Sebastian-Jaimes/EMC_IoT/hardware/3d_models/4. Empaquetado/FormadorDeBolsas/FS/Bagformer.JPG

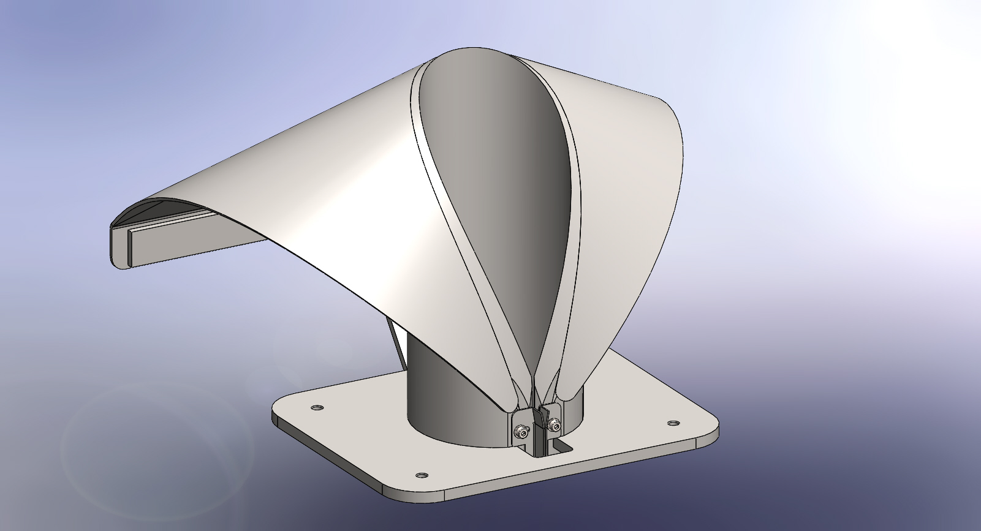
hardware/3d_models/4. Empaquetado/FormadorDeBolsas/FS/Bagformer.JPG
