Sebastian-Jaimes/EMC_IoT/docs/Imágenes/Sellado con calor y faja transportadora.PNG

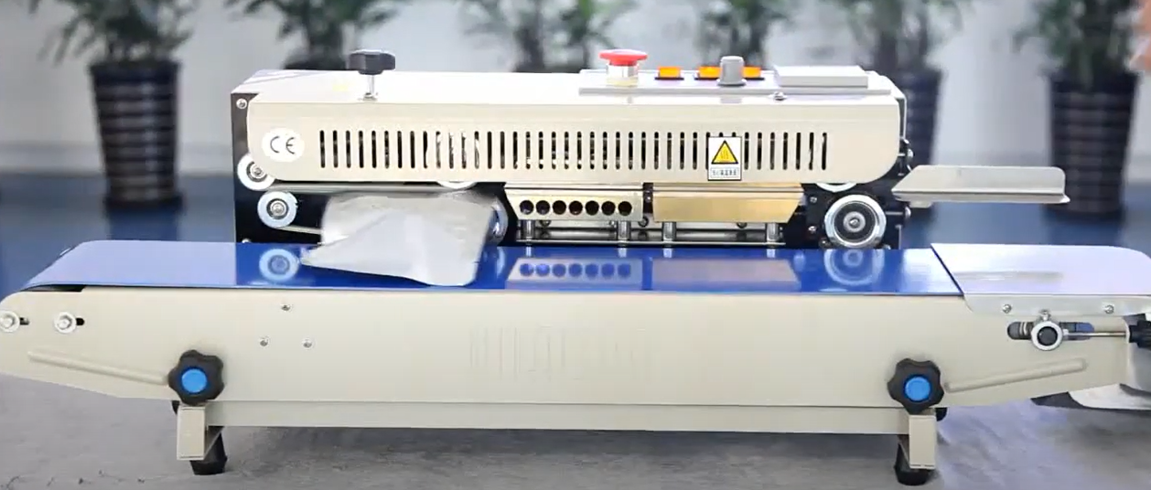
docs/Imágenes/Sellado con calor y faja transportadora.PNG
