Sebastian-Jaimes/EMC_IoT/README.md

# **_EMC_IoT (Empaquetadora de Cafe IoT)_**

## Descripción
**_EMC_IoT_** es un proyecto diseñado para **_Empaquetar granos de café_**. Este repositorio contiene los diseños mecánicos, electrónicos, y el firmware necesario para su construcción y funcionamiento.

## Características
- Caracteristica 1.

## Estructura del proyecto
- **/docs/**: Documentación técnica, manuales y guías.
- **/hardware/**: Modelos 3D y planos mecánicos.
- **/electronics/**: Diseño de PCBs y esquemáticos eléctricos.
- **/firmware/**: Código fuente para microcontroladores (Arduino, ESP32).
- **/software/**: Herramientas adicionales de software.
- **/tests/**: Scripts y archivos para pruebas específicas.

## Requisitos
- Requisito 1.

## Instalación
1. Clonar el repositorio:
    ```bash
    git clone https://github.com/Sebastian-Jaimes/EMC_IoT.git
    ```
2. Acceder a la carpeta del firmware según el componente a desarrollar.
3. Seguir las instrucciones de compilación en el archivo `README.md` de cada subcarpeta.

## Licencia
Este proyecto está licenciado bajo la MIT License - ver el archivo LICENSE para más detalles.

## Contacto
Cualquier consulta sobre el proyecto, puedes contactarme en: sebastian.jaimes.chacon@gmail.com
