Sebastian-Jaimes/EMC_IoT/electronics/README.md

# Electronics

Este directorio contiene los diseños y documentación relacionados con la electrónica para el proyecto **_EMC_IoT_**. Aquí encontrarás esquemas, diagramas de circuito y otros archivos relevantes para la construcción y diseño de la electrónica del proyecto.

## Contenido

- **schematics/**: Esquemas eléctricos del proyecto.
- **pcbs/**: Archivos de diseño de placas de circuito impreso (PCBs).
- **components/**: Lista de componentes y sus especificaciones.
- **docs/**: Documentación adicional sobre el diseño y la implementación de la electrónica.
- **scripts/**: Scripts para la generación de archivos y automatización de tareas relacionadas con la electrónica.
