Sebastian-Jaimes/EMC_IoT/hardware/README.md

# Hardware

## Descripción
En esta carpeta se encuentran los diseños mecánicos del proyecto **_EMC_IoT_**, incluyendo los planos 3D y los ensamblajes.

## Contenido
- **Diseños 3D**: Modelos en formato `.stl` para impresión 3D.
- **Planos**: Dibujos técnicos en formato `.pdf` o `.dwg`.

## Software recomendado
- Para abrir los modelos 3D, usar **Fusion 360** o **FreeCAD**.
- Los archivos STL pueden imprimirse con **Cura** o cualquier software de slicing.
