Sebastian-Jaimes/EMC_IoT/docs/MDM/5. PROYECTO/Metodología del diseño mecatrónico- Grupo/Documento sin título.docx

Eliminación de maleza

Sensor tipo boya

https://naylampmechatronics.com/sensores-liquido/120-sensor-de-nivel-de-liquido-vertical.html

https://articulo.mercadolibre.com.pe/MPE-432848463-sensor-nivel-tipo-boya-interruptor-flotador-medidor-nivel-_JM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

https://articulo.mercadolibre.com.pe/MPE-431528443-sensor-de-nivel-interruptor-flotador-inoxidable-_JM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

Arduino Mega

https://hifisac.com/shop/product/mega-2560r3-arduino-mega-2560-r3-comp-con-arduino-cable-usb-2661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

https://hifisac.com/shop/product/mega2560-pro-arduino-mega-2560-pro-usb-ttl-ch340g-mcu-atmega2560-6772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

https://saisac.pe/producto/arduino-due-con-cable-usb-comp/

Servomotores

https://saisac.pe/producto/servo-motor-s3003-4kg-cm-180-nylon/

https://saisac.pe/producto/servo-motor-mg90s-2-2kg-cm-360-metal/

https://hifisac.com/shop/product/sg-5010-servomotor-sg-5010-5kg-tower-pro-180-grados-standard-2904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

https://hifisac.com/shop/product/sg90-pt-pan-tilt-para-servo-sg90-sin-servomotor-2906?search=servo#attr=

Relé

https://saisac.pe/producto/tpa-3110-2x15w/

https://hifisac.com/shop/product/ssr-75dd-rele-de-estado-solido-75a-de-5-60vdc-4427?search=Rel%C3%A9#attr=

https://hifisac.com/shop/product/ssr-25da-h-rele-de-estado-solido-dc-a-ac-25amperios-480vac-entrada-3-32vdc-4421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

https://hifisac.com/shop/product/rt424024-rele-de-proposito-general-serie-rt2-biestable-sin-enclavamiento-dpdt-24-vdc-8-pines-4408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

https://hifisac.com/shop/product/g2r-2-24vdc-rele-de-24vdc-omron-8pines-doble-contacto-dpdt-4365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

https://hifisac.com/shop/product/g5j-1-tp-rele-de-uso-general-spst-no-normalmente-abierto-bobina-12-vcc-contacto-16a-a-250vac-4367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

https://hifisac.com/shop/product/rt314012-rele-de-12-vdc-bobina-spdt-16a-250vac-8-pines-para-pcb-4406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

https://hifisac.com/shop/product/rt314024-rele-de-24-vdc-bobina-spdt-16a-250vac-8-pines-para-pcb-4407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

https://hifisac.com/shop/product/g2r-1-24vdc-rele-con-bobina-de-24-vdc-10a-250vac-10a-30vdc-omron-5-pin-1-contacto-relay-spdt-4363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

Cámara

https://saisac.pe/producto/modulo-camara-vga-ov7670/

https://saisac.pe/producto/esp-32-camera/

https://naylampmechatronics.com/espressif-esp/700-esp32-cam-con-camara-ov2640-esp32-wifi.html

https://www.gizmojo.com.ar/products/raspberry-pi-camera-module-v1-3

https://hifisac.com/shop/product/rpc-5mp-modulo-camara-5mp-video-1080p-para-raspberry-pi-v1-3-incluye-cable-flat-14cm-2708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

Boquilla pulverizadora

https://www.amazon.com/-/es/Aimela-boquilla-pulverizadora-pulverizador-herramientas/dp/B08S33SZ96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

https://articulo.mercadolibre.com.pe/MPE-443969185-boquilla-de-pulverizacion-4-mm-_JM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

Galonera

https://spanish.alibaba.com/product-detail/40l-80l-120l-plastic-agriculture-pesticides-and-fertilizer-tanks-60451856729.html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

https://articulo.mercadolibre.com.pe/MPE-438991935-galonera-de-plastico-nueva-de-10-galones-40-litros-_JM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

Manguera

Bomba

https://naylampmechatronics.com/motores-dc/260-bomba-de-agua-sumergible-12vdc-3m-240lh.html

https://saisac.pe/producto/bomba-de-agua-12v-rs385/

BOMBA DE AGUA 12V RS385 (https://saisac.pe/producto/bomba-de-agua-12v-rs385/)

https://saisac.pe/producto/minibomba-de-agua-12v/

Bibliografía:

Mungan, C. (2012). “Rolling friction on a wheeled laboratory cart”. Physics Department, US Naval Academy, Annapolis, MD 21402-1363, USA. Recuperado de: https://www.usna.edu/Users/physics/mungan/_files/documents/Publications/PhysEd4.pdf

Partes por completar:

- Variables por controlar → Sebastián y Antony
- Estrategia de control → Sebastián y Antony
- Software Sebastian y Antony
- Selección de controlador → Sebastian y Antony
- Interfaz de usuario → Abigail
- Selección de fuente de energía → Eliane
- Diagrama de Circuitos de potencia → Malena
- Diagramas de circuitos eléctricos y electrónicos para la automatización y control. → Dyango
