Sebastian-Jaimes/EMC_IoT/docs/Tablas/Subsistema de selección - Abigail.docx

### 1.1.1. Subsistema de selección

Este es el primer subsistema que presenta tres alternativas de solución para cada función de los dominios de la estructura de funciones, se toman algunas consideraciones que faciliten el traslado para la etapa de fermentación que se puede observar en las funciones de almacenamiento, así como la relación entre las alternativas de la función de identificación de color y las alternativas de procesar información.

Tabla 10. Matriz morfológica del subsistema de selección.

Fuente: Elaboración propia

| | Función (funciones parciales) | Portadores de funciones (Alternativas de solución)
| | | Alternativa 1 | Alternativa 2 | Alternativa 3

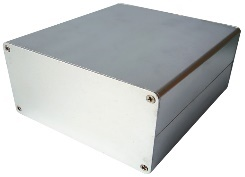
[picture p21: figure]
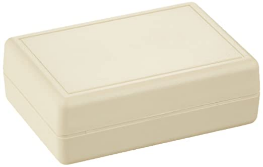
[picture p22: figure]
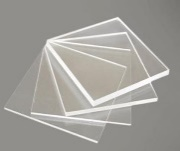
[picture p23: figure]

Dominio mecánico | | Albergar/ soportar/ proteger componentes varios (estructura) | Carcasa metálica | Carcasa de plástico | Carcasa acrílica

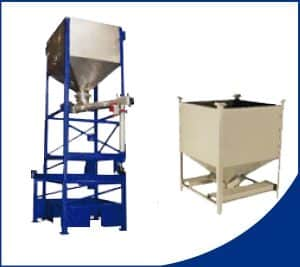
[picture p24: figure]
Tolvas Portátiles y Fijas | EPSA
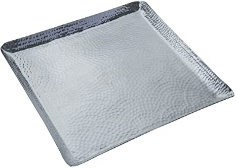
[picture p25: figure]
Amazon.com: Bandeja cuadrada de aluminio martillada de 18.0 x 18.0 x 10.1 in por KINDWER : Hogar y Cocina

| | Almacenar granos de cacao | Tolva | Plataforma transportadora | Bandejas cuadradas

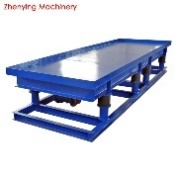
[picture p26: figure]
Mesa Vibradora De Fundición Con Molde De Hormigón De Larga Vida Útil - Buy Fundición De Vibración De Molde De Hormigón De La Mesa De Vibración De Larga Vida De Servicio De
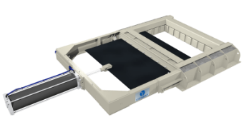
[picture p27: figure]

| | Organizar granos de cacao | Paletas | Bandeja o mesa vibratoria | Tajadera de dosificación

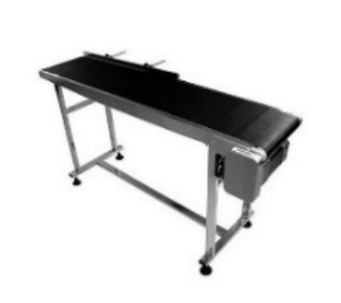
[picture p28: figure]
Fajas Transportadoras | Bandas Transportadoras Perú
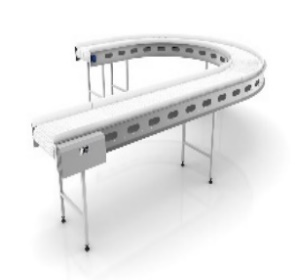
[picture p29: figure]
Abreu - Cinta transportadora - CT-0400
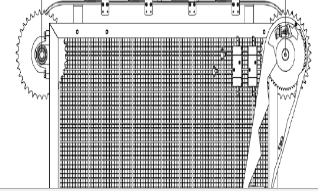
[picture p30: figure]

| | Transportar granos a zona de captura de parámetros | Faja transportadora | Cinta transportadora | Tren de engranajes
| | Transportar granos a zona de selección
| | Transportar granos de cacao a zona de almacenamiento

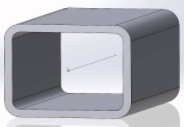
[picture p31: figure]
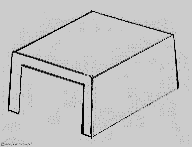
[picture p32: figure]

| | Almacenar granos para captura de parámetros | Cámara de selección | Estructura de plástico en C | Estructura metálica en C

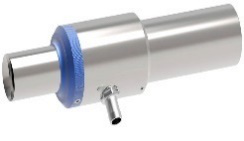
[picture p33: figure]
Eyector de aire - 300 - PIAB - multietapa / compacto / de acero inoxidable

| | Seleccionar granos de cacao | Paletas | Aire a presión (eyector)

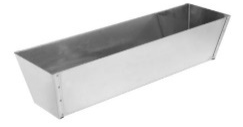
[picture p34: figure]
Recipiente de Acero Inoxidable - Goldblatt
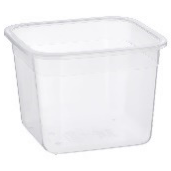
[picture p35: figure]
IKEA 365+ Recipiente, cuadrado/plástico, 1.4 l - IKEA
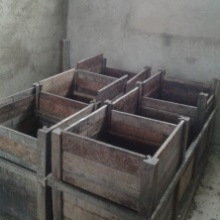
[picture p36: figure]
Cajones de Fermentación para Cacao. | Cocoa chocolate, Cacao, Cocoa

| | Almacenar granos en recipiente | Recipiente de acero | Recipiente de plástico | Cajones de madera

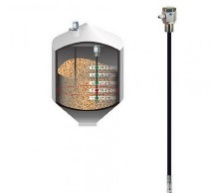
[picture p37: figure]
Sensor de Temperatura multipunto para silos de almacenamiento
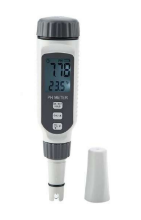
[picture p38: figure]
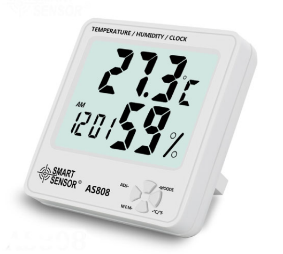
[picture p39: figure]

Dominio de sensores | | Sensar temperatura | Sensor de temperatura resistivo | Sensor inteligente de T ° y H con comunicación automática de información de datos | Sensor de temperatura y humedad digital que trabaja con batería

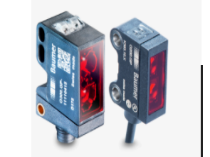
[picture p40: figure]
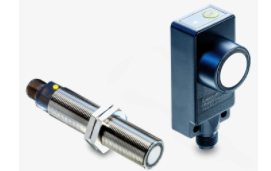
[picture p41: figure]
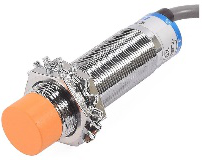
[picture p42: figure]
Sensor de proximidad capacitivo LJC18A3-H-Z/BX (NPN)

| | Detectar granos de cacao | Sensor difuso fotoeléctrico | Sensor ultrasónico | Sensor capacitivo

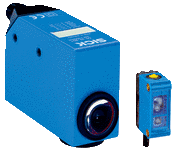
[picture p43: figure]
Sensores de color
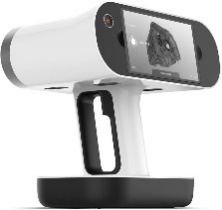
[picture p44: figure]
Escáner 3D inalámbrico | Artec Leo | Las mejores soluciones de escaneo 3D

| | Capturar imágenes de los granos de cacao | Sensor de color | Cámara digital | Escáner de objetos

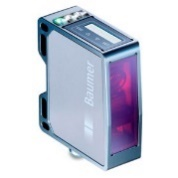
[picture p45: figure]
Sensor de distancia de precisión - Todos los fabricantes industriales - Vídeos

| | Sensar la capacidad del recipiente | Sensor capacitivo | Celda de carga | Sensor de distancia

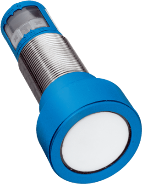
[picture p46: figure]
Sensores Industriales - Sensores de Ultrasonido | Everest Ingeniería

| | Medir flujo de cacao | Sensor infrarrojo réflex | Celda de carga | Sensor de ultrasonido

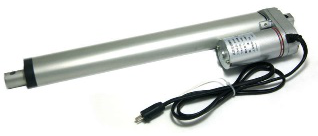
[picture p47: figure]
Actuador Lineal 24VDC 250mm 900N
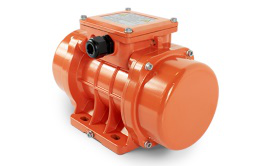
[picture p48: figure]
Gama estándar MVE | OLI Vibrators

Dominio de actuadores | | Accionar organización de granos de cacao | Servomotor | Actuador lineal | Motor vibrador

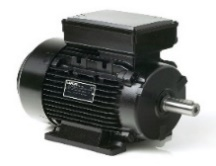
[picture p49: figure]
Motor AC - AMD / AMDE series - Lafert - monofásico / 110 V / con condensador permanente y de arranque
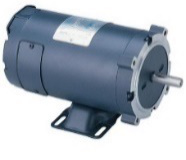
[picture p50: figure]
Motor DC de Corriente Directa, SolarMachine - Todo en Ventilación SA de CV

| | Accionar mecanismo de transporte a zona de captura | Motor AC | Motor DC | Servomotor
| | Accionar mecanismo de transporte a zona de selección | Motor AC | Motor DC | Servomotor

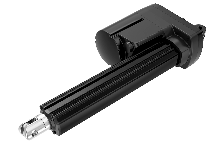
[picture p51: figure]
Qué es un actuador lineal eléctrico y cómo elegirlo? - TiMOTION
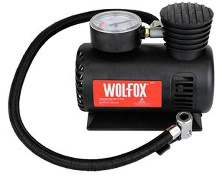
[picture p52: figure]
wolfox mini compresor aire p/autos 300psi silenciosa wf1011

| | Accionar mecanismo de clasificación | Actuador lineal eléctrico | Servomotor | Compresor de aire + electroválvula
| | Accionar mecanismo de transporte a zona de almacenamiento | Motor AC | Motor DC | Servomotor
Dominio de energía | | Acondicionar energía | Fuente lineal | Fuente conmutada

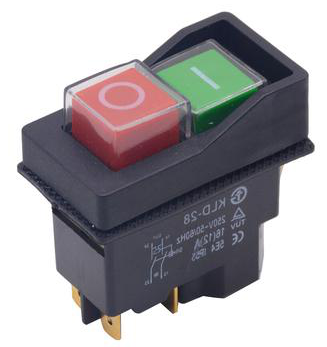
[picture p53: figure]
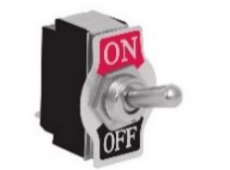
[picture p54: figure]
Interruptor de Palanca 2 Tornillos VOLTECK

| | Encendido del sistema | Botón switch | Interruptor de palanca
| | Energizar actuadores | Fuente lineal | Fuente conmutada

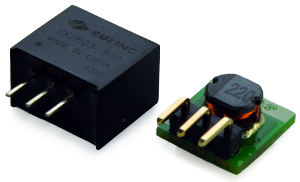
[picture p55: figure]

| | Energizar sensores | Regulador de conmutación | Regulador integrado lineal
| | Energizar controlador | Fuente lineal | Fuente conmutada
| | Energizar interfaz | Fuente lineal | Fuente conmutada

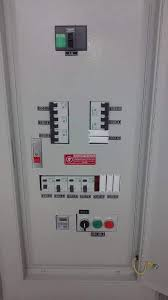
[picture p56: figure]
Tablero para tienda... - Tableros Eléctricos Padilla | Facebook
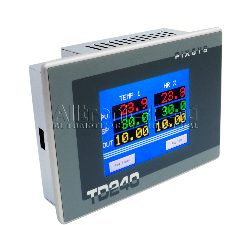
[picture p57: figure]
Panel HMI TD240 - ALLTRONICS PERU

Dominio de interfaz | | Mostrar Alerta de Fallo de Sistema | Tablero eléctrico con botones e indicadores visuales | | Panel HMI
| | Mostrar Indicador de Temperatura
| | Mostrar Indicador de recipiente lleno
| | Ingresar Parámetros

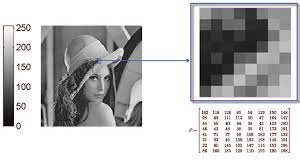
[picture p58: figure]
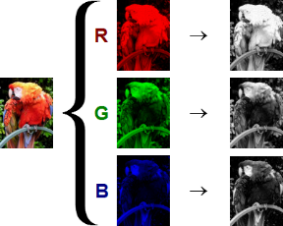
[picture p59: figure]
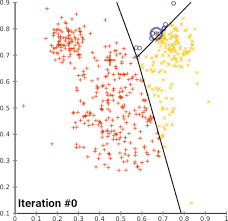
[picture p60: figure]

Dominio de control | | Identificar color | Segmentación | Regresión lineal | | K-means

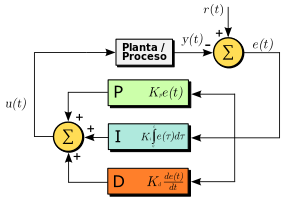
[picture p61: figure]
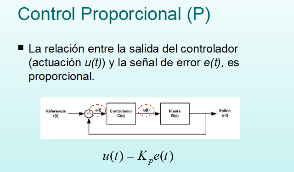
[picture p62: figure]
Control PID y su aplicación en la automatización - Monografias.com

| | Control de velocidad | Control PID | | Control proporcional

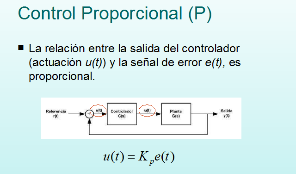
[picture p63: figure]
Control PID y su aplicación en la automatización - Monografias.com

| | Identificar si el recipiente está lleno | Control proporcional

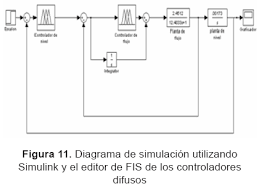
[picture p64: figure]

| | Control de actuador de clasificación | Control difuso | | Control PID

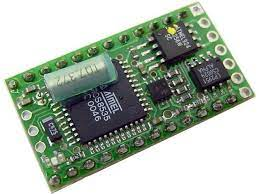
[picture p65: figure]
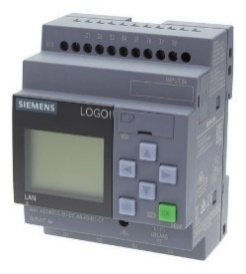
[picture p66: figure]
Plc Siemens Logo 8! Ethernet 12/24rce - Programacion De Plc | Mercado Libre

| | Procesar información | Microcontrolador | | PLC

### 1.1.2. Subsistema de secado

Este es el segundo subsistema que presenta tres alternativas de solución para cada función de los dominios de la estructura de funciones, el principal objetivo es que el secado sea uniforme y rápido por eso se presentan diversas alternativas en la función de almacenar granos en la zona de secado, así como evaluar si estas requieren accionar un movimiento giratorio.

Tabla 11. Matriz morfológica del subsistema de secado.

Fuente: Elaboración propia

| | Función (funciones parciales) | Portadores de funciones (Alternativas de solución)
| | | Alternativa 1 | Alternativa 2 | Alternativa 3
Dominio mecánico | | Albergar/ soportar/ proteger componentes varios (estructura) | Carcasa metálica | Carcasa de plástico | Carcasa acrílica

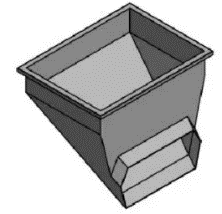
[picture p67: figure]
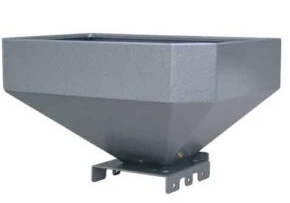
[picture p68: figure]
TOLVA PARA MOLINO DE MALTA AUTOMÁTICO "MICRO" | Cerveza Artesana
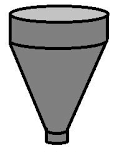
[picture p69: figure]

| | Almacenar/recibir granos de cacao | Tolvas | Contenedor horizontal | Contenedor circular

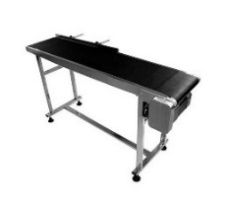
[picture p70: figure]
Fajas Transportadoras | Bandas Transportadoras Perú
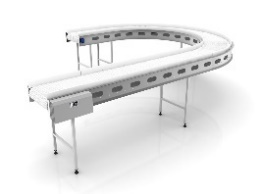
[picture p71: figure]
Abreu - Cinta transportadora - CT-0400
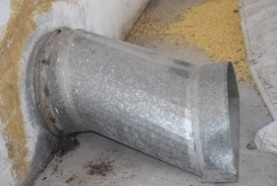
[picture p72: figure]
sistemas de aireacion, conchas de aireacion, ductos de aireacion, secado de granos

| | Transportar granos a zona de secado | Faja transportadora | Cinta transportadora | Tubería o ductos

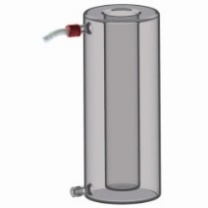
[picture p73: figure]
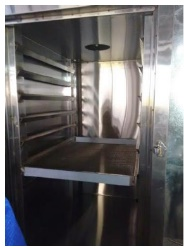
[picture p74: figure]
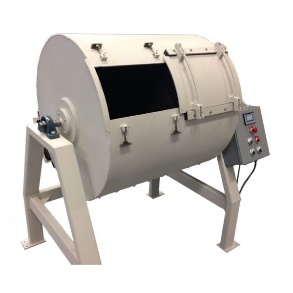
[picture p75: figure]
Tambores giratorios para coque

| | Almacenar granos en zona de secado | Cilindro termostático | Cámara de secado | Tambor rotatorio

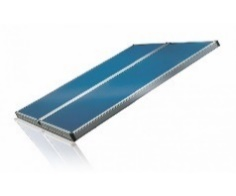
[picture p76: figure]
Captador Solar Chromagen QR-D PRO - Merkasol Energías Renovables
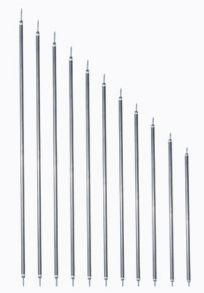
[picture p77: figure]

| | Transmitir calor | Intercambiador de calor y colector solar | Resistencias eléctricas | Quemador GLP

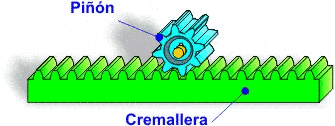
[picture p78: figure]
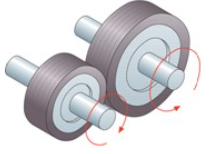
[picture p79: figure]

| | Transmitir movimiento giratorio | Piñón -cremallera | Ruedas de fricción | No trabaja con movimiento giratorio

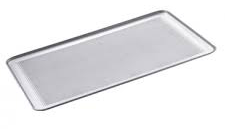
[picture p80: figure]

| | Recibir granos de cacao en la zona de secado | Bandeja plana | Plataforma

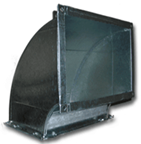
[picture p81: figure]

| | Transportar granos de cacao a zona de dispensa | Faja transportadora | Cinta transportadora | Tubería o ductos

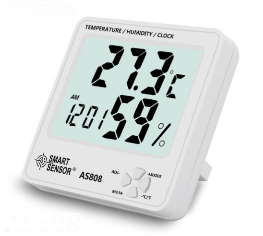
[picture p82: figure]

Dominio de sensores | | Sensar temperatura | Sensor de temperatura resistivo | Sensor inteligente de T ° y H con comunicación automática de información de datos | Sensor de temperatura y humedad digital que trabaja con batería

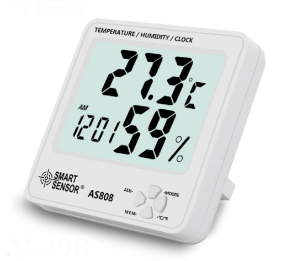
[picture p83: figure]
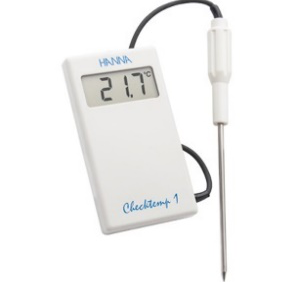
[picture p84: figure]
HANNA Instruments - HI98509 CHECKTEMP 1 Termómetro digital con sonda de acero inoxidable

| | Sensar humedad | Sensor inteligente de T ° y H con comunicación automática de información de datos | Sensor de temperatura y humedad digital que trabaja con batería | Sonda digital
| | Sensar velocidad de giro | Sensor inductivo | Tacómetro láser | | No trabaja con movimiento giratorio
| | Medir flujo de cacao | Sensor infrarrojo réflex | Celda de carga | Sensor de ultrasonido

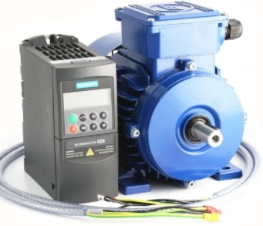
[picture p85: figure]
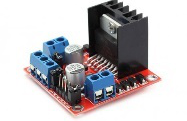
[picture p86: figure]
Driver para Motor DC de Alta Potencia [L298N]
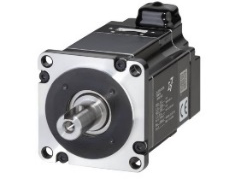
[picture p87: figure]

Dominio de actuadores | | Accionar mecanismo de transporte de cacao | Variador + motor AC | Driver + Motor DC | Servomotor

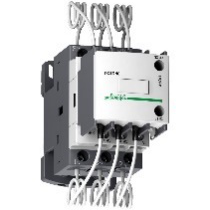
[picture p88: figure]
LC1DFKM7 - Schneider - TeSys – FCM Solutions E.I.R.L. (RUC : 20602949690)
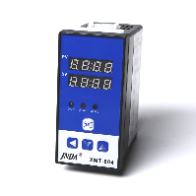
[picture p89: figure]
Xmt-604 Controlador De Temperatura Inteligente,Admite Termopar Y Resistencia Térmica - Buy Los Controladores Digitales De Temperatura,Diferencial De Temperatura Controlador,Tipo K Controlador De Temperatura Product on Alibaba.com

| | Accionar mecanismo de transmisión de calor | contactor + resistencia térmica | Controlador de resistencia térmica
| | Accionar mecanismo de rotación | Variador + motor AC | Driver + Motor DC | No trabaja con movimiento giratorio
| | Accionar mecanismo de transporte a zona de dispensa | Variador + motor AC | Driver + Motor DC | Servomotor

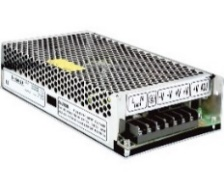
[picture p90: figure]
ELECTRÓNICA MOLGAR

Dominio de energía | | Acondicionar energía | Fuente lineal | Fuente conmutada

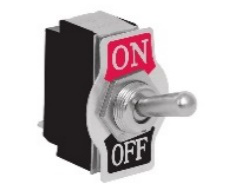
[picture p91: figure]
Interruptor de Palanca 2 Tornillos VOLTECK

| | Encendido del sistema | Botón switch | Interruptor de palanca

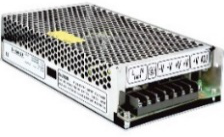
[picture p92: figure]
ELECTRÓNICA MOLGAR

| | Energizar actuadores | Fuente lineal | Fuente conmutada

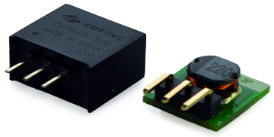
[picture p93: figure]

| | Energizar sensores | Regulador de conmutación | Regulador integrado lineal

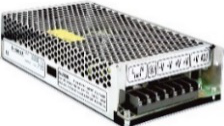
[picture p94: figure]
ELECTRÓNICA MOLGAR

| | Energizar controlador | Fuente lineal | Fuente conmutada

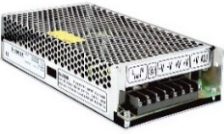
[picture p95: figure]
ELECTRÓNICA MOLGAR

| | Energizar interfaz | Fuente lineal | Fuente conmutada

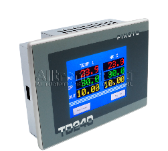
[picture p96: figure]
Panel HMI TD240 - ALLTRONICS PERU

Dominio de interfaz | | Mostrar Alerta de Fallo de Sistema | Tablero eléctrico con botones e indicadores visuales | | Panel HMI
| | Mostrar Indicador de Temperatura
| | Mostrar Indicador de Humedad
| | Ingresar Parámetros
Dominio de control | | Procesar información | Microcontrolador | | PLC
| | Control de humedad | PID | | Difuso
| | Controlar la velocidad de giro
| | Controlar el tiempo para cada variedad
| | Controlar el proceso de secado
