Sebastian-Jaimes/EMC_IoT/docs/Bibliografia/pdfcookie.com_2-calculo-del-tornillo-sin-findocx.pdf

2.- CALCULO PARA DETERMINAR LA CARACTERISTICAS DEL TORNILLO SIN FIN

Ø Paso del tornillo sin fin
El paso del tornillo es t = (0,5-1,0) D, donde D
es el diámetro del tornillo.
Cuanto más ligero sea el material a transportar, tanto mayor se toma el paso.
Consideramos 0.75 D = 0.0381 (paso del tornillo)

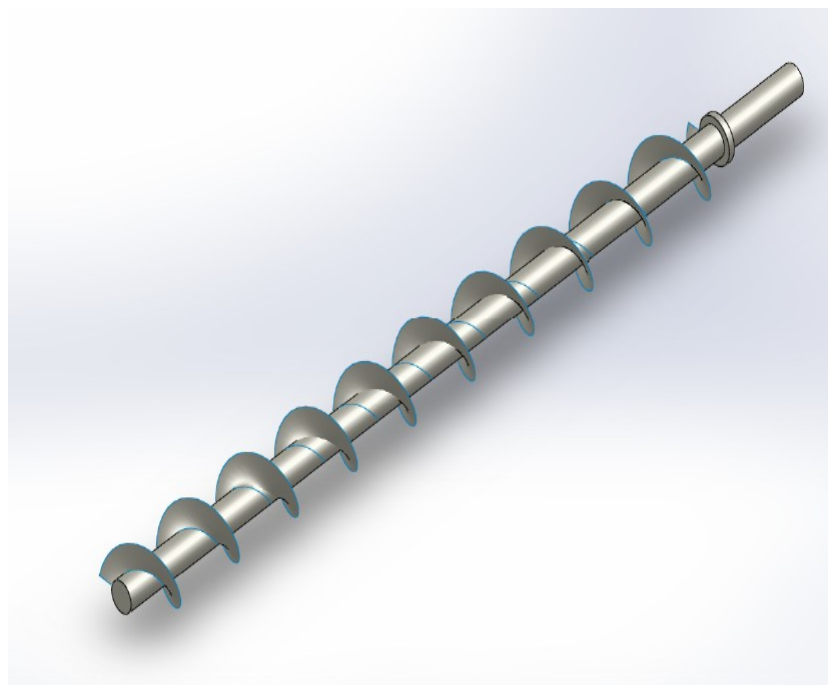
[picture p143: figure]

Ø Diámetro del tornillo sin fin
El diámetro del tornillo D depende
del tamaño de los pedazos de la carga a desplazar. Este diámetro debe ser corno mínimo 12 veces mayor que el tamaño de los pedazos a transportar
del material homogéneo por su grosor
y 4 veces mayor que el grosor máximo de los trozos, al transportar material no clasificado (ordinario).
D = 12* d mm = 72 mm
Donde:
d= es el diámetro del pellet a transportar
d = 6 mm
Ø Calculo de la velocidad del tornillo sin fin

El caudal necesario para el funcionamiento de un caldero 60.05 kg/h, lo que supone, de 0.06005 m

3
/h.
El caudal de transporte se determina mediante la siguiente expresión:

Donde:

φ = coeficiente de llenado. Se considera un valor del coeficiente de llenado de 0,45 propio de materiales que fluyen fácilmente.

Se estima para S un valor igual a 0,75D.

S= 0.75 (0.0635 m) = 0.0476 m

Diámetro del tubo de alimentación = 0.0635 m

Despejando de la ecuación calculamos la velocidad del tornillo sin fin

N = 4 Iv = 4 (0.06005 m3
/h) / 60*0.45*π*(0.0635 m)² *0.0476 m = 14.754 rpm = 15 rpm
60 φ π D² | S

Ø Calculo de la potencia necesario para transportar el pellet

Por otro lado, la potencia necesaria por el transportador el peller se calcula mediante la siguiente expresión:

Donde:

PH = potencia necesaria para el desplazamiento del material. PN = potencia para el accionamiento del tornillo en vacío.
PSt = potencia requerida por la inclinación.

La capacidad de un transportador de tornillo sin-fin está expresada por la fórmula:

IM =67200 kg/m³

* 0.06005 m3
/h = 4035.36 kg / h
Ø Calculo de la potencia necesaria para el dezplazamiento del pellet Datos:
L= 0.6 m
λ=1,9
g = 9.81 m/s

Se elige para la resistencia al desplazamiento de la aceituna un valor de λ=1,9 asimilándola en la tabla a graneles como avena, cebada, arcilla, maíz o patatas.

PH = 4035.36 kg / h * 0.6 m * 1.9 * 9.81 m/s = 0.0125 kw
3600

Ø Calculo de potencia para el accionamiento del tornillo en vacío.

PN = 0.0635 m *0.6 m / 20 = 0.0019 kw

Calculo de PSt = potencia requerida por la inclinación.

La potencia requerida por la inclinación, en kilowatios, es el producto de la capacidad por la altura a salvar y por la aceleración de la gravedad.

Donde:

H = 0.15 m

PST = 4035.36 kg / h * 0.15 * 9.81 / 3600 = 0.00165 kw

Ø La potencia total requerida por el sistema es:

Ptotal = PH + PN + PST = 0.0125 kw + 0.0019 kw + 0.00165 kw = 0.01605 kw = 16.0.5 watts

La potencia requerida para el tornillo sin fin es de 16 watts

Por lo que el motor que se utilizara debera tener una potencia de 16 watt

El Villano Ft Keke Te Pintaron Pajaritos Tema Nuevo 2013 El Villano Ft Keke Te Pintaron Pajaritos Tema Nuevo 2013 DESCARGALO en http://www.CUMBIADEHOY.com/el-villano... (http://www.youtube.com/redirect)
Facebook: https://www.facebook.com/CumbiaDeHoy
Twitter: https://twitter.com/CumbiaDeHoy
