Sebastian-Jaimes/EMC_IoT/docs/MDM/5. PROYECTO/Metodología del diseño mecatrónico- Grupo/Tablas/Dominio de comunicación.xlsx

 |  | Dominio de Control
 |  | S1 | S2 | S3 | S4 | S5 | S6
Dominio de comunicación | Enviar Información | Bluetooth | Wifi | RFID | ZigBee | WiMAX | UWB (Ultra Wide Band)
 | Recibir Información | Cable coaxial |  | Cable de pares |  | Cable de fibra óptica
