Sebastian-Jaimes/EMC_IoT/docs/MDM/5. PROYECTO/Metodología del diseño mecatrónico- Grupo/Tablas/Lista de exigencias.xlsx

Lista de Requerimientos |  |  | Versión 3
Proyecto: | Sistema Automático para el Control de Malezas en el Cultivo de Espárragos |  | Fecha: 21/04/2021
 |  |  | Revisado por:
Cliente: | Pontificia Universidad Católica del Perú |  | Elaborado por: Grupo 4
Fecha (Cambios) | Deseo o Exigencia | Descripción | Responsable
Función Principal
2021-04-21 | E | El sistema debe ser capaz de detectar malezas en cultivos de espárrago con una precisión mayor al 80%. | Sebastian
2021-04-21 | E | El sistema debe aplicar herbicida directamente a toda maleza detectada. | Sebastian
Geometría
2021-04-21 | D | Los rociadores deben ubicarse a una altura exacta por encima de las ruedas. | Sebastian
2021-04-21 | D | El sistema debe contar con ruedas con separación ajustable a la distancia entre filas del arado, las cual varía entre 1 y 1.5 metros. | Sebastian
2021-04-21 | E | El sistema debe tener unas medidas generales de máximo 1.50 m de ancho, 1.60m de altura y 1.60m de largo. (altura del cultivo :[0.4 0.6]m) | Sebastian
Cinemática y fuerzas
2021-04-21 | E | El sistema debe tener una velocidad lineal máxima de alrededor de 0.5 m/s | Sebastian
2021-04-21 | E | El sistema debe ser capaz de soportar la fuerza ejercida debido al peso de la misma, el cual debe ser como mínimo 150 kg y como máximo 300 kg. | Sebastian
Modo de operación
2021-04-21 | E | Aplicación de pesticida de forma automática cuando se detecten plantas de maleza. | Eliane
2021-04-21 | E | Monitoreo de funciones de pulverización y navegación de forma remota por un operador. | Eliane
2021-04-21 | E | Navegación autónoma a través de las hileras de cultivo. | Eliane
Condiciones de operación
2021-04-21 | E | El sistema debe ser capaz de moverse por terreno arenoso (90% arena y 10% otro) para un buen drenaje sin dificultad. | Antony
2021-04-21 | E | El sistema no debe verse afectado por trabajos a temperaturas entre 15° y 31° | Antony
2021-04-21 | E | La altura de trabajo es de 0 msnm. | Antony
Fabricación
2021-04-21 | E | Material: - Como características para la carcasa del diseño, debe tener resistencia a la corrosión y resistencia a las temperaturas extremas y una elevada maquinabilidad. - Como características para el chasis deben ser ligeros, resistentes y de fácil adaptación. - Para el eje de transmisión debe ser un material con alta resistencia para soportar altas potencias. | Abigail
2021-04-21 | D | Las piezas mecánicas necesarias para la implementación deberán ser adquiridas a través del mercado local para evitar costos de importación. | Abigail
Transporte
2021-04-21 | D | Se requerirá de un carro para su transporte antes o después de la operación. | Abigail
Mantenimiento y limpieza
2021-04-21 | D | El mantenimiento preventivo se debe realizar cada 10,000 horas de trabajo. | Antony
2021-04-21 | D | El diseño del robot debe evitar que se acumule suciedad en lugares de difícil acceso. | Antony
Costos y plazos
2021-04-21 | E | Costo de diseño: 4,000 - 6,000 nuevos soles | Antony
2021-04-21 | E | Costo de implementación: 1,000 - 2,000 nuevos soles | Antony
2021-04-21 | E | Costo del equipo: 5,000 - 8,000 nuevos soles | Antony
2021-04-21 |  | Entrega final: 7 de Julio de 2021 | Todos
Comunicaciones
2021-04-21 | D | Protocolos de comunicación entre controlador, actuadores y sensores robustos. | Malena
2021-04-21 | E | Comunicación entre el equipo y el usuario: rango de alrededor de 100 metros. Se enviarán alertas si la máquina terminó de recorrer la parcela o si el camino fue bloqueado por algún obstáculo, cuánta batería le queda y el nivel de pesticida. | Malena
Seguridad
2021-04-21 | E | La máquina estará diseñada para que el riesgo sea mínimo pues esta podrá funcionar autónomamente. | Malena
2021-04-21 | E | La máquina contará con una parada de emergencia en caso de algún riesgo y habrá un aislamiento eléctrico. | Malena
2021-04-21 | D | Se brindará un manual de usuario con el método de uso documentado y explicado de forma entendible. | Malena
Ergonomía
2021-04-21 | E | Se debe cumplir con la Norma Básica de Ergonomía y de Procedimiento de Evaluación de Riesgo Disergonómico (2008). | Malena
2021-04-21 | D | El vehículo deberá ser estético para su comercialización. | Malena
Control
2021-04-21 | E | La máquina debe ser capaz de procesar las señales de entrada de los sensores y enviar señales de salida a los actuadores de forma precisa para poder aplicar el herbicida sin dañar las hortalizas aledañas. | Dyango
2021-04-21 | D | La máquina debe poseer un sistema de control de tipo realimentado. | Dyango
2021-04-21 |  | Variables de control: - Velocidad y posición del vehículo - Flujo del pesticida | Dyango
Energía
2021-04-21 | D | Fuente de alimentación: panel solar y/o baterías de 24V recargables. | Eliane
2021-04-21 | D | Autonomía de 8 h | Eliane
Hardware
2021-04-21 | E | La máquina requiere por lo menos una cámara que registre el entorno en el que se encuentra. | Eliane
2021-04-21 | D | Motor eléctrico. | Eliane
2021-04-21 | E | La máquina requiere un controlador para el procesamiento de señales análogas y digitales. | Eliane
2021-04-21 | E | Sistema integrado de válvulas y boquillas para pulverizacion de precisión. | Eliane
2021-04-21 | E | Sensores LIDAR y ultrasonido para la identificación de entorno. | Eliane
2021-04-21 | E | Sensores de humedad y de nivel. | Eliane
Software
2021-04-21 | E | Implementación del algoritmo para procesamiento de imágenes en tiempo real que se encargue de activar el sistema de rociado únicamente cuando haya maleza, de forma que se evite dañar el cultivo de espárragos. | Dyango
2021-04-21 | E | Interfaz humano - máquina para ingreso de comandos de operación. | Dyango
