Sebastian-Jaimes/EMC_IoT/docs/MDM/5. PROYECTO/Metodología del diseño mecatrónico- Grupo/Tablas/Matriz morfológica.xlsx

Sheet: Dominio mecánico
Dominio Mecánico
Funciones | S1 | S2 | S3 | S4 | S5 | S6
Soportar componentes (chasis) | Estructura metálica (aluminio) |  | Acero |  | Fibra de vidrio
Almacenar granos de café tostado
Transportar granos de café tostado
Separar cada 250 g
Llenar recipiente de bolsas
Cortar y sellar bolsas
Colocar la válvula desgasificadora
Transmitir movimiento | Fajas | Tren de engranajes | Engranaje planetario |  | Cadenas
Desplazamiento del vehículo | Ruedas |  | Oruga |  | Extremidades zoomórficas
Disipar las vibraciones | Amortiguadores | Rocker bogie | Sistema de suspensión |  | Suspensión rígida
Almacenar pesticida | Galonera de plástico |  | Tanque de plástico |  | Tanque metálico
Transportar pesticida | Tubo de plástico |  |  | Manguera de plástico
Rociar Pesticida | Rociadores |  |  | Aspersores
Dirigir vehículo | Sistema Ackerman |  | Explicit Steering Configuration | Skid Steering Configuration | Movimiento de extremidades

Sheet: Dominio de actuadores
Dominio de actuadores
Funciones | S1 | S2 | S3
Accionar mecanismo de movimiento | Motor DC |  | Consola Android
Accionar mecanismo de llenado
Accionar mecanismo de sellado
Accionar mecanismo de colocado de válvula
Accionar indicador de fin de recorrido | Led | Tablet
Accionar mecanismo de roceado | Relay y electroválvula | Bomba

Sheet: Dominio de sensores
Dominio de sensores
Funciones | S1 | S2 | S3 | S4 | S5 | S6
Detectar la separación de 250 g
Detectar nuevo producto terminado
Detectar obstáculos | Sensores de ultrasonido | Sensores infrarrojos | Lidar 3D | Cámara de profundidad | Sensor capacitivo
Detectar maleza y cultivo | Cámara web | Cámara infrarroja | Ultrasonido | Radar
Detectar ubicación | GPS | IMU | Acelerómetro y giroscopio | Wi-Fi | Sensor de brújula
Detectar nivel del tanque de pesticida | Ultrasonido | Nivel hidrostático | Sensor capacitivo | Boya | Radar | Vibración
Detectar la velocidad del robot | Encoder | Acelerómetro | Tacómetro | Sensor de imán permanente | Sensor de guaya

Sheet: Dominio de energía
Dominio de energía
Funciones | S1 | S2 | S3 | S4 | S5 | S6
Acondicionar energía | Fuente lineal |  |  | Fuente switching
Encender el sistema | Interruptor simple |  |  | Botón de arranque
Energizar actuadores | Reguladores de conmutación
Energizar sensores | Regulador integrado lineal |  |  | Regulador de conmutación
Energizar interfaz | Regulador de conmutación |  |  | Regulador integrado lineal
Energizar controlador | Regulador de conmutación

Sheet: Dominio de control
Dominio de Control
Funciones |  | S1 | S2 | S3 | S4 | S5 | S6
 | Verificar que los pesos sean de 250 g
 | Controlar el Llenado
 | Controlar el Sellado
 | Determinar colocación de la válvula
 | Controlar el Conteo en tiempo real
Hardware | Identificación de malezas, espárrago y surcos | Raspberry Pi | Nano Pc T3 Plus | Nvidia Jetson Xavier | Asus thinker Board S | Odriod- XU4 | Banana Pi M3
 | Control de Posición | Microcontrolador |  | FPGA |  | Procesadores
 | Control de Roceado
Software | Identificación de malezas, espárrago y surcos | Procesamiento de Imágenes |  | Visión por Computadora |  | Redes Neuronales Convolucionales
 | Control de Posición | Control PID Lineal | Control PID No lineal | Algoritmo Regulador | Deep Learning | Control Vectorial | Lógica Difuso
 | Control de Roceado

Sheet: Dominio de comunicación
Dominio de comunicación
Funciones | S1 | S2 | S3 | S4 | S5 | S6
Enviar Información | Bluetooth | Wifi | RFID | ZigBee | WiMAX | UWB (Ultra Wide Band)
Recibir Información | Cable coaxial |  | Cable de pares |  | Cable de fibra óptica

Sheet: Dominio de interfaz
Dominio de interfaz
Funciones | S1 | S2 | S3 | S4 | S5 | S6
Mostrar Alerta de Fallo de Sistema | Aplicación de celular |  | Aplicación para PC |  | Aplicación en tablet
Mostrar Cantidad de Paquetes Listos por Día
Mostrar Cantidad de Paquetes Listos en el Día Actual en Tiempo Real
Mostrar Posición del Vehículo en el Plano | Aplicación de celular |  | Aplicación para PC |  | Aplicación en tablet
Mostrar Indicador de Obstáculo | Aplicación de celular |  | Aplicación para PC |  | Aplicación en tablet
Mostrar Estado de Nivel de Batería | Aplicación de celular |  | Aplicación para PC |  | Aplicación en tablet
Mostrar Nivel de Pesticida | Aplicación de celular |  | Aplicación para PC |  | Aplicación en tablet
