Sebastian-Jaimes/EMC_IoT/docs/README.md

# Docs

Este directorio contiene la documentación relacionada con el proyecto **_EMC_IoT_**. Aquí encontrarás guías, especificaciones, y otros documentos importantes que te ayudarán a entender y trabajar con el proyecto.

## Contenido

- **user_manual/**: Manuales de usuario y guías de instalación.
- **technical_docs/**: Documentación técnica sobre el diseño y funcionamiento del sistema.
- **api_docs/**: Documentación de las APIs utilizadas en el proyecto.
- **design_docs/**: Documentación sobre el diseño del sistema, incluyendo diagramas y explicaciones detalladas.
- **troubleshooting/**: Guías para resolver problemas comunes y FAQ.

## Acceso a la Documentación

1. **Manual de Usuario:**

   Encuentra guías y manuales para el uso del sistema en la carpeta `user_manual/`.

2. **Documentación Técnica:**

   Consulta los detalles técnicos y las especificaciones del sistema en la carpeta `technical_docs/`.

3. **Documentación de API:**

   Revisa la documentación de las APIs y cómo interactuar con ellas en la carpeta `api_docs/`.

4. **Documentación de Diseño:**

   Explora los documentos de diseño y diagramas en la carpeta `design_docs/`.

5. **Resolución de Problemas:**

   Encuentra soluciones a problemas comunes y respuestas a preguntas frecuentes en la carpeta `troubleshooting/`.

## Estructura de los Documentos

- **user_manual/**: Archivos con guías de usuario en formato PDF, DOCX o Markdown.
- **technical_docs/**: Documentos técnicos como especificaciones, notas de aplicación y análisis de diseño.
- **api_docs/**: Documentación de las APIs, generalmente en formato Markdown o HTML.
- **design_docs/**: Documentos de diseño, incluyendo diagramas y descripciones detalladas.
- **troubleshooting/**: Documentos con soluciones a problemas comunes y FAQ.
