Sebastian-Jaimes/EMC_IoT/firmware/README.md

# Firmware

Este directorio contiene el firmware para el proyecto **_EMC_IoT_**. El firmware se encarga de controlar y gestionar el funcionamiento del proyecto.

## Contenido

- **src/**: Código fuente del firmware.
- **include/**: Archivos de encabezado.
- **lib/**: Bibliotecas externas utilizadas en el proyecto.
- **docs/**: Documentación adicional sobre el firmware.
- **examples/**: Ejemplos de uso y configuración.
- **Makefile**: Archivo de configuración para la compilación del firmware.
