Sebastian-Jaimes/EMC_IoT/software/README.md

# Software

Este directorio contiene el software necesario para el proyecto **_EMC_IoT_**. Aquí encontrarás el código y las herramientas para interactuar y controlar el proyecto desde un entorno de software.

## Contenido

- **src/**: Código fuente del software.
- **scripts/**: Scripts y utilidades auxiliares.
- **docs/**: Documentación adicional sobre el software.
- **examples/**: Ejemplos y configuraciones de uso.
