Sebastian-Jaimes/EMC_IoT/docs/MDM/5. PROYECTO/Metodología del diseño mecatrónico- Grupo/Sistema automatizado para rehabilitación de rodilla en adultos.docx

Solución:

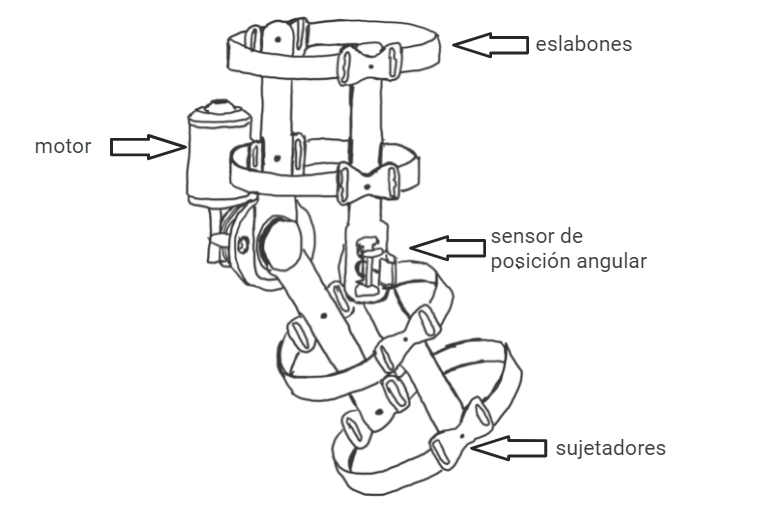
[picture p144: figure]
