Sebastian-Jaimes/EMC_IoT/docs/Bibliografia/Citado- Bibliografía . lleno.docx

Página Web:

Autor, A. (Fecha). Título. https://www.páginaweb.com/XXX

Revista:

Autor, A., Autor, B., & Autor, C. (Año). Título del artículo. Título de la Revista, volumen(número), páginas del artículo. http://www.ejemplo.abc

8(2), 34-48.

Periódico en línea:

Autor, A. (Fecha). Título del artículo. Título del periódico. http://www.ejemplo.abc

Tesis o trabajos de investigación

Autor, A. (Año). Título de la tesis [Tipo de tesis para optar un grado o título inédita]. Nombre de la institución que otorga el título.

LINK PARA CITADO: https://up-pe.libguides.com/c.php?g=1043492&p=7613287

Perfect Daily Grind (29 de julio de 2021). Caficultor: Cómo elegir el empaque para vender tu café tostado. Perfect Daily Grind. https://perfectdailygrind.com/es/2021/07/29/caficultor-como-elegir-el-empaque-para-vender-tu-cafe-tostado/

MIDAGRI. (s/f). Cafés especiales en el Perú. https://www.midagri.gob.pe/portal/24-sector-agrario/cafe/204-cafesespeciales-en-el-peru

Cámara Peruana del Café y Cacao (s/f). Café en el Perú. https://camcafeperu.com.pe/ES/cafe-peru.php

Weather Spark (2016). El clima y el tiempo promedio en todo el año en Junín. https://es.weatherspark.com/y/22304/Clima-promedio-en-Jun%C3%ADn-Per%C3%BA-durante-todo-el-a%C3%B1o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,m%C3%A1s%20de%2016%20%C2%B0C

Cámara Peruana del Café y Cacao (7 de octubre de 2021). La tecnología en el procesamiento de los cafés de especialidad. https://camcafeperu.com.pe/ES/articulo.php?id=132

Choperena, É. (23 de junio de 2020). El Empaque del Café, ¿Beneficia o Altera el Resultado de Nuestra Bebida? https://www.animalgourmet.com/2020/06/23/empaque-del-cafe-diferencias-beneficios/

QUIMINET (6 de mayo 2011). La importancia del envasado del café. https://www.quiminet.com/articulos/la-importancia-del-envasado-del-cafe-56041.htm
