Sebastian-Jaimes/EMC_IoT/docs/Elaboracion de tesis/CARÁTULA-Tesis-.docx

PONTIFICIA‌ ‌UNIVERSIDAD‌ ‌
CATÓLICA‌ ‌DEL‌ ‌PERÚ

FACULTAD DE CIENCIAS SOCIALES

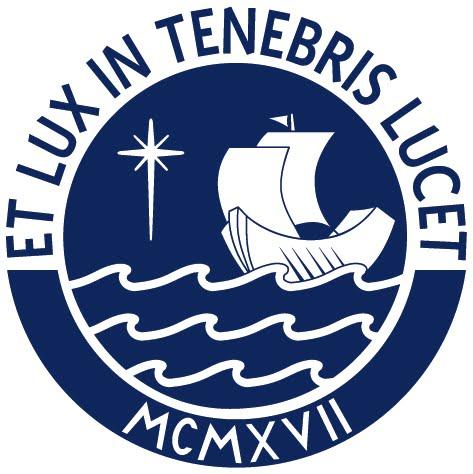
[picture p145: figure]

‌

Título completo de la tesis

Tesis para obtener el título profesional de Licenciado en xxx presentado por:

Apellidos, Nombres del autor

‌ ‌

Asesor(es):

Apellidos, Nombres del asesor 1

Apellidos, Nombres del asesor 2

Lima, Año
