Sebastian-Jaimes/EMC_IoT/electronics/Diagrama de potencia.pdf

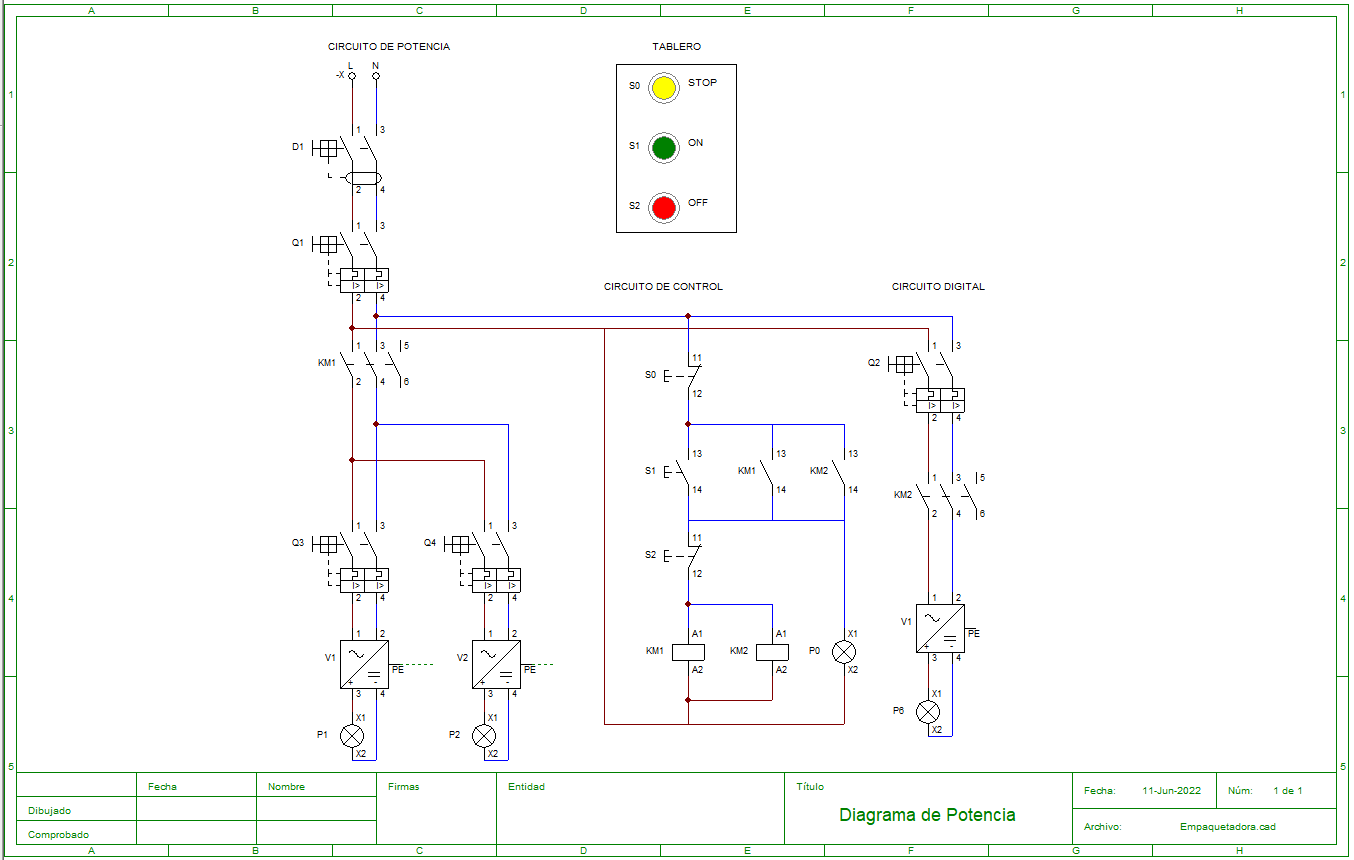
[picture p146: page 1]
