Sebastian-Jaimes/EMC_IoT/docs/MDM/5. PROYECTO/Metodología del diseño mecatrónico- Grupo/INFORME_INTEGRAL/Carcasa.pdf

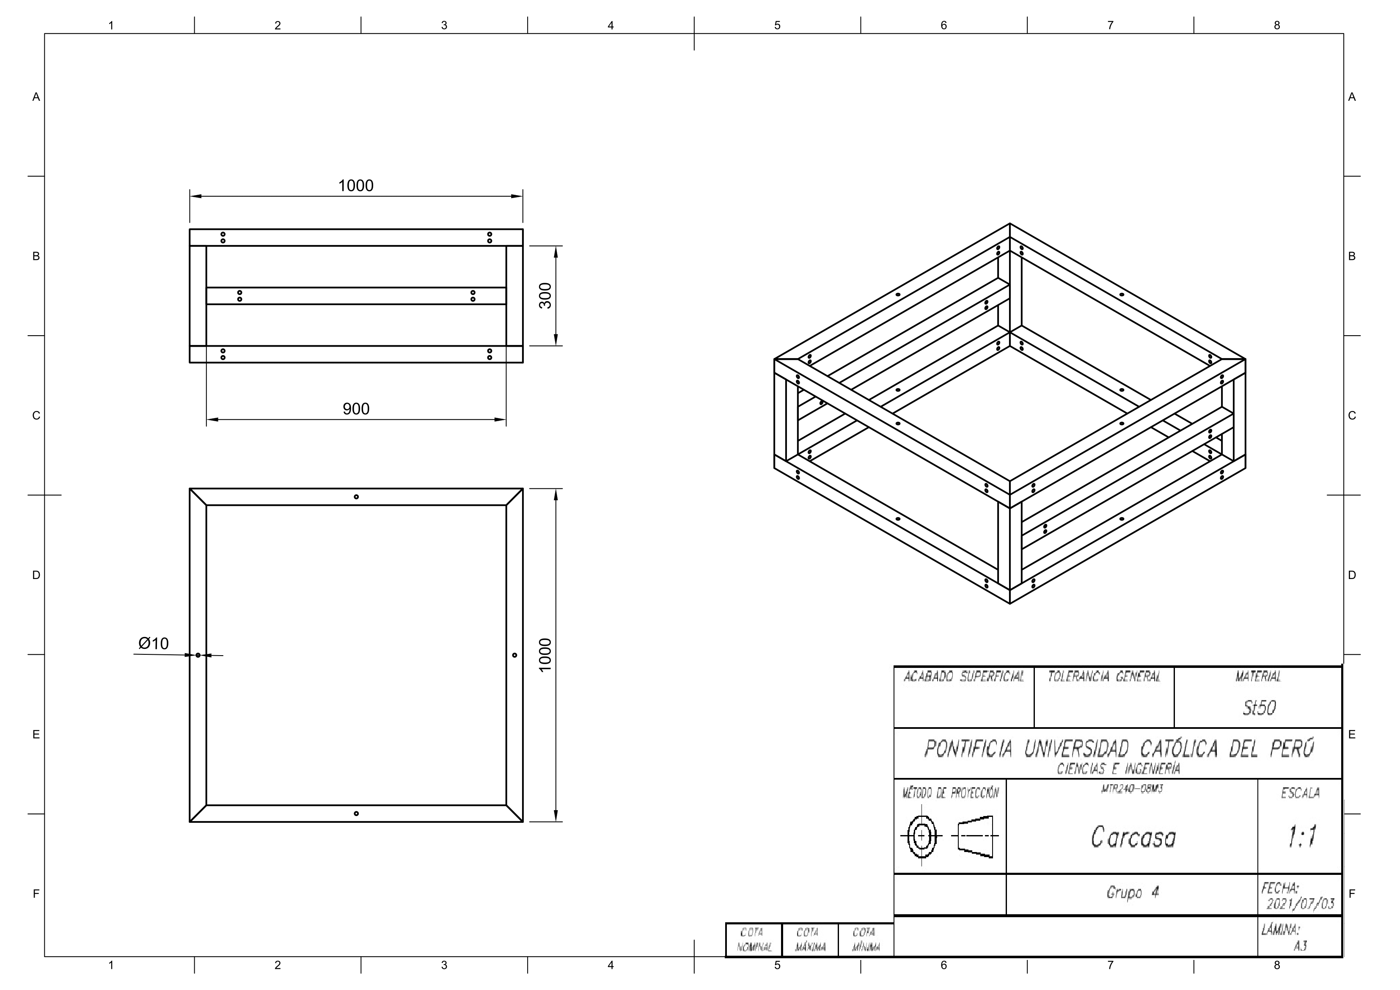
[picture p160: page 1]
