Sebastian-Jaimes/EMC_IoT/docs/Elaboracion de tesis/ComunicadoSustentacionDeUnaTesis.PDF

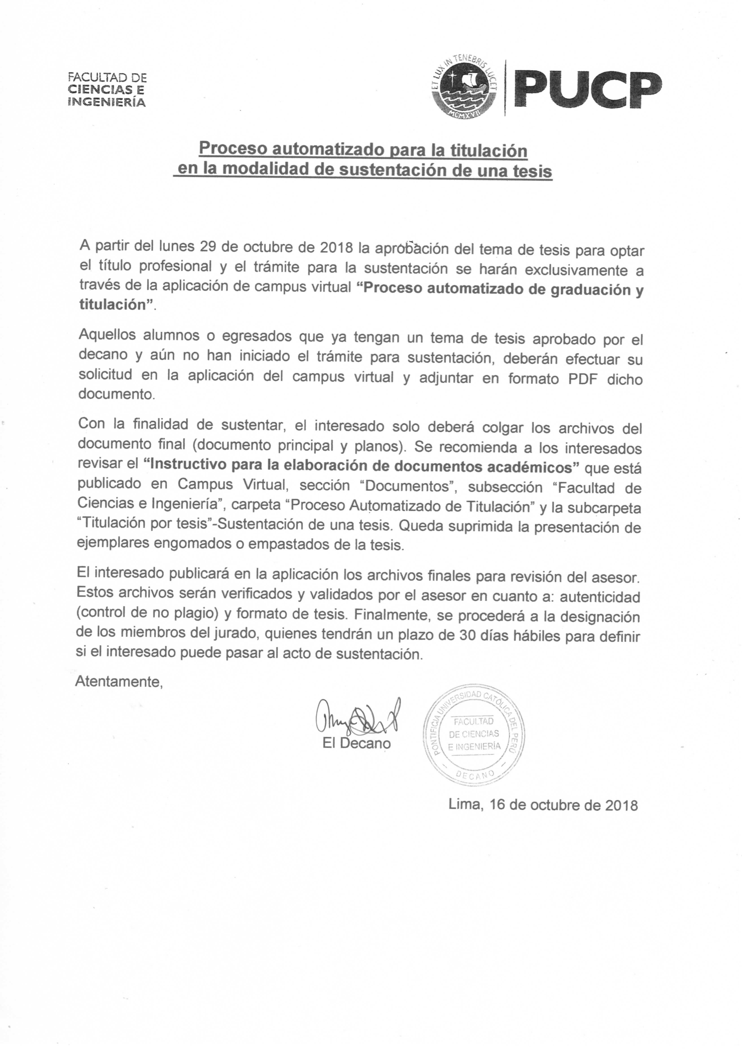
[picture p186: page 1]
