Sebastian-Jaimes/EMC_IoT/docs/MDM/5. PROYECTO/Metodología del diseño mecatrónico- Grupo/Tablas/Copy of Evaluación técnica-economica 2021-1.xlsx

Evaluación técnica
Criterio técnico | (0-4) | Sol 1 |  | Sol 2 |  | Sol 3 |  | Sol 4 |  | Sol 5 |  | Sol 6 |  | Sol Ideal
 | g | p | gp | p | gp | p | gp | p | gp | p | gp | p | gp | p | gp
Precisión en la aplicación del pesticida | 4 | 3 | 12 | 3 | 12 | 3 | 12 | 2 | 8 | 3 | 12 | 2 | 8 | 4 | 16
Autonomía | 4 | 3 | 12 | 3 | 12 | 3 | 12 | 3 | 12 | 2 | 8 | 1 | 4 | 4 | 16
Robustez | 3 | 2 | 6 | 2 | 6 | 2 | 6 | 1 | 3 | 1 | 3 | 3 | 9 | 4 | 12
Facilidad de uso (configuración) | 3 | 1 | 3 | 2 | 6 | 2 | 6 | 2 | 6 | 3 | 9 | 2 | 6 | 4 | 12
Rango de transmisión de datos | 3 | 3 | 9 | 3 | 9 | 3 | 9 | 2 | 6 | 3 | 9 | 3 | 9 | 4 | 12
Facilidad de mantenimiento | 2 | 2 | 4 | 3 | 6 | 2 | 4 | 3 | 6 | 2 | 4 | 2 | 4 | 4 | 8
Eficiencia en detección de maleza y cultivo | 4 | 3 | 12 | 3 | 12 | 3 | 12 | 2 | 8 | 3 | 12 | 2 | 8 | 4 | 16
Sumatoria |  |  | 46 |  | 51 |  | 49 |  | 41 |  | 45 |  | 40 |  | 76
xi |  |  | 0.605 |  | 0.671 |  | 0.6447368421 |  | 0.539 |  | 0.5921052632 |  | 0.526 |  | 1
 |  |  |  |  |  |  |  |  |  |  |  |  |  |  |  | CRITERIOS PARA LA SOLUCIÓN: | ALTERNATIVAS
 |  |  |  |  |  |  |  |  |  |  |  |  |  |  |  | 1.Desestimación de las soluciones con valor técnico/económico menor a 0.6
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
