Sebastian-Jaimes/EMC_IoT/docs/MDM/5. PROYECTO/Metodología del diseño mecatrónico- Grupo/Tablas/Cronograma de trabajo.xlsx

Actividad |  |  |  |  |  |  |  |  |  |  |  |  |  |  |  |  | TIEMPO (horas)
 |  | Semana 1 | Semana 2 | Semana 3 | Semana 4 | Semana 5 | Semana 6 | Semana 7 | Semana 8 | Semana 9 | Semana 10 | Semana 11 | Semana 12 | Semana 13 | Semana 14 | Semana 15
1 | Definición de problemática |  |  |  |  |  |  |  |  |  |  |  |  |  |  |  | 4
2 | Estado del arte |  |  |  |  |  |  |  |  |  |  |  |  |  |  |  | 8
3 | Lista de exigencias |  |  |  |  |  |  |  |  |  |  |  |  |  |  |  | 8
4 | Estructura de funciones |  |  |  |  |  |  |  |  |  |  |  |  |  |  |  | 12
5 | Matriz morfológica |  |  |  |  |  |  |  |  |  |  |  |  |  |  |  | 12
6 | Definición de concepto de solución |  |  |  |  |  |  |  |  |  |  |  |  |  |  |  | 8
7 | Evaluación técnica-económica |  |  |  |  |  |  |  |  |  |  |  |  |  |  |  | 6
8 | Proyectos preliminar óptimo |  |  |  |  |  |  |  |  |  |  |  |  |  |  |  | 14
9 | Memoria de calculos aprox |  |  |  |  |  |  |  |  |  |  |  |  |  |  |  | 8
10 | Concepto de solución óptimo(3D) |  |  |  |  |  |  |  |  |  |  |  |  |  |  |  | 8
11 | Proyecto preliminar |  |  |  |  |  |  |  |  |  |  |  |  |  |  |  | 8
12 | Modelo 3D detallado/Circuitos eléctricos y electrónicos |  |  |  |  |  |  |  |  |  |  |  |  |  |  |  | 10
13 | Explicación del proyecto definitivo |  |  |  |  |  |  |  |  |  |  |  |  |  |  |  | 8
14 | Maqueta/prototipo/simulación |  |  |  |  |  |  |  |  |  |  |  |  |  |  |  | 12
15 | Planos de ensamble/planos eléctricos/planos electrónicos |  |  |  |  |  |  |  |  |  |  |  |  |  |  |  | 10
16 | Sustentación final |  |  |  |  |  |  |  |  |  |  |  |  |  |  |  | 10
 |  |  |  |  |  |  |  |  |  |  |  |  |  | TOTAL |  |  | 146
