Sebastian-Jaimes/EMC_IoT/docs/Diagramas/Diagrama de bloques de empaquetadora de café/Diagrama de bloques.png

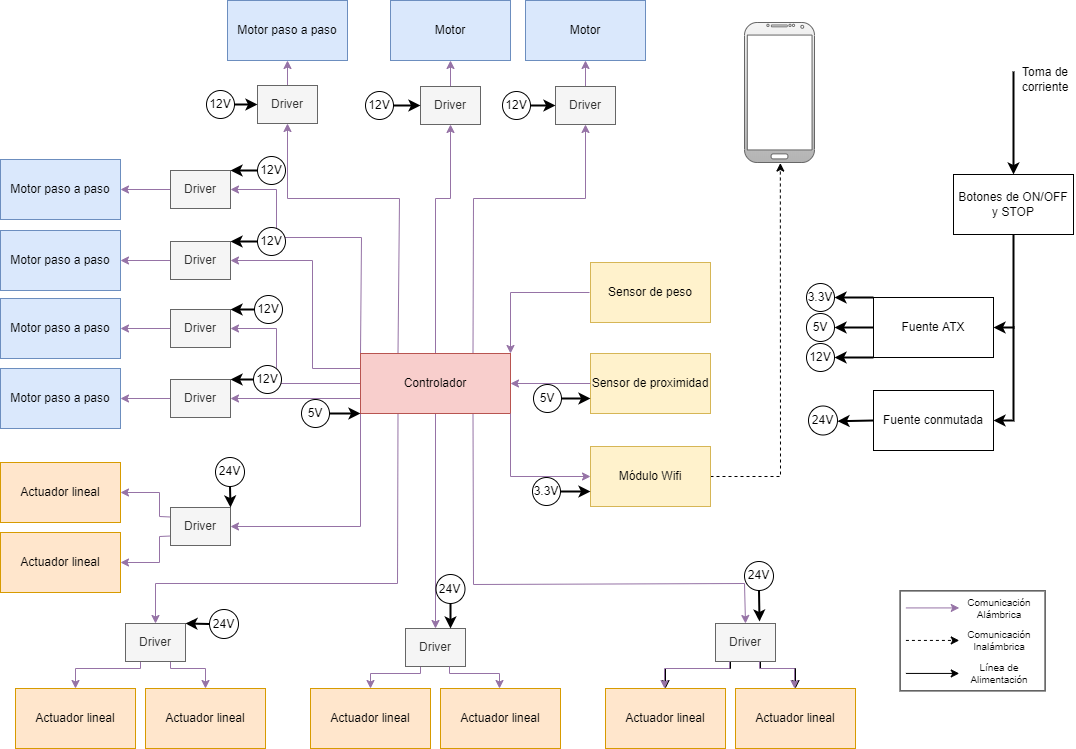
docs/Diagramas/Diagrama de bloques de empaquetadora de café/Diagrama de bloques.png
