Sebastian-Jaimes/EMC_IoT/docs/Diagramas/Diagrama de flujo de control/Contabilizar paquetes.png

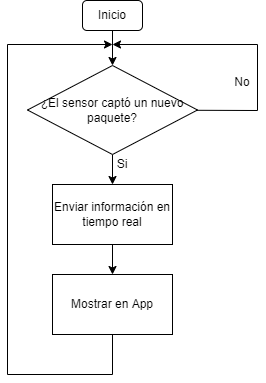
docs/Diagramas/Diagrama de flujo de control/Contabilizar paquetes.png
