Sebastian-Jaimes/EMC_IoT/docs/Diagramas/Diagrama de flujo de control/Diagrama de flujo.png

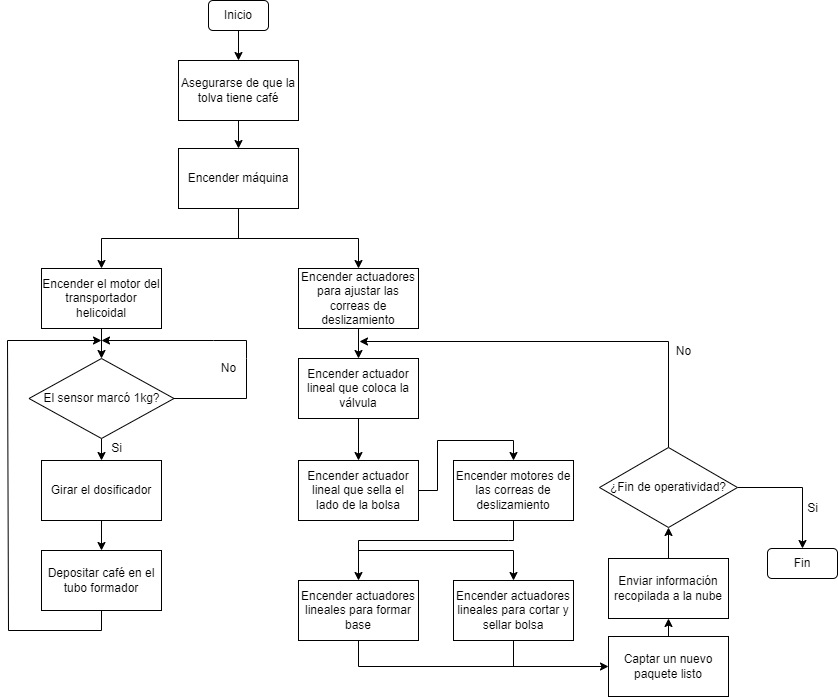
docs/Diagramas/Diagrama de flujo de control/Diagrama de flujo.png
