Sebastian-Jaimes/EMC_IoT/docs/Diagramas/Diagrama de flujo de control/Diagrama de flujo_2.png

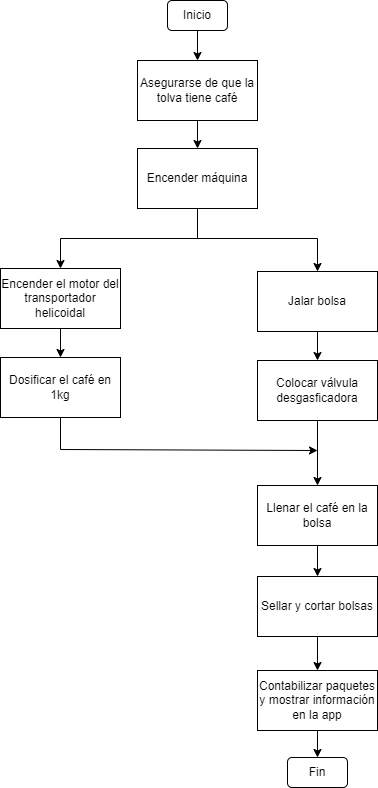
docs/Diagramas/Diagrama de flujo de control/Diagrama de flujo_2.png
