Sebastian-Jaimes/EMC_IoT/docs/Diagramas/Diagrama de flujo de control/Dosificación de café.png

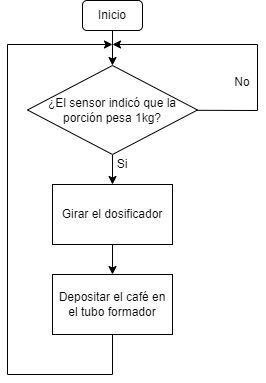
docs/Diagramas/Diagrama de flujo de control/Dosificación de café.png
