Sebastian-Jaimes/EMC_IoT/docs/Diagramas/Estructura de Funciones/Empaquetadora.png

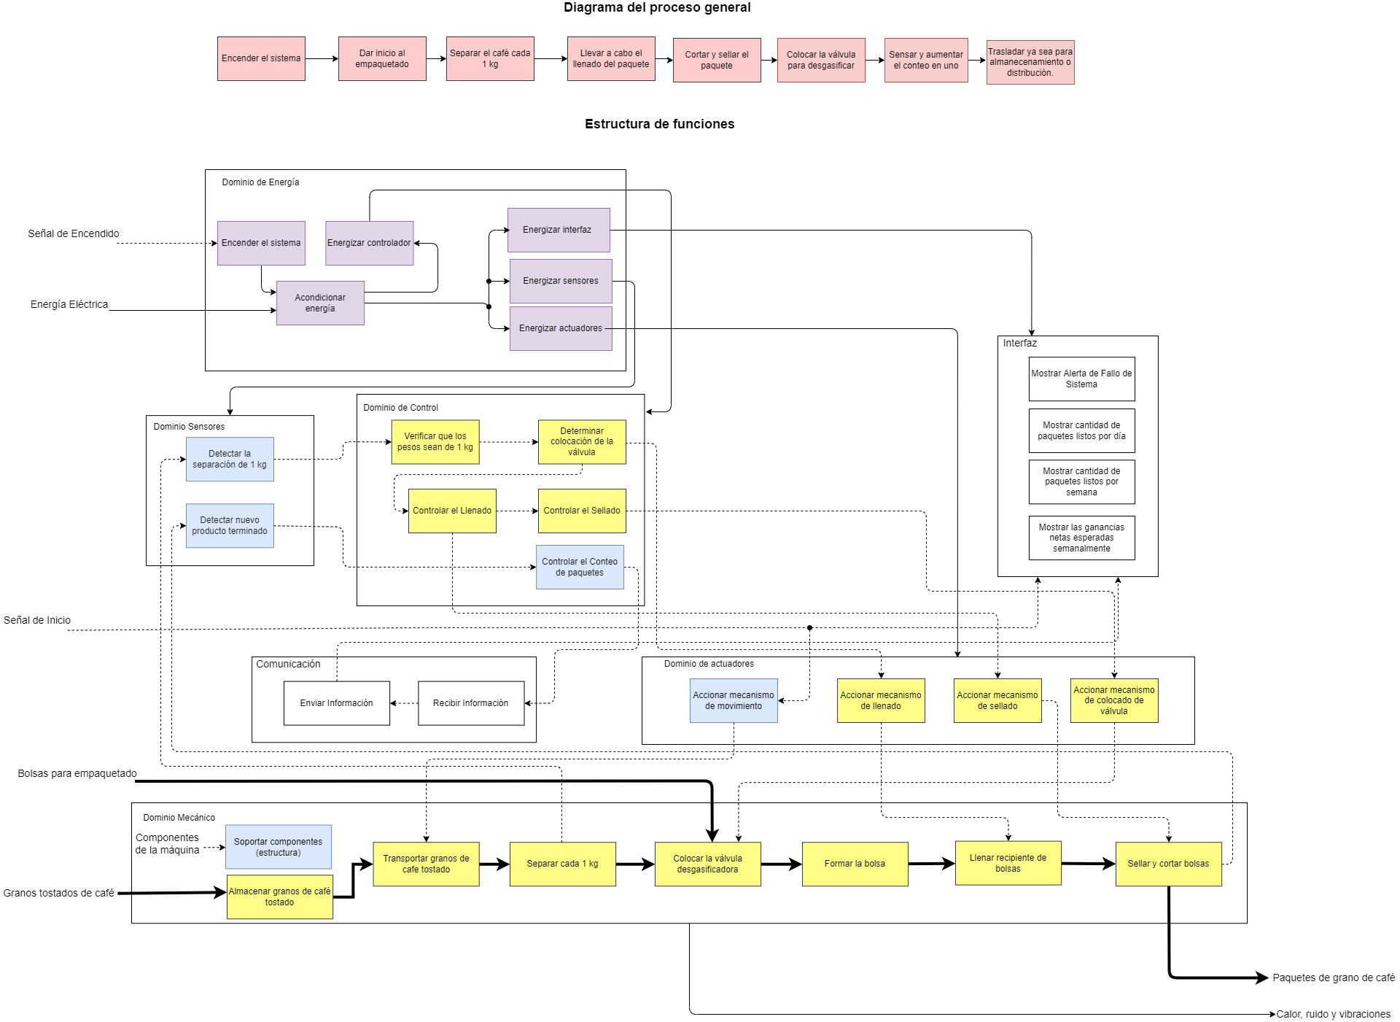
docs/Diagramas/Estructura de Funciones/Empaquetadora.png
