Sebastian-Jaimes/EMC_IoT/docs/Imágenes/9.PNG

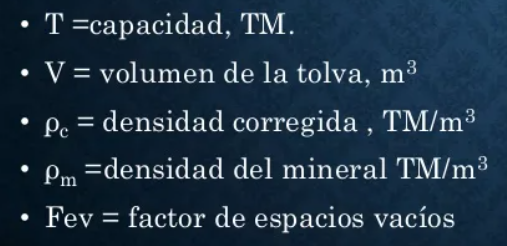
docs/Imágenes/9.PNG
