Sebastian-Jaimes/EMC_IoT/docs/Imágenes/10.PNG

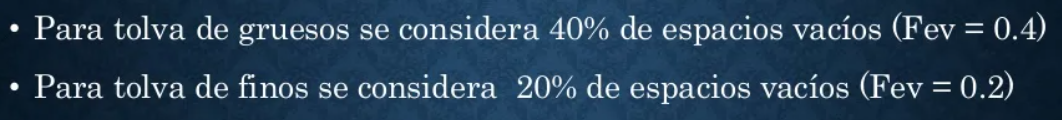
docs/Imágenes/10.PNG
