Sebastian-Jaimes/EMC_IoT/docs/Imágenes/11.PNG

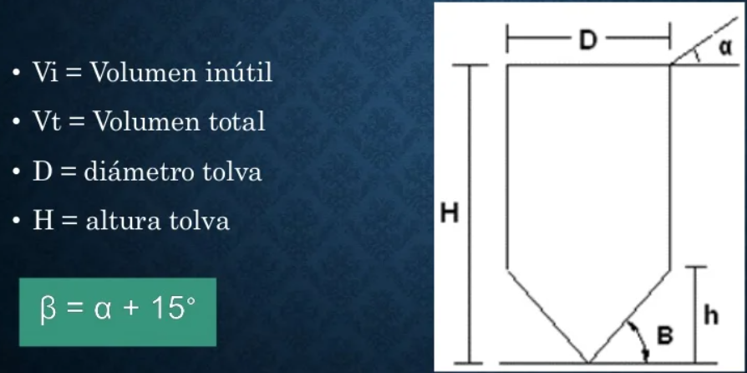
docs/Imágenes/11.PNG
