Sebastian-Jaimes/EMC_IoT/docs/Imágenes/44-0.jpg

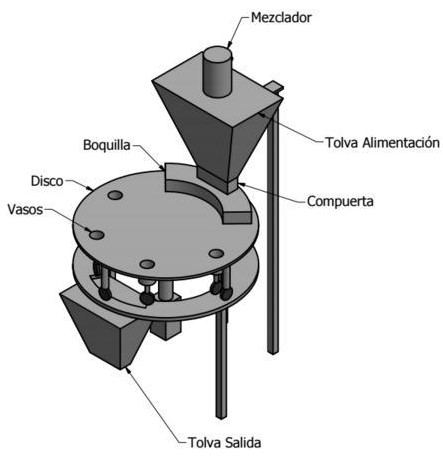
docs/Imágenes/44-0.jpg
