Sebastian-Jaimes/EMC_IoT/docs/Imágenes/Captura0.PNG

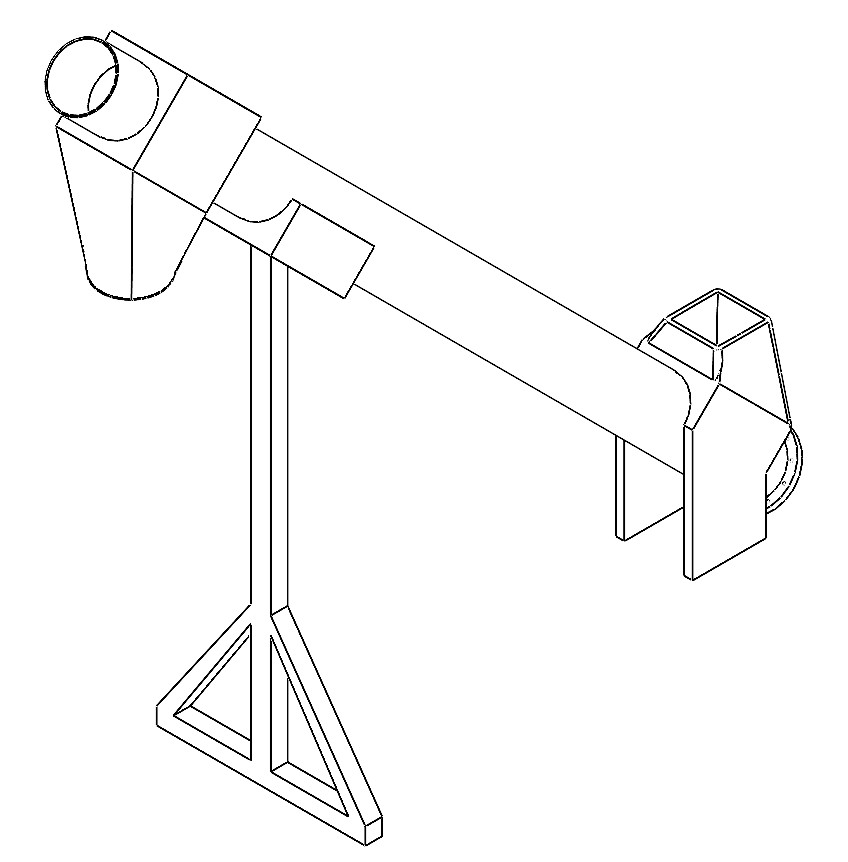
docs/Imágenes/Captura0.PNG
