Sebastian-Jaimes/EMC_IoT/docs/Imágenes/Captura2.PNG

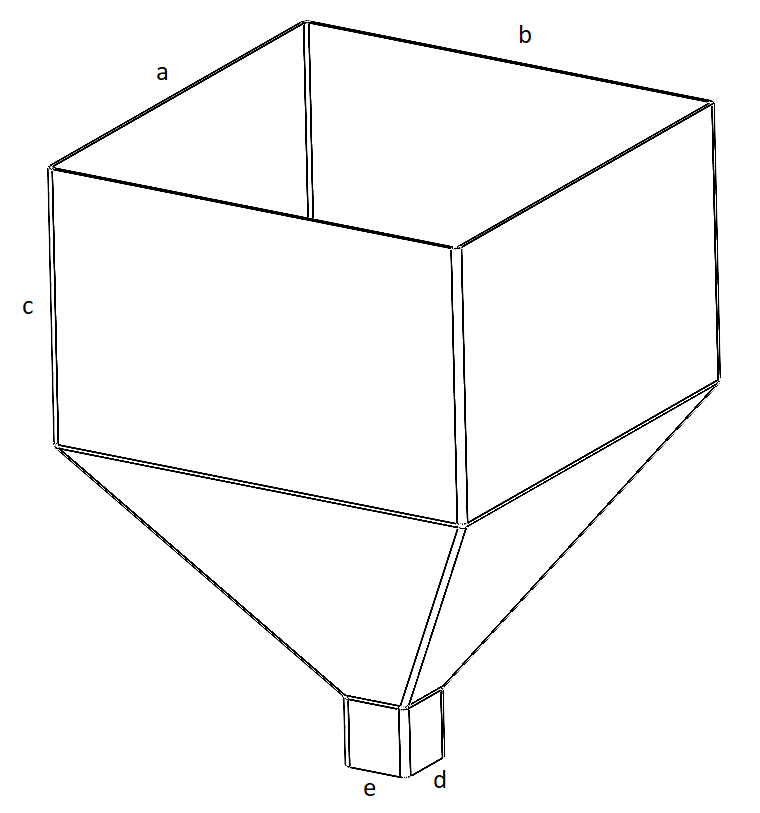
docs/Imágenes/Captura2.PNG
