Sebastian-Jaimes/EMC_IoT/docs/Imágenes/Concepto de solución 1 - Colocadora de Válvula.PNG

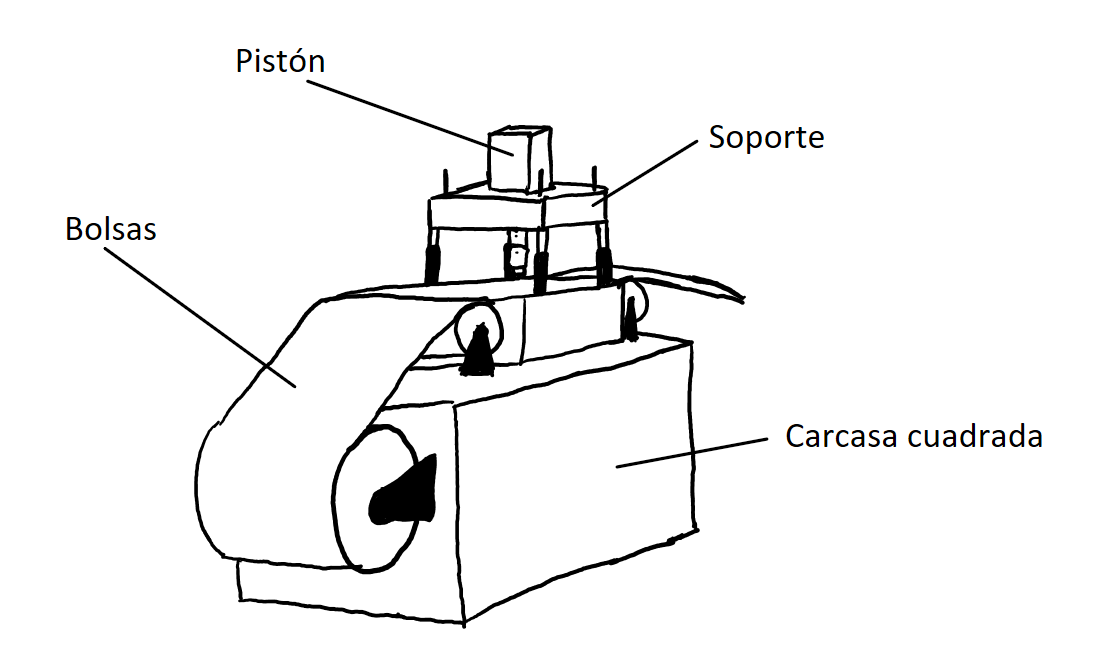
docs/Imágenes/Concepto de solución 1 - Colocadora de Válvula.PNG
