Sebastian-Jaimes/EMC_IoT/docs/Imágenes/Concepto de solución 1 - Dosificadora volumétrica.PNG

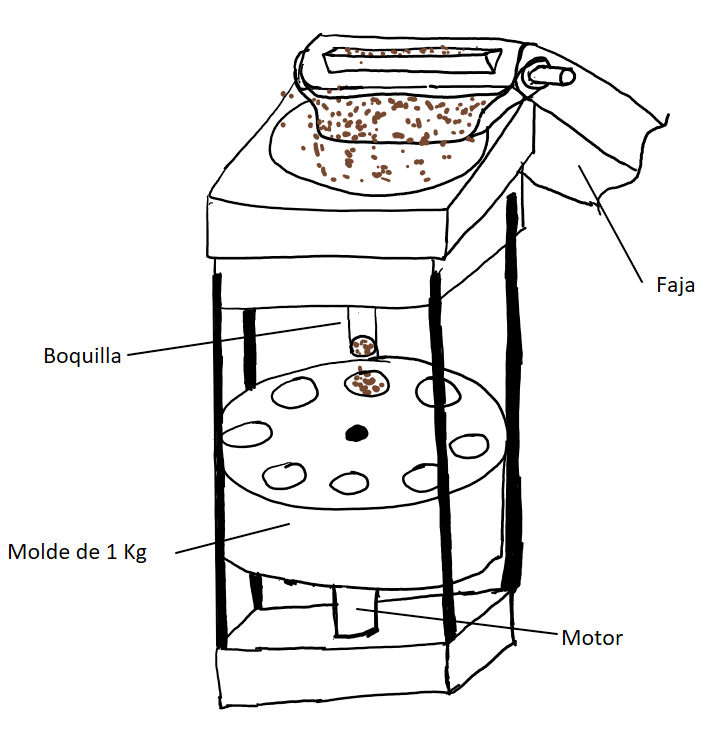
docs/Imágenes/Concepto de solución 1 - Dosificadora volumétrica.PNG
