Sebastian-Jaimes/EMC_IoT/docs/Imágenes/Concepto de solución 1 - Faja elevadora.PNG

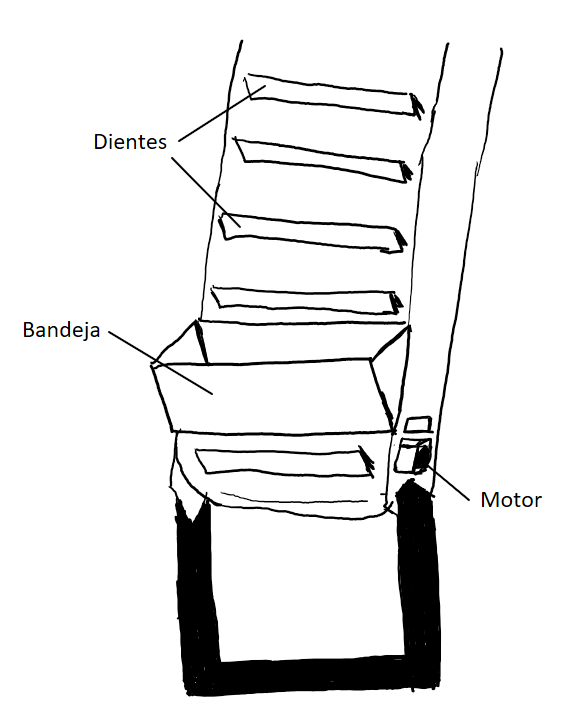
docs/Imágenes/Concepto de solución 1 - Faja elevadora.PNG
