Sebastian-Jaimes/EMC_IoT/docs/Imágenes/Concepto de solución 1 - Tolva.PNG

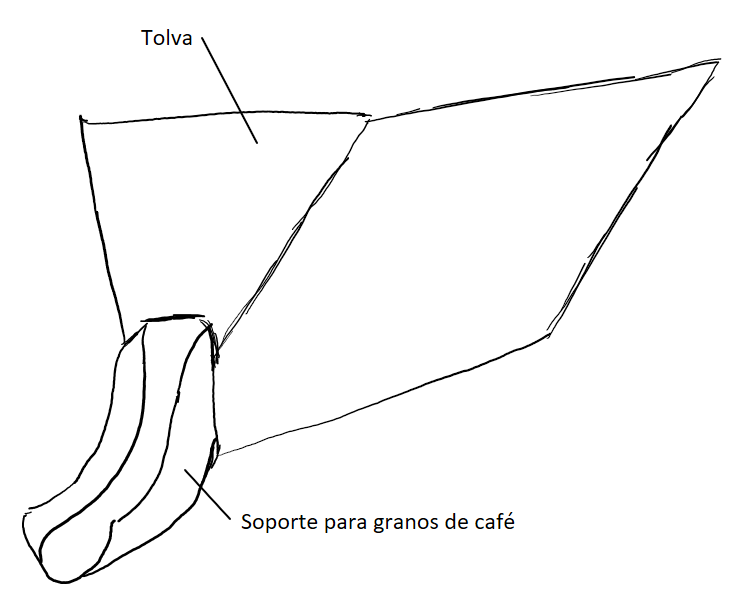
docs/Imágenes/Concepto de solución 1 - Tolva.PNG
