Sebastian-Jaimes/EMC_IoT/docs/Imágenes/Concepto de solución 1.png

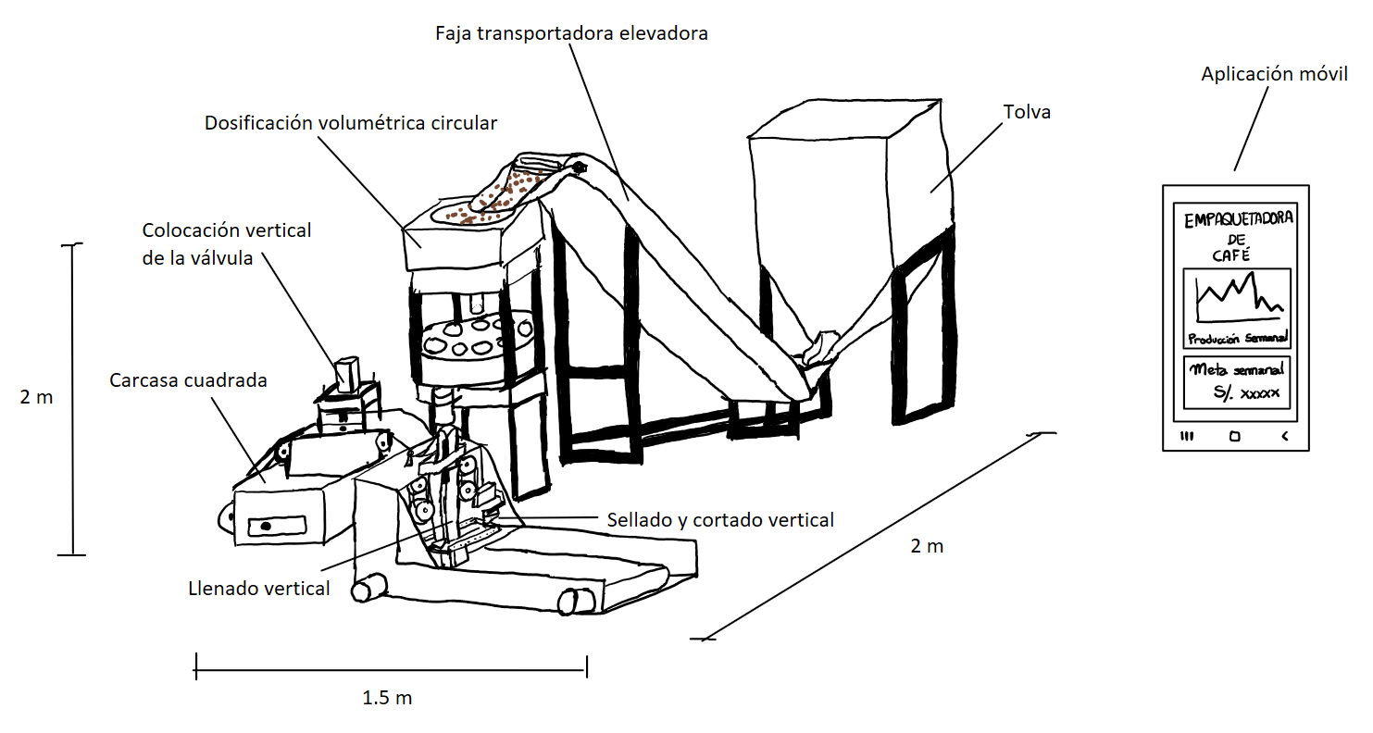
docs/Imágenes/Concepto de solución 1.png
