Sebastian-Jaimes/EMC_IoT/docs/Imágenes/Concepto de solución 2.png

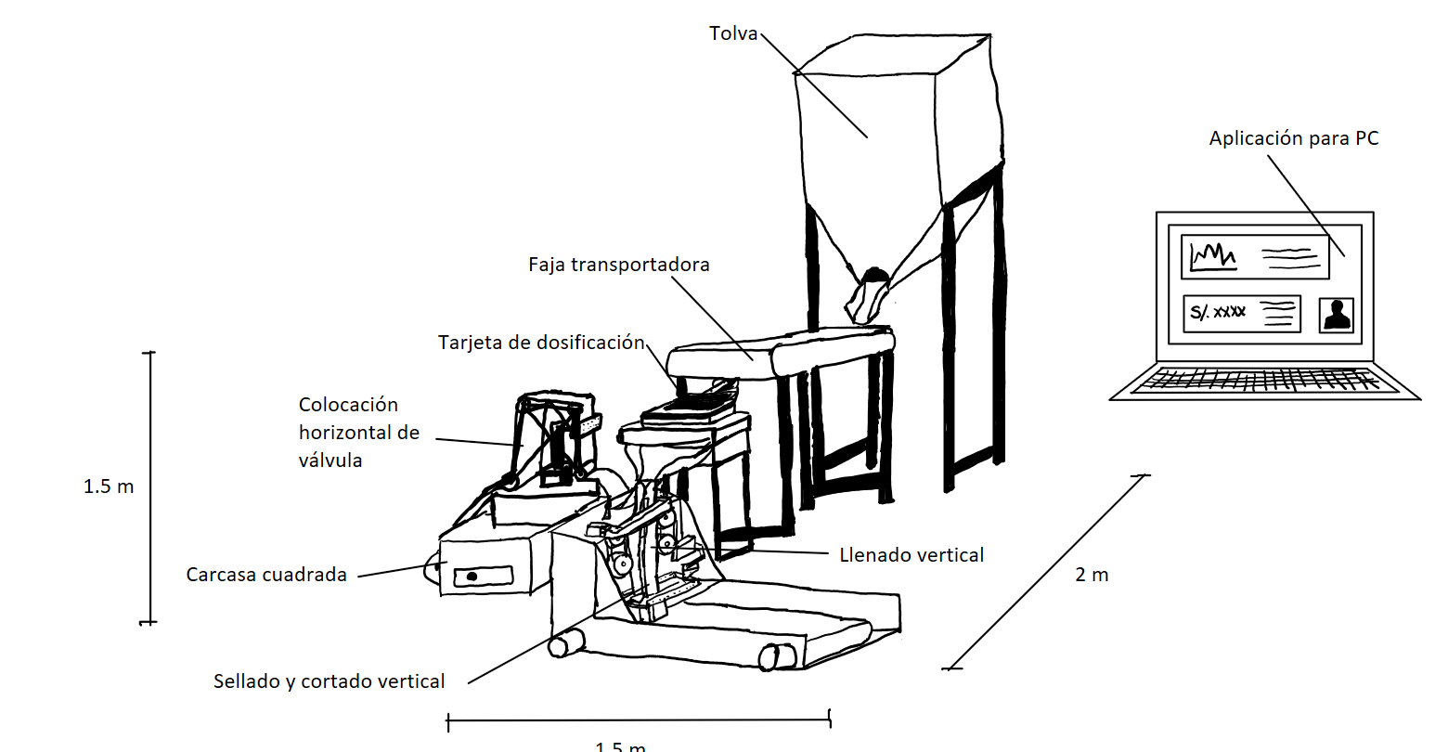
docs/Imágenes/Concepto de solución 2.png
