Sebastian-Jaimes/EMC_IoT/docs/Imágenes/Concepto de solución 3 - Cilindro.PNG

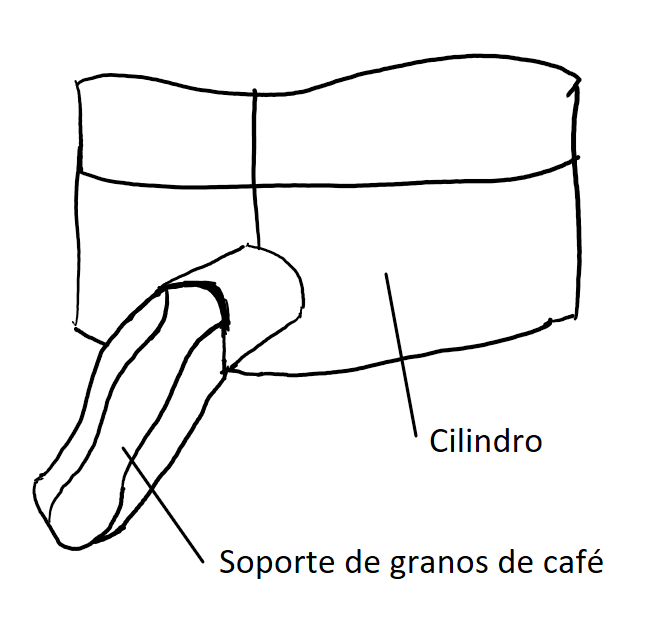
docs/Imágenes/Concepto de solución 3 - Cilindro.PNG
