Sebastian-Jaimes/EMC_IoT/docs/Imágenes/Concepto de solución 3.png

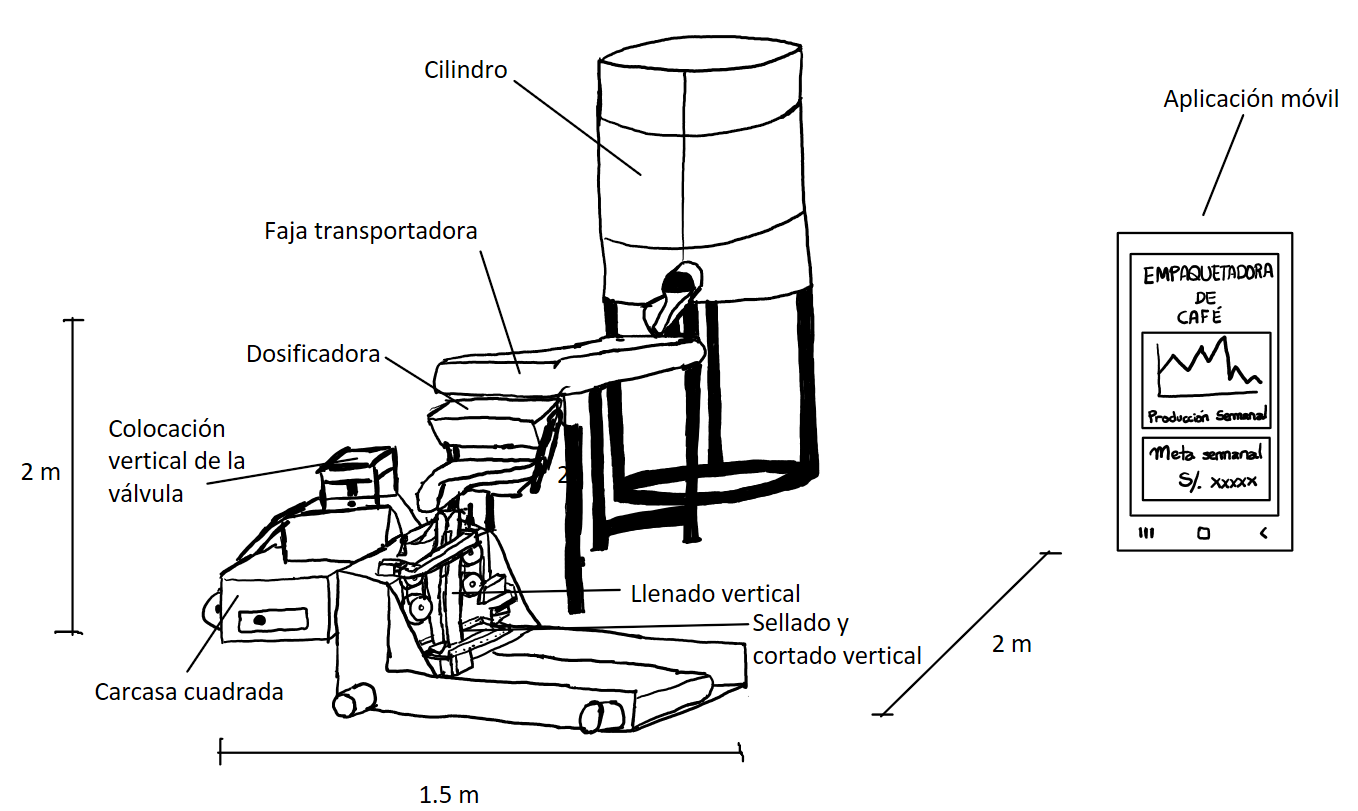
docs/Imágenes/Concepto de solución 3.png
