Sebastian-Jaimes/EMC_IoT/docs/Imágenes/Control On Off.png

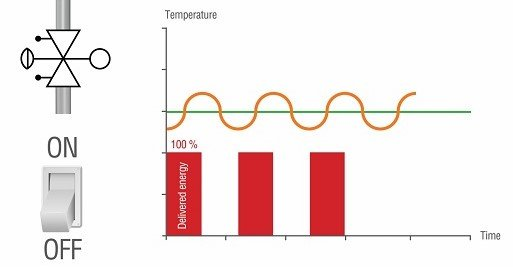
docs/Imágenes/Control On Off.png
