Sebastian-Jaimes/EMC_IoT/docs/Imágenes/Detalle cilindro.PNG

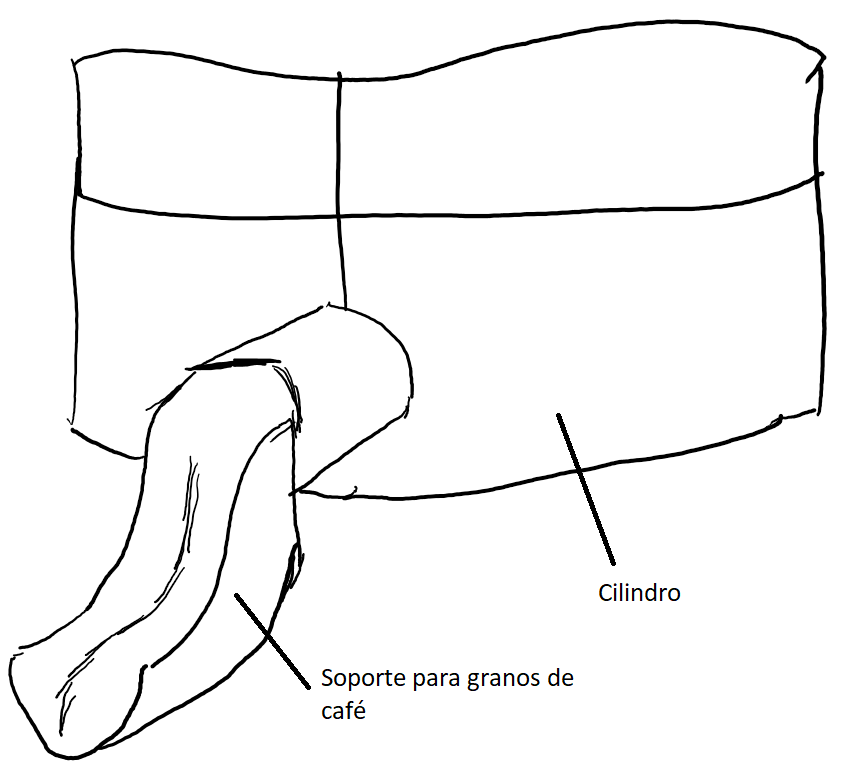
docs/Imágenes/Detalle cilindro.PNG
