Sebastian-Jaimes/EMC_IoT/docs/Imágenes/Detalle faja elevadora.PNG

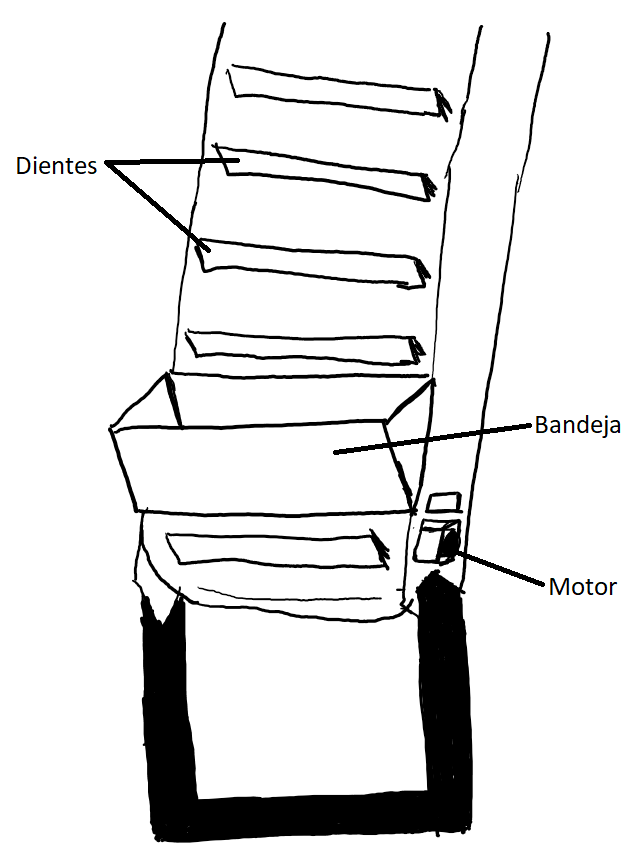
docs/Imágenes/Detalle faja elevadora.PNG
