Sebastian-Jaimes/EMC_IoT/docs/Imágenes/Detalle faja.PNG

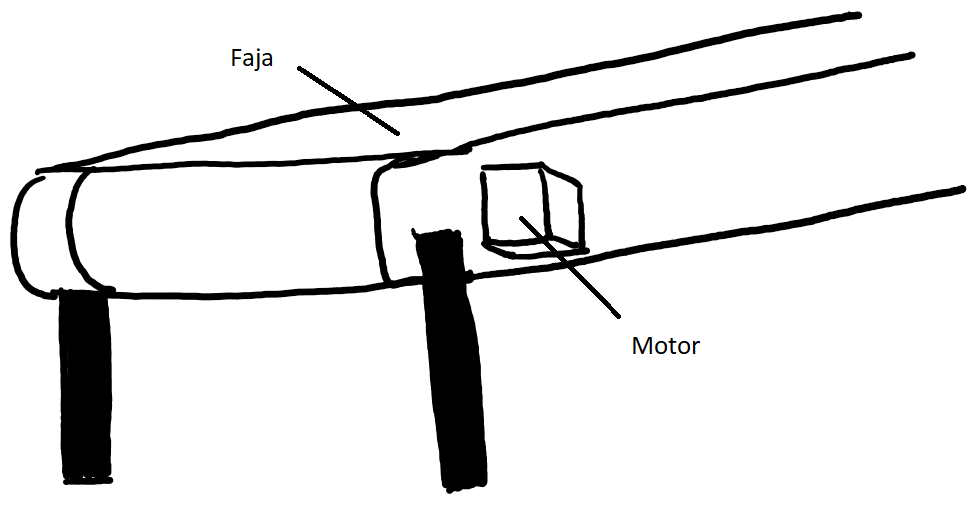
docs/Imágenes/Detalle faja.PNG
