Sebastian-Jaimes/EMC_IoT/docs/Imágenes/Detalle Tolva.PNG

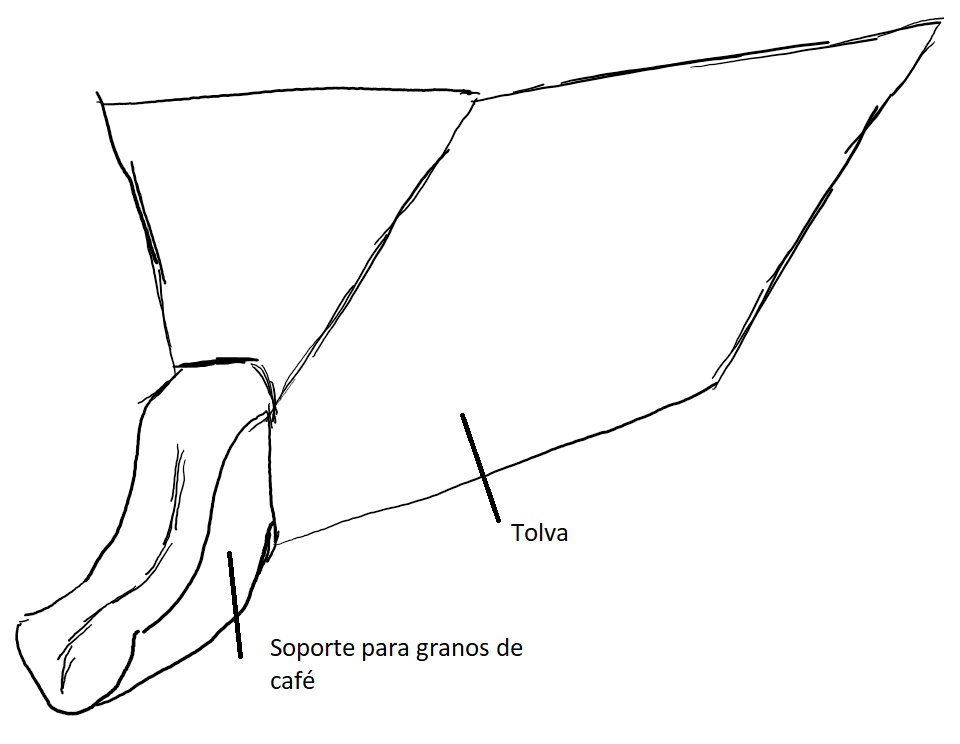
docs/Imágenes/Detalle Tolva.PNG
