Sebastian-Jaimes/EMC_IoT/docs/Imágenes/DM_Volumetrico-Deslizante.jpg

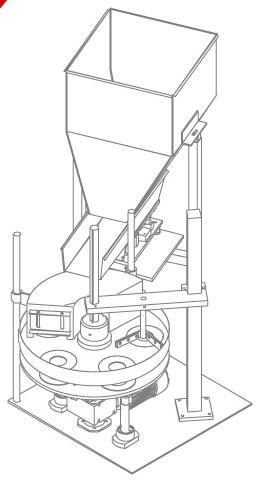
docs/Imágenes/DM_Volumetrico-Deslizante.jpg
