Sebastian-Jaimes/EMC_IoT/docs/Imágenes/Dosificador solidos_sg.jpg

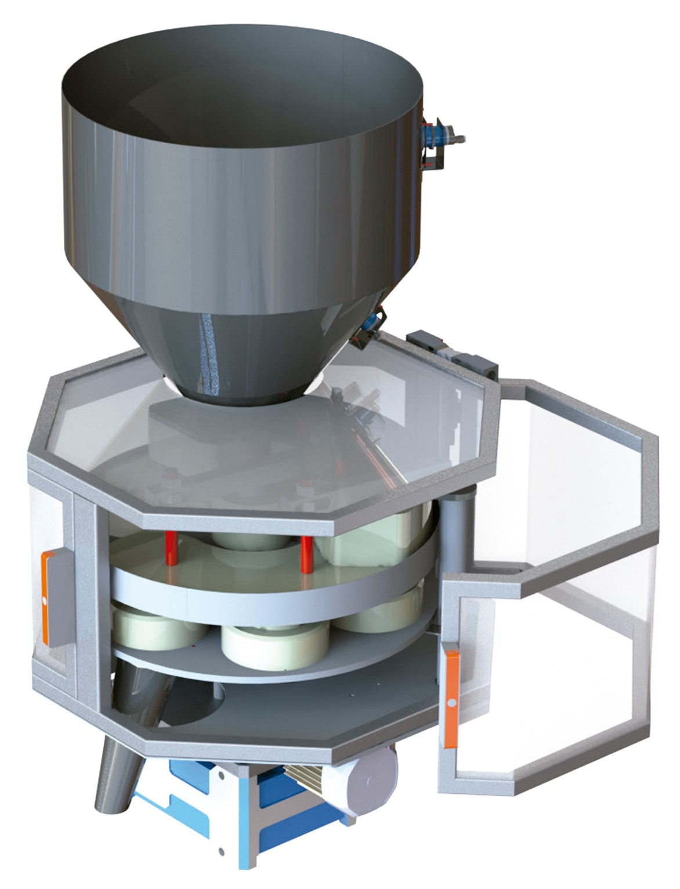
docs/Imágenes/Dosificador solidos_sg.jpg
