Sebastian-Jaimes/EMC_IoT/docs/Imágenes/Dosificador volumétrico.PNG

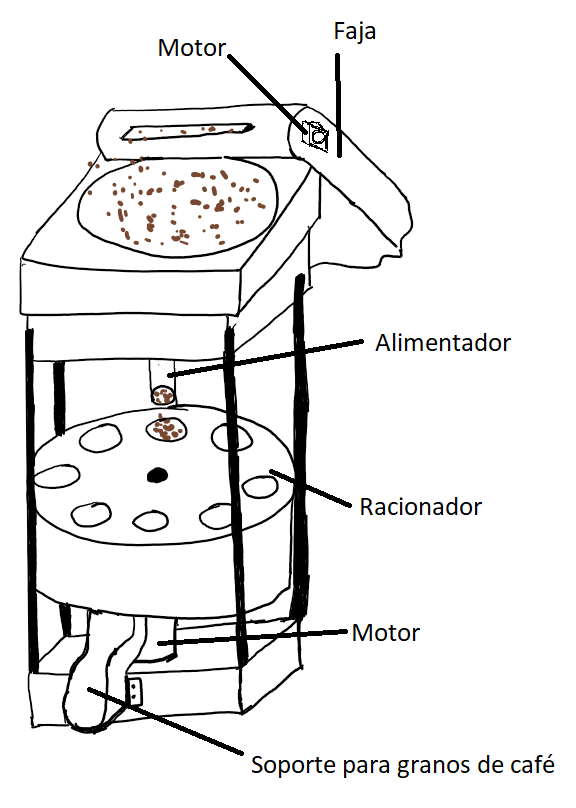
docs/Imágenes/Dosificador volumétrico.PNG
