Sebastian-Jaimes/EMC_IoT/docs/Imágenes/Llenado horizontal.PNG

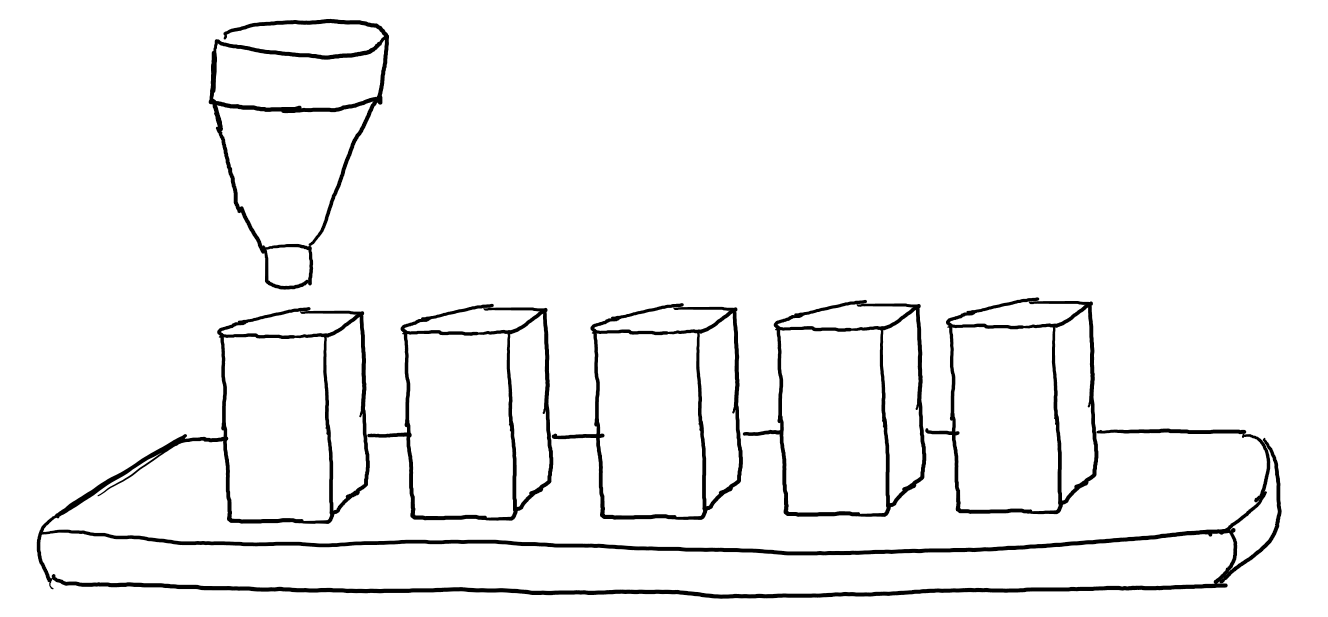
docs/Imágenes/Llenado horizontal.PNG
