Sebastian-Jaimes/EMC_IoT/docs/Imágenes/Llenado vertical.PNG

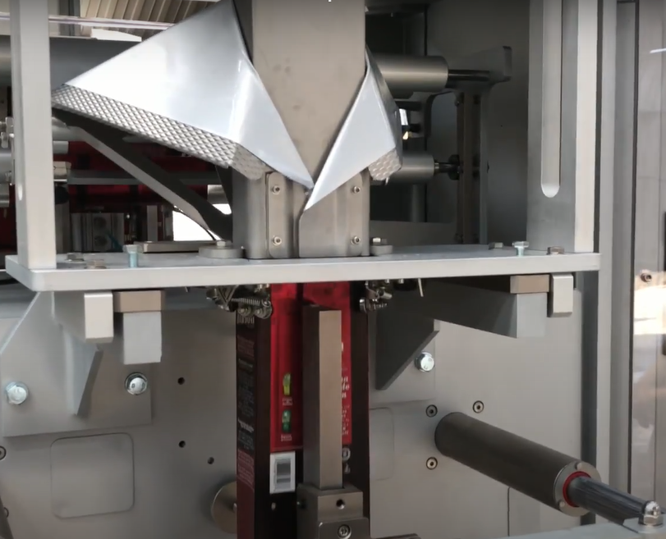
docs/Imágenes/Llenado vertical.PNG
