Sebastian-Jaimes/EMC_IoT/docs/Imágenes/panel hmi.png

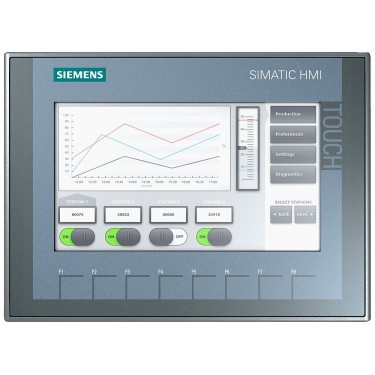
docs/Imágenes/panel hmi.png
