Sebastian-Jaimes/EMC_IoT/docs/Imágenes/pistón electrico.png

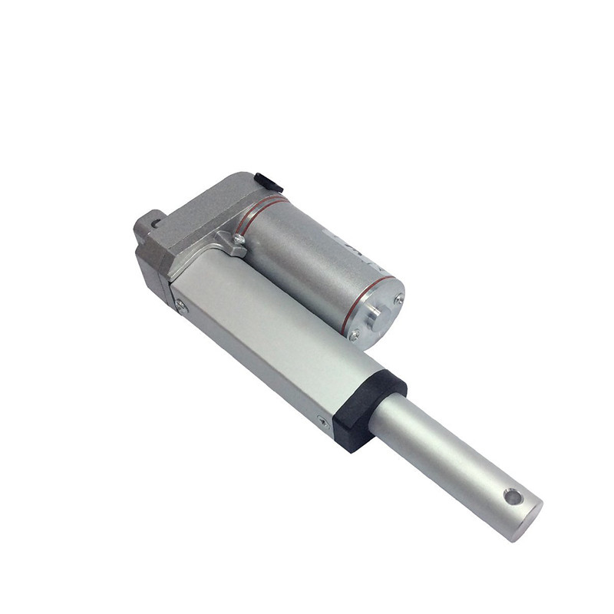
docs/Imágenes/pistón electrico.png
