Sebastian-Jaimes/EMC_IoT/docs/Imágenes/Pistón Hidráulico.png

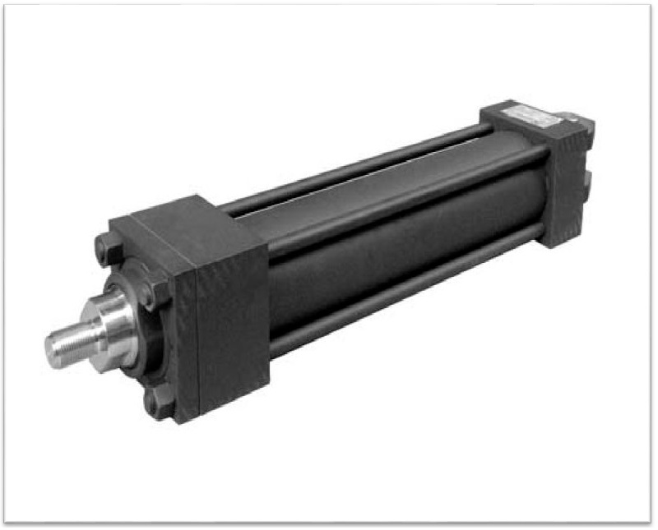
docs/Imágenes/Pistón Hidráulico.png
