Sebastian-Jaimes/EMC_IoT/docs/Imágenes/Pistón Neumático.png

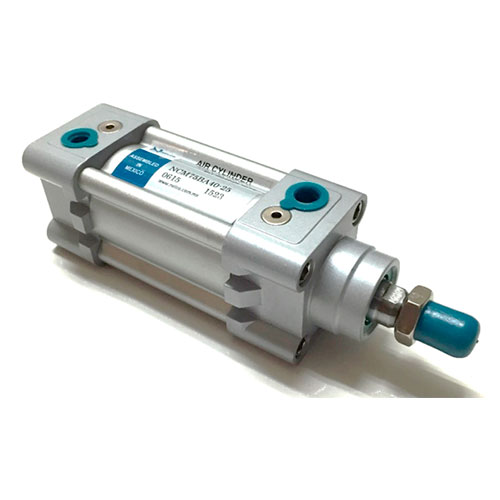
docs/Imágenes/Pistón Neumático.png
