Sebastian-Jaimes/EMC_IoT/docs/Imágenes/reles.png

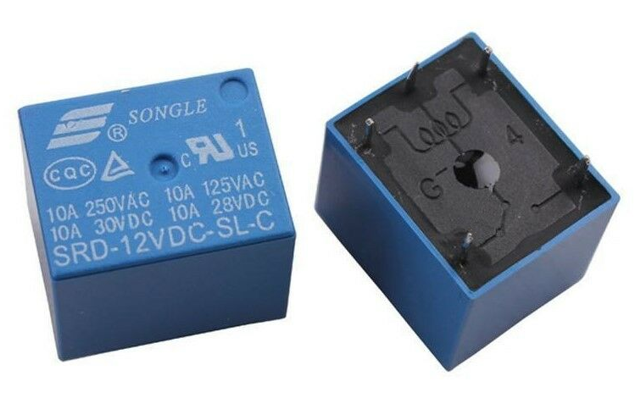
docs/Imágenes/reles.png
