Sebastian-Jaimes/EMC_IoT/docs/Imágenes/Sellado y cortado vertical.PNG

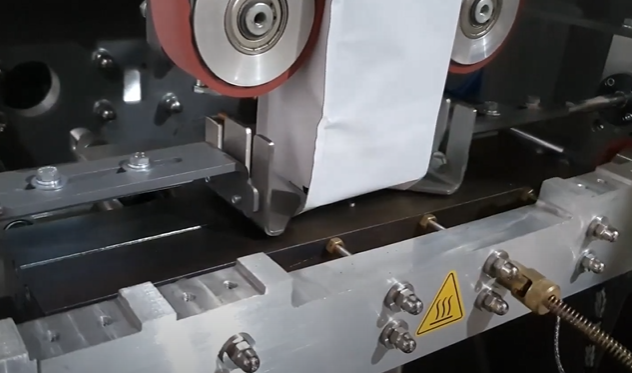
docs/Imágenes/Sellado y cortado vertical.PNG
