Sebastian-Jaimes/EMC_IoT/docs/Imágenes/Selladora con pistón.PNG

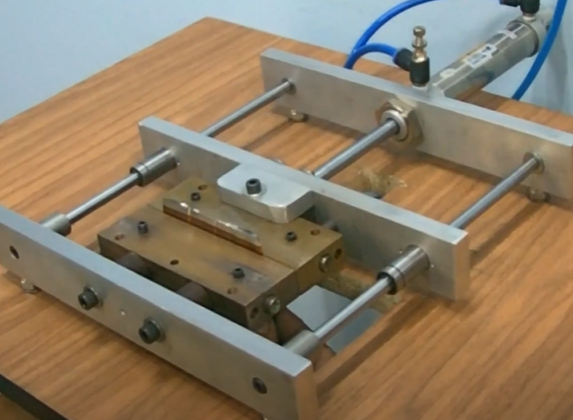
docs/Imágenes/Selladora con pistón.PNG
