Sebastian-Jaimes/EMC_IoT/docs/Imágenes/Tabla precios.PNG

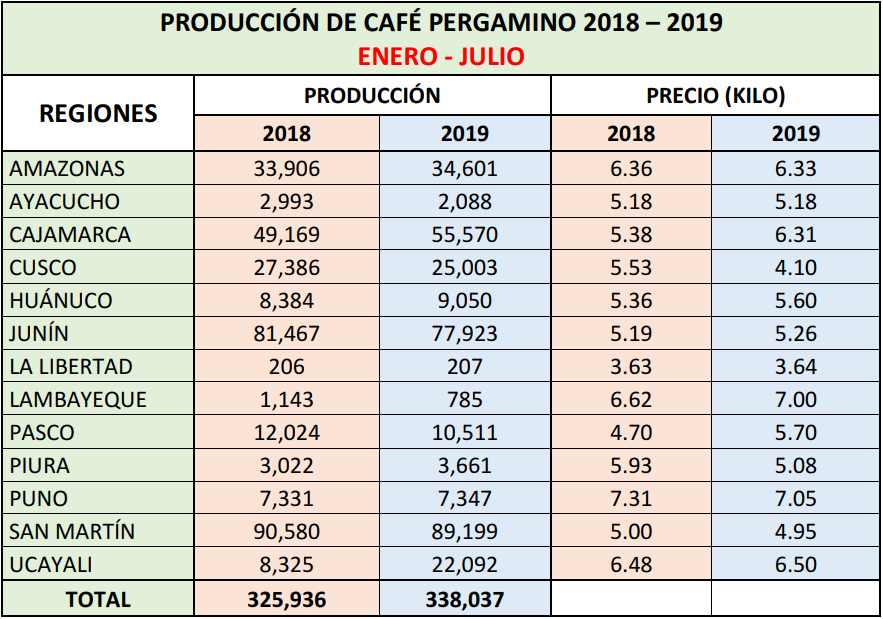
docs/Imágenes/Tabla precios.PNG
