Sebastian-Jaimes/EMC_IoT/docs/Imágenes/Ubicación vertical sostenida.png

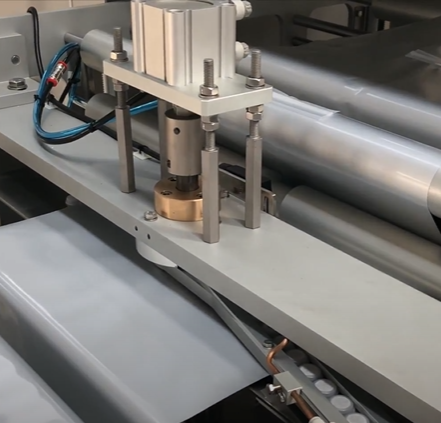
docs/Imágenes/Ubicación vertical sostenida.png
