Sebastian-Jaimes/EMC_IoT/docs/Imágenes/Ubicación vertical.png

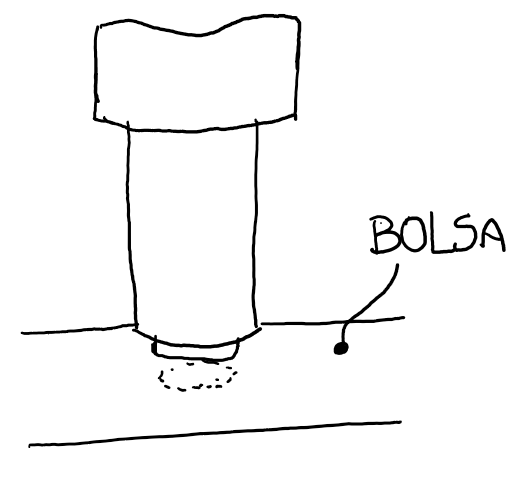
docs/Imágenes/Ubicación vertical.png
