Sebastian-Jaimes/EMC_IoT/docs/Imágenes/Unicación horizontal.png

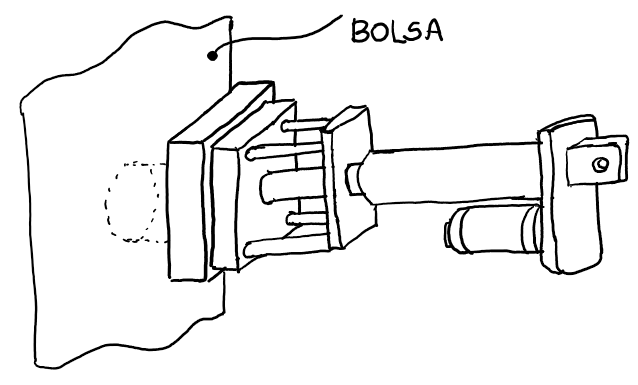
docs/Imágenes/Unicación horizontal.png
