Sebastian-Jaimes/EMC_IoT/docs/Imágenes/WhatsApp Image 2021-11-13 at 4.27.32 PM (1).jpeg

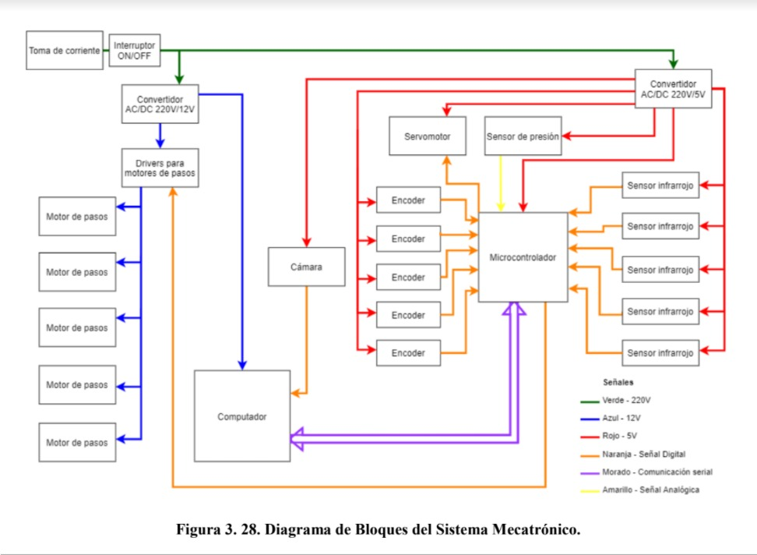
docs/Imágenes/WhatsApp Image 2021-11-13 at 4.27.32 PM (1).jpeg
