Sebastian-Jaimes/EMC_IoT/docs/MDM/EXAMEN PARCIAL/Estructura de Funciones/Estructura de Funciones.png

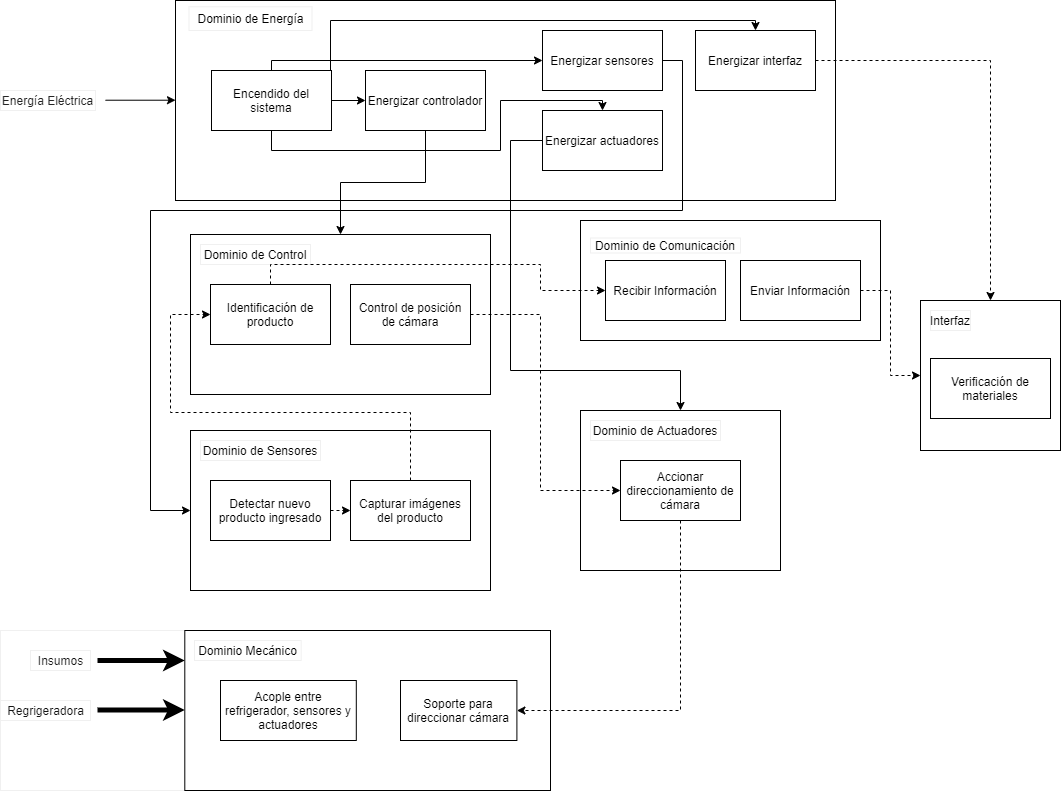
docs/MDM/EXAMEN PARCIAL/Estructura de Funciones/Estructura de Funciones.png
