Sebastian-Jaimes/EMC_IoT/electronics/Esquemático.png

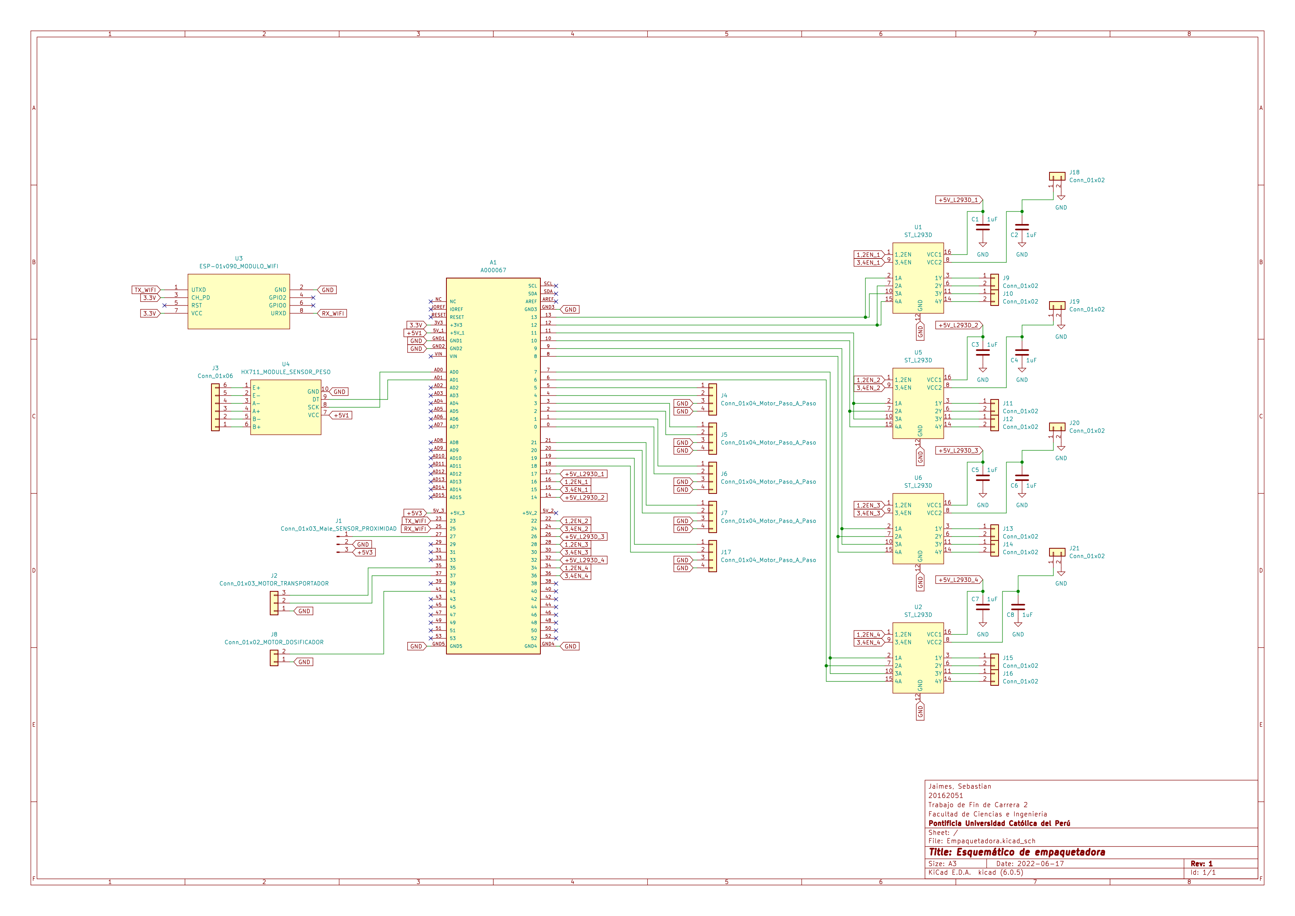
electronics/Esquemático.png
