Sebastian-Jaimes/EMC_IoT/electronics/PCB.png

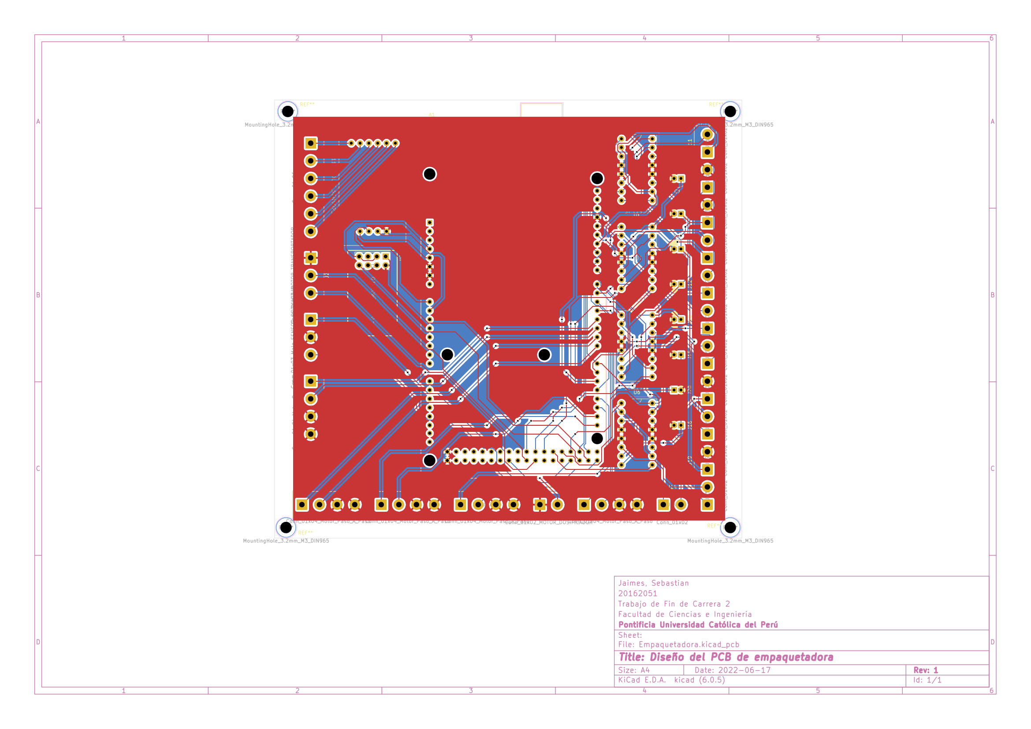
electronics/PCB.png
