Sebastian-Jaimes/EMC_IoT/hardware/3d_models/2. Transporte/Planos en PNG/Eje del tornillo helicoidal/Eje del tornillo helicoidal-1.png

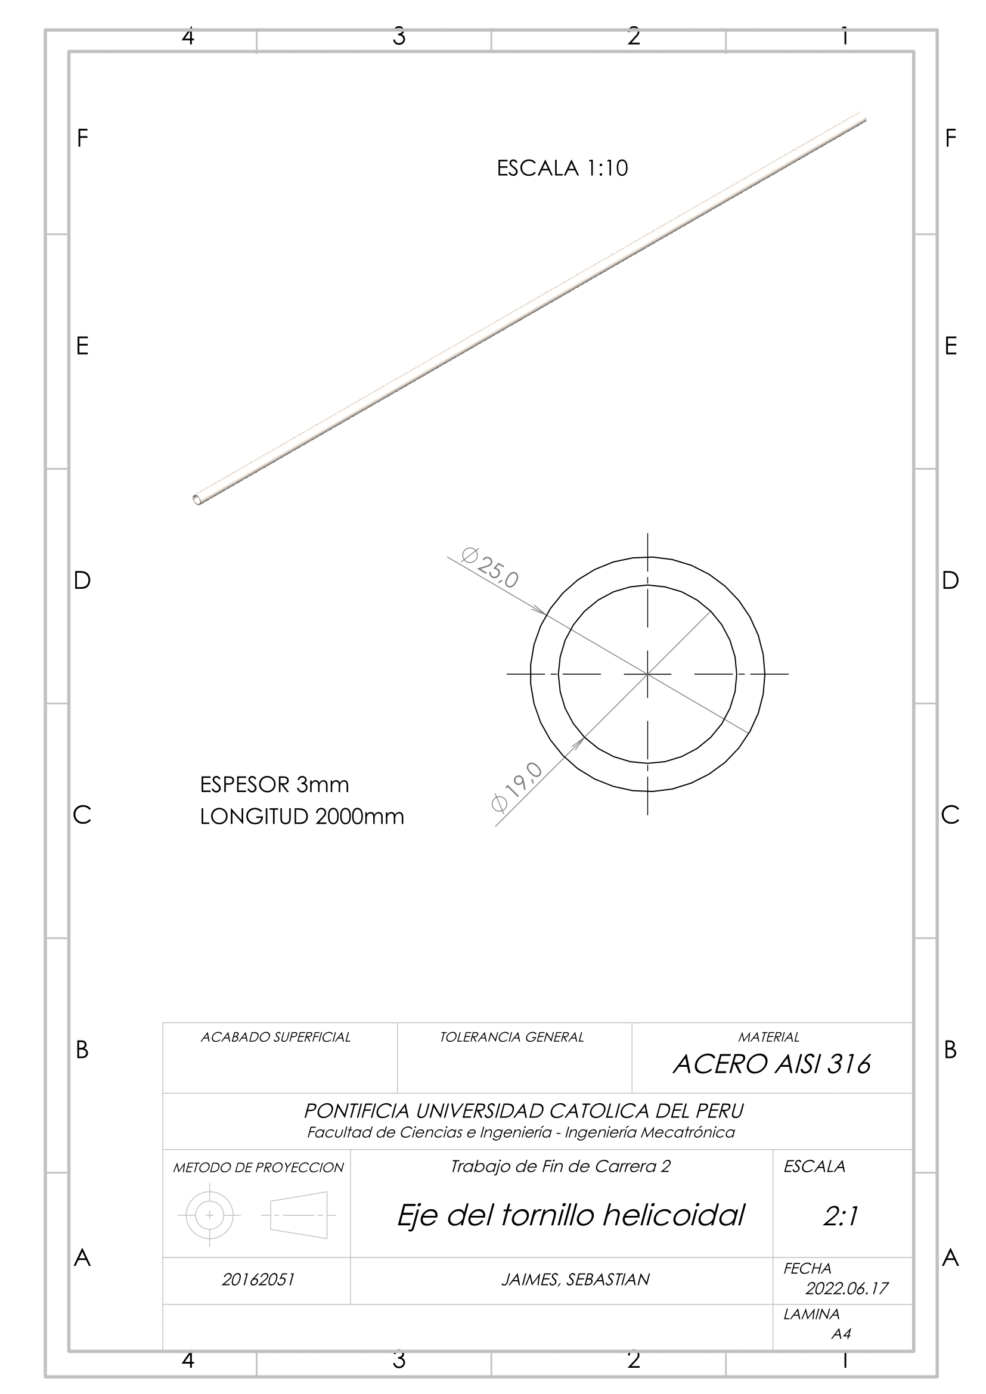
hardware/3d_models/2. Transporte/Planos en PNG/Eje del tornillo helicoidal/Eje del tornillo helicoidal-1.png
