Sebastian-Jaimes/EMC_IoT/hardware/3d_models/2. Transporte/Planos en PNG/Hélice/Hélice-1.png

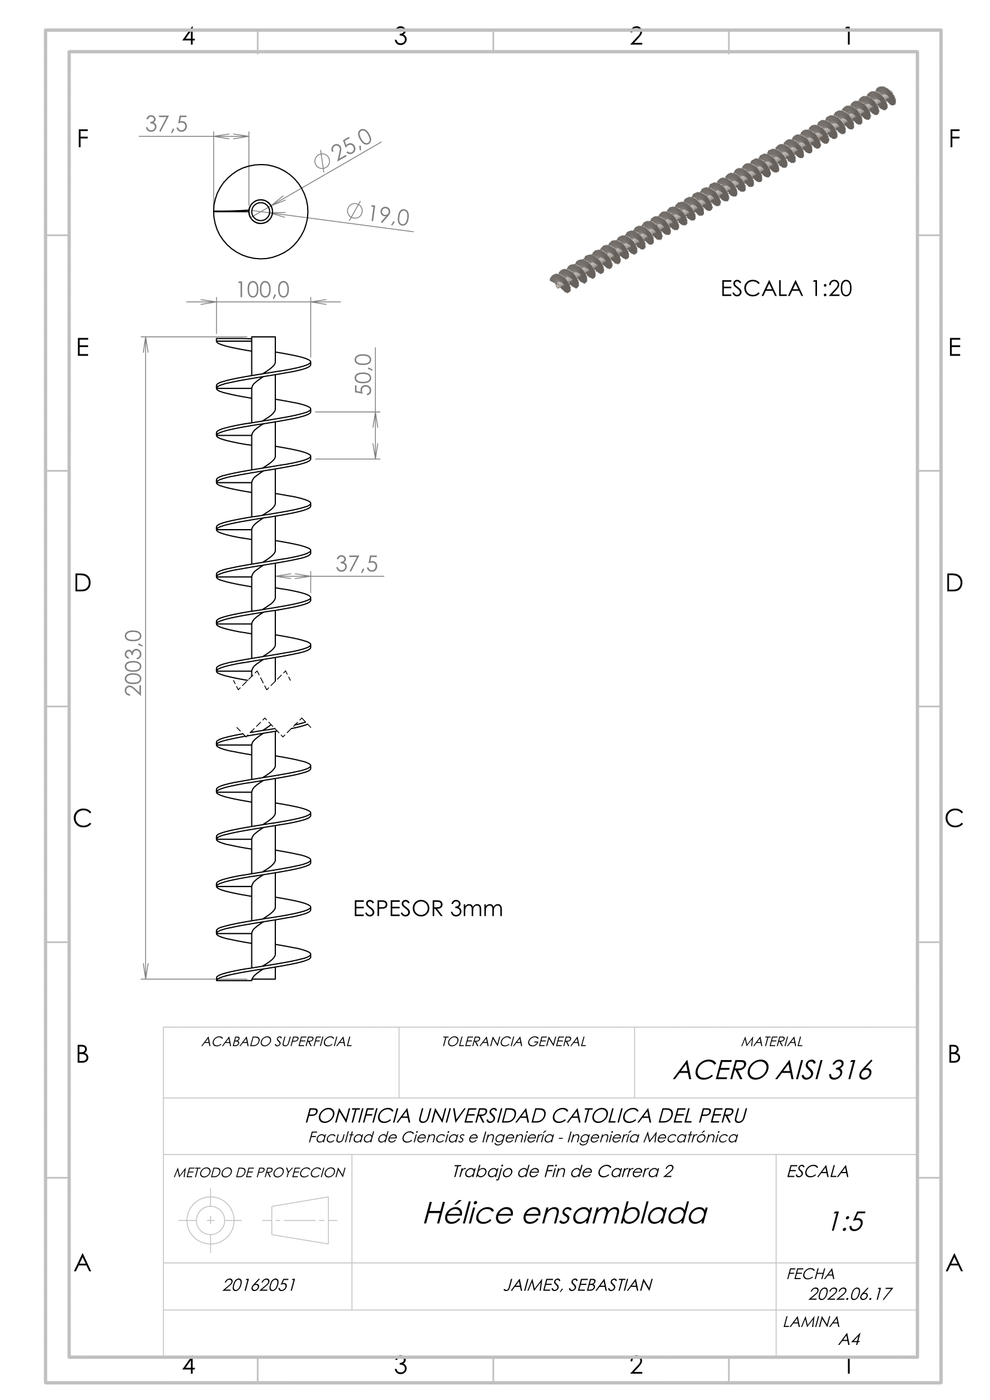
hardware/3d_models/2. Transporte/Planos en PNG/Hélice/Hélice-1.png
