Sebastian-Jaimes/EMC_IoT/hardware/3d_models/3. Dosificadora/Planos en PNG/Base Inferior de la caja/Base Inferior de la caja-1.png

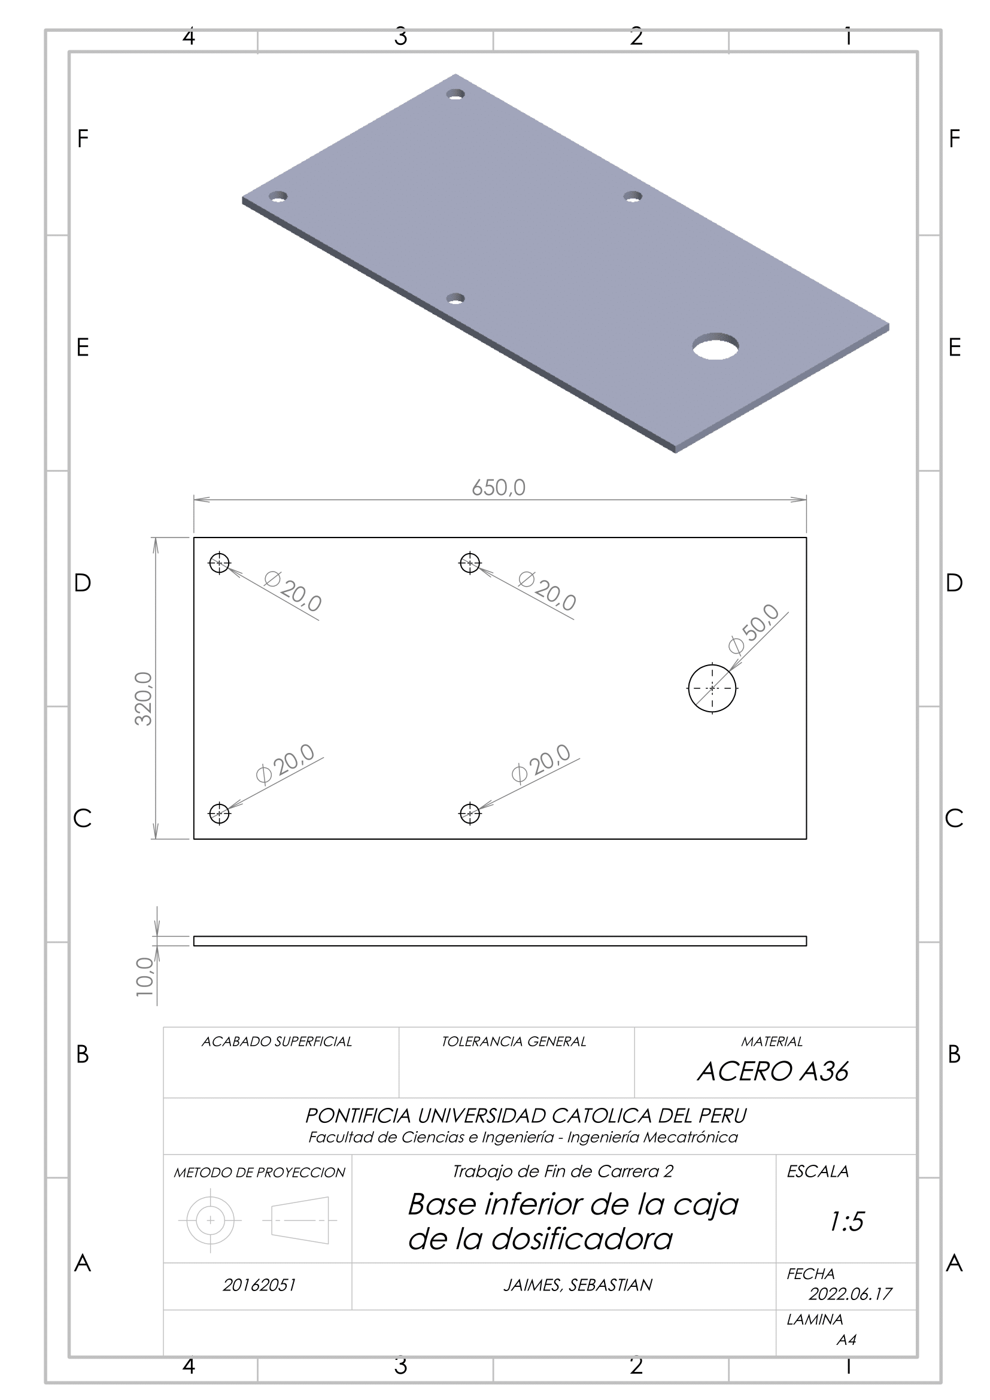
hardware/3d_models/3. Dosificadora/Planos en PNG/Base Inferior de la caja/Base Inferior de la caja-1.png
