Sebastian-Jaimes/EMC_IoT/hardware/3d_models/3. Dosificadora/Planos en PNG/Base/Base-1.png

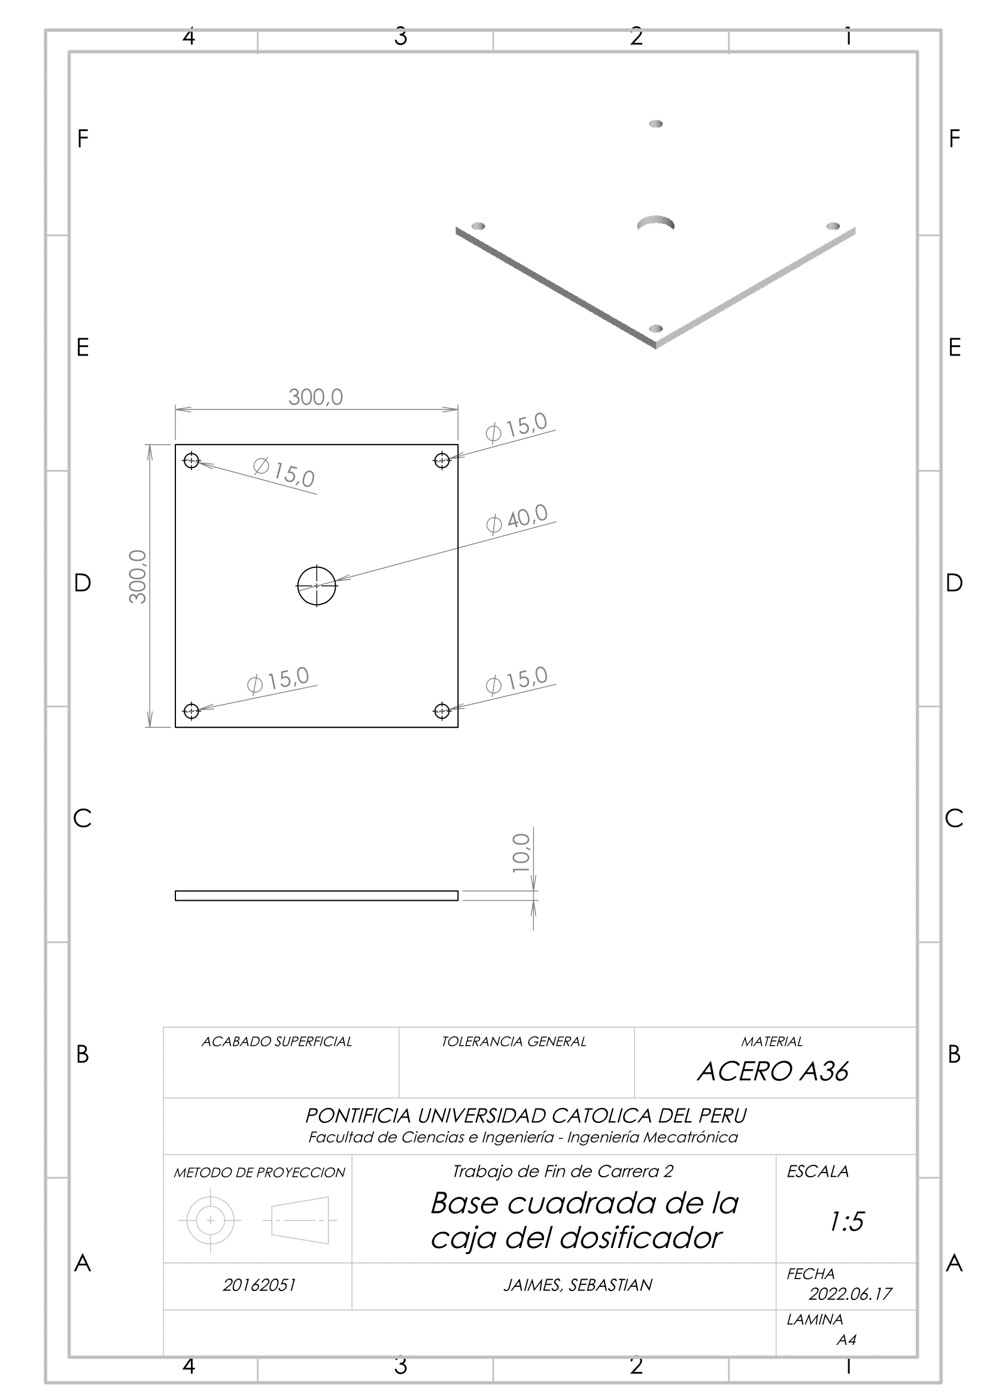
hardware/3d_models/3. Dosificadora/Planos en PNG/Base/Base-1.png
