Sebastian-Jaimes/EMC_IoT/hardware/3d_models/3. Dosificadora/Planos en PNG/Columna de caja base/Columna de caja base-1.png

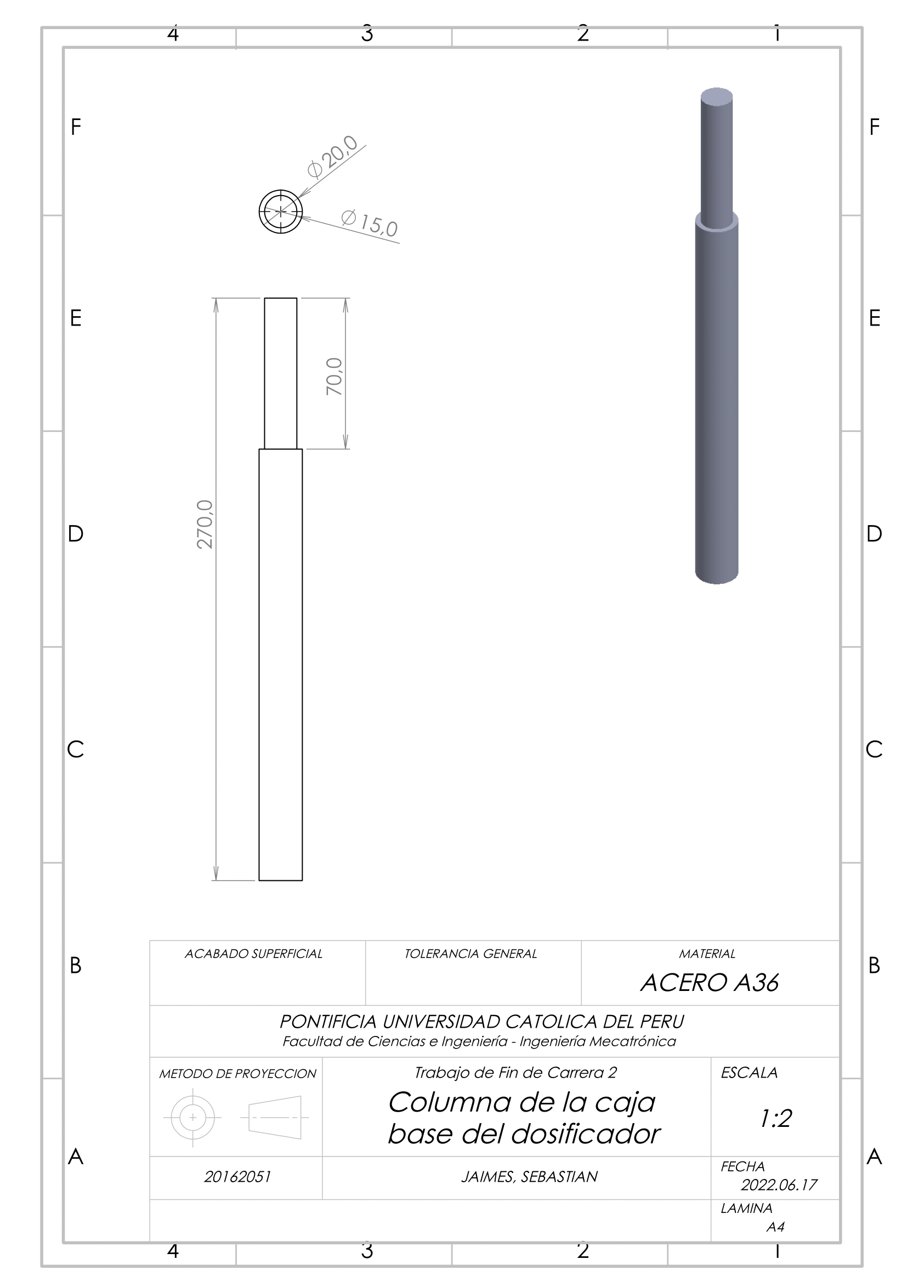
hardware/3d_models/3. Dosificadora/Planos en PNG/Columna de caja base/Columna de caja base-1.png
