Sebastian-Jaimes/EMC_IoT/hardware/3d_models/3. Dosificadora/Planos en PNG/Columna del dosificador/Columna del dosificador-1.png

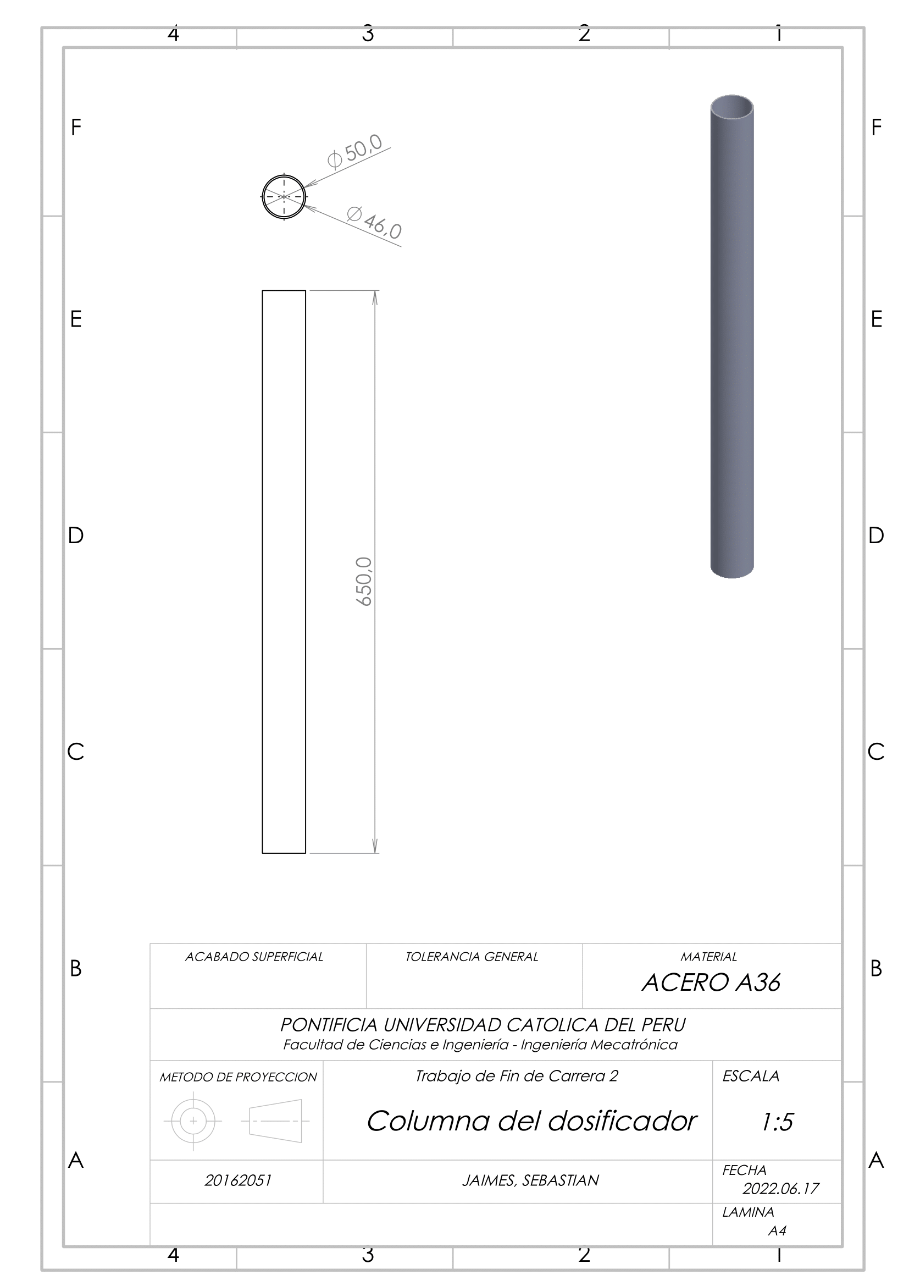
hardware/3d_models/3. Dosificadora/Planos en PNG/Columna del dosificador/Columna del dosificador-1.png
