Sebastian-Jaimes/EMC_IoT/hardware/3d_models/3. Dosificadora/Planos en PNG/Covertor de dosificador/Covertor de dosificador-1.png

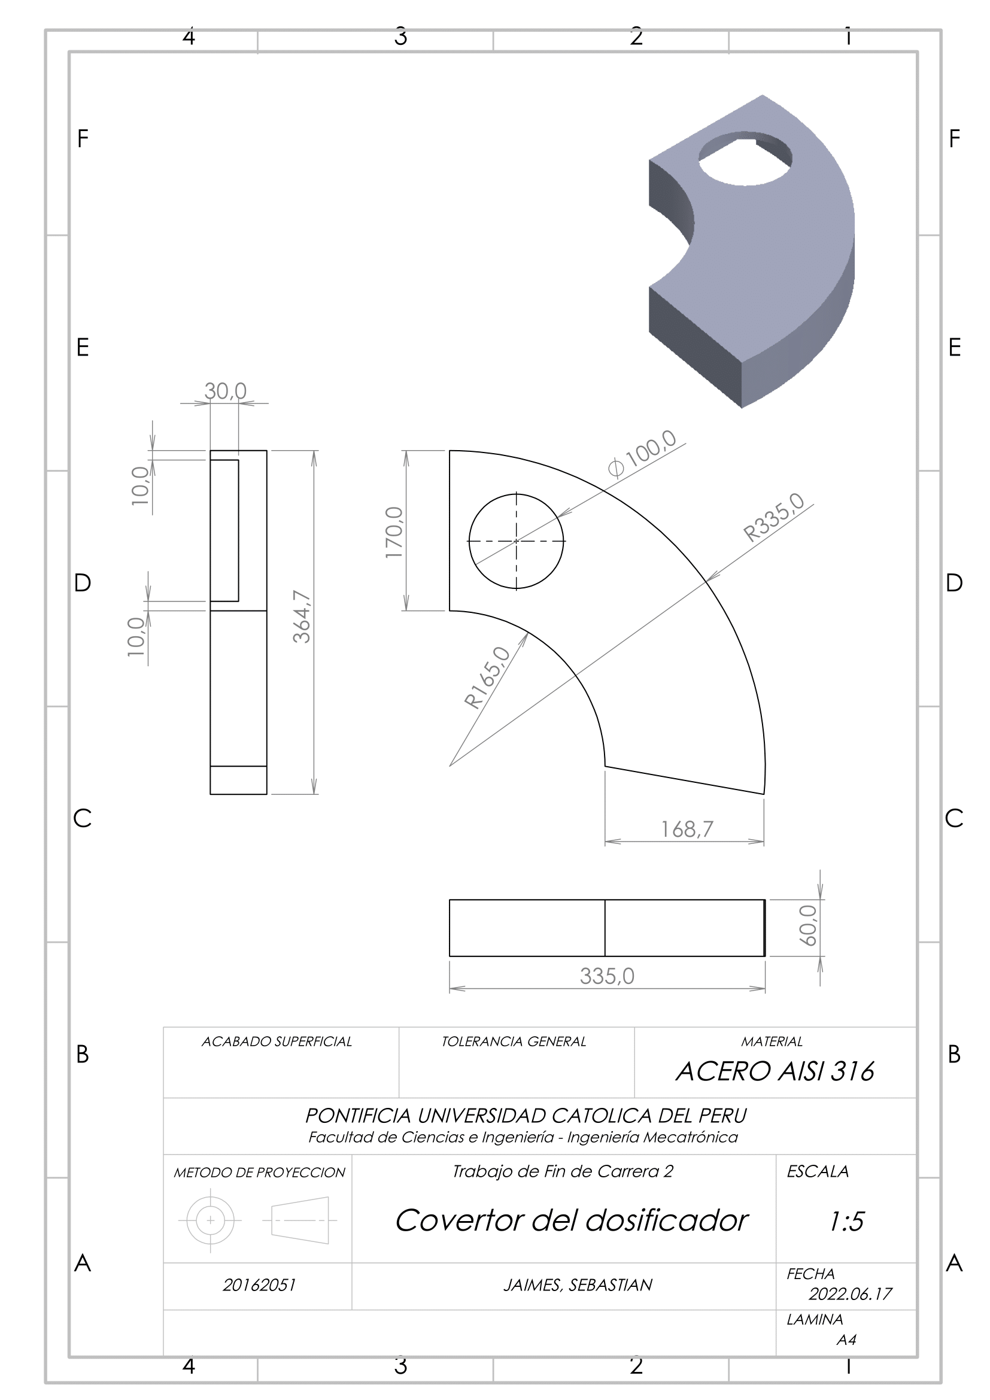
hardware/3d_models/3. Dosificadora/Planos en PNG/Covertor de dosificador/Covertor de dosificador-1.png
