Sebastian-Jaimes/EMC_IoT/hardware/3d_models/3. Dosificadora/Planos en PNG/Eje del dosificador/Eje del dosificador-1.png

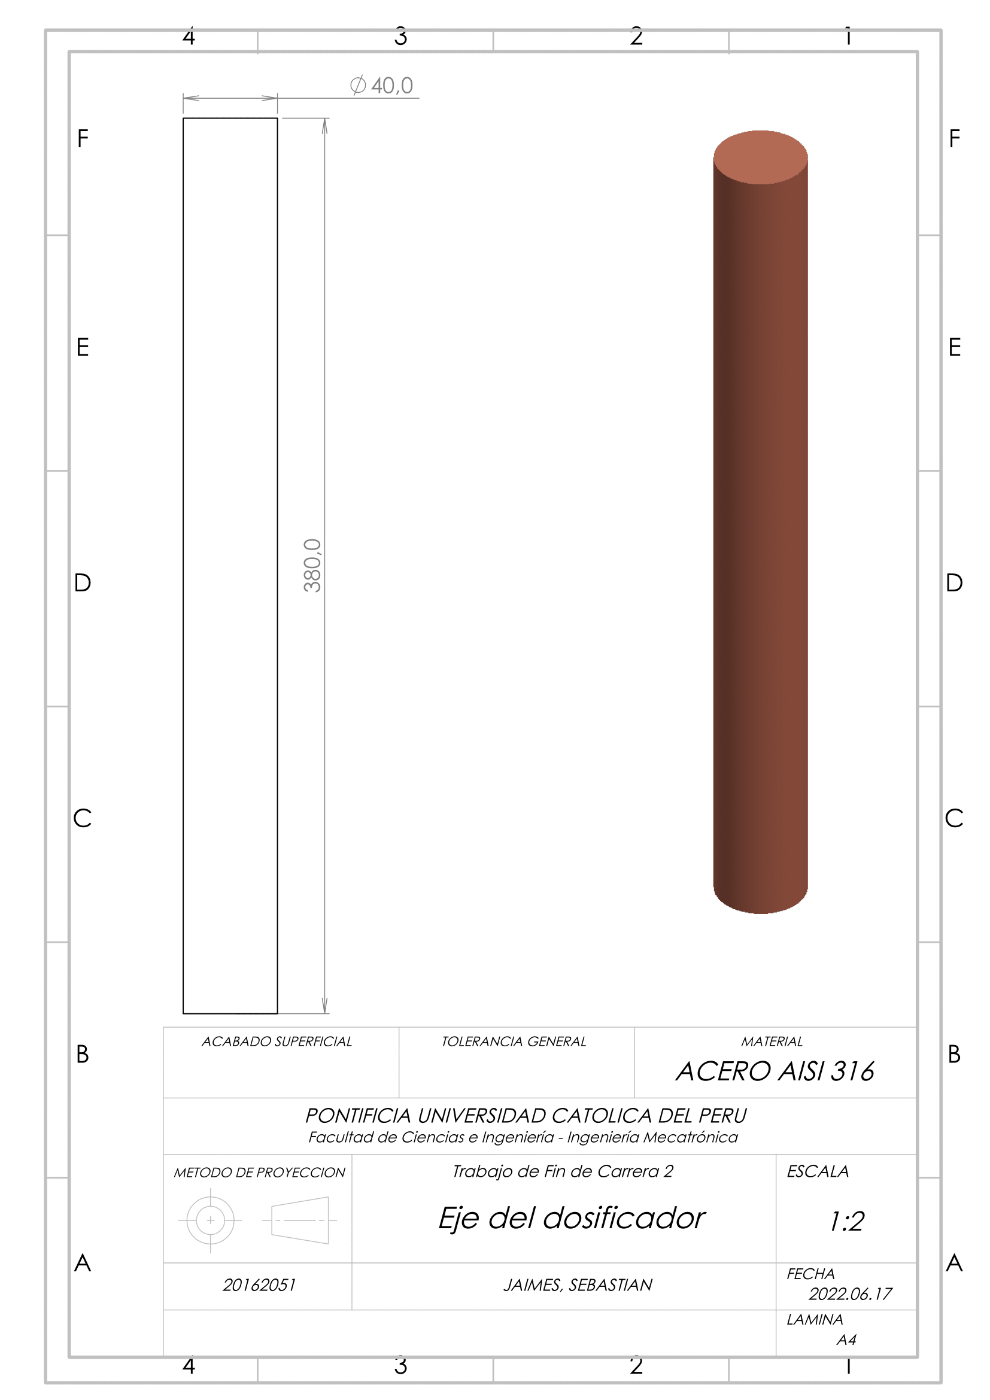
hardware/3d_models/3. Dosificadora/Planos en PNG/Eje del dosificador/Eje del dosificador-1.png
