Sebastian-Jaimes/EMC_IoT/hardware/3d_models/3. Dosificadora/Planos en PNG/Soporte para eje de dosificadora/Soporte para eje de dosificadora-1.png

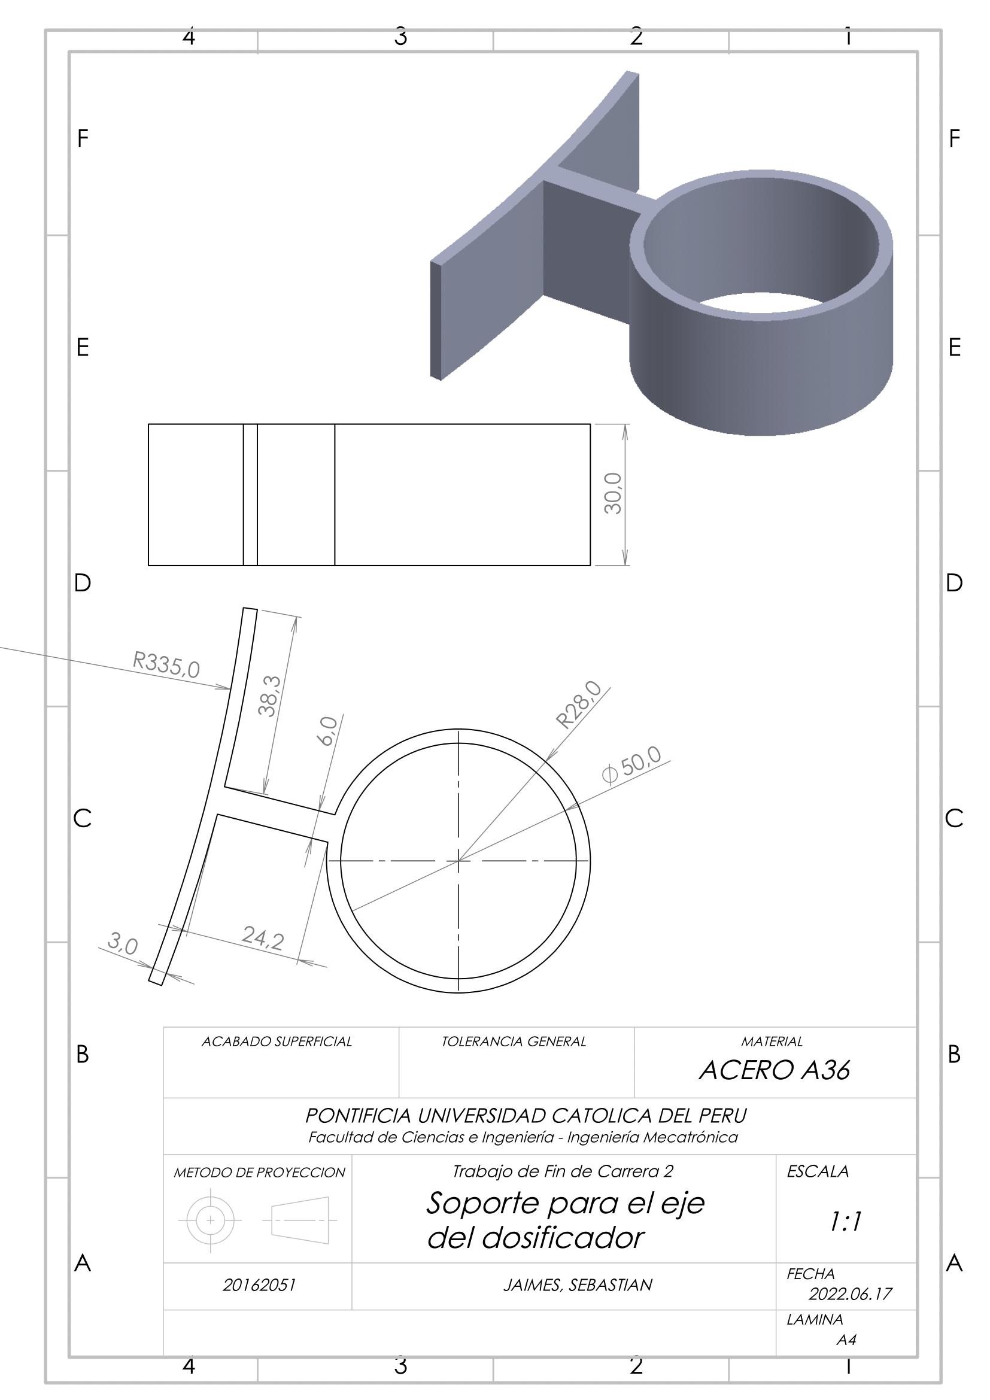
hardware/3d_models/3. Dosificadora/Planos en PNG/Soporte para eje de dosificadora/Soporte para eje de dosificadora-1.png
