Sebastian-Jaimes/EMC_IoT/hardware/3d_models/3. Dosificadora/Planos en PNG/Tapa de Vaso volumétrico/Tapa de Vaso volumétrico-1.png

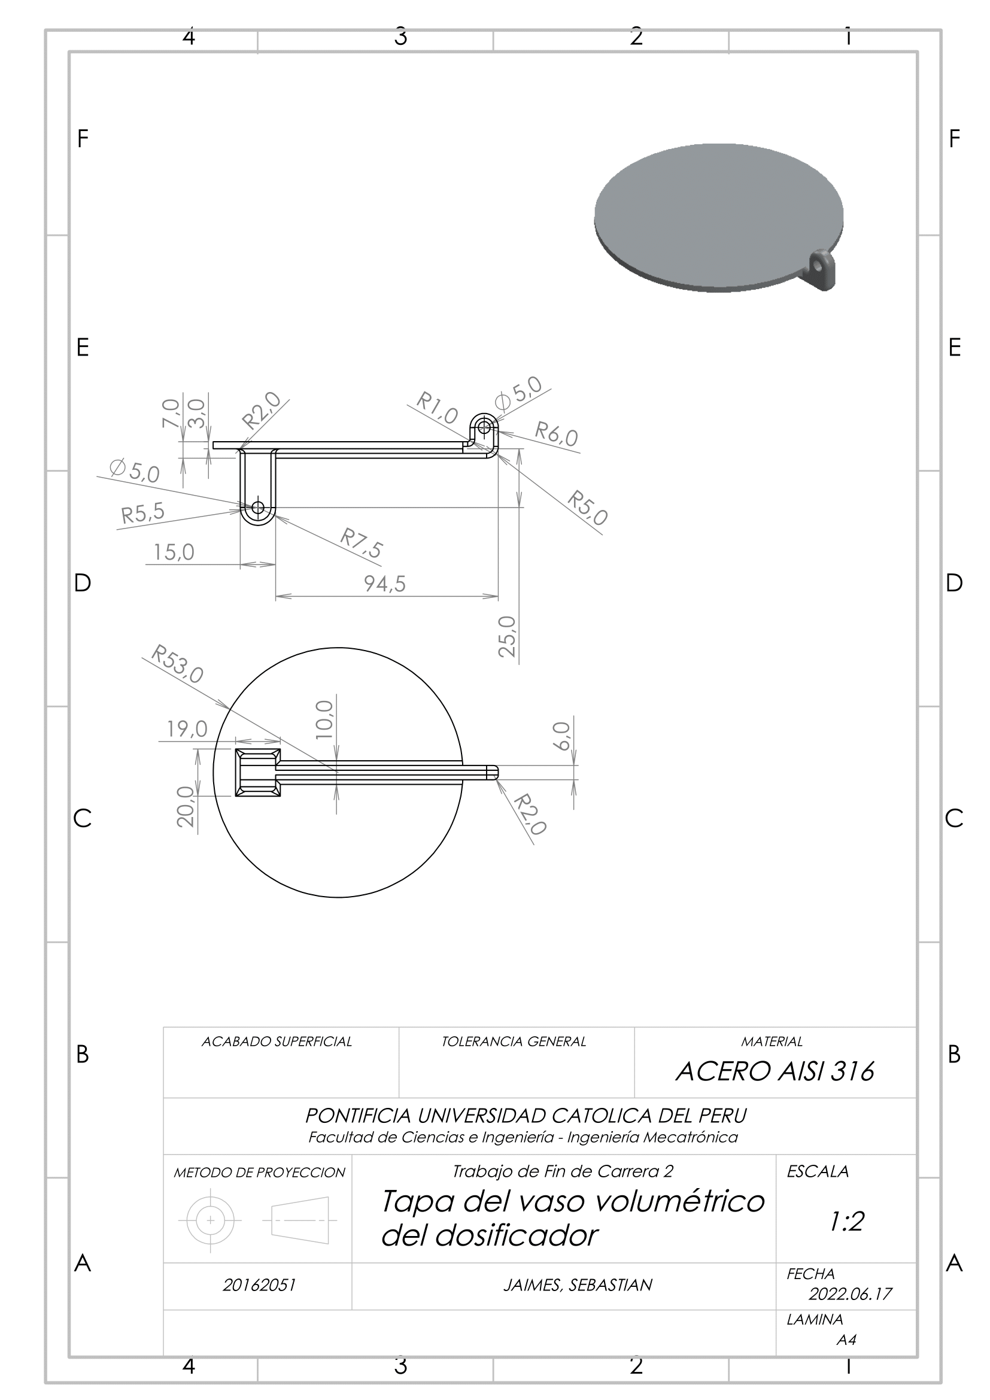
hardware/3d_models/3. Dosificadora/Planos en PNG/Tapa de Vaso volumétrico/Tapa de Vaso volumétrico-1.png
