Sebastian-Jaimes/EMC_IoT/hardware/3d_models/3. Dosificadora/Planos en PNG/Vaso volumétrico/Vaso volumétrico-1.png

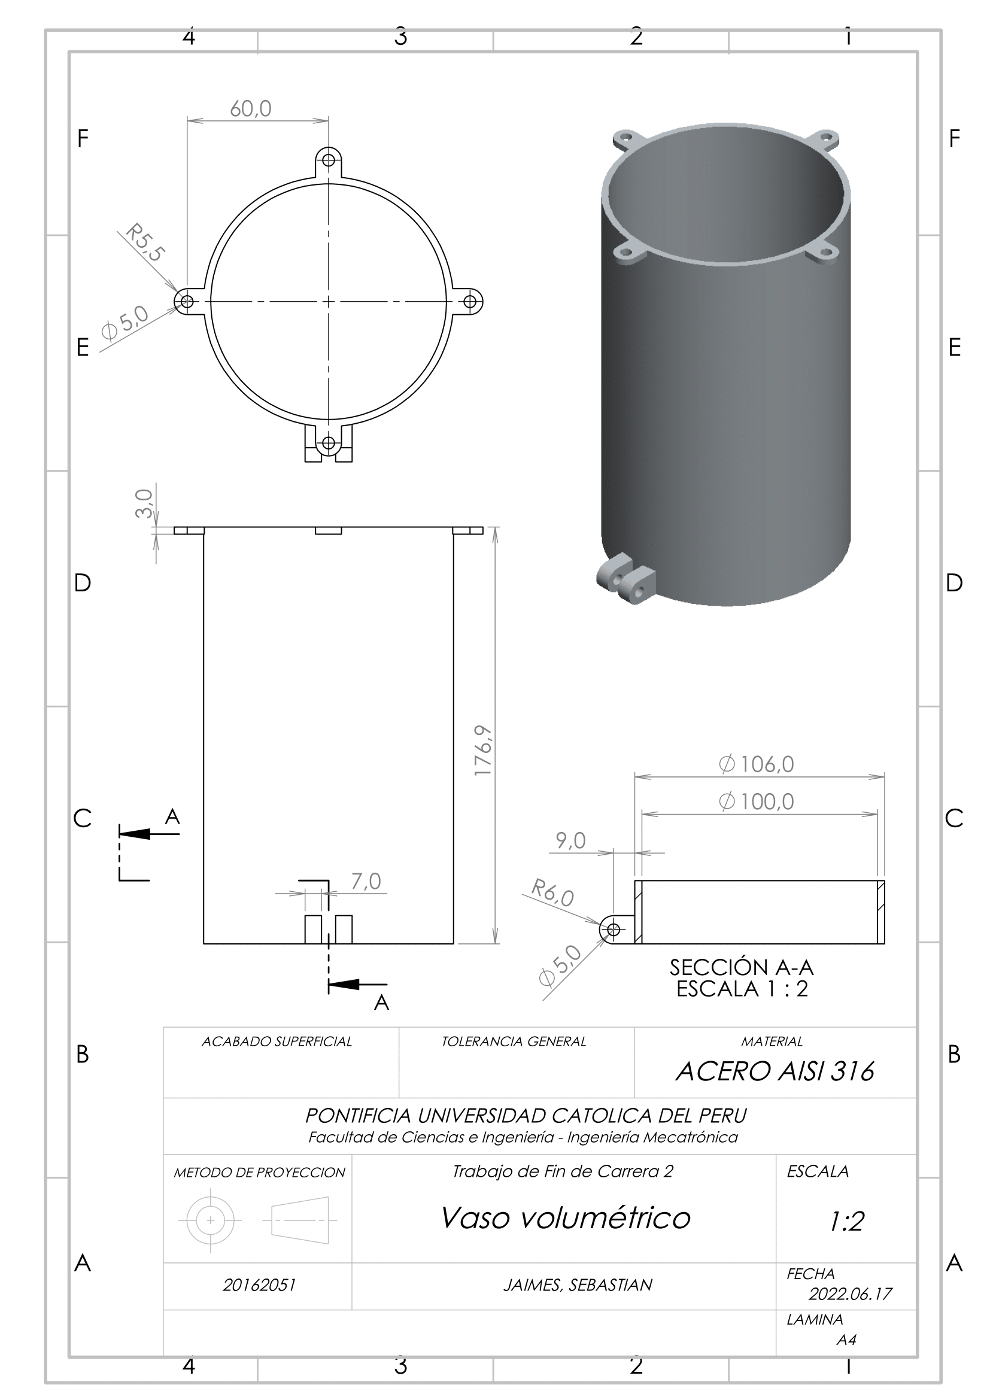
hardware/3d_models/3. Dosificadora/Planos en PNG/Vaso volumétrico/Vaso volumétrico-1.png
