Sebastian-Jaimes/EMC_IoT/hardware/drawings/Maquina_completa-1.png

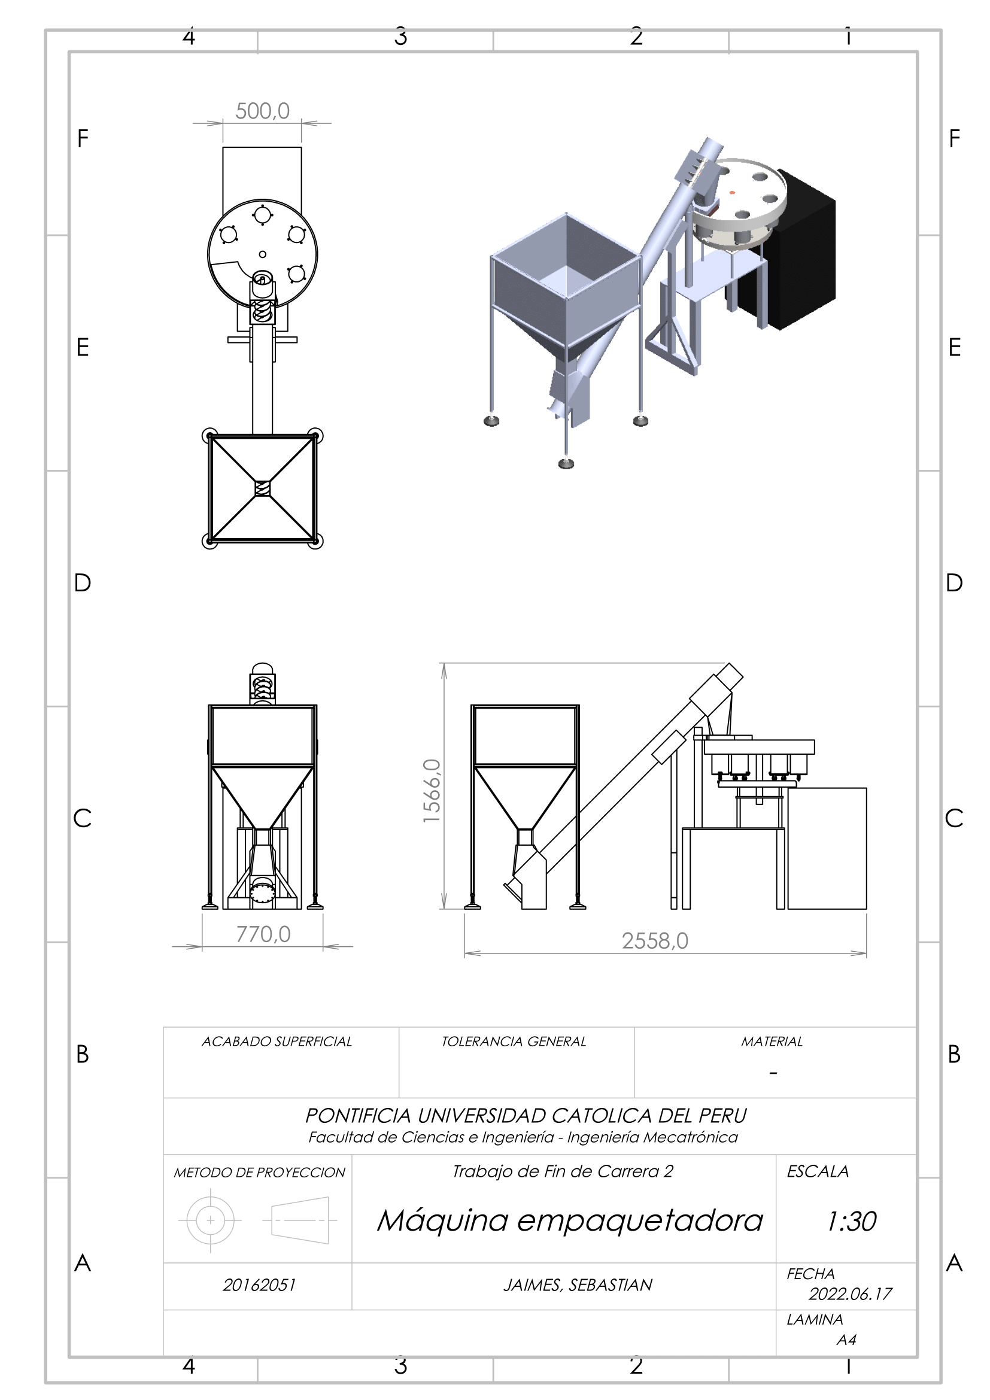
hardware/drawings/Maquina_completa-1.png
