Sebastian-Jaimes/EMC_IoT/hardware/drawings/Tolva/Goma de Soporte-1.png

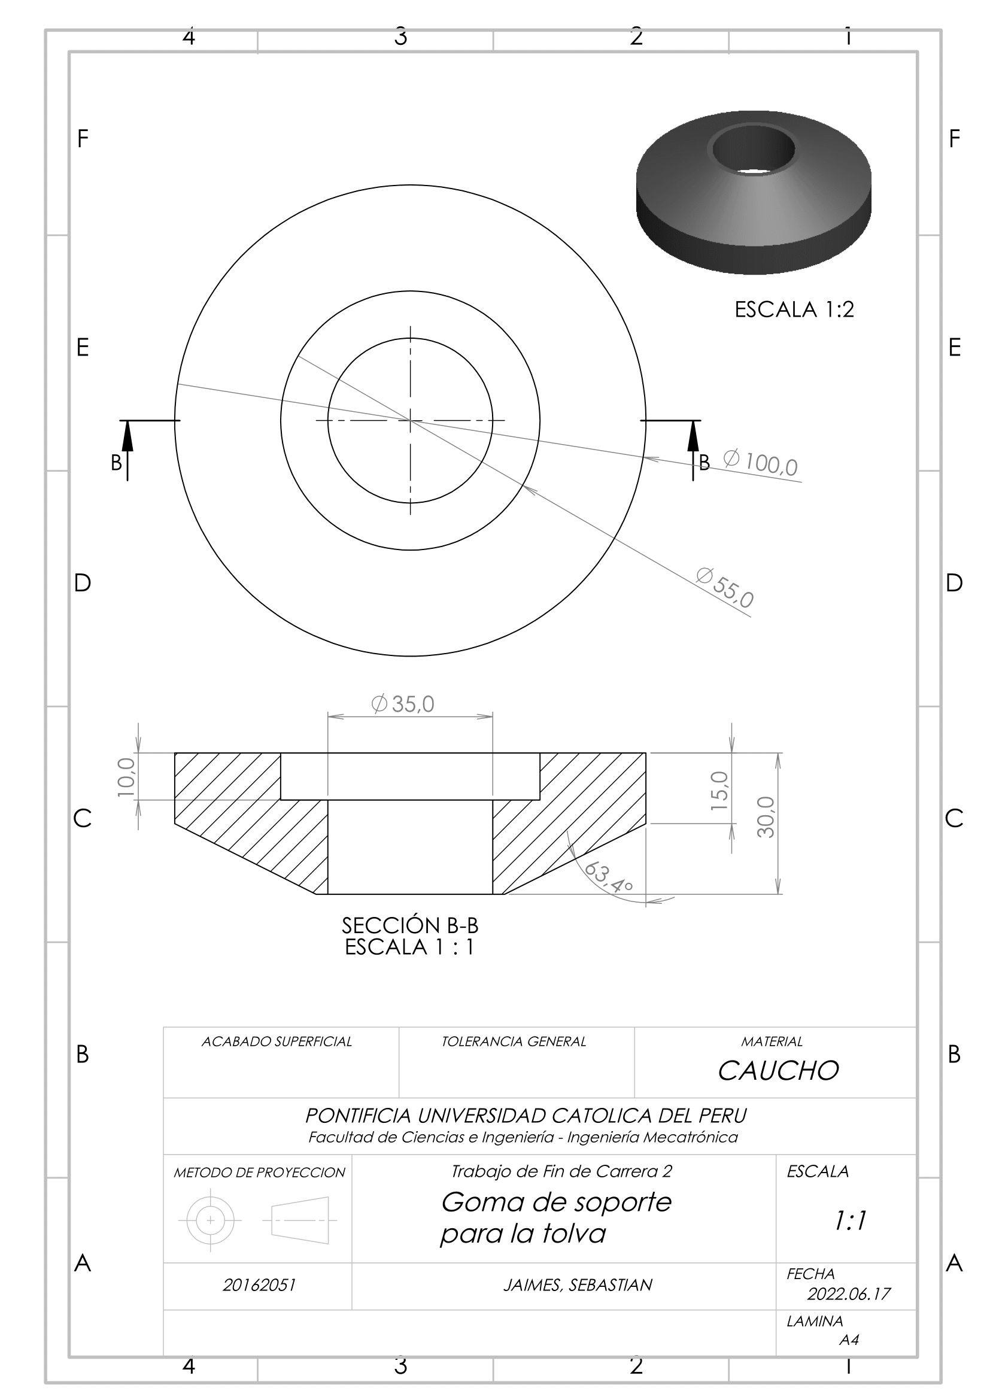
hardware/drawings/Tolva/Goma de Soporte-1.png
