Sebastian-Jaimes/EMC_IoT/hardware/drawings/Tolva/Tolva-1.png

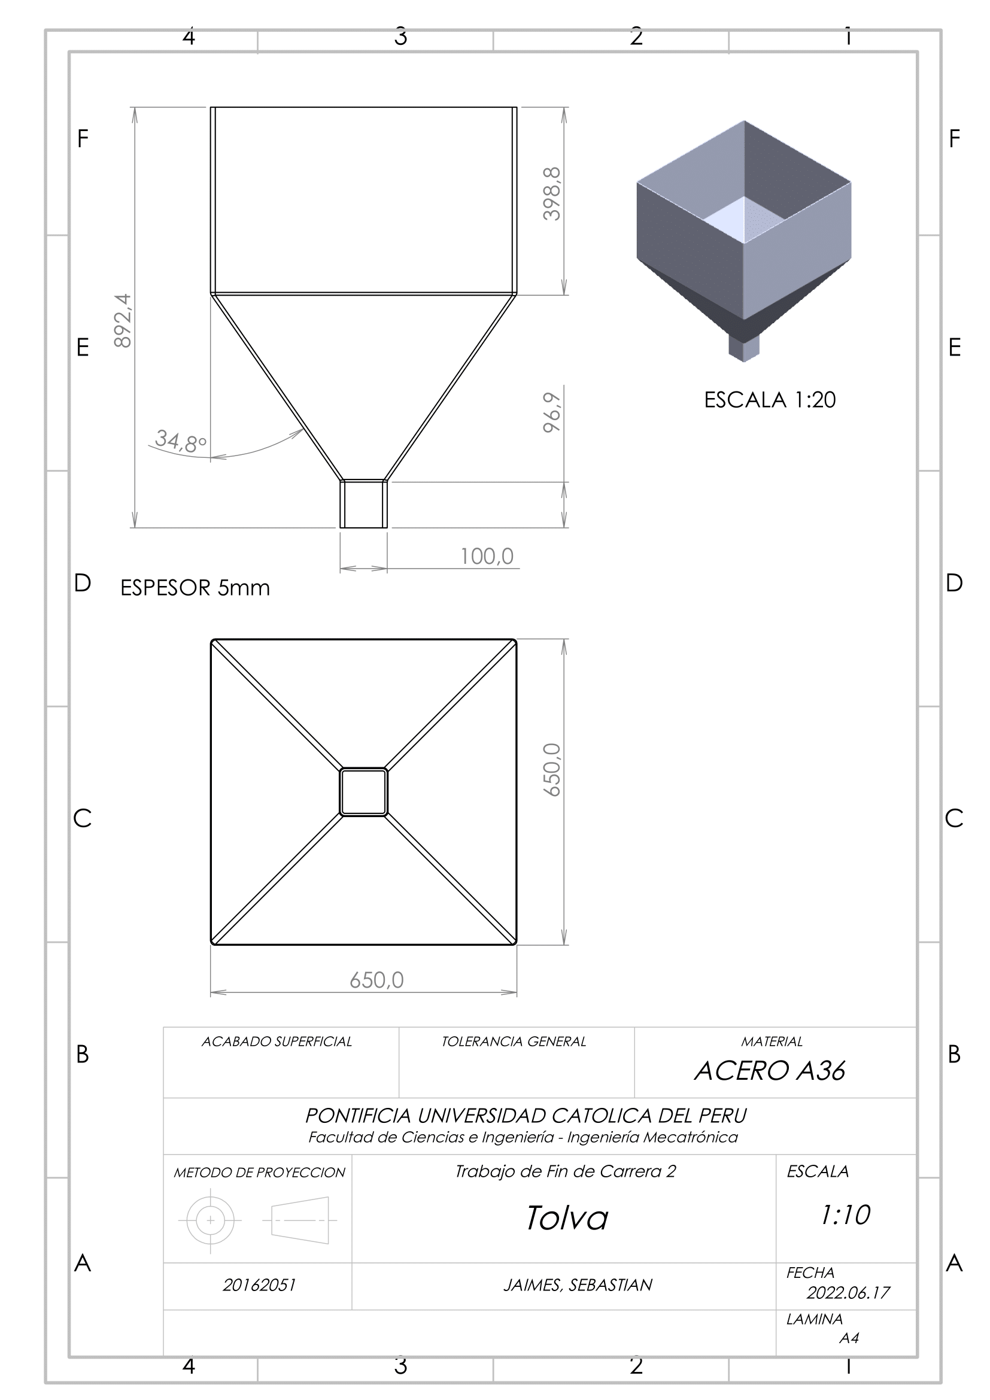
hardware/drawings/Tolva/Tolva-1.png
