Sebastian-Jaimes/EMC_IoT/hardware/drawings/Tolva/Tornillo roscado de sopote-1.png

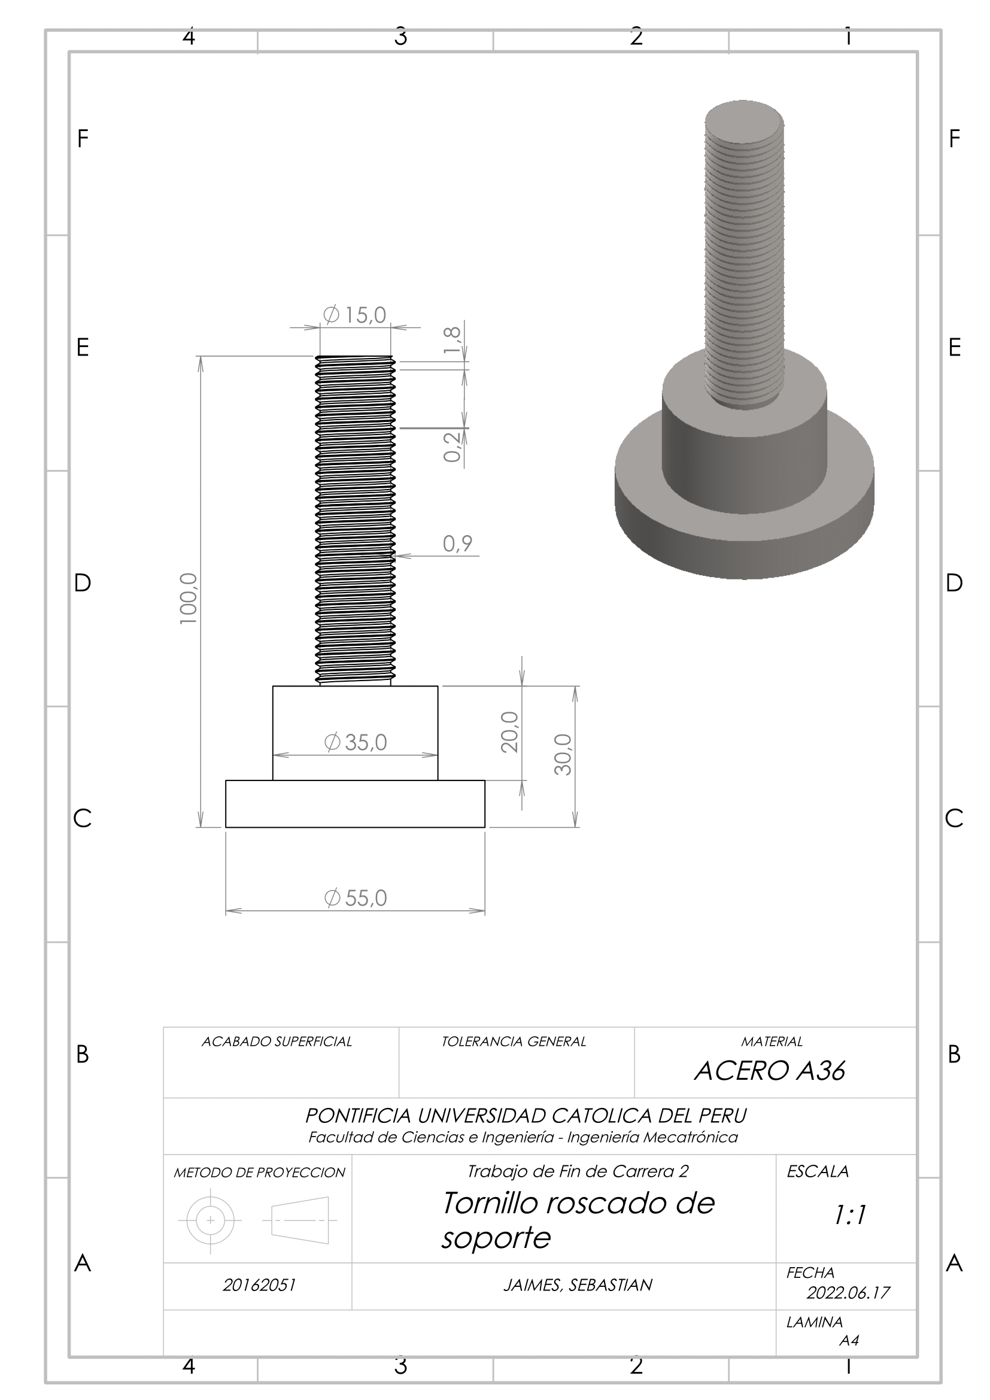
hardware/drawings/Tolva/Tornillo roscado de sopote-1.png
