Sebastian-Jaimes/EMC_IoT/docs/MDM/5. PROYECTO/Metodología del diseño mecatrónico- Grupo/Cálculo de motor.xlsx

Sheet: Sheet1
Masa | 72 | kg
Diámetro | 227 | mm
u estático | 1 |  | (Asumiendo fricción crítica = 1)
Peso del vehículo | 706.32
Numero de ruedas | 4
Peso por rueda | 176.58 | N
N | 176.58 | N
N*u s | 176.58 | N
coeficiente de rodadura (k) | ur/R | 0.05
ΣFx=0 | F-N*us=0
ΣFy=0 | m*g-R=0
ΣM0=0 | T-N*us*r-N*ur=0
 | T/r=N*us+N*k
 |  |  |  | Recuperado de: http://www.eet476.edu.ar/documentos/Aula%20Virtual/PORIFIRI-MANTYEQUIPOS-ACTV3.pdf
Torque | 21.0439215 | N*m
Velocidad lineal | 0.5 | m/s |  | Motor seleccionado: https://spanish.alibaba.com/product-detail/Micro-adjustable-speed-forward-and-reverse-1600089937114.html
w | 4.405286344 | rad/s
 | 42.06738584 | rpm
Potencia requerida | 92.7045 | W.
Eficiencia | 0.9
Potencia real | 103.005
 |  |  |  | Opción 2:
 |  |  |  | https://getliner.com/file/pdf/7QJ2ZBDM26A21G18KSCVA5C8XG

Sheet: Sheet2
Masa | 77.62 | kg
Diámetro | 227.00 | mm
u estático | 1.00 |  |  | El DCL es similar al de una rueda de bicicleta:
Peso del vehículo | 761.45 |  |  | https://nosinmibici.com/2015/10/11/la-resistencia-a-la-rodadura-neumatico-ancho-o-estrecho/
Numero de ruedas | 4.00
Peso por rueda | 190.36 | N
N | 190.36 | N
N*u s | 190.36 | N
coeficiente de rodadura (k) | ur/R | 0.05 | Recuperado de: https://www.scielo.br/j/eagri/a/vTPRWyyf7GJff6HrFqkycWK/?lang=es#
ΣFx=0 | F=Ff
ΣFy=0 | m*g-R=0
Para que no haya delizamiento, Fr<us*N |  | (Despreciando al mínimo)
ΣM0=0 | T-N*uR=0
 | T/r=N*k
T= | 1.080310309 | N.m
Factor de seguridad de 2 | 2.160620618 |  |  | Consutado: https://apuntes-ing-mecanica.blogspot.com/2015/05/titulo-friccion-subtitulo-friccion-por.html
Velocidad lineal | 0.5 | m/s
w | 4.405286344 | rad/s
 | 42.06738584 | rpm
Potencia requerida | 9.5181525 | W.
Eficiencia | 0.5
Potencia real | 19.036305

Sheet: Sheet3
Seleccion de motor |  |  |  |  |  | Motor |  |  | Motor
Torque | 2.001 | N.m | 20.41836735 | kg*cm |  | 16.38418079 | Nm |  | 16.38418079 | Nm
Velocidad | 43 | rpm |  |  |  | 900 | rpm |  | 900 | rpm
 | 4.405286344 | rad/s | 264.3171806 | rad/min |  |  |  |  | 85920 | rad/s | 4048884.612 | 142
Potencia | 8.82 | w |  |  |  | 0.55 | hp | 184.635 | 16.9 | w
 |  |  |  |  |  | https://www.robotmarketplace.com/products/0-pdx26.html
 |  |  |  |  |  |  |  |  | Motor
 |  |  |  |  |  | Motor |  |  | 0.13 | Nm
 |  |  |  |  |  | 10.28248588 | Nm |  | 1500 | rpm
 |  |  |  |  |  | 1500 | rpm
 |  |  |  |  |  |  |  |  | 20 | w
 |  |  |  |  |  | 0.55 | hp | 184.635
 |  |  |  |  |  | 1
 |  |  |  |  | Power | 10 | W
 |  |  |  |  |  | 1250 | rpm
 |  |  |  |  |  | 0.6 kg.cm
 |  |  |  |  |  | reduccion de 34 a 1

Sheet: Sheet4
Componentes | Componente | Modelo | Cantidad | Voltaje típico (V) | Amperaje (A) | Potencia de consumo (W)
 | Microcontrolador maestro | Arduino Mega 2560 | 1.00 | 5.00 | 0.04 | 0.20
 | Microcontrolador esclavo | Raspberry | 1.00 | 5.00 | 0.04 | 0.20
 | Módulo wifi | ESP-01 ESP8266 WIFI-SERIAL | 1.00 | 3.30 | 0.21 | 0.71
 | Lidar | TeraRanger Evo 3m ToF Rangefinder | 1.00 | 6.00 | 0.07 | 0.42
 | IMU | IMU - MPU6050 | 1.00 | 3.30 | 0.002 | 0.01
 | Encoder | Grove Optical Rotary Encode | 4.00 | 5.00 | 0.50 | 10.00
 | Motor DC | Motorreductor PDX26 | 4.00 | 12.00 | 1.50 | 18.00
 | Cámara | ESP32-CAM | 1.00 | 5.00 | 0.18 | 0.90
 | Electrobolla | XKC-Y28-NC | 1.00 | 5.00 | 0.01 | 0.07
 | Bomba de agua | RS-385 | 1.00 | 12.00 | 0.70 | 8.40
 | Total |  |  |  |  | 38.90
 | FS=2 |  |  |  | 3.26 | 58.35165
 |  |  |  |  |  | 24.3131875 | ah
 |  |  |  |  |  | 291.75825 | wh
 |  |  |  |  |  | Bateria de golf | https://www.hdibattery.com/p11802677_bateria-de-litio-para-carro-de-golf-12v-24ah-kit-de-carga-36-45-hoyos-eco-batt.html
