Sebastian-Jaimes/EMC_IoT/docs/MDM/5. PROYECTO/Metodología del diseño mecatrónico- Grupo/Cálculo Patas.xlsx

Sheet: PATAS
Materiales. | Cantidad | Volumen | Unidades | Peso | Unidades
Cámara | 1 | - | - | 0.2 | Kg | VERIFICACIÓN: | Para evitar inelasticidad del material
Tanque | 1 | 40 | L | 40 | Kg |  | Valor | Unidades |  | Valor | Unidades
Lidar | 1 | - | - | 0.2 | Kg | Faplicada | 190.345 | N | Longitud | 510 | mm
Botón | 2 | - | - | 0.16 | Kg | Res_tracción máxima | 290 | MPa | Área | 783 | mm^2
Led | 2 | - | - | 0.004 | Kg | Propiedades del material |  |  | I | 2222741.2 | mm^4
Perfil A | 2 | 0.000308 | m3 | 0.831 | Kg | E (Módulo de elasticidad) | 70 | GPa | Radio de giro | 53.280 | mm
Perfil B | 2 | 0.000163 | m3 | 0.440 | Kg | Limite elastico | 250 | MPa | Grado de esbeltez | 9.572
Base acrílica | 1 | 2.984050 | (área) | 11.411 | Kg
Perfiles largos C | 8 | 0.002527 | m3 | 6.823 | Kg | Fs | 10
Perfiles cortos D | 4 | 0.000349 | m3 | 0.943 | Kg | σ admisible | 25.000
Batería | 1 | - | - | 5 | Kg
Circuitería | 1 | - | - | 2 | Kg
Electrobomba | 1 | - | - | 5 | Kg
Otros | 1 | - | - | 5 | Kg
 |  |  | TOTAL | 77.613 | Kg
 |  |  |  |  |  | 190.345 | < | 19575 | N | SE CUMPLE!
 |  | Valor | Unidades
Fuerza Total | 4F | 761.379 | N |  |  | 2.Segunda parte
Fuerza que soportará una pata | F | 190.345 | N |  |  | 190.345 | < | 5903999.91 | N | SE CUMPLE!
Angulo | 74 | cos(74) | 0.276 | Fx | 52.466
 |  | sen(74) | 0.961 | Fy | 182.971

Sheet: Selección de materiales
Tipo | Dureza | Resistencia a la corrosión | Magnéticos | Endurecibles por tratamiento térmico | Soldabilidad |  | Características | Fabricante | Central do Brasil U954 | - | Importado
Martensíticos | Alta | Baja | Si | Si | Pobre |  |  | Modelo | Rojo Motor Estrella & Stop interruptor de botón | Pulsador Liviano rojo (XB7-EA2) | Pulsador Negro
Ferríticos | Medio baja | Regular | Si | No | Limitada |  |  | Requisitos |  |  |  |  | Pulsador Liviano Rojo
Austeníticos | Alta | Excelente | No | No | Excelente |  | Corriente de alimentación | 0.5 mA a 10mA | 0.8 mA | 1 mA | 3.5mA |  | Modelo XB7 - EA2
 |  |  |  |  |  |  | Uso | No definido | Boton | Pulsador | Pulsador
 |  |  |  |  |  |  | Diámetro | menor o igual a 5 cm | 3.5 cm | 2 cm | - |  | voltaje
 |  |  |  |  |  |  | Precio máximo (S/.) | menor a 20 | 18 | 2021-09-07 | 2021-09-16 |  | Pulsador Minimal Negro
Estructura
Alternativas | Resistencia a la corrosión | Resistencia a la deformación | Facilidad de implementación | Soldabilidad | Costo
Acero | Alta | Alta | Media | Alta | Medio alto
Acero al carbono | Alta | Alta | Media | Alta | Medio alto
Acero inoxidable | Excelente | Excelente | Media alta | Alta | Alto
Aluminio | Medio alta | Medio alta | Alta | Alta | Bajo |  |  |  |  |  | Características | Modelo | ESP-01 ESP8266 WIFI-SERIAL | ESP-WROOM-32-ESP32 WIFI | ESP-12E ESP8266 WIFI | WEMOS D1 MINI ESP8266 WIFI
Aleaciones de magnesio | Medio baja | Media | Media | Medio alta | Medio bajo
 |  |  |  |  |  |  |  |  |  |  |  | Requisitos
 |  |  |  |  |  |  |  |  |  |  | Consumo de potencia | <1mW | 0.8mW | 0.7mW | - | 0.75mW
 |  |  |  |  |  |  |  |  |  |  | Voltaje de alimentación (máx) | 10 VDC | 3.3 VDC | 3.3 VDC | 3.3 VDC | 5 VDC
Eje |  |  |  |  |  |  |  |  |  |  | Precio máximo (S/.) | menor a 30 | 20 | 40 | 18 | 25
Alternativas | Resistencia a la corrosión | Resistencia a la deformación | Resistencia a fatiga | Facilidad de implementación | Soldabilidad | Costo
Acero de bajo carbono | Alta | Alta | Media | Media | Alta | Bajo
Acero de medio carbono | Alta | Alta | Media | Media | Alta | Bajo
Acero inoxidable | Excelente | Excelente | Alta | Media | Alta | Alto
Carcasa
Alternativas | Resistencia a impactos | Maleabilidad | Peso | Costo
Laminas de acrílico | Alta | Excelente | Medio | Medio
Policarbonato (PC) | Alta | Alta | Medio | Bajo
Cloruro de polivinilo (PVC) | Medio alta | Alto | Medio alto | Bajo
Vidrio | Bajo | Bajo | Alta | Alto
