Sebastian-Jaimes/EMC_IoT/docs/MDM/5. PROYECTO/Metodología del diseño mecatrónico- Grupo/Presupuesto.xlsx

Sheet: Sheet1
Presupuesto de carcasa y chasis del vehículo
Componente | Cantidad | P.unit (S/.) | Importación (S/.) | Total (S/.) |  | Operación | Costo total
Perfil 50x50 espesor 3mm. Aleación Aluminio-Acero. Largo 3m. | 4 | S/.80.00 | S/.0.00 | S/.320.00 |  | Torneado de ejes | S/.120.00 | 6 euros por pieza
Perfil 50x50 espesor 3 mm. Aleación Aluminio-Acero. Largo 3m. | 2 | S/.80.00 | S/.0.00 | S/.160.00 | para patas | Fundicion (para acoples) | S/.480.00
Acrílico. Plancha de 1.23 x 1.83 m. Espesor 3 mm. | 4 | S/.147.00 | S/.0.00 | S/.588.00 |  | Impresion de PCB | S/.163.20
Barra de acero inoxidable A36 (diámetro 20 mm). Largo 1 m | 2 | S/.97.00 | S/.0.00 | S/.194.00 | acople para fundicion + ejes | Total | S/.763.20
Perno M10x55mm | 16 | S/.4.00 |  | S/.64.00
Tuerca M10 | 56 | S/.0.50 |  | S/.28.00 |  | Desarrollo de software | 1000
Perno M10x70mm | 56 | S/.4.50 |  | S/.252.00
Rodamiento rígido de bolas (10PCS/TUBE) | 1 | S/.32.99 | S/.8.00 | S/.40.99
Llantas | 4 | S/.20.00 | S/.0.00 | S/.80.00
Total |  |  |  | S/.1726.99
Presupuesto del sistema de rociado
Componente | Cantidad | P.unit (S/.) | Importación (S/.) | Total (S/.)
Tanque de pesticida | 1 | S/.49.00 | S/.0.00 | S/.49.00
Tubo PVC diámetro 1/2'' x 1m | 1 | S/.12.00 | S/.0.00 | S/.12.00
Codo 1/2'' x 90° | 2 | S/.2.00 | S/.0.00 | S/.4.00
Manguera diámetro 1/2'' | 1 | S/.2.80 | S/.0.00 | S/.2.80
Bomba | 1 | S/.17.00 | S/.0.00 | S/.17.00
Servomotor | 2 | S/.12.00 | S/.0.00 | S/.24.00
Electrobolla | 1 | S/.31.68 | S/.0.00 | S/.31.68
Rele | 1 | S/.13.50 | S/.0.00 | S/.13.50
CÁMARA ESP 32 | 1 | S/.48.00 | S/.0.00 | S/.48.00
Total |  |  |  | S/.153.98
Presupuesto del sistema de navegación
Componente | Cantidad | P.unit (S/.) | Importación (S/.) | Total (S/.)
Lidar 2D TeraRanger Evo 3m ToF Rangefinde | 1 | S/.62.54 | S/.18.00 | S/.80.54
IMU - MPU6050 | 1 | S/.15.50 | S/.0.00 | S/.15.50
Encoder TCUT1600X01 | 4 | S/.33.00 | S/.0.00 | S/.132.00
Motorreducto PDX26 | 4 | S/.343.00 | S/.120.00 | S/.1492.00
Driver motor L298N | 4 | S/.12.00 | S/.0.00 | S/.48.00
Total |  |  |  | S/.1768.04
Presupuesto del sistema de control y comunicación
Componente | Cantidad | P.unit (S/.) | Importación (S/.) | Total (S/.)
Arduino Mega 2560 Pro | 1 | S/.65.00 | S/.0.00 | S/.65.00
Raspberry Pi 4 | 1 | S/.484.00 | S/.0.00 | S/.484.00
Módulo Wi-Fi ESP8266 WIFI-SERIA | 1 | S/.20.00 | S/.0.00 | S/.20.00
Pulsador Liviano rojo (XB7-EA2) | 1 | S/.7.90 | S/.0.00 | S/.7.90
Total |  |  |  | S/.576.90
Presupuesto del sistema de energía
Componente | Cantidad | P.unit (S/.) | Importación (S/.) | Total (S/.)
Batería de litio para Carros de Golf-Eco-Batt 4.0LifePO4 | 1 | S/.1203.00 | S/.530.00 | S/.1733.00
Total |  |  |  | S/.1733.00
Total |  |  |  | S/.5958.91
Ítem | Costo total
Carcasa y chasis del vehículo | S/.1726.99
Sistema de rociado | S/.153.98
Sistema de navegación | S/.1768.04
Sistema de control y comunicación | S/.576.90
Sistema de energía | S/.1733.00
Fabricación | S/.763.20
Diseño | S/.3000.00
Total | S/.9722.11

Sheet: Copy of Sheet1
Presupuesto de carcasa y chasis del vehículo
Componente | Cantidad | P.unit (S/.) | Importación (S/.) | Total (S/.) |  | Operación | Costo total
Perfil 50x50 espesor 3mm. Aleación Aluminio-Acero. Largo 3m. | 4 | S/.80.00 | S/.0.00 | S/.320.00 |  | Torneado de ejes | S/.120.00
Perfil 50x50 espesor 3 mm. Aleación Aluminio-Acero. Largo 3m. | 2 | S/.80.00 | S/.0.00 | S/.160.00 | para patas | Fundicion (para acoples) | S/.480.00
Acrílico. Plancha de 1.23 x 1.83 m. Espesor 3 mm. | 4 | S/.147.00 | S/.0.00 | S/.588.00 |  | Impresion de PCB | S/.163.20
Barra de acero inoxidable A36 (diámetro 20 mm). Largo 1 m | 2 | S/.97.00 | S/.0.00 | S/.194.00 | acople para fundicion + ejes | Total | S/.763.20
Perno M10x55mm | 16 | S/.4.00 |  | S/.64.00
Tuerca M10 | 56 | S/.0.50 |  | S/.28.00 |  | Desarrollo de software | 1000
Perno M10x70mm | 56 | S/.4.50 |  | S/.252.00
Rodamiento rígido de bolas (10PCS/TUBE) | 1 | S/.32.99 | S/.8.00 | S/.40.99
Llantas | 4 | S/.20.00 | S/.0.00 | S/.80.00
Total |  |  |  | S/.1726.99
Presupuesto del sistema de rociado
Componente | Cantidad | P.unit (S/.) | Importación (S/.) | Total (S/.)
Tanque de pesticida | 1 | S/.49.00 | S/.0.00 | S/.49.00
Tubo PVC diámetro 1/2'' x 1m | 1 | S/.12.00 | S/.0.00 | S/.12.00
Codo 1/2'' x 90° | 2 | S/.2.00 | S/.0.00 | S/.4.00
Manguera diámetro 1/2'' | 1 | S/.2.80 | S/.0.00 | S/.2.80
Bomba | 1 | S/.17.00 | S/.0.00 | S/.17.00
Servomotor | 2 | S/.12.00 | S/.0.00 | S/.24.00
Electrobolla | 1 | S/.31.68 | S/.0.00 | S/.31.68
Rele | 1 | S/.13.50 | S/.0.00 | S/.13.50
CÁMARA ESP 32 | 1 | S/.48.00 | S/.0.00 | S/.48.00
Total |  |  |  | S/.153.98
Presupuesto del sistema de navegación
Componente | Cantidad | P.unit (S/.) | Importación (S/.) | Total (S/.)
Lidar 2D TeraRanger Evo 3m ToF Rangefinde | 1 | S/.62.54 | S/.18.00 | S/.80.54
IMU - MPU6050 | 1 | S/.15.50 | S/.0.00 | S/.15.50
Encoder TCUT1600X01 | 4 | S/.33.00 | S/.0.00 | S/.132.00
Motorreducto PDX26 | 4 | S/.343.00 | S/.120.00 | S/.1492.00
Driver motor L298N | 4 | S/.12.00 | S/.0.00 | S/.48.00
Total |  |  |  | S/.1768.04
Presupuesto del sistema de control y comunicación
Componente | Cantidad | P.unit (S/.) | Importación (S/.) | Total (S/.)
Arduino Mega 2560 Pro | 1 | S/.65.00 | S/.0.00 | S/.65.00
Raspberry Pi 4 | 1 | S/.484.00 | S/.0.00 | S/.484.00
Módulo Wi-Fi ESP8266 WIFI-SERIA | 1 | S/.20.00 | S/.0.00 | S/.20.00
Pulsador Liviano rojo (XB7-EA2) | 1 | S/.7.90 | S/.0.00 | S/.7.90
Total |  |  |  | S/.576.90
Presupuesto del sistema de energía
Componente | Cantidad | P.unit (S/.) | Importación (S/.) | Total (S/.)
Batería de litio para Carros de Golf-Eco-Batt 4.0LifePO4 | 1 | S/.1203.00 | S/.530.00 | S/.1733.00
Total |  |  |  | S/.1733.00
Total |  |  |  | S/.5958.91
Ítem | Costo total
Carcasa y chasis del vehículo | S/.1726.99
Sistema de rociado | S/.153.98
Sistema de navegación | S/.1768.04
Sistema de control y comunicación | S/.576.90
Sistema de energía | S/.1733.00
Fabricación | S/.763.20
Total | S/.6722.11

Sheet: Sheet2
Cámara
Tanque
Lidar
Botón
Led
Perfil A
Perfil B
Base acrílica
Perfiles largos C
Perfiles cortos D
Batería
Circuitería
Electrobomba
Otros
