Sebastian-Jaimes/EMC_IoT/docs/MDM/5. PROYECTO/Metodología del diseño mecatrónico- Grupo/Tablas/Costos.xlsx

LEYENDA
ITEM | CANTIDAD | PART NUMBER | STANDARD | MATERIAL | COMMENTS | Precio unit (S/.) | Subtotal (S/.) | Precio unit ($) | subtotal($)
1
2
3
4
5
6
7
8
9
10
11
12
13
14
15
16
17
18
