Sebastian-Jaimes/EMC_IoT/docs/Tablas/Presupuesto empaquetadora.xlsx

Presupuesto de los componentes de empaquetadora |  |  |  | Operación | Costo total
Componente | Cantidad | P.unit (S/.) | Total (S/.) | Torneado de ejes | S/.0.00
Arduino Mega 2560 Pro | 1 | S/.65.00 | S/.65.00 | Fundicion (para acoples) | S/.0.00
ESP-01 ESP8266 WIFI-SERIAL | 1 | S/.20.00 | S/.20.00 | Impresion de PCB | S/.0.00
Sensor de Proximidad Fotoeléctrico Infrarrojo E18-D80NK | 1 | S/.28.00 | S/.28.00 | Total | S/.0.00
Celda de carga 5kg + HX711 | 1 | S/.19.50 | S/.19.50
Actuator LA14 de Linak | 8 | S/.150.00 | S/.1200.00 | Desarrollo de software | 1000
Nema 24 QCI-DS028 | 5 | S/.100.00 | S/.500.00
Motorreductor PDX26 | 2 | S/.89.00 | S/.178.00
Integrado L293D | 4 | S/.6.00 | S/.24.00
Driver TB6600 | 5 | S/.42.00 | S/.210.00
Driver L298N | 1 | S/.15.00 | S/.15.00
Driver Mosfet IRF540N | 1 | S/.14.00 | S/.14.00
Llave diferencial 220V/25A | 1 | S/.184.00 | S/.184.00
Llave termomagnética 220V/25A | 4 | S/.42.90 | S/.171.60
Contactor 220V/25A | 2 | S/.309.03 | S/.618.06
Fuente De Alimentación Conmutada AC/DC 120W 24V 5A | 1 | S/.55.00 | S/.55.00
Fuente de alimentación ATX | 1 | S/.64.90 | S/.64.90
Total |  |  | S/.3367.06
Presupuesto de las piezas fabricadas
Componente | Cantidad | P.unit (S/.) | Total (S/.)
 | 1 | S/.0.00 | S/.0.00
 | 1 | S/.0.00 | S/.0.00
 | 1 | S/.0.00 | S/.0.00
 | 1 | S/.0.00 | S/.0.00
 | 1 | S/.0.00 | S/.0.00
 | 1 | S/.0.00 | S/.0.00
 | 1 | S/.0.00 | S/.0.00
 | 1 | S/.0.00 | S/.0.00
 | 1 | S/.0.00 | S/.0.00
 | 1 | S/.0.00 | S/.0.00
 | 1 | S/.0.00 | S/.0.00
 | 1 | S/.0.00 | S/.0.00
 | 1 | S/.0.00 | S/.0.00
 | 1 | S/.0.00 | S/.0.00
 | 1 | S/.0.00 | S/.0.00
 | 1 | S/.0.00 | S/.0.00
 | 1 | S/.0.00 | S/.0.00
 | 1 | S/.0.00 | S/.0.00
 | 1 | S/.0.00 | S/.0.00
 | 1 | S/.0.00 | S/.0.00
 | 1 | S/.0.00 | S/.0.00
 | 1 | S/.0.00 | S/.0.00
 | 1 | S/.0.00 | S/.0.00
 | 1 | S/.0.00 | S/.0.00
Total |  |  | S/.0.00
Total
Ítem | Costo total
Componentes | S/.3367.06
Piezas fabricadas | S/.0.00
Fabricación | S/.0.00
Total | S/.3367.06
