Sebastian-Jaimes/EMC_IoT/hardware/3d_models/1. Almacenamiento/IGS - Tolva/Tolva ensamblada.IGS

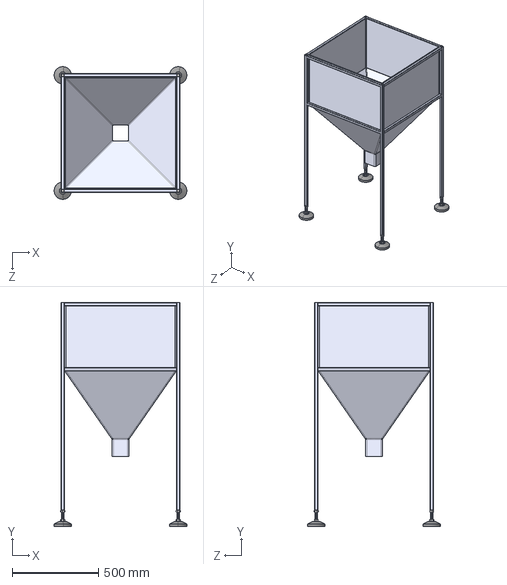
[picture p253: CAD file, 2024-09-10]
hardware/3d_models/1. Almacenamiento/IGS - Tolva/Tolva ensamblada.IGS
770.0 x 1299.6 x 770.0 mm
