Sebastian-Jaimes/EMC_IoT/hardware/3d_models/1. Almacenamiento/Soporte.SLDASM

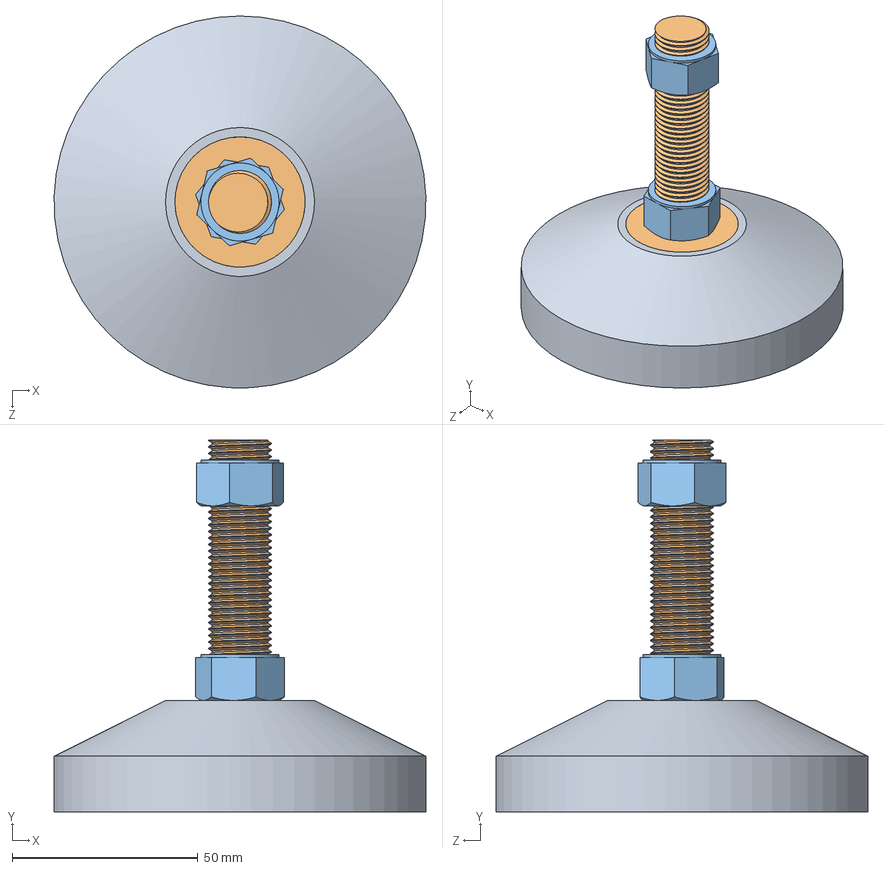
[picture p254: CAD file, 2025-09-29]
hardware/3d_models/1. Almacenamiento/Soporte.SLDASM
100.0 x 100.0 x 100.0 mm
Goma de sopote
Tornillo roscado de sopote
hex nut heavy_am x 2
