Sebastian-Jaimes/EMC_IoT/hardware/3d_models/2. Transporte/IGS - Transportador/Tubo Canalón.IGS

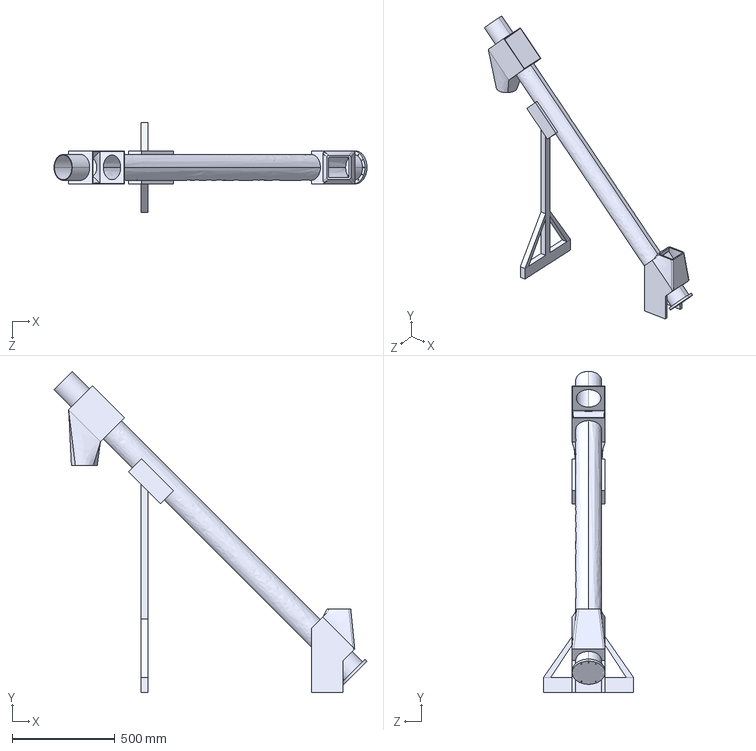
[picture p255: CAD file, 2024-09-10]
hardware/3d_models/2. Transporte/IGS - Transportador/Tubo Canalón.IGS
1525.2 x 1566.0 x 441.0 mm
