Sebastian-Jaimes/EMC_IoT/hardware/3d_models/2. Transporte/Tubo Canalón_v2.0.0.SLDPRT

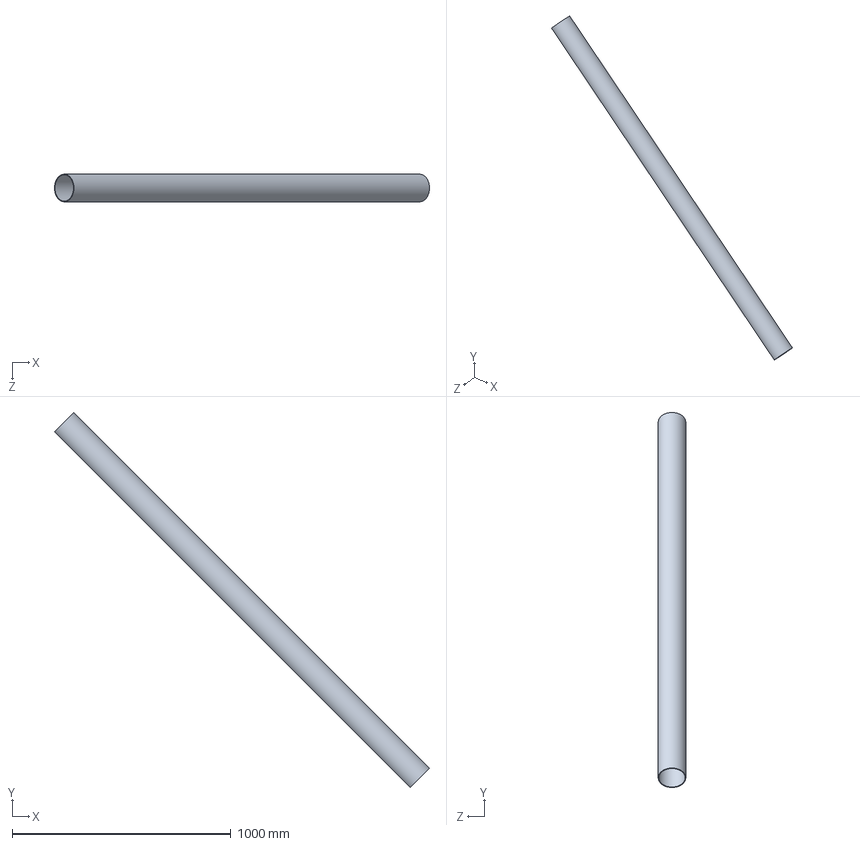
[picture p256: CAD file, 2025-09-29]
hardware/3d_models/2. Transporte/Tubo Canalón_v2.0.0.SLDPRT
1715.4 x 1715.4 x 126.0 mm
