Sebastian-Jaimes/EMC_IoT/hardware/3d_models/3. Dosificadora/Base del dosificador.SLDPRT

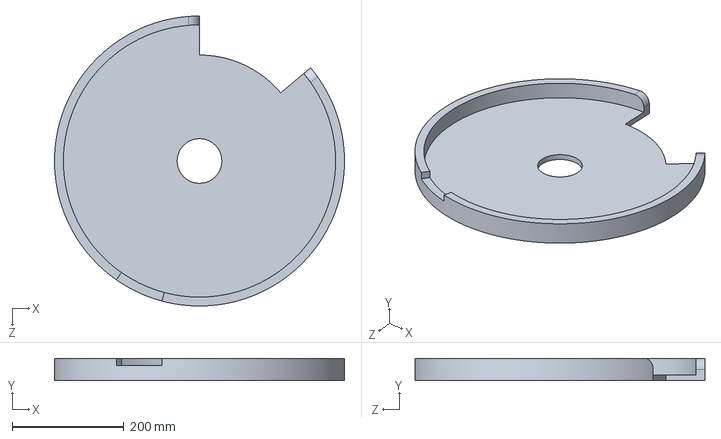
[picture p257: CAD file, 2024-09-10]
hardware/3d_models/3. Dosificadora/Base del dosificador.SLDPRT
520.0 x 40.0 x 520.0 mm
