Sebastian-Jaimes/EMC_IoT/hardware/3d_models/3. Dosificadora/DosificadoraVolumetricav2.0.0/DiscoDosificador.SLDPRT

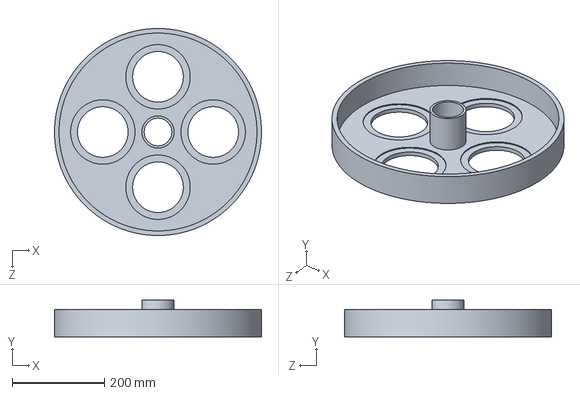
[picture p258: CAD file, 2025-09-29]
hardware/3d_models/3. Dosificadora/DosificadoraVolumetricav2.0.0/DiscoDosificador.SLDPRT
450.0 x 80.0 x 450.0 mm
