Sebastian-Jaimes/EMC_IoT/hardware/3d_models/3. Dosificadora/IGS - Dosificadora/Pata del dosificador.IGS

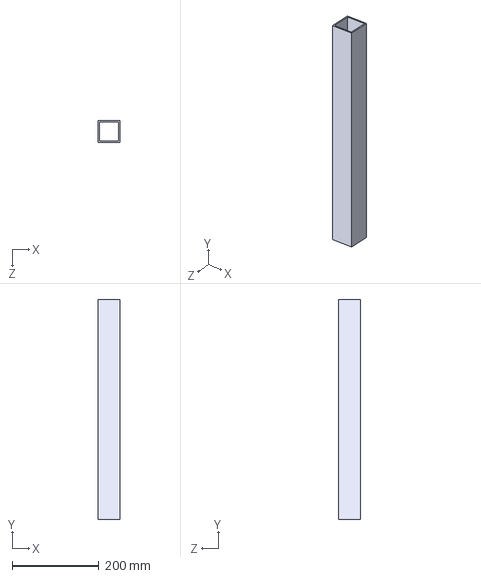
[picture p259: CAD file, 2024-09-10]
hardware/3d_models/3. Dosificadora/IGS - Dosificadora/Pata del dosificador.IGS
50.0 x 506.5 x 50.0 mm
