Sebastian-Jaimes/EMC_IoT/hardware/3d_models/4. Empaquetado/FormadorDeBolsas/FS/guide.SLDPRT

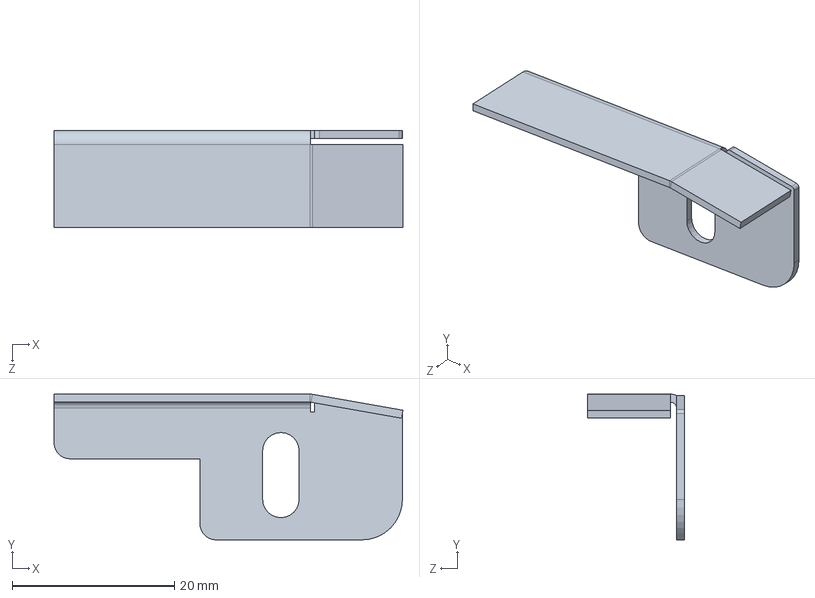
[picture p260: CAD file, 2025-09-29]
hardware/3d_models/4. Empaquetado/FormadorDeBolsas/FS/guide.SLDPRT
43.1 x 18.0 x 12.0 mm
