Sebastian-Jaimes/EMC_IoT/hardware/3d_models/Caja negra.SLDPRT

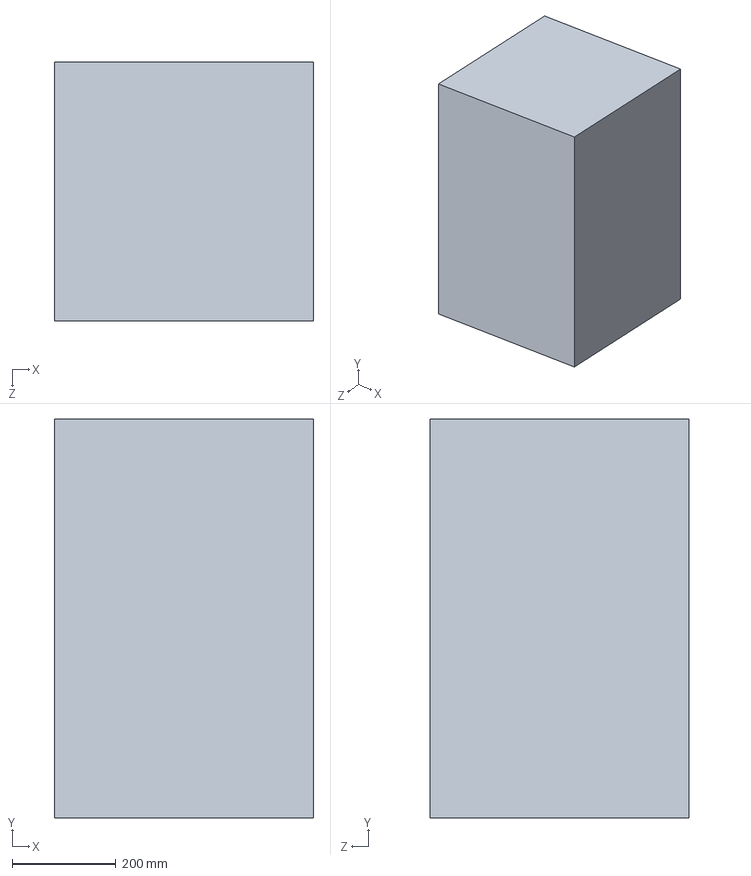
[picture p261: CAD file, 2024-09-10]
hardware/3d_models/Caja negra.SLDPRT
500.0 x 770.0 x 500.0 mm
