Sebastian-Jaimes/EMC_IoT/hardware/drawings/Tolva/Tornillo roscado de sopote.IGS

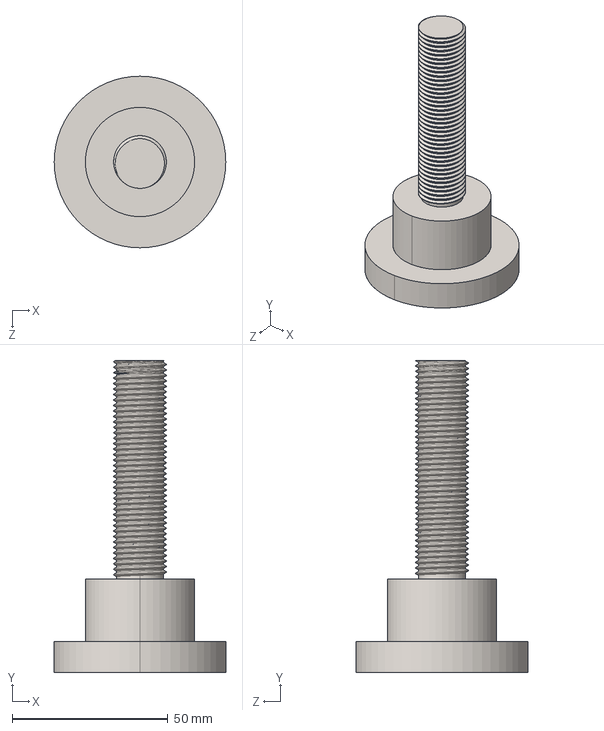
[picture p262: CAD file, 2024-09-10]
hardware/drawings/Tolva/Tornillo roscado de sopote.IGS
55.0 x 100.0 x 55.0 mm
