Sebastian-Jaimes/EMC_IoT/tests/Simulaciones/Dosificadora 2/Vaso volumétrico_Predeterminado_sldprt.STEP

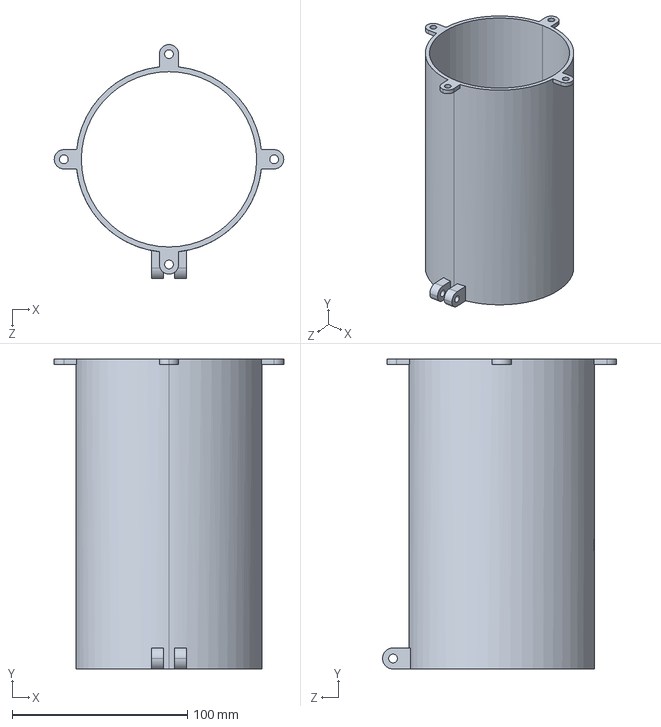
[picture p263: CAD file, 2024-09-10]
tests/Simulaciones/Dosificadora 2/Vaso volumétrico_Predeterminado_sldprt.STEP
131.0 x 176.9 x 133.5 mm
