Sebastian-Jaimes/EMC_IoT/tests/Simulaciones/Dosificadora/Soporte para eje de dosificadora_Predeterminado_sldprt.STEP

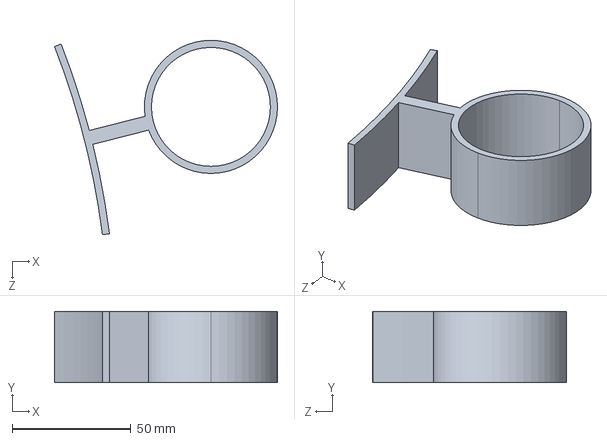
[picture p264: CAD file, 2024-09-10]
tests/Simulaciones/Dosificadora/Soporte para eje de dosificadora_Predeterminado_sldprt.STEP
93.8 x 30.0 x 81.8 mm
