Sebastian-Jaimes/EMC_IoT/tests/Simulaciones/Empaquetadora/taper pin unhardened_bsi_BS EN 22339 - A - 5 x 18 - St_sldprt.STEP

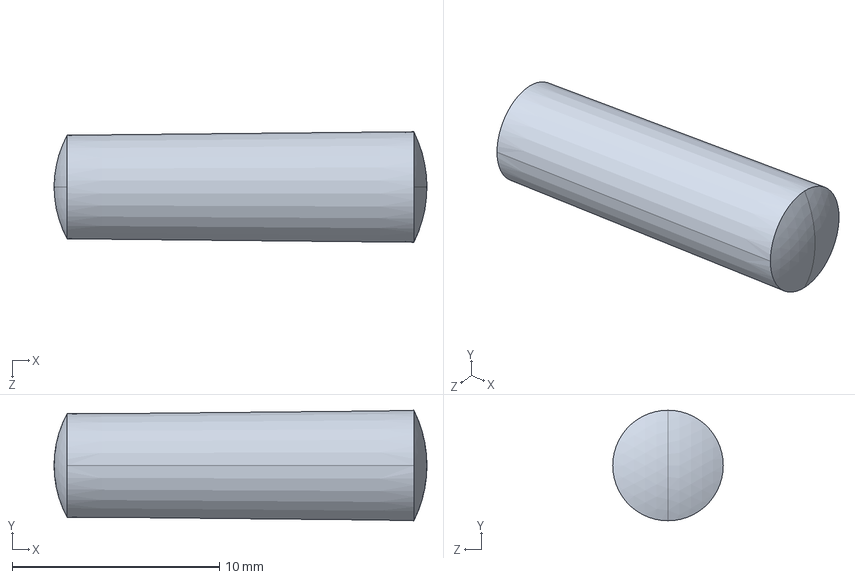
[picture p265: CAD file, 2024-09-10]
tests/Simulaciones/Empaquetadora/taper pin unhardened_bsi_BS EN 22339 - A - 5 x 18 - St_sldprt.STEP
18.0 x 5.33 x 5.33 mm
