Sebastian-Jaimes/EMC_IoT/tests/Simulaciones/Transportador/Eje del tornillo helicoidal_Predeterminado_sldprt.STEP

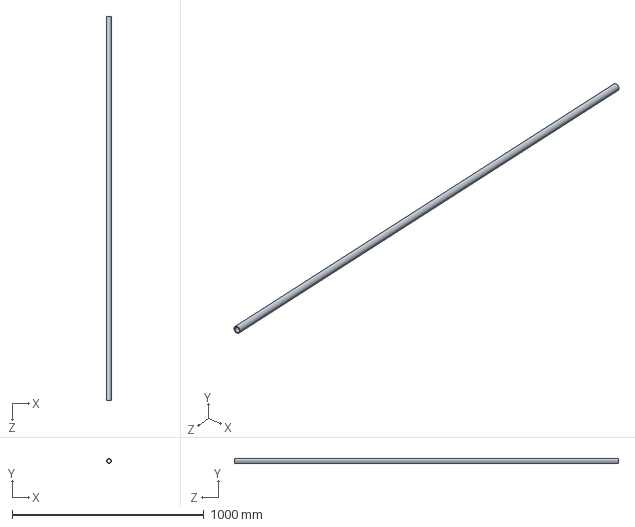
[picture p266: CAD file, 2024-09-10]
tests/Simulaciones/Transportador/Eje del tornillo helicoidal_Predeterminado_sldprt.STEP
25.0 x 25.0 x 2003.0 mm
