Sebastian-Jaimes/EMC_IoT/hardware/3d_models/2. Transporte/TapaTuboDeTransporte.SLDPRT

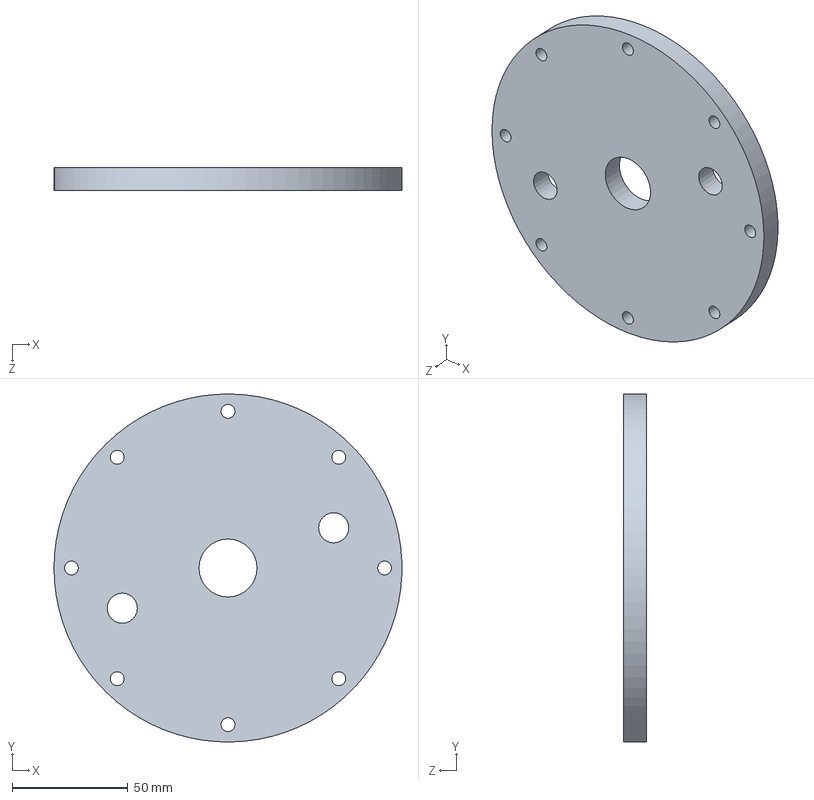
[picture p267: CAD file, 2025-09-29]
hardware/3d_models/2. Transporte/TapaTuboDeTransporte.SLDPRT
150.0 x 150.0 x 10.0 mm
