Sebastian-Jaimes/EMC_IoT/hardware/3d_models/3. Dosificadora/DosificadoraVolumetricav2.0.0/BaseGuiaDosificador.SLDPRT

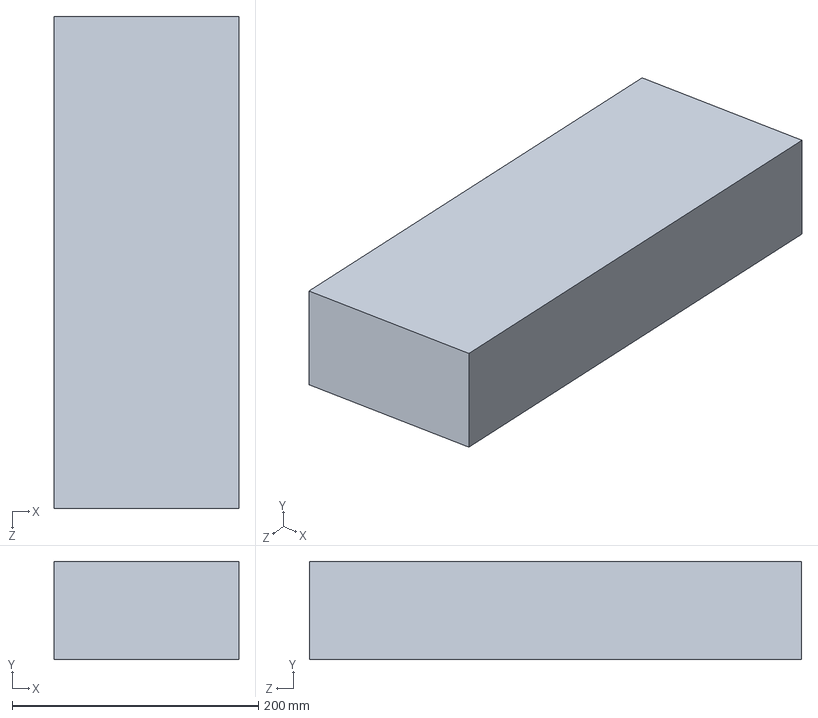
[picture p268: CAD file, 2025-09-29]
hardware/3d_models/3. Dosificadora/DosificadoraVolumetricav2.0.0/BaseGuiaDosificador.SLDPRT
150.0 x 80.0 x 400.0 mm
