Sebastian-Jaimes/EMC_IoT/hardware/3d_models/3. Dosificadora/IGS - Dosificadora/Base Inferior de la caja.IGS

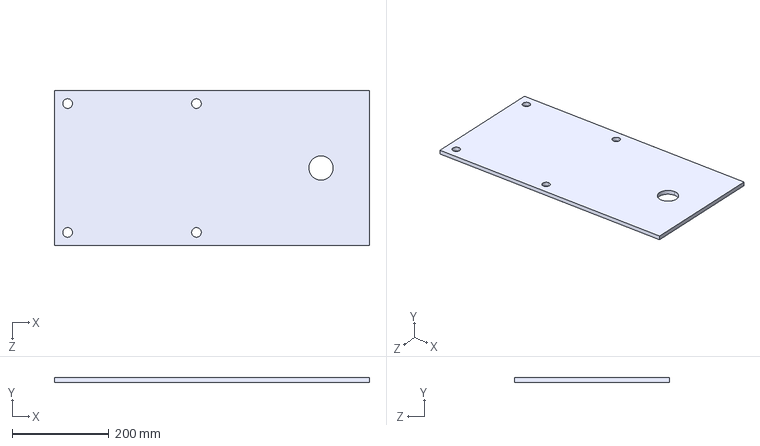
[picture p269: CAD file, 2024-09-10]
hardware/3d_models/3. Dosificadora/IGS - Dosificadora/Base Inferior de la caja.IGS
650.0 x 10.0 x 320.0 mm
