Sebastian-Jaimes/EMC_IoT/hardware/3d_models/3. Dosificadora/Rueda de vaso.SLDPRT

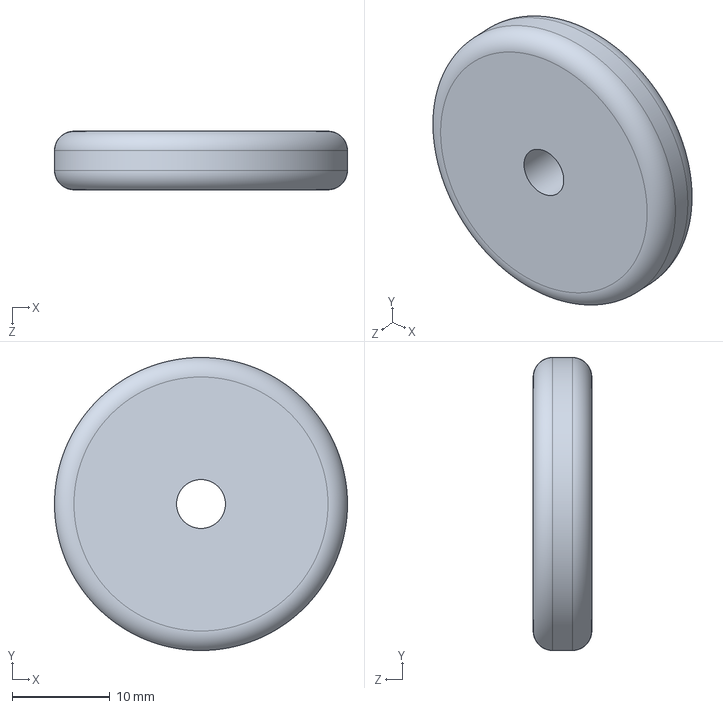
[picture p270: CAD file, 2024-09-10]
hardware/3d_models/3. Dosificadora/Rueda de vaso.SLDPRT
30.0 x 30.0 x 6.00 mm
