Sebastian-Jaimes/EMC_IoT/hardware/3d_models/4. Empaquetado/FormadorDeBolsas/FS/beam.SLDPRT

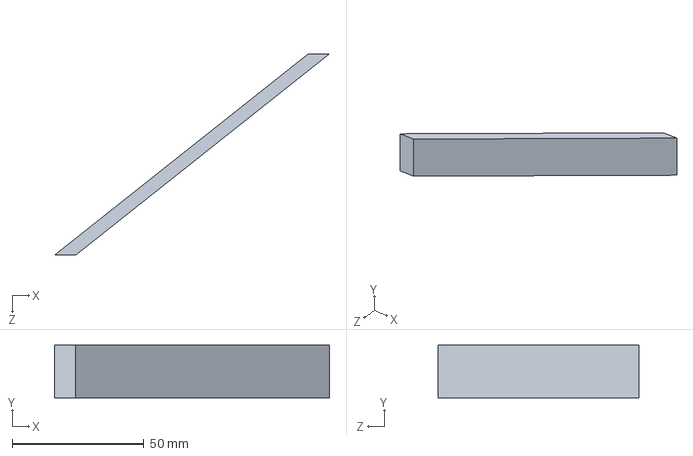
[picture p271: CAD file, 2025-09-29]
hardware/3d_models/4. Empaquetado/FormadorDeBolsas/FS/beam.SLDPRT
104.4 x 20.0 x 76.4 mm
