Sebastian-Jaimes/EMC_IoT/hardware/3d_models/4. Empaquetado/FormadorDeBolsas/RolloBolsas.SLDPRT

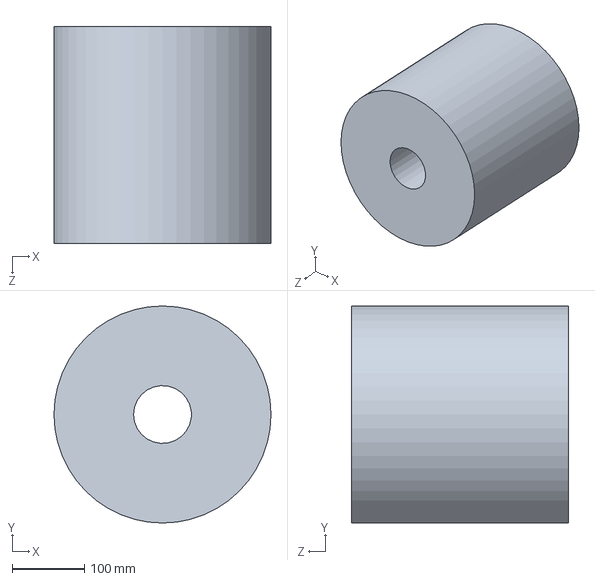
[picture p272: CAD file, 2025-09-29]
hardware/3d_models/4. Empaquetado/FormadorDeBolsas/RolloBolsas.SLDPRT
300.0 x 300.0 x 300.0 mm
