Sebastian-Jaimes/EMC_IoT/hardware/3d_models/1. Almacenamiento/IGS - Tolva/Goma de sopote.IGS

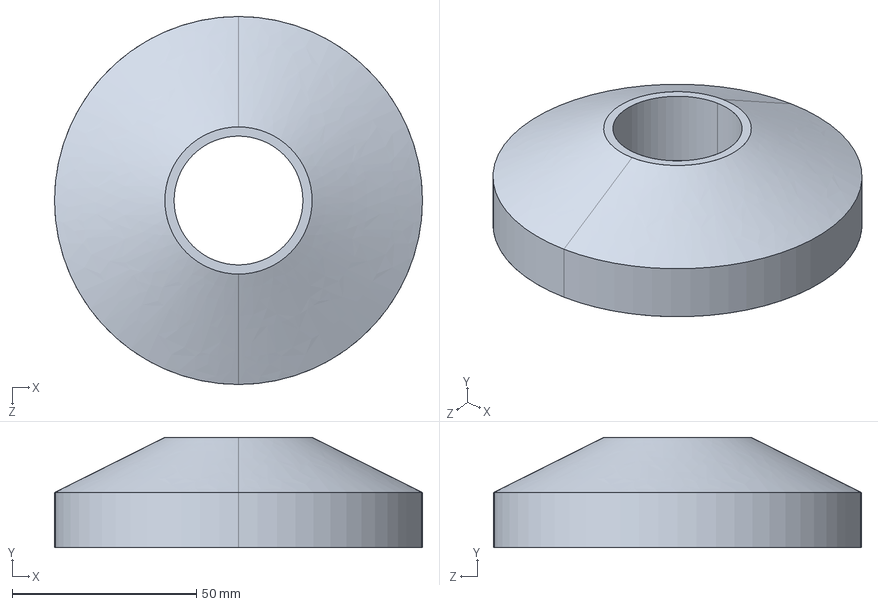
[picture p273: CAD file, 2024-09-10]
hardware/3d_models/1. Almacenamiento/IGS - Tolva/Goma de sopote.IGS
100.0 x 30.0 x 100.0 mm
