Sebastian-Jaimes/EMC_IoT/hardware/3d_models/1. Almacenamiento/Tolva.SLDPRT

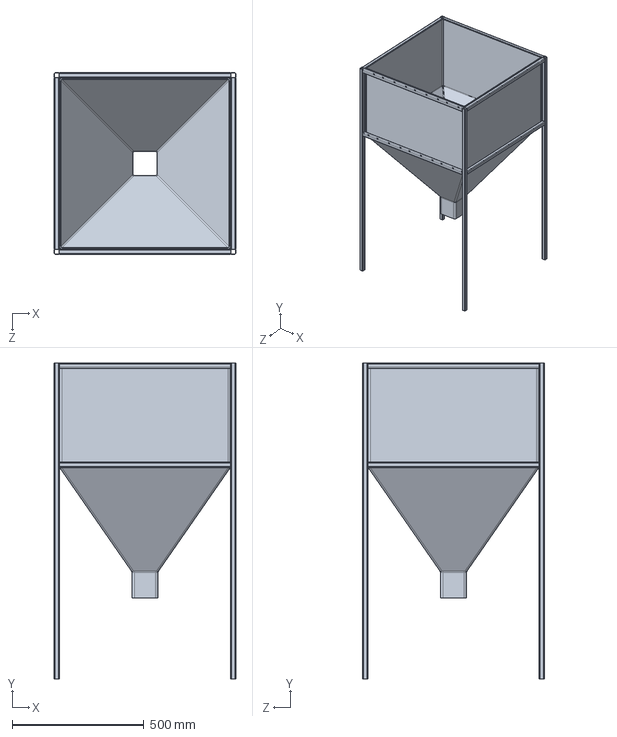
[picture p274: CAD file, 2025-09-29]
hardware/3d_models/1. Almacenamiento/Tolva.SLDPRT
690.0 x 1200.0 x 690.0 mm
