Sebastian-Jaimes/EMC_IoT/hardware/3d_models/2. Transporte/Pulley_2.SLDPRT

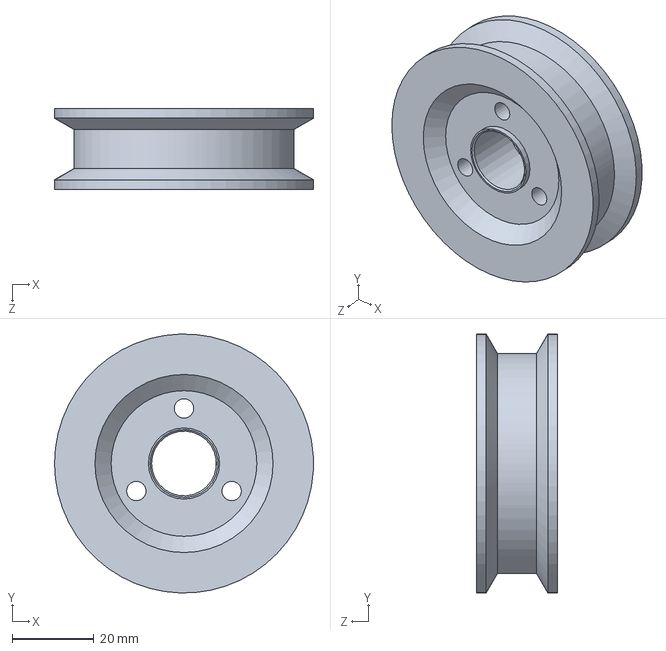
[picture p275: CAD file, 2025-09-29]
hardware/3d_models/2. Transporte/Pulley_2.SLDPRT
63.3 x 63.3 x 19.8 mm
