Sebastian-Jaimes/EMC_IoT/hardware/3d_models/3. Dosificadora/Disco Dosificador.SLDPRT

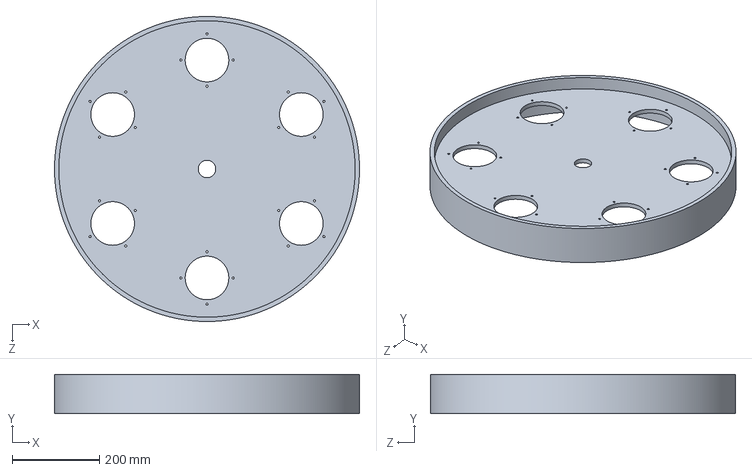
[picture p276: CAD file, 2024-09-10]
hardware/3d_models/3. Dosificadora/Disco Dosificador.SLDPRT
700.0 x 90.0 x 700.0 mm
