Sebastian-Jaimes/EMC_IoT/hardware/3d_models/3. Dosificadora/DosificadoraVolumetricav2.0.0/CabinaDosificadora.SLDPRT

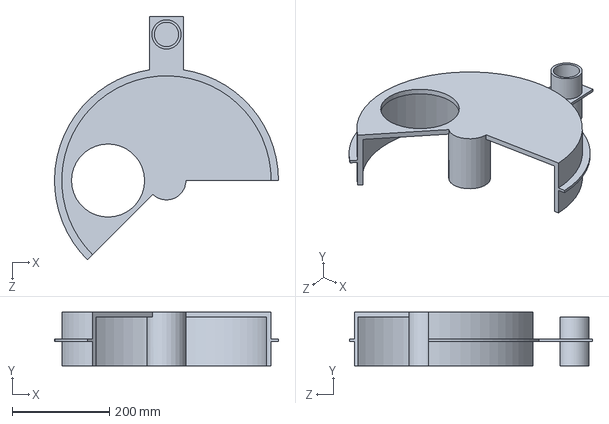
[picture p277: CAD file, 2025-09-29]
hardware/3d_models/3. Dosificadora/DosificadoraVolumetricav2.0.0/CabinaDosificadora.SLDPRT
460.0 x 110.0 x 500.0 mm
