Sebastian-Jaimes/EMC_IoT/hardware/3d_models/3. Dosificadora/IGS - Dosificadora/Tapa de Vaso volumétrico.IGS

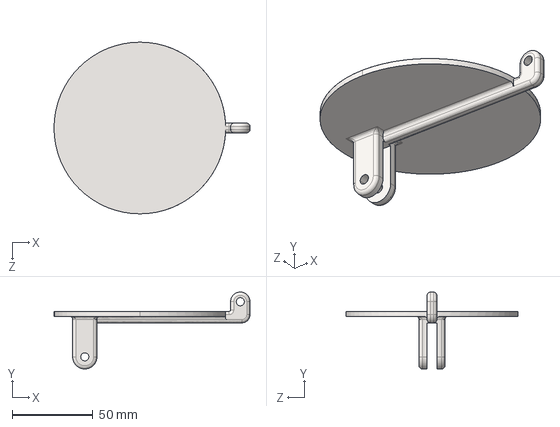
[picture p278: CAD file, 2024-09-10]
hardware/3d_models/3. Dosificadora/IGS - Dosificadora/Tapa de Vaso volumétrico.IGS
121.0 x 47.5 x 106.0 mm
