Sebastian-Jaimes/EMC_IoT/hardware/3d_models/4. Empaquetado/FormadorDeBolsas/FS/sheet metal.SLDPRT

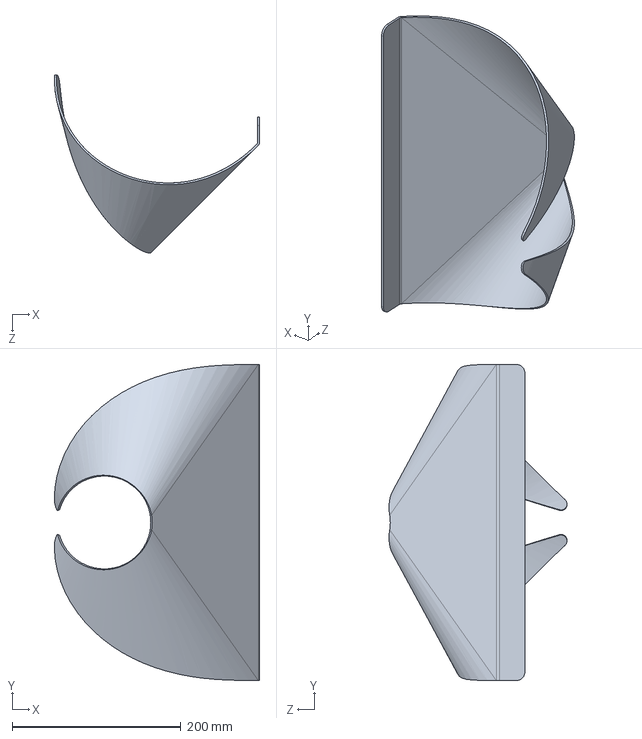
[picture p279: CAD file, 2025-09-29]
hardware/3d_models/4. Empaquetado/FormadorDeBolsas/FS/sheet metal.SLDPRT
243.1 x 374.2 x 210.8 mm
