Sebastian-Jaimes/EMC_IoT/hardware/3d_models/4. Empaquetado/FormadorDeBolsas/VarillaParaFormadoDeBolsas.SLDPRT

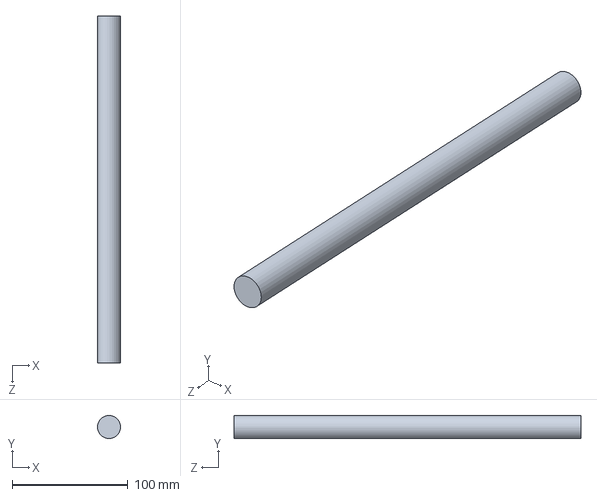
[picture p280: CAD file, 2025-09-29]
hardware/3d_models/4. Empaquetado/FormadorDeBolsas/VarillaParaFormadoDeBolsas.SLDPRT
20.0 x 20.0 x 300.0 mm
