Sebastian-Jaimes/EMC_IoT/tests/Simulaciones/Dosificadora/Sensor de carga 5 kgf_Predeterminado_sldprt.STEP

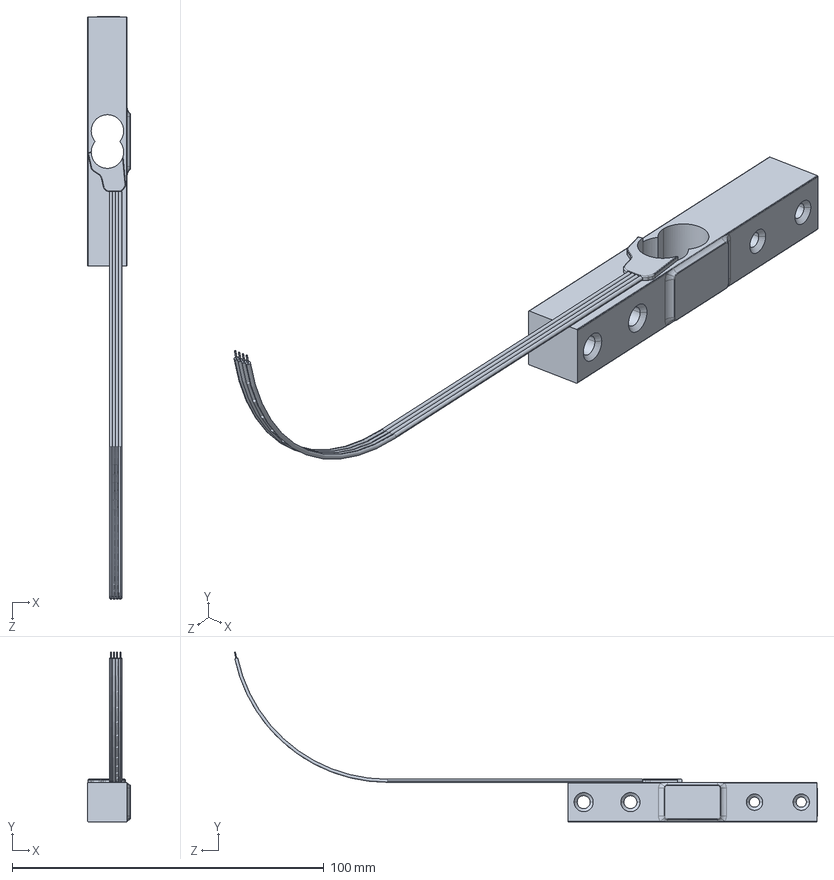
[picture p281: CAD file, 2024-09-10]
tests/Simulaciones/Dosificadora/Sensor de carga 5 kgf_Predeterminado_sldprt.STEP
13.7 x 54.5 x 187.0 mm
