Sebastian-Jaimes/EMC_IoT/tests/Simulaciones/Empaquetadora/Covertor de dosificador_Predeterminado_sldprt.STEP

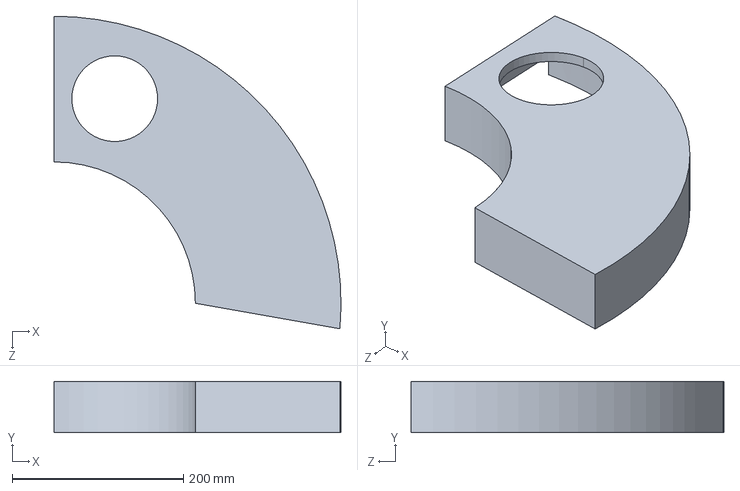
[picture p282: CAD file, 2024-09-10]
tests/Simulaciones/Empaquetadora/Covertor de dosificador_Predeterminado_sldprt.STEP
335.0 x 60.0 x 364.7 mm
