Sebastian-Jaimes/EMC_IoT/hardware/3d_models/2. Transporte/SoporteMotorTransportador.SLDPRT

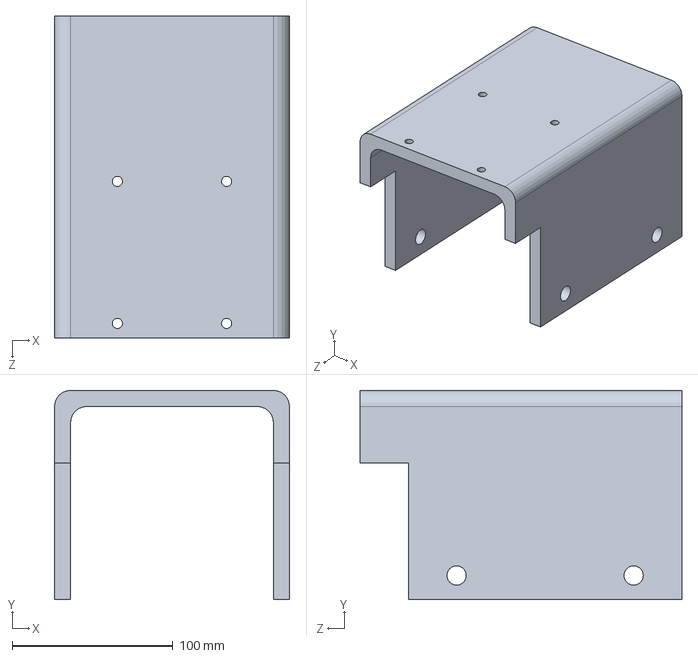
[picture p283: CAD file, 2025-09-29]
hardware/3d_models/2. Transporte/SoporteMotorTransportador.SLDPRT
146.0 x 130.0 x 200.0 mm
