Sebastian-Jaimes/EMC_IoT/hardware/3d_models/4. Empaquetado/FormadorDeBolsas/VarillaParaSujecionDeBolsas.SLDPRT

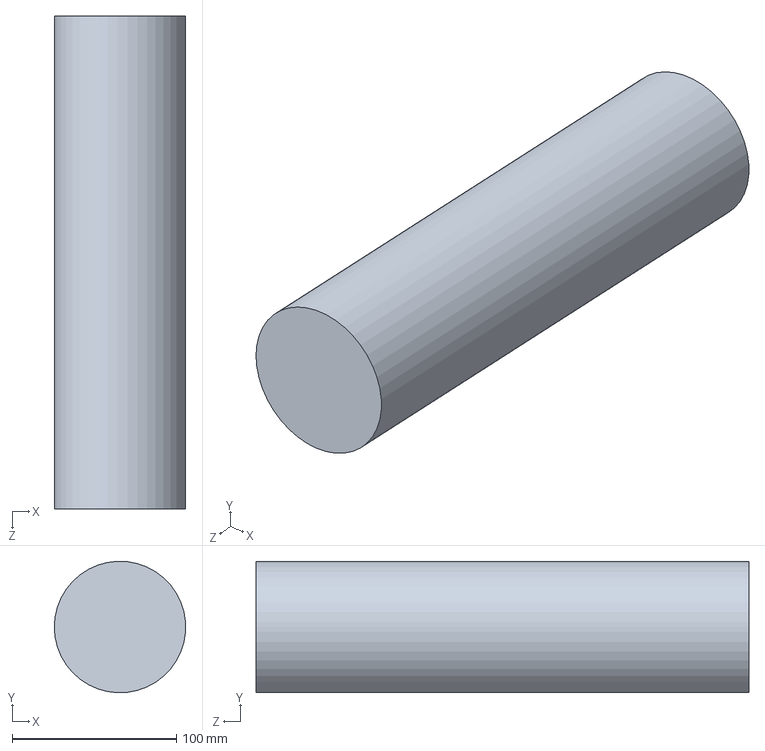
[picture p284: CAD file, 2025-09-29]
hardware/3d_models/4. Empaquetado/FormadorDeBolsas/VarillaParaSujecionDeBolsas.SLDPRT
80.0 x 79.9 x 300.0 mm
