Sebastian-Jaimes/EMC_IoT/hardware/3d_models/1. Almacenamiento/Base de la pata.SLDPRT

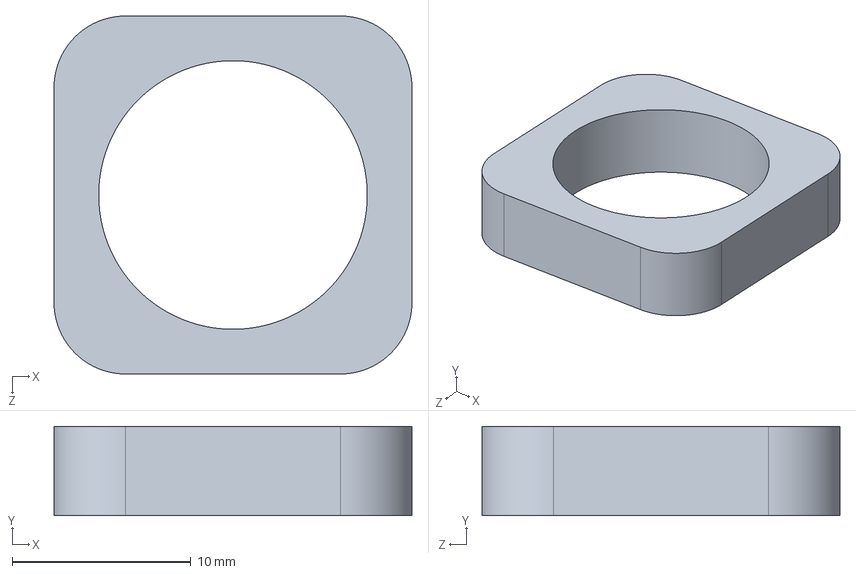
[picture p285: CAD file, 2024-09-10]
hardware/3d_models/1. Almacenamiento/Base de la pata.SLDPRT
20.0 x 5.00 x 20.0 mm
