Sebastian-Jaimes/EMC_IoT/hardware/3d_models/2. Transporte/EjeDelTornilloHelicoidal-v2.0.0.SLDPRT

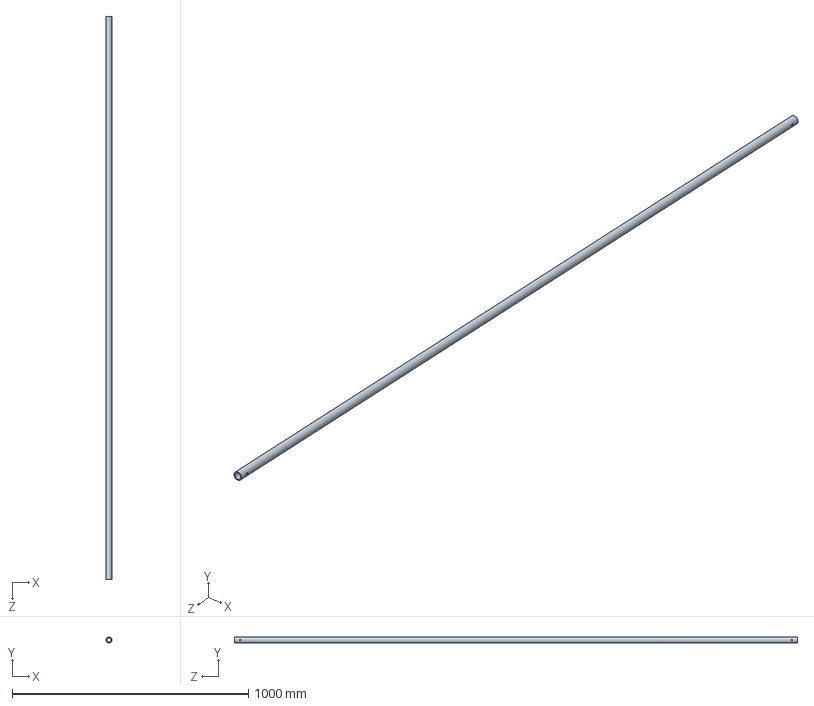
[picture p286: CAD file, 2025-09-29]
hardware/3d_models/2. Transporte/EjeDelTornilloHelicoidal-v2.0.0.SLDPRT
25.0 x 25.0 x 2383.0 mm
