Sebastian-Jaimes/EMC_IoT/hardware/3d_models/3. Dosificadora/DosificadoraVolumetricav2.0.0/BaseMetalicaDosificador.SLDPRT

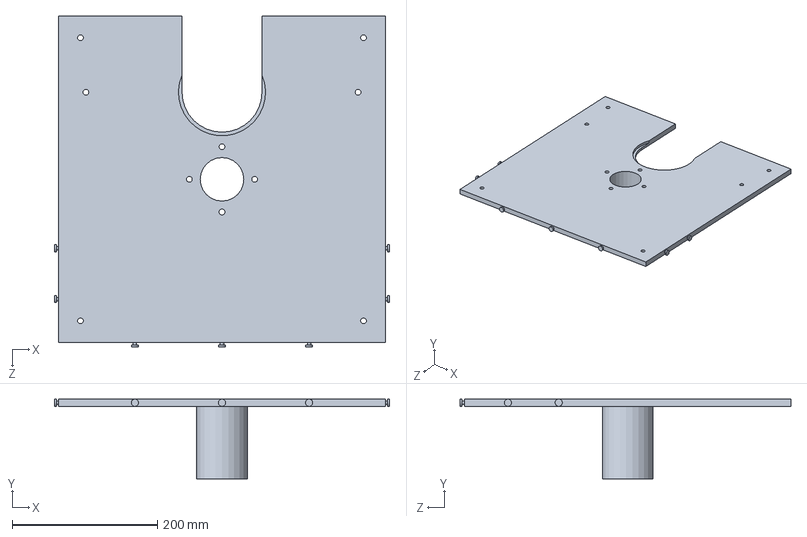
[picture p287: CAD file, 2025-09-29]
hardware/3d_models/3. Dosificadora/DosificadoraVolumetricav2.0.0/BaseMetalicaDosificador.SLDPRT
462.0 x 110.0 x 456.0 mm
