Sebastian-Jaimes/EMC_IoT/hardware/3d_models/3. Dosificadora/IGS - Dosificadora/Columna del dosificador.IGS

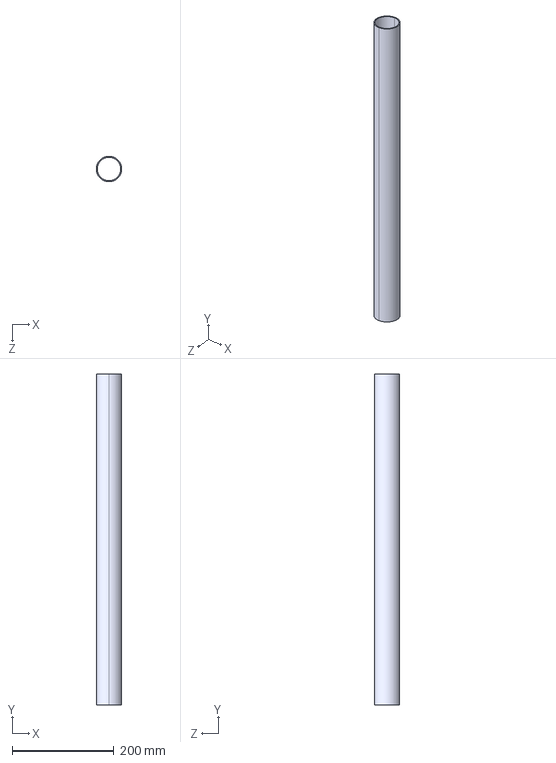
[picture p288: CAD file, 2024-09-10]
hardware/3d_models/3. Dosificadora/IGS - Dosificadora/Columna del dosificador.IGS
50.0 x 650.0 x 50.0 mm
