Sebastian-Jaimes/EMC_IoT/hardware/3d_models/4. Empaquetado/FormadorDeBolsas/FS/support.SLDPRT

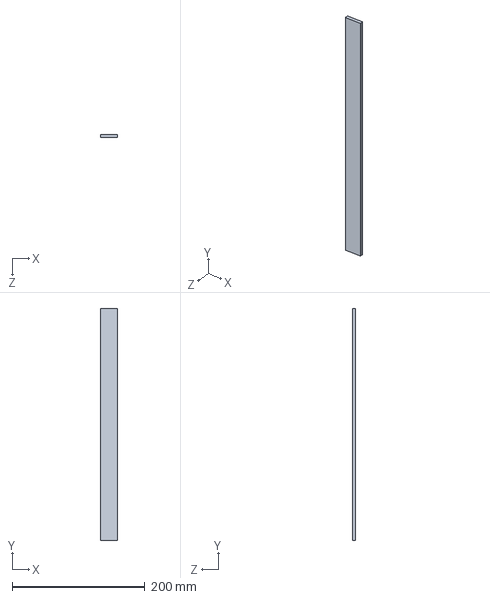
[picture p289: CAD file, 2025-09-29]
hardware/3d_models/4. Empaquetado/FormadorDeBolsas/FS/support.SLDPRT
25.0 x 350.0 x 5.00 mm
