Sebastian-Jaimes/EMC_IoT/tests/Simulaciones/Empaquetadora/Eje del dosificador_Predeterminado_sldprt.STEP

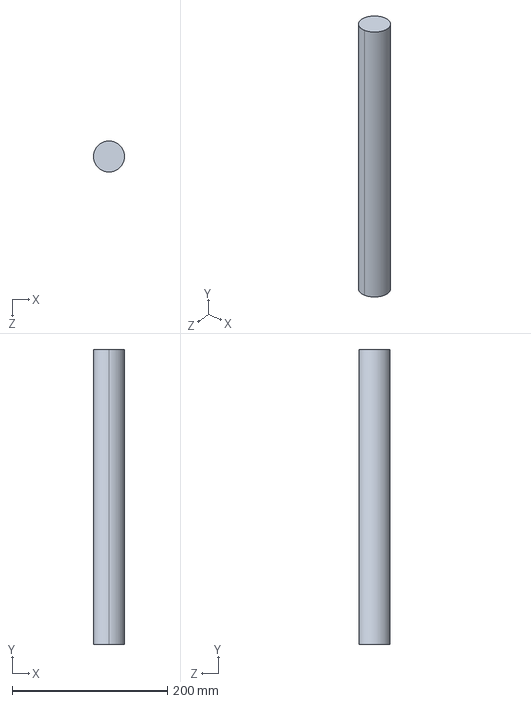
[picture p290: CAD file, 2024-09-10]
tests/Simulaciones/Empaquetadora/Eje del dosificador_Predeterminado_sldprt.STEP
40.0 x 380.0 x 40.0 mm
