Sebastian-Jaimes/EMC_IoT/hardware/3d_models/1. Almacenamiento/Tolva sin perfiles.SLDPRT

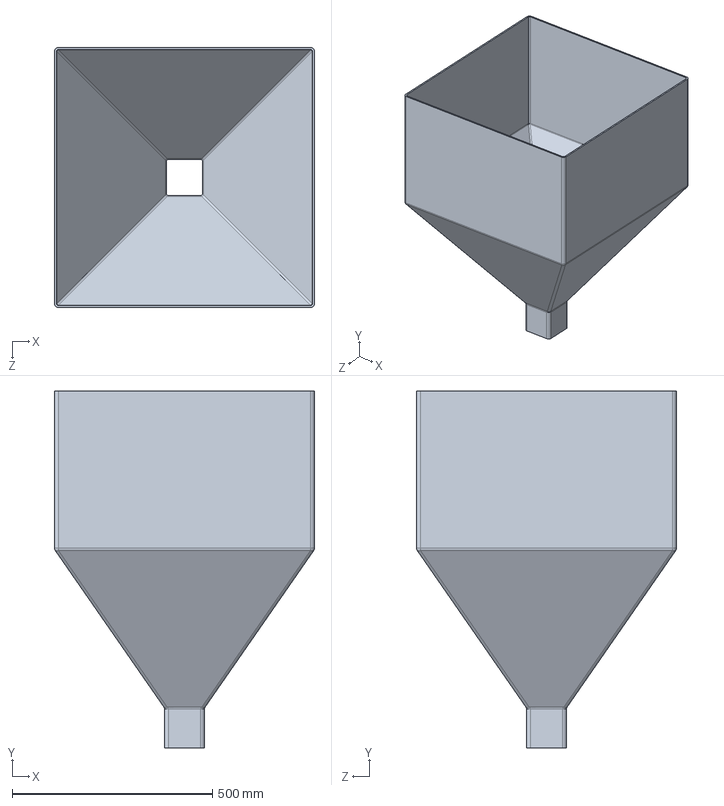
[picture p291: CAD file, 2024-09-10]
hardware/3d_models/1. Almacenamiento/Tolva sin perfiles.SLDPRT
650.0 x 892.4 x 650.0 mm
