Sebastian-Jaimes/EMC_IoT/hardware/3d_models/2. Transporte/TuboDeTransporte.SLDPRT

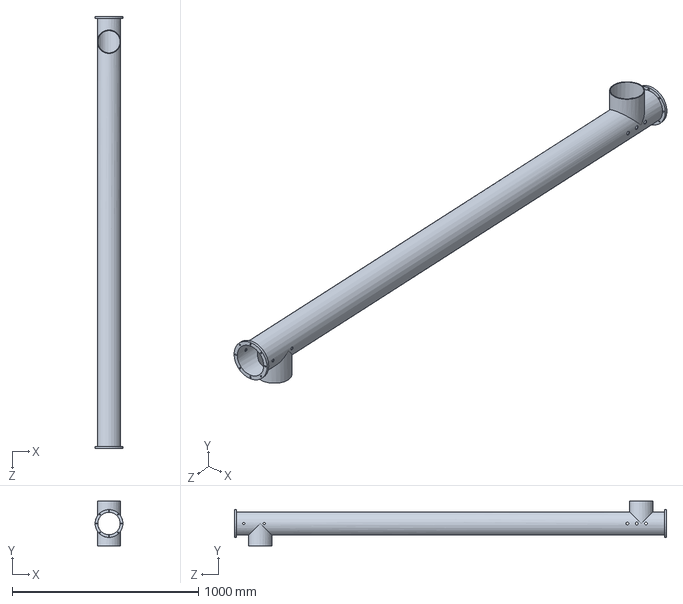
[picture p292: CAD file, 2025-09-29]
hardware/3d_models/2. Transporte/TuboDeTransporte.SLDPRT
150.0 x 240.0 x 2320.0 mm
