Sebastian-Jaimes/EMC_IoT/hardware/3d_models/3. Dosificadora/DosificadoraVolumetricav2.0.0/GuiaDosificadora.SLDPRT

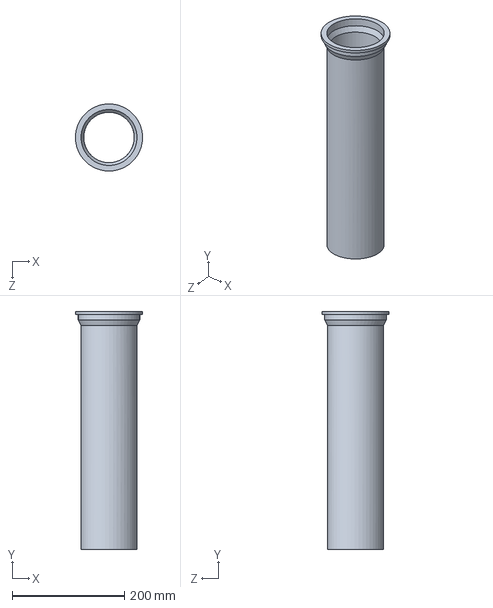
[picture p293: CAD file, 2025-09-29]
hardware/3d_models/3. Dosificadora/DosificadoraVolumetricav2.0.0/GuiaDosificadora.SLDPRT
119.9 x 425.0 x 119.9 mm
