Sebastian-Jaimes/EMC_IoT/hardware/3d_models/4. Empaquetado/FormadorDeBolsas/FS/Base.SLDPRT

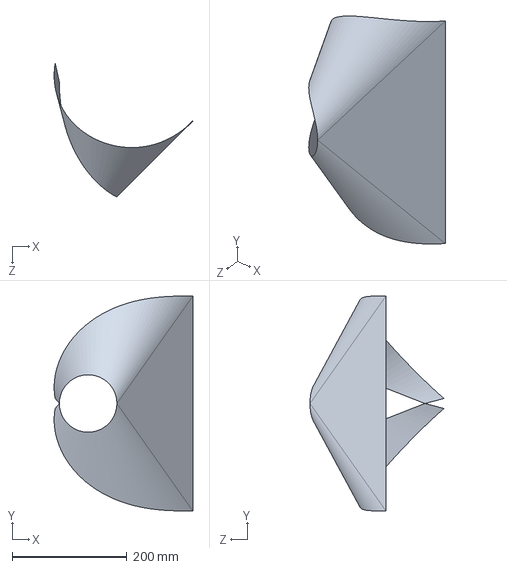
[picture p294: CAD file, 2025-09-29]
hardware/3d_models/4. Empaquetado/FormadorDeBolsas/FS/Base.SLDPRT
241.5 x 374.2 x 233.2 mm
