Sebastian-Jaimes/EMC_IoT/tests/Simulaciones/Dosificadora/clevis pin headed_bsi_BS EN 22341 - B - 5 x 24 x 1.2 - St_sldprt.STEP

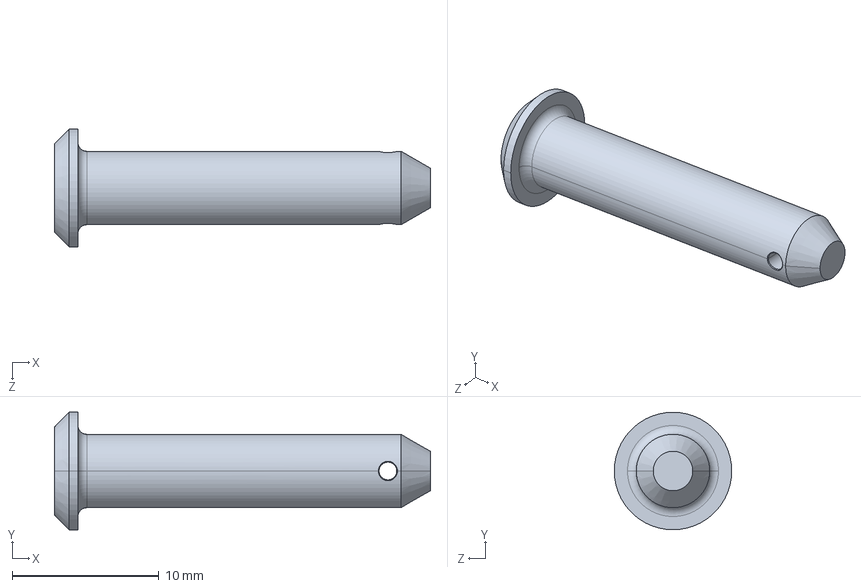
[picture p295: CAD file, 2024-09-10]
tests/Simulaciones/Dosificadora/clevis pin headed_bsi_BS EN 22341 - B - 5 x 24 x 1.2 - St_sldprt.STEP
25.6 x 8.00 x 8.00 mm
