Sebastian-Jaimes/EMC_IoT/hardware/3d_models/3. Dosificadora/DosificadoraVolumetricav2.0.0/BaseVasoDosificador.SLDPRT

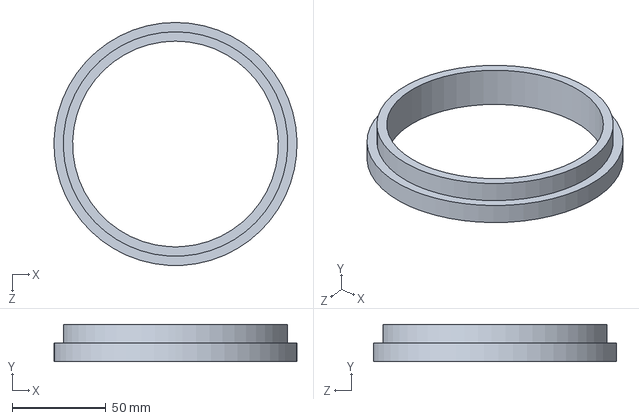
[picture p296: CAD file, 2025-09-29]
hardware/3d_models/3. Dosificadora/DosificadoraVolumetricav2.0.0/BaseVasoDosificador.SLDPRT
129.9 x 20.0 x 130.0 mm
