Sebastian-Jaimes/EMC_IoT/hardware/3d_models/4. Empaquetado/FormadorDeBolsas/FS/flange.SLDPRT

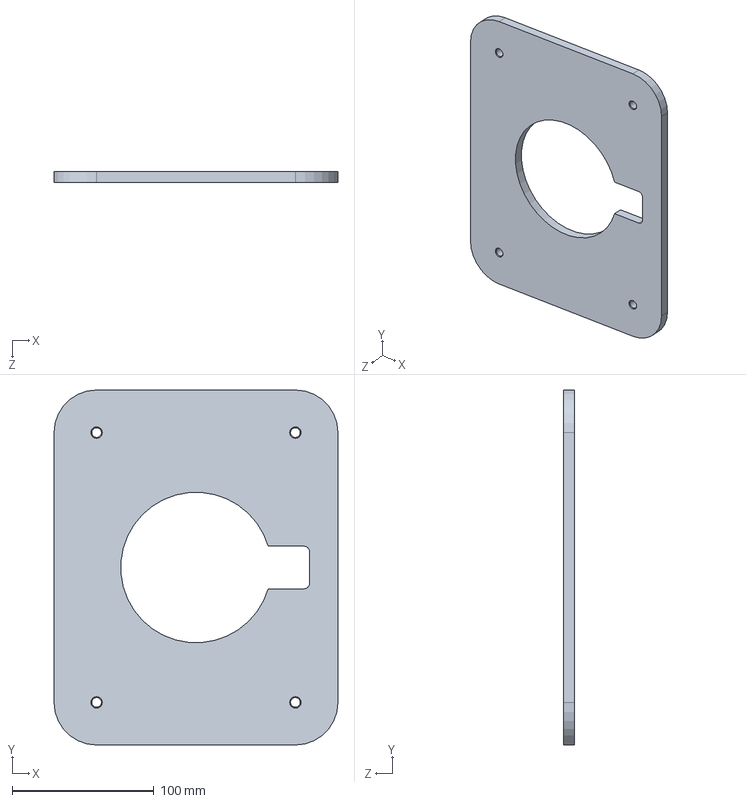
[picture p297: CAD file, 2025-09-29]
hardware/3d_models/4. Empaquetado/FormadorDeBolsas/FS/flange.SLDPRT
200.0 x 250.0 x 8.00 mm
