Sebastian-Jaimes/EMC_IoT/hardware/3d_models/2. Transporte/SoporteInferiorTransportador.SLDPRT

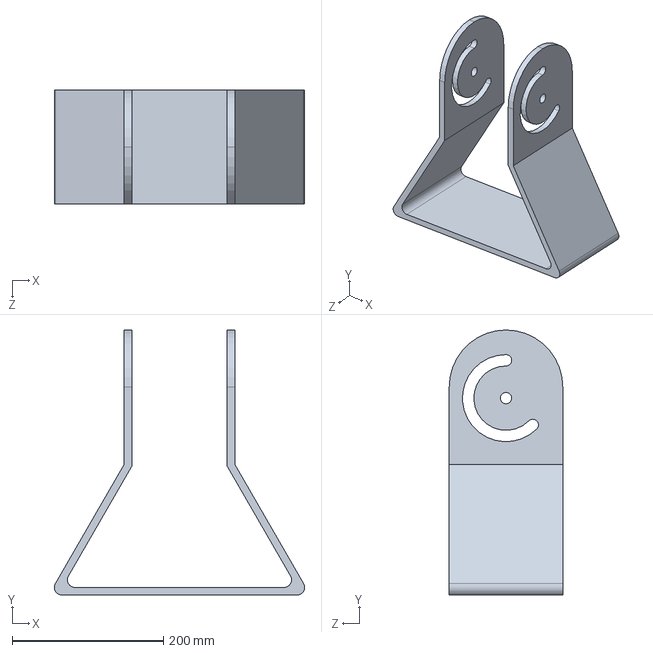
[picture p298: CAD file, 2025-09-29]
hardware/3d_models/2. Transporte/SoporteInferiorTransportador.SLDPRT
330.7 x 350.0 x 150.0 mm
