Sebastian-Jaimes/EMC_IoT/hardware/3d_models/3. Dosificadora/DosificadoraVolumetricav2.0.0/RolloFilmCafe.SLDPRT

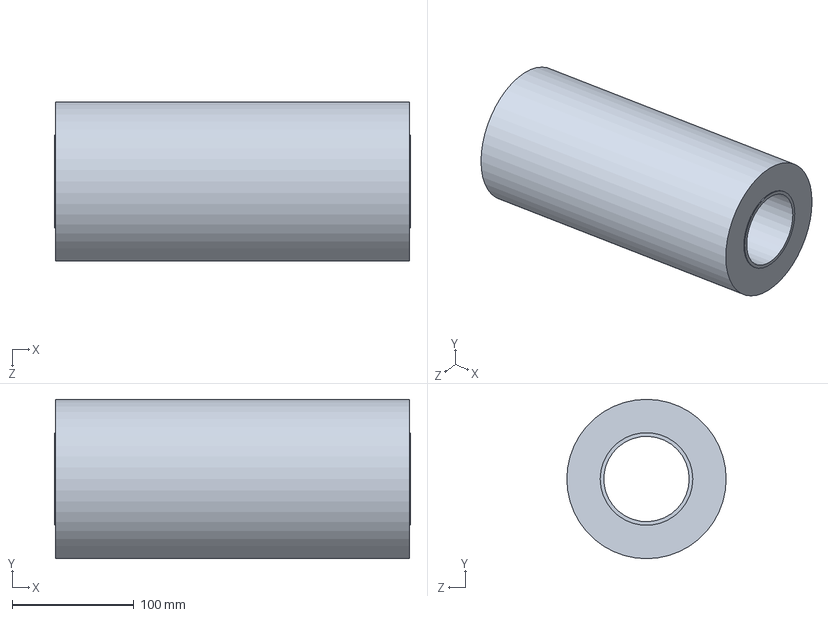
[picture p299: CAD file, 2025-09-29]
hardware/3d_models/3. Dosificadora/DosificadoraVolumetricav2.0.0/RolloFilmCafe.SLDPRT
292.0 x 130.7 x 130.7 mm
