Sebastian-Jaimes/EMC_IoT/hardware/3d_models/3. Dosificadora/IGS - Dosificadora/Columna de caja base.IGS

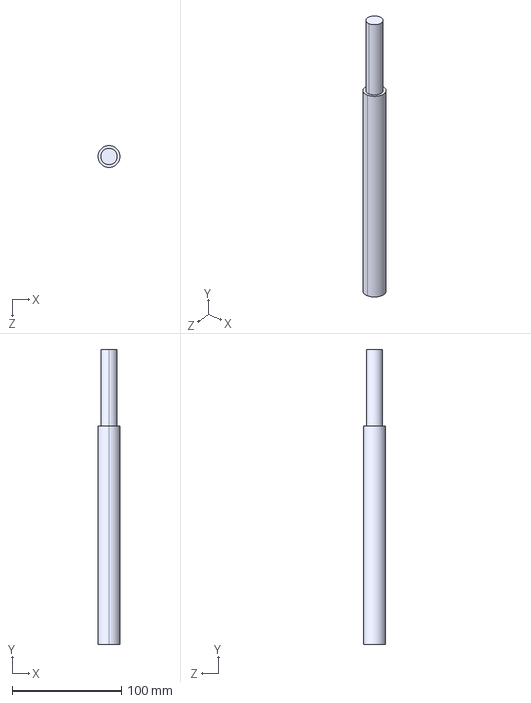
[picture p300: CAD file, 2024-09-10]
hardware/3d_models/3. Dosificadora/IGS - Dosificadora/Columna de caja base.IGS
20.0 x 270.0 x 20.0 mm
