Sebastian-Jaimes/EMC_IoT/hardware/3d_models/4. Empaquetado/FormadorDeBolsas/FS/guide2.SLDPRT

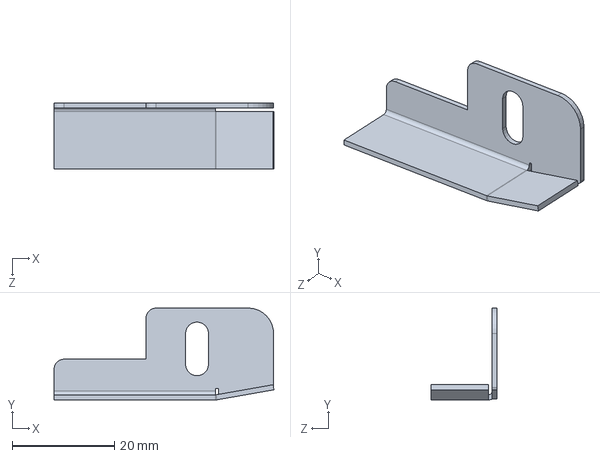
[picture p301: CAD file, 2025-09-29]
hardware/3d_models/4. Empaquetado/FormadorDeBolsas/FS/guide2.SLDPRT
43.1 x 18.0 x 13.0 mm
