Sebastian-Jaimes/EMC_IoT/hardware/3d_models/2. Transporte/Tubo Canalón.SLDPRT

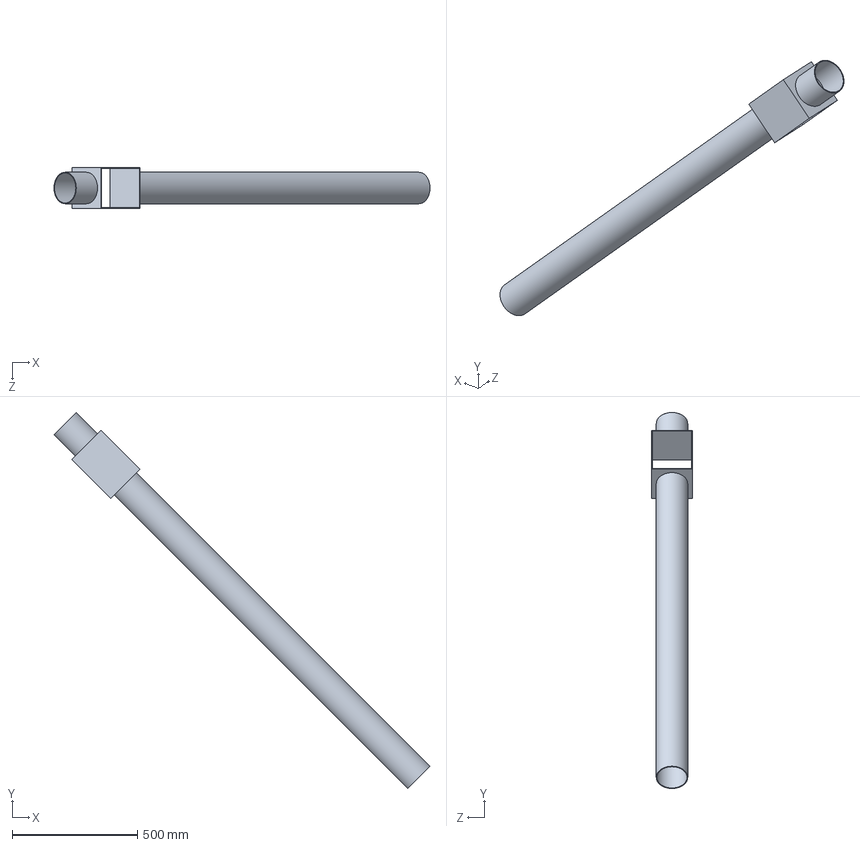
[picture p302: CAD file, 2025-09-29]
hardware/3d_models/2. Transporte/Tubo Canalón.SLDPRT
1503.3 x 1503.3 x 162.0 mm
