Sebastian-Jaimes/EMC_IoT/hardware/3d_models/3. Dosificadora/DosificadoraVolumetricav2.0.0/CubiertaDosificador.SLDPRT

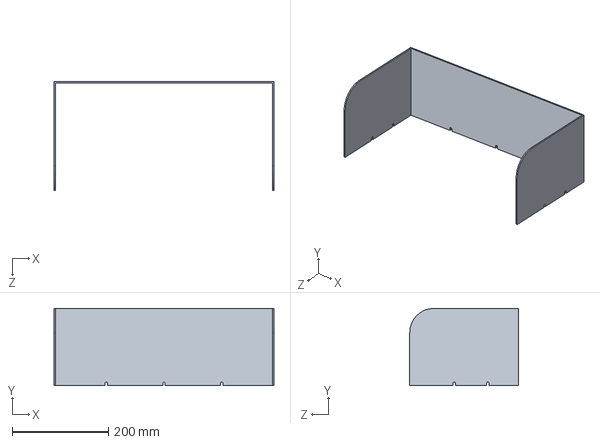
[picture p303: CAD file, 2025-09-29]
hardware/3d_models/3. Dosificadora/DosificadoraVolumetricav2.0.0/CubiertaDosificador.SLDPRT
456.0 x 160.0 x 225.0 mm
