Sebastian-Jaimes/EMC_IoT/hardware/3d_models/4. Empaquetado/FormadorDeBolsas/FS/body.SLDPRT

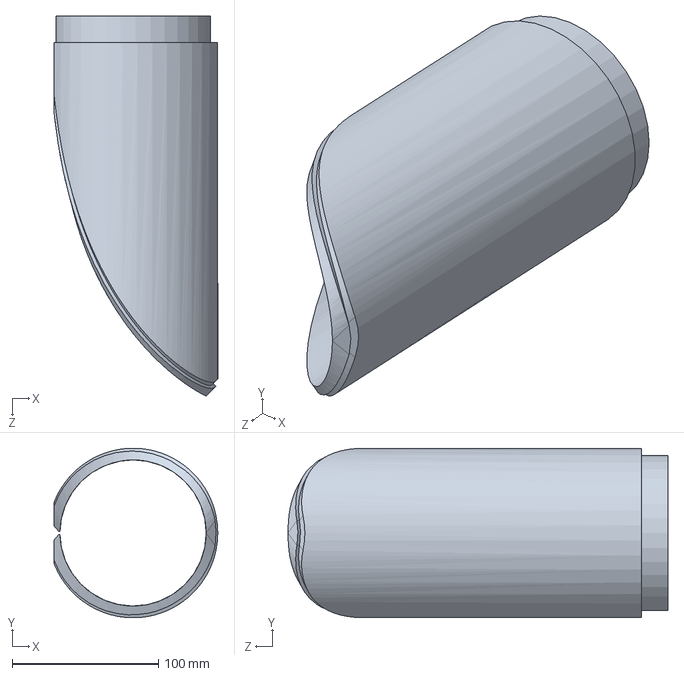
[picture p304: CAD file, 2025-09-29]
hardware/3d_models/4. Empaquetado/FormadorDeBolsas/FS/body.SLDPRT
112.0 x 116.0 x 260.0 mm
