Sebastian-Jaimes/EMC_IoT/hardware/3d_models/2. Transporte/Union_tolva_transportador.SLDPRT

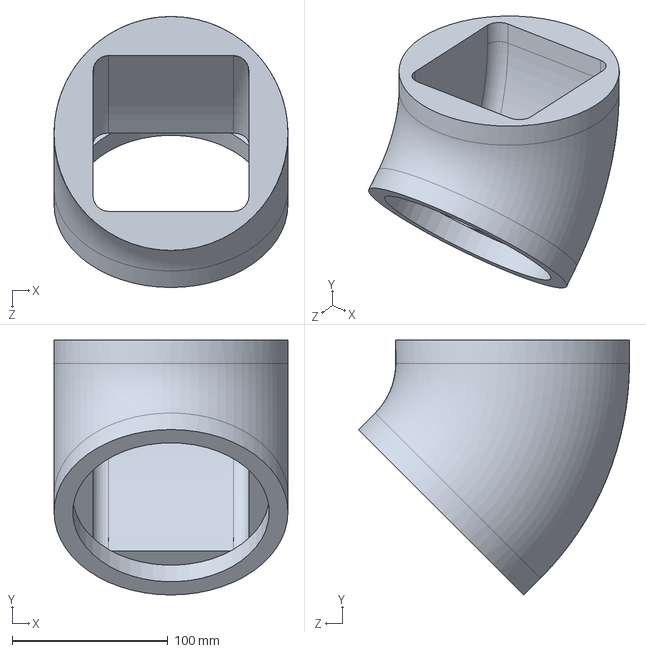
[picture p305: CAD file, 2025-09-29]
hardware/3d_models/2. Transporte/Union_tolva_transportador.SLDPRT
150.0 x 163.5 x 173.8 mm
