Sebastian-Jaimes/EMC_IoT/hardware/3d_models/3. Dosificadora/Base.SLDPRT

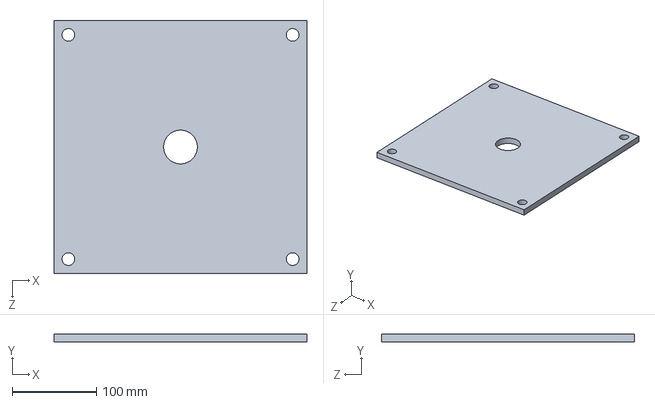
[picture p306: CAD file, 2024-09-10]
hardware/3d_models/3. Dosificadora/Base.SLDPRT
300.0 x 10.0 x 300.0 mm
