Sebastian-Jaimes/EMC_IoT/hardware/3d_models/3. Dosificadora/DosificadoraVolumetricav2.0.0/SoporteAlimentacionDosificador.SLDPRT

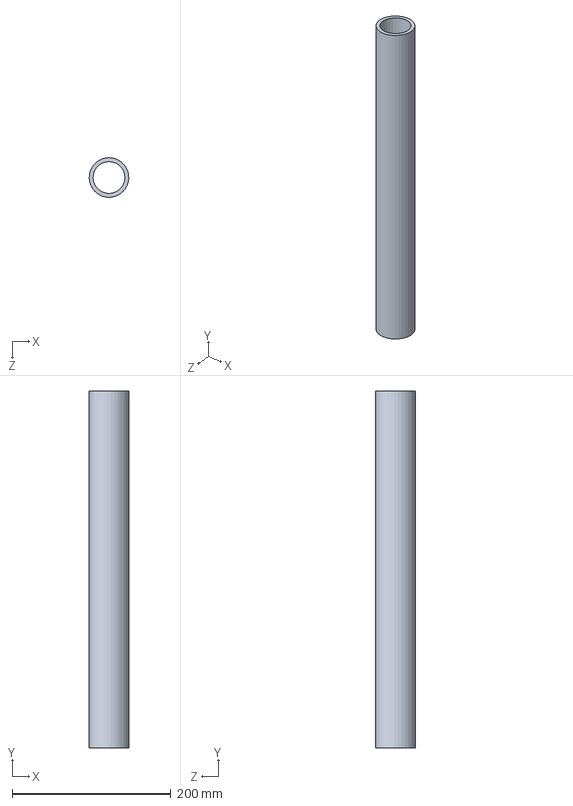
[picture p307: CAD file, 2025-09-29]
hardware/3d_models/3. Dosificadora/DosificadoraVolumetricav2.0.0/SoporteAlimentacionDosificador.SLDPRT
49.9 x 450.0 x 50.0 mm
