Sebastian-Jaimes/EMC_IoT/hardware/3d_models/4. Empaquetado/FormadorDeBolsas/FS/Bagformer.STEP

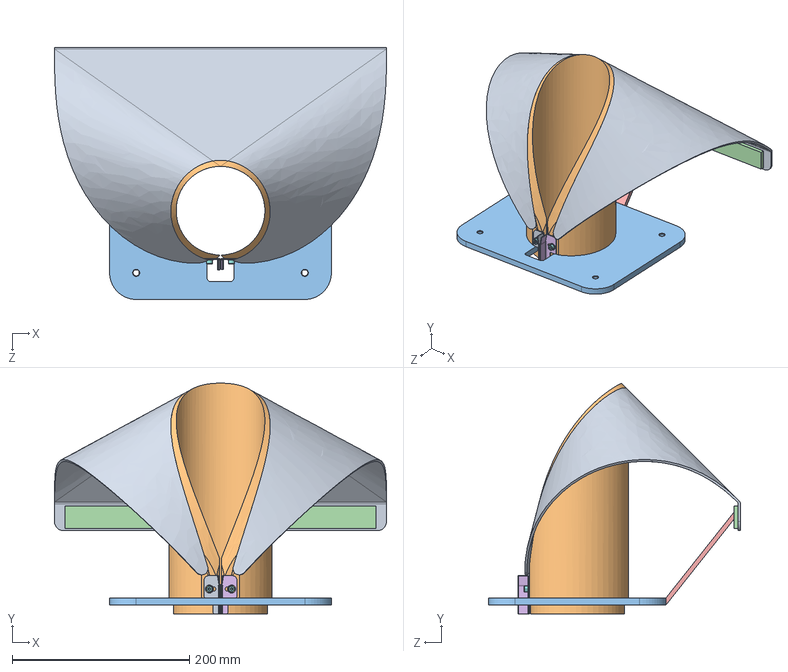
[picture p308: CAD file, 2025-09-29]
hardware/3d_models/4. Empaquetado/FormadorDeBolsas/FS/Bagformer.STEP
374.2 x 260.0 x 283.9 mm
sheet metal
flange
support
beam
guide
washer iso 7089 - 4_Washer ISO 7089 - 4 x 2
en iso 4762 m4 x 6 - 6n_EN ISO 4762 M4 x 6 - 6N x 2
guide2
