Sebastian-Jaimes/EMC_IoT/hardware/3d_models/2. Transporte/Pulley.SLDPRT

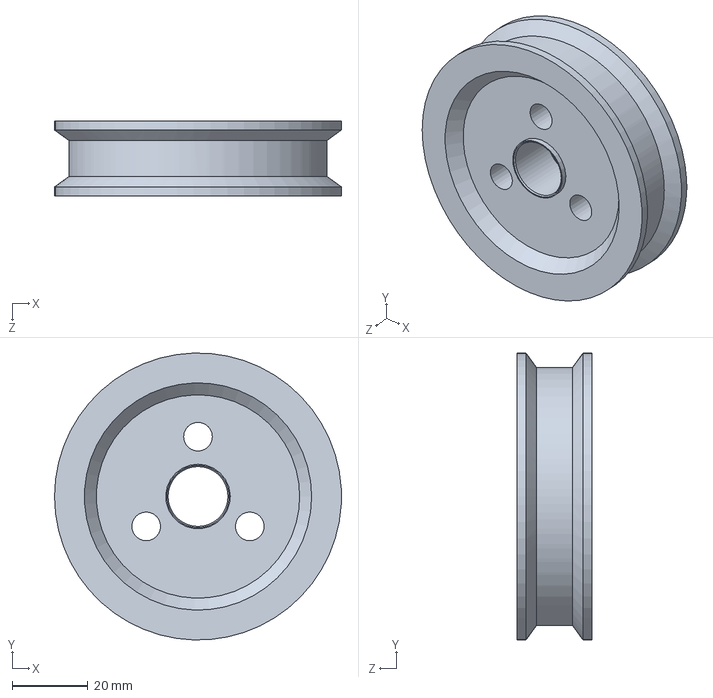
[picture p309: CAD file, 2025-09-29]
hardware/3d_models/2. Transporte/Pulley.SLDPRT
76.0 x 76.0 x 19.8 mm
