Sebastian-Jaimes/EMC_IoT/hardware/3d_models/3. Dosificadora/DosificadoraVolumetricav2.0.0/SoporteLateral.SLDPRT

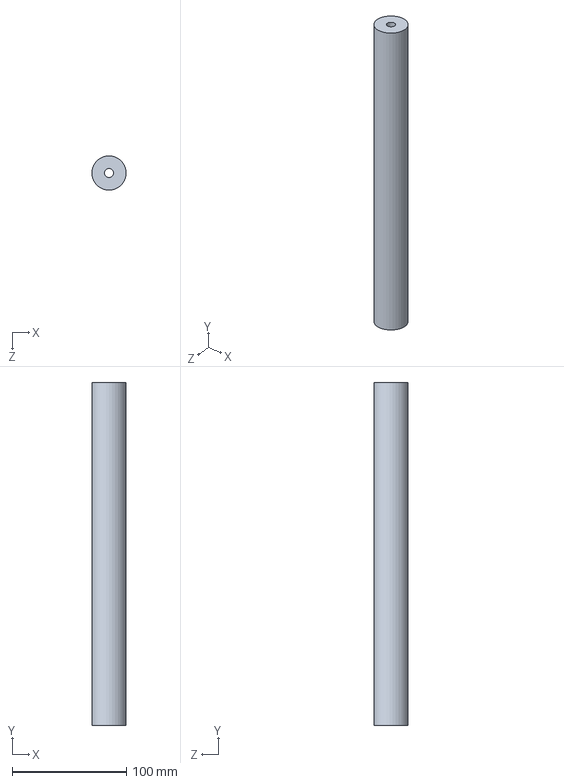
[picture p310: CAD file, 2025-09-29]
hardware/3d_models/3. Dosificadora/DosificadoraVolumetricav2.0.0/SoporteLateral.SLDPRT
29.9 x 300.0 x 30.0 mm
