Sebastian-Jaimes/EMC_IoT/hardware/3d_models/4. Empaquetado/FormadorDeBolsas/FS/EN ISO 4762 M4 x 6 - 6N.SLDPRT

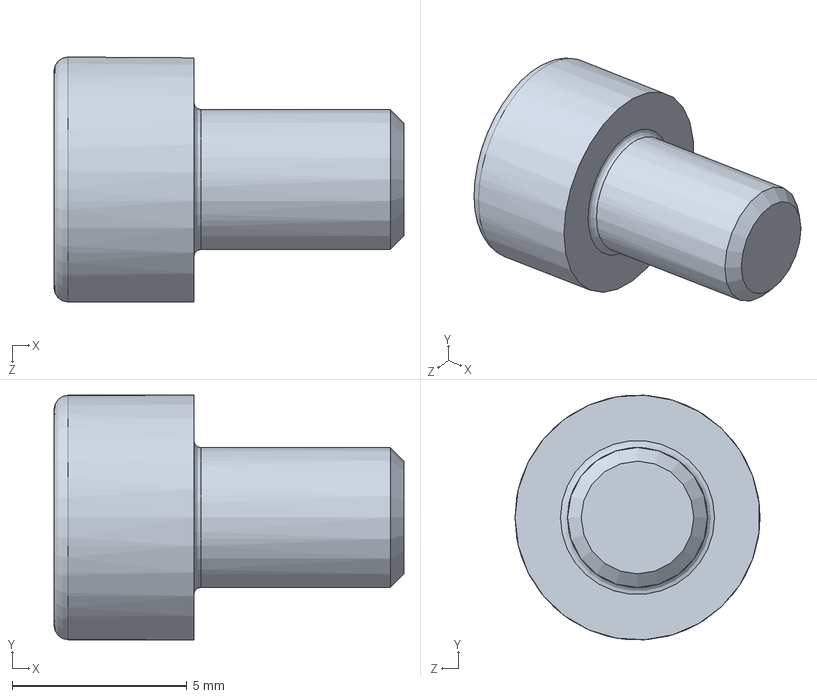
[picture p311: CAD file, 2025-09-29]
hardware/3d_models/4. Empaquetado/FormadorDeBolsas/FS/EN ISO 4762 M4 x 6 - 6N.SLDPRT
10.0 x 6.99 x 7.00 mm
