Sebastian-Jaimes/EMC_IoT/hardware/3d_models/3. Dosificadora/DosificadoraVolumetricav2.0.0/DiscoBaseDosificador.SLDPRT

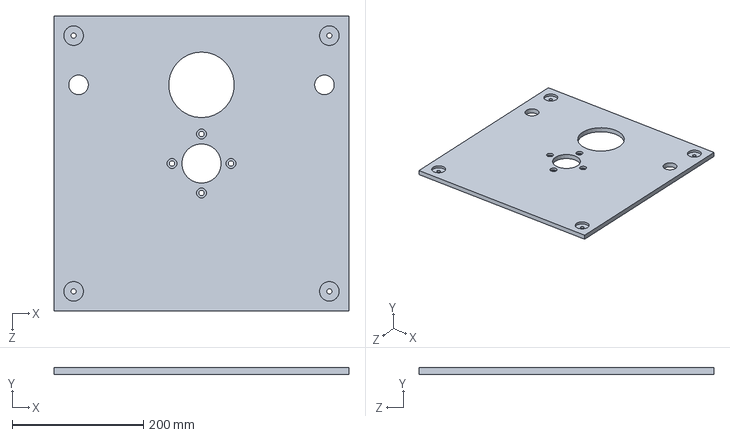
[picture p312: CAD file, 2025-09-29]
hardware/3d_models/3. Dosificadora/DosificadoraVolumetricav2.0.0/DiscoBaseDosificador.SLDPRT
450.0 x 10.0 x 450.0 mm
