Sebastian-Jaimes/EMC_IoT/hardware/3d_models/3. Dosificadora/DosificadoraVolumetricav2.0.0/VasoDosificador.SLDPRT

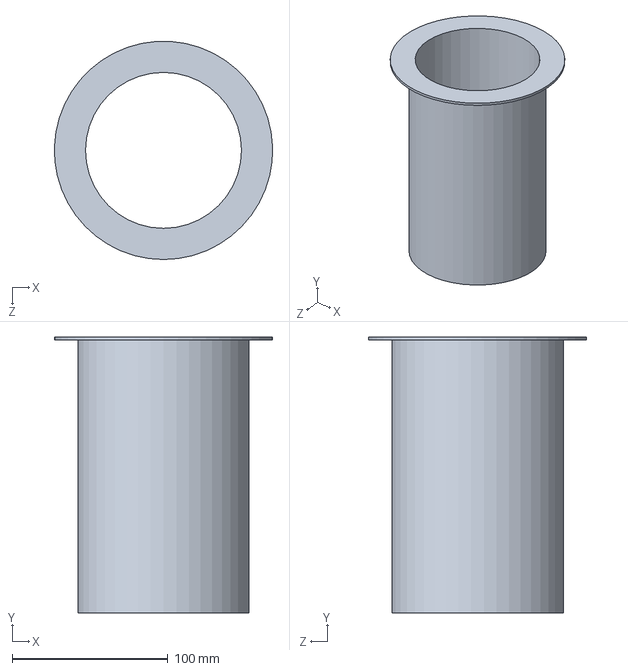
[picture p313: CAD file, 2025-09-29]
hardware/3d_models/3. Dosificadora/DosificadoraVolumetricav2.0.0/VasoDosificador.SLDPRT
139.9 x 177.0 x 139.8 mm
