Sebastian-Jaimes/EMC_IoT/hardware/3d_models/3. Dosificadora/DosificadoraVolumetricav2.0.0/BaseFormadorBolsas.SLDPRT

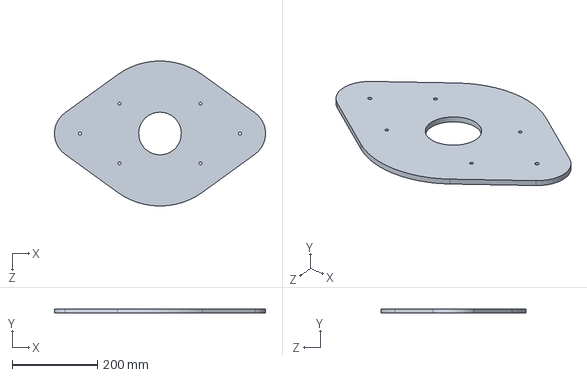
[picture p314: CAD file, 2025-09-29]
hardware/3d_models/3. Dosificadora/DosificadoraVolumetricav2.0.0/BaseFormadorBolsas.SLDPRT
494.6 x 10.0 x 340.0 mm
