Sebastian-Jaimes/EMC_IoT/hardware/3d_models/3. Dosificadora/Escobilla.SLDPRT

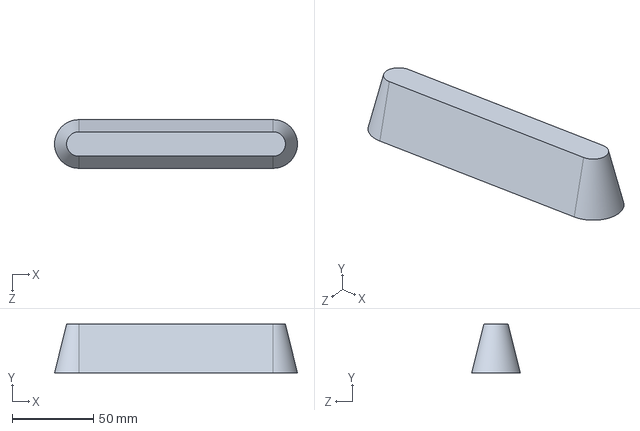
[picture p315: CAD file, 2024-09-10]
hardware/3d_models/3. Dosificadora/Escobilla.SLDPRT
150.0 x 30.0 x 30.0 mm
