Sebastian-Jaimes/EMC_IoT/hardware/3d_models/1. Almacenamiento/Tolva ensamblada.SLDASM

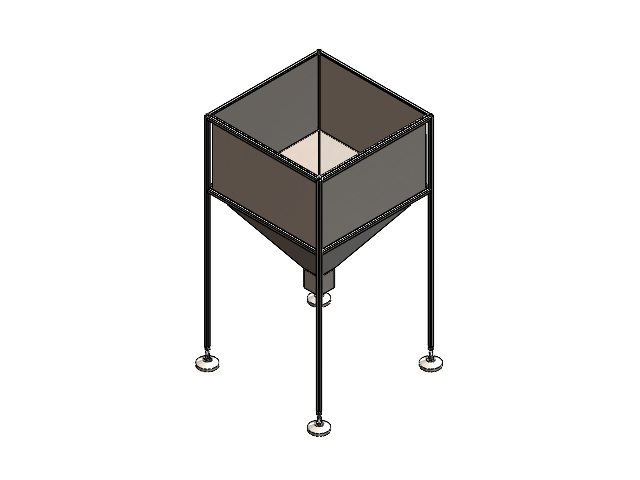
[picture p316: CAD file, 2025-09-29]
hardware/3d_models/1. Almacenamiento/Tolva ensamblada.SLDASM
Tolva
Base de la pata x 4
Goma de sopote x 4
Tornillo roscado de sopote x 4
hex nut heavy_am x 8
