Sebastian-Jaimes/EMC_IoT/hardware/3d_models/2. Transporte/Ensamble/TransportadorDeGranos.SLDASM

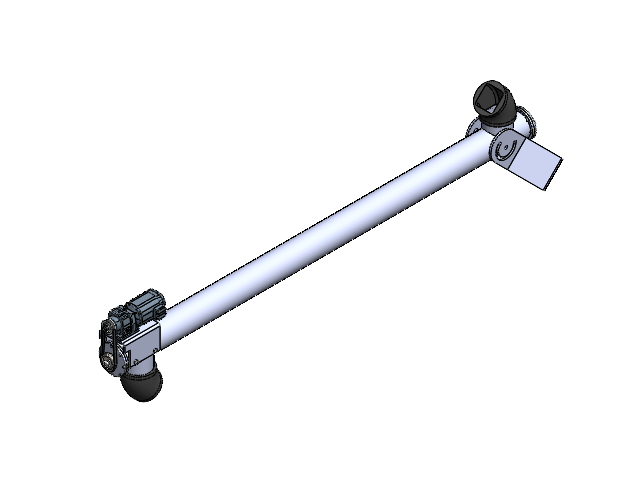
[picture p317: CAD file, 2025-09-29]
hardware/3d_models/2. Transporte/Ensamble/TransportadorDeGranos.SLDASM
TuboDeTransporte
TapaTuboDeTransporte_parte superior
TapaTuboDeTransporte
EjeDelTornilloHelicoidal-v2.0.0
Hélice-v2.0.0
formed hex screw_am x 26
hex nut jam_am x 24
ucfl206
Ara Mil
MotorTransportadorHelicoidal
SoporteMotorTransportador
Pulley
Pulley_2
SoporteInferiorTransportador
Union_tolva_transportador x 2
Correa3-3^TransportadorDeGranos
