Sebastian-Jaimes/EMC_IoT/hardware/3d_models/4. Empaquetado/Packaking_machine.SLDASM

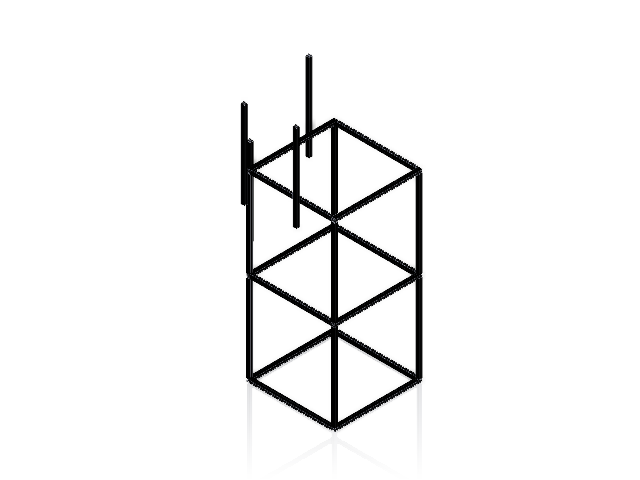
[picture p318: CAD file, 2024-09-10]
hardware/3d_models/4. Empaquetado/Packaking_machine.SLDASM
Perfil_VSlot_2020_600mm x 18
Perfil_VSlot_2020_560mm x 6
