Sebastian-Jaimes/EMC_IoT/hardware/3d_models/3. Dosificadora/DosificadoraVolumetricav2.0.0/Dosificador Volumetrico v2.0.0.SLDASM

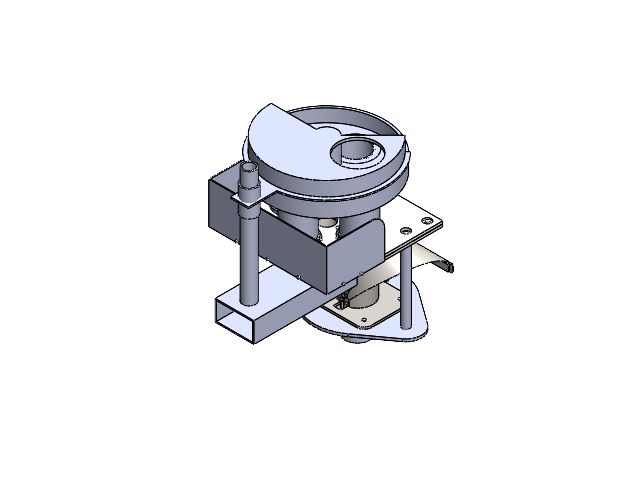
[picture p319: CAD file, 2025-09-29]
hardware/3d_models/3. Dosificadora/DosificadoraVolumetricav2.0.0/Dosificador Volumetrico v2.0.0.SLDASM
DiscoDosificador
VasoDosificador x 4
DiscoBaseDosificador
BaseVasoDosificador x 4
BaseMetalicaDosificador
hex bolt gradeb_iso x 8
hex nut gradec_iso x 8
BaseGuiaDosificador
SoporteAlimentacionDosificador
GuiaDosificadora
sheet metal
flange
support
beam
guide
plain washer normal grade a_iso x 2
socket head cap screw 4762_din x 2
guide2
BaseFormadorBolsas
formed hex screw_am x 8
hex nut style 1_am x 4
SoporteLateral x 2
CabinaDosificadora
CubiertaDosificador
