Sebastian-Jaimes/EMC_IoT/(list of files, cad)

Other CAD files:
hardware/3d_models/4. Empaquetado/FormadorDeBolsas/FormadoDeBolsas.SLDASM
hardware/3d_models/2. Transporte/IGS - Transportador/Eje del tornillo helicoidal.IGS
tests/Simulaciones/Dosificadora/Base del dosificador_Predeterminado_sldprt.STEP
tests/Simulaciones/Transportador/Tubo Canalón_Predeterminado_sldprt.STEP
tests/Simulaciones/Dosificadora 2/Disco Dosificador_Predeterminado_sldprt.STEP
hardware/3d_models/1. Almacenamiento/Goma de sopote.SLDPRT
hardware/3d_models/3. Dosificadora/Vaso volumétrico.SLDPRT
tests/Simulaciones/Dosificadora 2/taper pin unhardened_bsi_BS EN 22339 - A - 5 x 18 - St_sldprt.STEP
tests/Simulaciones/Dosificadora/Vaso volumétrico_Predeterminado_sldprt.STEP
hardware/3d_models/3. Dosificadora/Soporte para eje de dosificadora.SLDPRT
tests/Simulaciones/Dosificadora 2/Tapa de Vaso volumétrico_Predeterminado_sldprt.STEP
tests/Simulaciones/Dosificadora/Tapa de Vaso volumétrico_Predeterminado_sldprt.STEP
hardware/3d_models/3. Dosificadora/Covertor de dosificador.SLDPRT
tests/Simulaciones/Empaquetadora/Soporte para eje de dosificadora_Predeterminado_sldprt.STEP
hardware/3d_models/2. Transporte/TapaTuboDeTransporte_parte superior.SLDPRT
hardware/3d_models/3. Dosificadora/Base Inferior de la caja.SLDPRT
tests/Simulaciones/Dosificadora 2/clevis pin headed_bsi_BS EN 22341 - B - 5 x 24 x 1.2 - St_sldprt.STEP
tests/Simulaciones/Dosificadora/taper pin unhardened_bsi_BS EN 22339 - A - 5 x 18 - St_sldprt.STEP
hardware/3d_models/3. Dosificadora/Eje del dosificador.SLDPRT
tests/Simulaciones/Dosificadora 2/Rueda de vaso_Predeterminado_sldprt.STEP
tests/Simulaciones/Dosificadora/Covertor de dosificador_Predeterminado_sldprt.STEP
tests/Simulaciones/Empaquetadora/Disco Dosificador_Predeterminado_sldprt.STEP
hardware/3d_models/3. Dosificadora/Columna del dosificador.SLDPRT
hardware/3d_models/3. Dosificadora/IGS - Dosificadora/Eje del dosificador.IGS
tests/Simulaciones/Dosificadora/Columna del dosificador_Predeterminado_sldprt.STEP
tests/Simulaciones/Empaquetadora/Sensor de carga 5 kgf_Predeterminado_sldprt.STEP
hardware/3d_models/3. Dosificadora/IGS - Dosificadora/Soporte para eje de dosificadora.IGS
tests/Simulaciones/Dosificadora/Base_Predeterminado_sldprt.STEP
tests/Simulaciones/Empaquetadora/Goma de sopote_Predeterminado_sldprt.STEP
hardware/3d_models/3. Dosificadora/Columna de caja base.SLDPRT
hardware/3d_models/3. Dosificadora/IGS - Dosificadora/Base.IGS
tests/Simulaciones/Dosificadora/Pata del dosificador_Predeterminado_sldprt.STEP
tests/Simulaciones/Empaquetadora/Base de la pata_Predeterminado_sldprt.STEP
hardware/3d_models/3. Dosificadora/Tapa de Vaso volumétrico.SLDPRT
tests/Simulaciones/Dosificadora/Rueda de vaso_Predeterminado_sldprt.STEP
tests/Simulaciones/Empaquetadora/Tapa de Vaso volumétrico_Predeterminado_sldprt.STEP
hardware/3d_models/3. Dosificadora/Pata del dosificador.SLDPRT
tests/Simulaciones/Dosificadora/Disco Dosificador_Predeterminado_sldprt.STEP
tests/Simulaciones/Empaquetadora/Vaso volumétrico_Predeterminado_sldprt.STEP
tests/Simulaciones/Dosificadora/Escobilla_Predeterminado_sldprt.STEP
tests/Simulaciones/Empaquetadora/Base del dosificador_Predeterminado_sldprt.STEP
tests/Simulaciones/Dosificadora/Base Inferior de la caja_Predeterminado_sldprt.STEP
tests/Simulaciones/Empaquetadora/Columna del dosificador_Predeterminado_sldprt.STEP
tests/Simulaciones/Empaquetadora/Eje del tornillo helicoidal_Predeterminado_sldprt.STEP
tests/Simulaciones/Empaquetadora/Columna de caja base_Predeterminado_sldprt.STEP
tests/Simulaciones/Dosificadora/Eje del dosificador_Predeterminado_sldprt.STEP
tests/Simulaciones/Empaquetadora/clevis pin headed_bsi_BS EN 22341 - B - 5 x 24 x 1.2 - St_sldprt.STEP
tests/Simulaciones/Empaquetadora/Escobilla_Predeterminado_sldprt.STEP
tests/Simulaciones/Empaquetadora/Rueda de vaso_Predeterminado_sldprt.STEP
tests/Simulaciones/Empaquetadora/Base Inferior de la caja_Predeterminado_sldprt.STEP
tests/Simulaciones/Empaquetadora/Base_Predeterminado_sldprt.STEP
tests/Simulaciones/Empaquetadora/Tubo Canalón_Predeterminado_sldprt.STEP
tests/Simulaciones/Empaquetadora/Pata del dosificador_Predeterminado_sldprt.STEP
hardware/3d_models/2. Transporte/Eje del tornillo helicoidal.SLDPRT
hardware/3d_models/2. Transporte/Planos - Transportador/Eje del tornillo helicoidal.SLDDRW
hardware/3d_models/2. Transporte/Planos - Transportador/Hélice.SLDDRW
hardware/3d_models/2. Transporte/Planos - Transportador/Tubo Canalón.SLDDRW
hardware/3d_models/3. Dosificadora/Planos - Dosificadora/Base Inferior de la caja.SLDDRW
hardware/3d_models/3. Dosificadora/Planos - Dosificadora/Base del dosificador.SLDDRW
hardware/3d_models/3. Dosificadora/Planos - Dosificadora/Base.SLDDRW
hardware/3d_models/3. Dosificadora/Planos - Dosificadora/Columna de caja base.SLDDRW
hardware/3d_models/3. Dosificadora/Planos - Dosificadora/Columna del dosificador.SLDDRW
hardware/3d_models/3. Dosificadora/Planos - Dosificadora/Covertor de dosificador.SLDDRW
hardware/3d_models/3. Dosificadora/Planos - Dosificadora/Disco Dosificador.SLDDRW
hardware/3d_models/3. Dosificadora/Planos - Dosificadora/Dosificador Volumétrico.SLDDRW
hardware/3d_models/3. Dosificadora/Planos - Dosificadora/Eje del dosificador.SLDDRW
hardware/3d_models/3. Dosificadora/Planos - Dosificadora/Pata del dosificador.SLDDRW
hardware/3d_models/3. Dosificadora/Planos - Dosificadora/Soporte para eje de dosificadora.SLDDRW
hardware/3d_models/3. Dosificadora/Planos - Dosificadora/Tapa de Vaso volumétrico.SLDDRW
hardware/3d_models/3. Dosificadora/Planos - Dosificadora/Vaso volumétrico.SLDDRW
hardware/3d_models/4. Empaquetado/FormadorDeBolsas/FS/Bagformer.SLDASM
hardware/3d_models/4. Empaquetado/FormadorDeBolsas/FS/Washer ISO 7089 - 4.SLDPRT
hardware/drawings/Maquina_completa.SLDDRW
hardware/drawings/Tolva/Goma de Soporte.SLDDRW
hardware/drawings/Tolva/Tolva ensamblada.SLDDRW
hardware/drawings/Tolva/Tolva.SLDDRW
hardware/drawings/Tolva/Tornillo roscado de sopote.SLDDRW
tests/Simulaciones/Dosificadora 2/pan head tapping screw_am_PHT 4.8x20x18.4-slot-B-N_sldprt.STEP
tests/Simulaciones/Dosificadora/pan head tapping screw_am_PHT 4.8x20x18.4-slot-B-N_sldprt.STEP
tests/Simulaciones/Empaquetadora/hex nut heavy_am_B18.2.4.6M - Heavy hex nut- M12 x 1.75 --W-N_sldprt.STEP
tests/Simulaciones/Empaquetadora/pan head tapping screw_am_PHT 4.8x20x18.4-slot-B-N_sldprt.STEP
