Sebastian-Jaimes/EMC_IoT/docs/MDM/5. PROYECTO/Metodología del diseño mecatrónico- Grupo/INFORME_INTEGRAL/Ensamble total.pdf

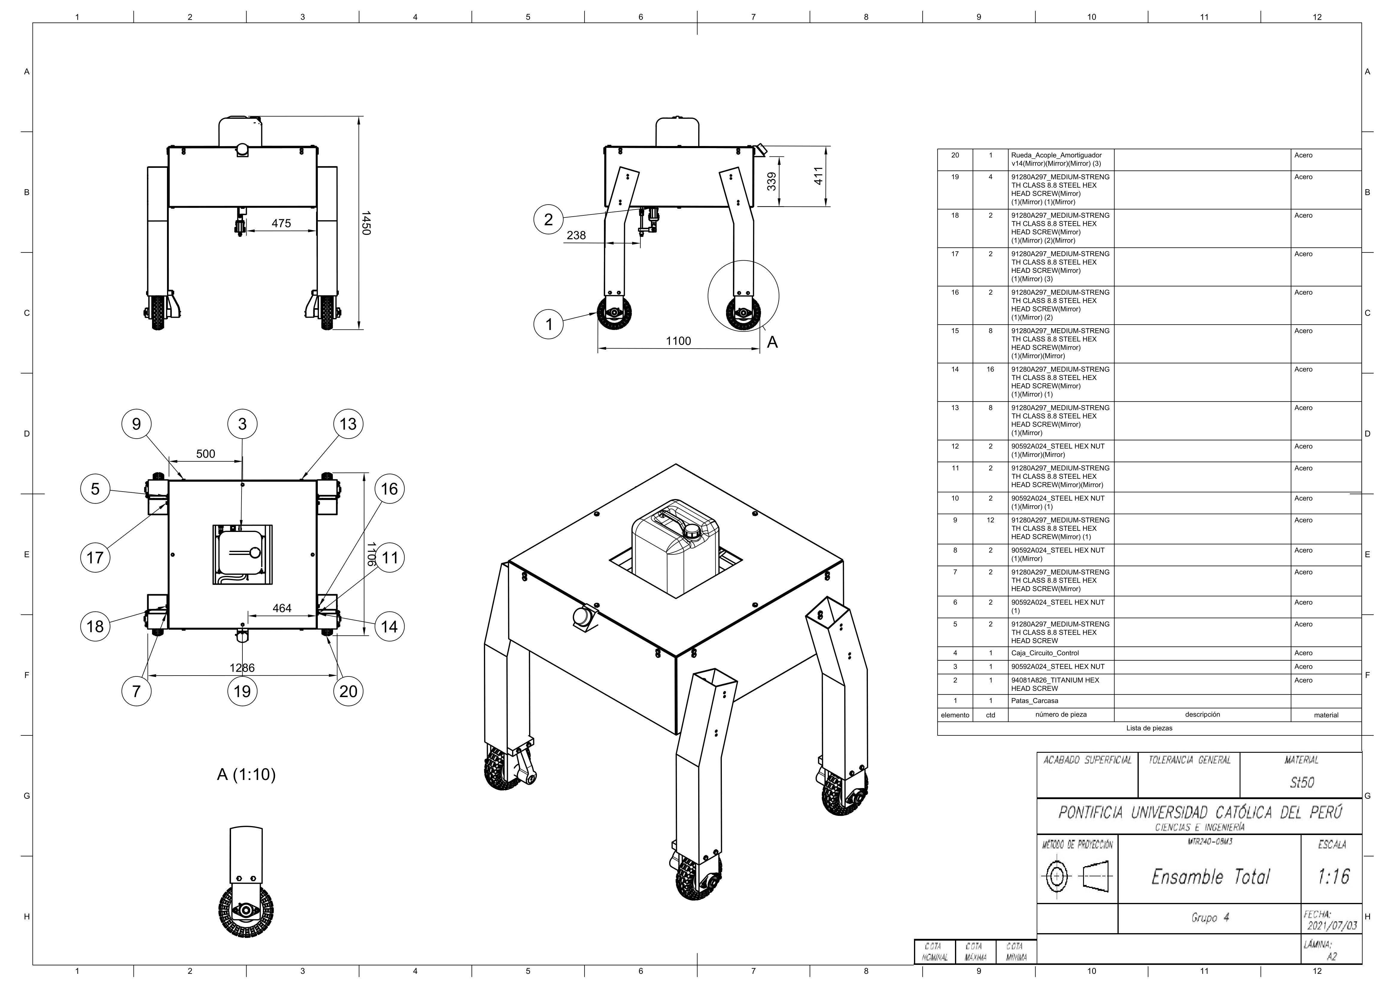
[picture p320: page 1]
