Sebastian-Jaimes/EMC_IoT/hardware/drawings/Tolva/Tolva ensamblada-1.png

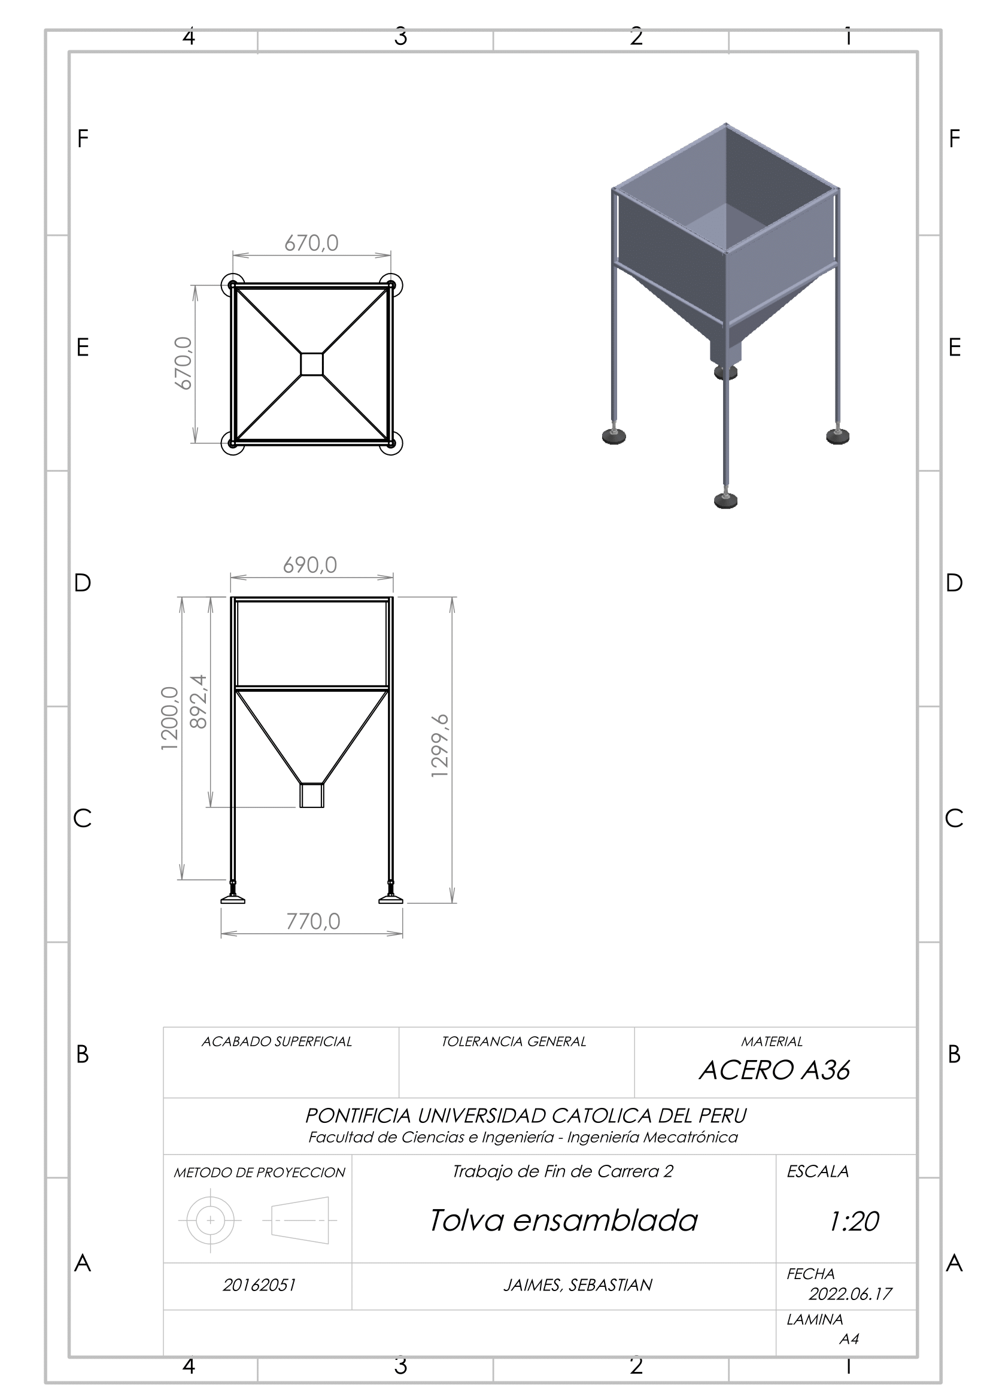
hardware/drawings/Tolva/Tolva ensamblada-1.png
