Sebastian-Jaimes/EMC_IoT/tests/README.md

# Tests

Este directorio contiene las pruebas automatizadas para el proyecto **_EMC_IoT_**. Las pruebas están diseñadas para asegurar que el software y el firmware funcionen correctamente y para detectar posibles errores en el desarrollo.

## Contenido

- **unit/**: Pruebas unitarias para el código fuente.
- **integration/**: Pruebas de integración para verificar la interacción entre diferentes componentes.
- **e2e/**: Pruebas de extremo a extremo para validar flujos completos del sistema.
- **fixtures/**: Datos y configuraciones necesarias para las pruebas.
- **scripts/**: Scripts para automatizar la ejecución de pruebas y otras tareas relacionadas.
