Sebastian-Jaimes/EMC_IoT/hardware/drawings/Maquina_completa.pdf

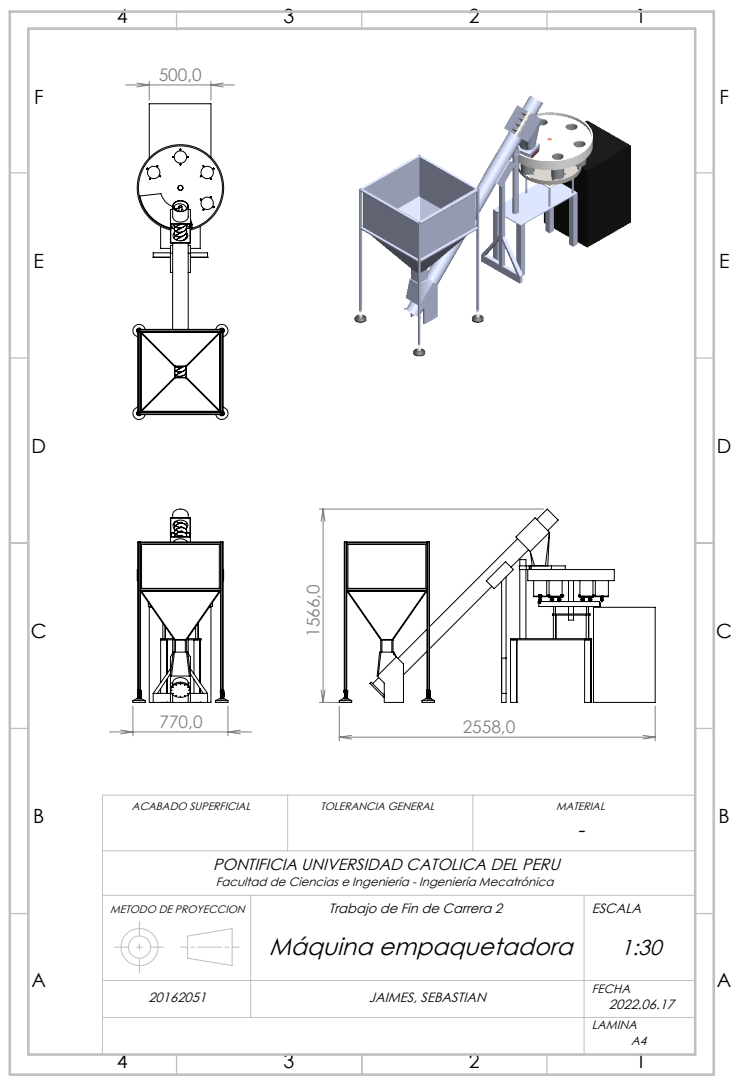
[picture p322: page 1]
JAIMES, SEBASTIAN; FECHA; Trabajo de Fin de Carrera 2; ESCALA; ACABADO SUPERFICIAL; TOLERANCIA GENERAL; MATERIAL

PONTIFICIA UNIVERSIDAD CATOLICA DEL PERU
Facultad de Ciencias e Ingeniería - Ingeniería Mecatrónica
Máquina empaquetadora

METODO DE PROYECCION
