Sebastian-Jaimes/EMC_IoT/hardware/drawings/Dosificadora/Base del dosificador.pdf

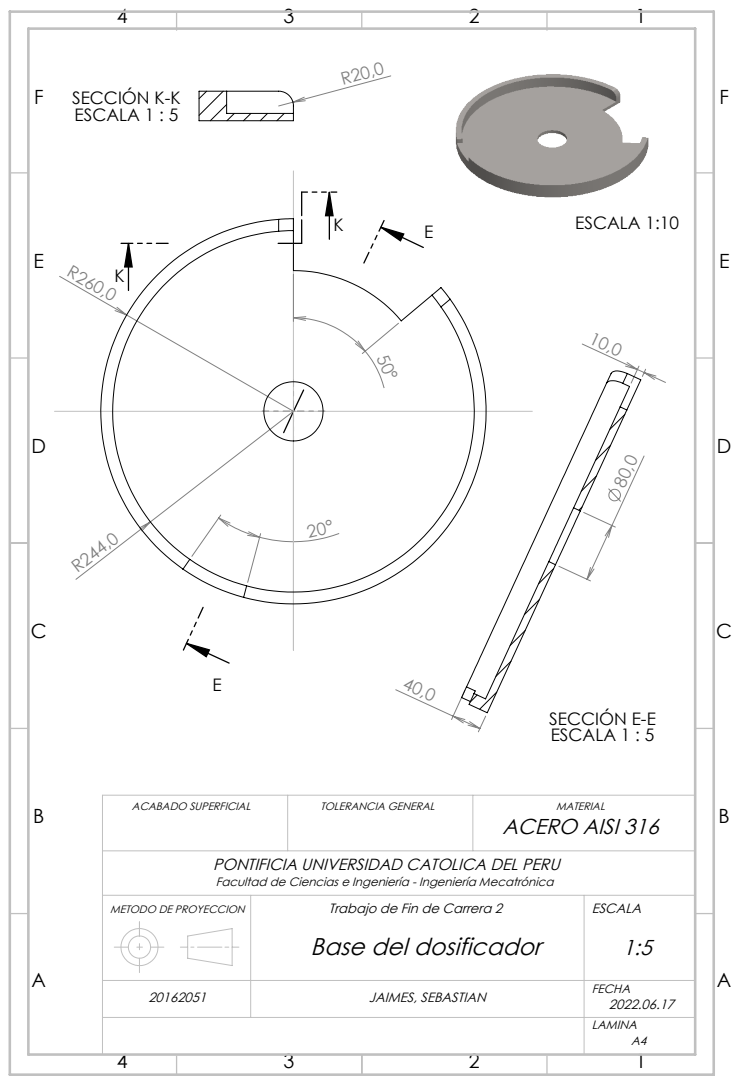
[picture p323: page 1]
ESCALA 1:10; SECCIÓN E-E ESCALA 1 : 5; SECCIÓN K-K ESCALA 1 : 5; JAIMES, SEBASTIAN; FECHA; Trabajo de Fin de Carrera 2; ESCALA; ACABADO SUPERFICIAL; TOLERANCIA GENERAL; MATERIAL; ACERO AISI 316

PONTIFICIA UNIVERSIDAD CATOLICA DEL PERU
Facultad de Ciencias e Ingeniería - Ingeniería Mecatrónica
Base del dosificador

METODO DE PROYECCION
