Sebastian-Jaimes/EMC_IoT/hardware/drawings/Dosificadora/Base Inferior de la caja.pdf

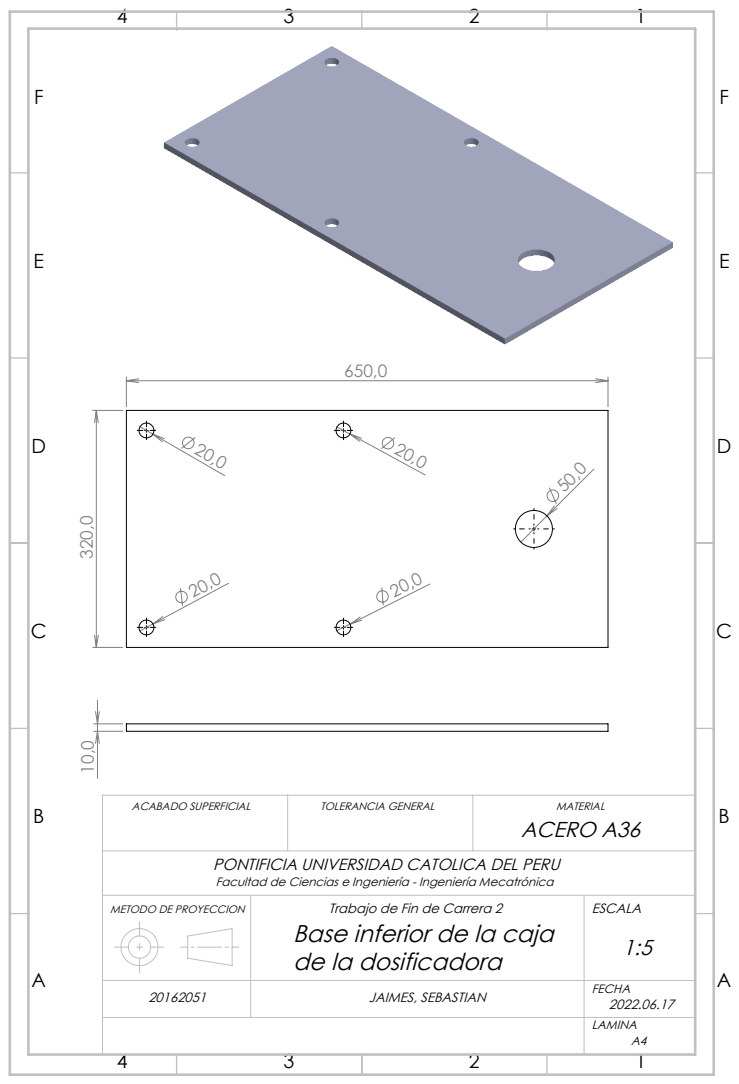
[picture p324: page 1]
JAIMES, SEBASTIAN; FECHA; Trabajo de Fin de Carrera 2; ESCALA; ACABADO SUPERFICIAL; TOLERANCIA GENERAL; MATERIAL; ACERO A36

PONTIFICIA UNIVERSIDAD CATOLICA DEL PERU
Facultad de Ciencias e Ingeniería - Ingeniería Mecatrónica
Base inferior de la caja
de la dosificadora

METODO DE PROYECCION
