Sebastian-Jaimes/EMC_IoT/hardware/drawings/Dosificadora/Columna de caja base.pdf

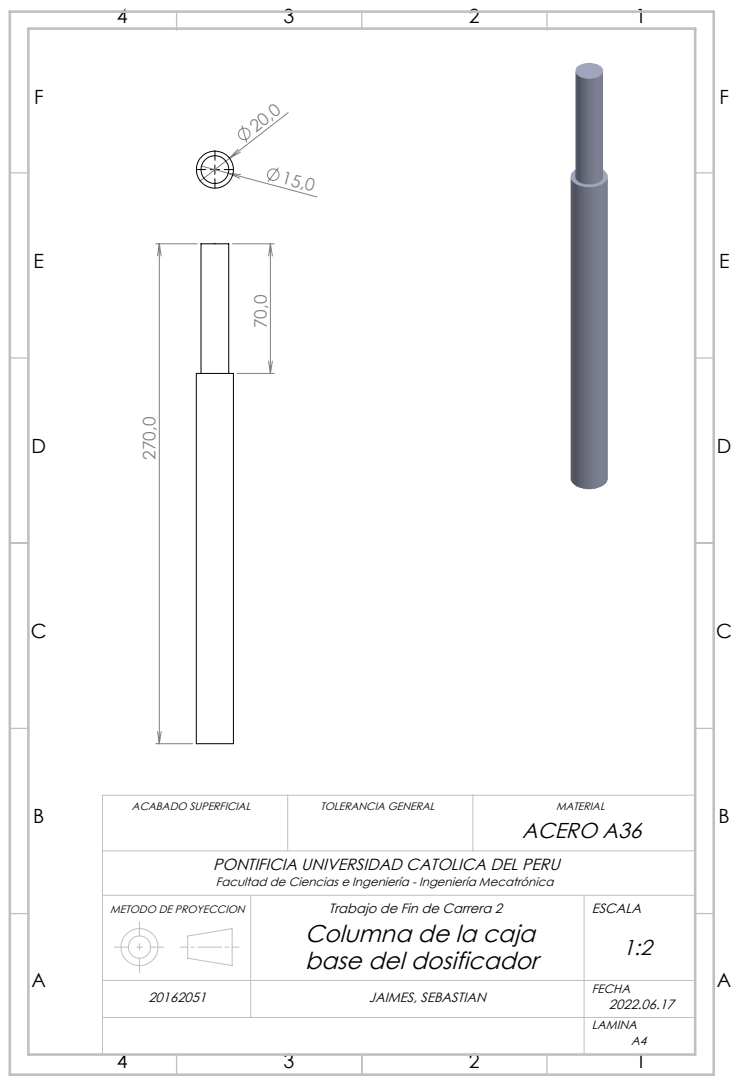
[picture p325: page 1]
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

PONTIFICIA UNIVERSIDAD CATOLICA DEL PERU
Facultad de Ciencias e Ingeniería - Ingeniería Mecatrónica
Columna de la caja
base del dosificador

METODO DE PROYECCION
