Sebastian-Jaimes/EMC_IoT/hardware/drawings/Dosificadora/Disco Dosificador.pdf

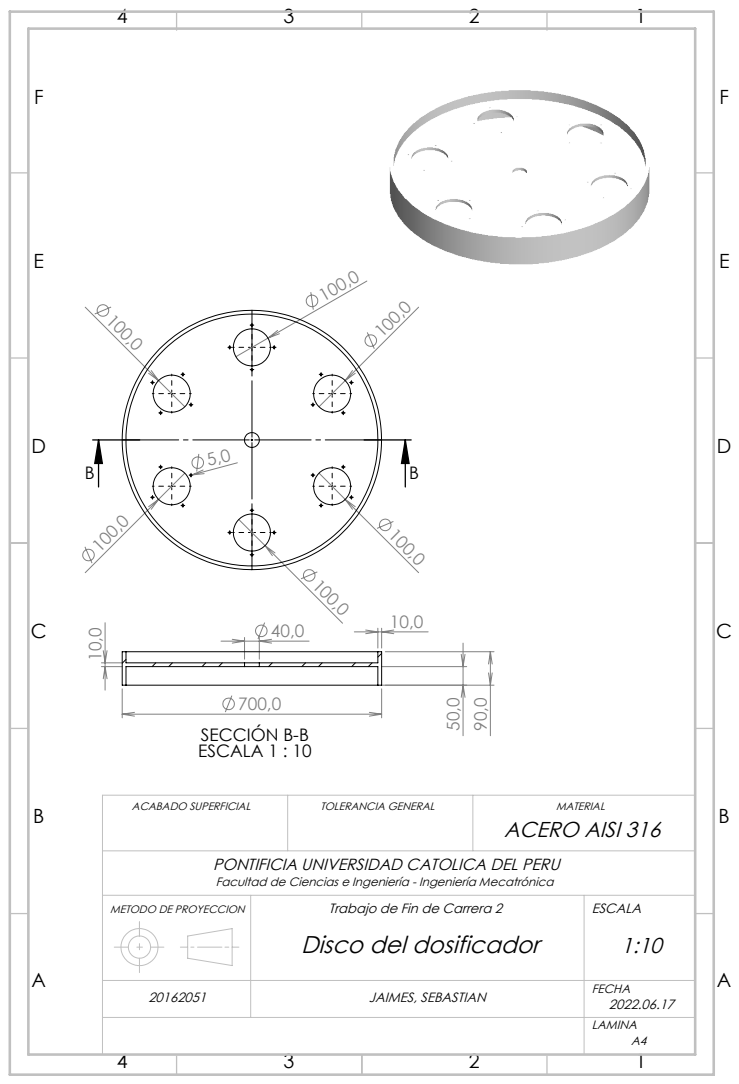
[picture p326: page 1]
SECCIÓN B-B ESCALA 1 : 10; JAIMES, SEBASTIAN; FECHA; Trabajo de Fin de Carrera 2; ESCALA; ACABADO SUPERFICIAL; TOLERANCIA GENERAL; MATERIAL; ACERO AISI 316

PONTIFICIA UNIVERSIDAD CATOLICA DEL PERU
Facultad de Ciencias e Ingeniería - Ingeniería Mecatrónica
Disco del dosificador

METODO DE PROYECCION
