Sebastian-Jaimes/EMC_IoT/hardware/drawings/Dosificadora/Dosificador Volumétrico.pdf

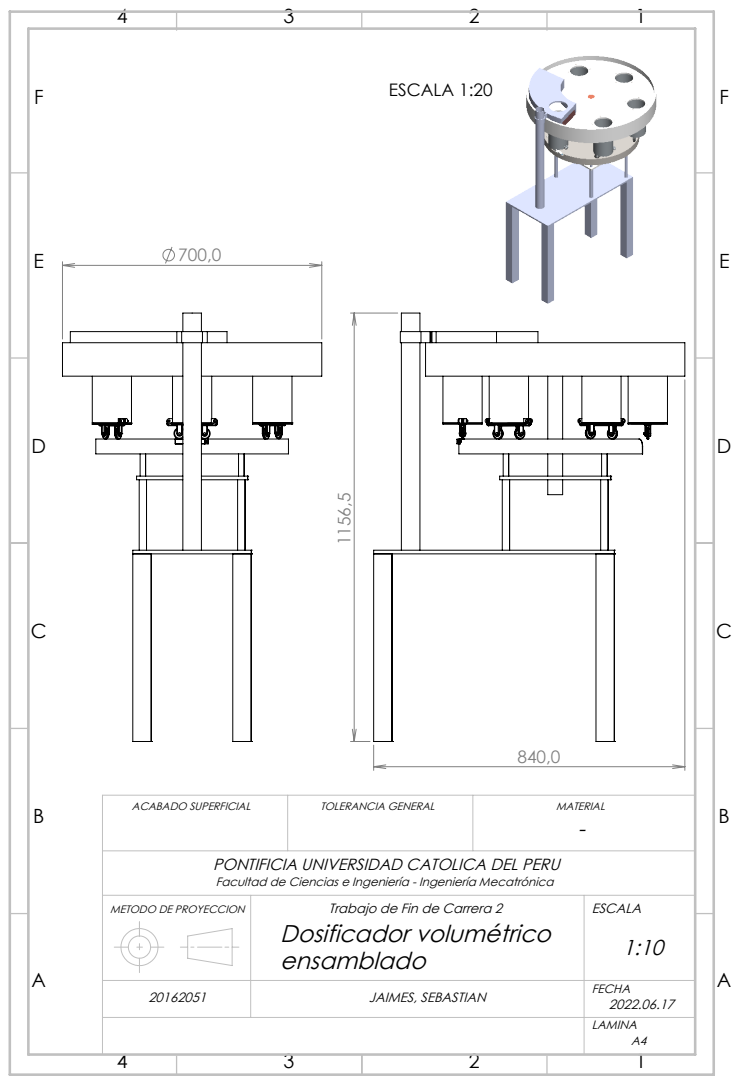
[picture p327: page 1]
ESCALA 1:20; JAIMES, SEBASTIAN; FECHA; Trabajo de Fin de Carrera 2; ESCALA; ACABADO SUPERFICIAL; TOLERANCIA GENERAL; MATERIAL

PONTIFICIA UNIVERSIDAD CATOLICA DEL PERU
Facultad de Ciencias e Ingeniería - Ingeniería Mecatrónica
Dosificador volumétrico
ensamblado

METODO DE PROYECCION
