Sebastian-Jaimes/EMC_IoT/hardware/drawings/Dosificadora/Vaso volumétrico.pdf

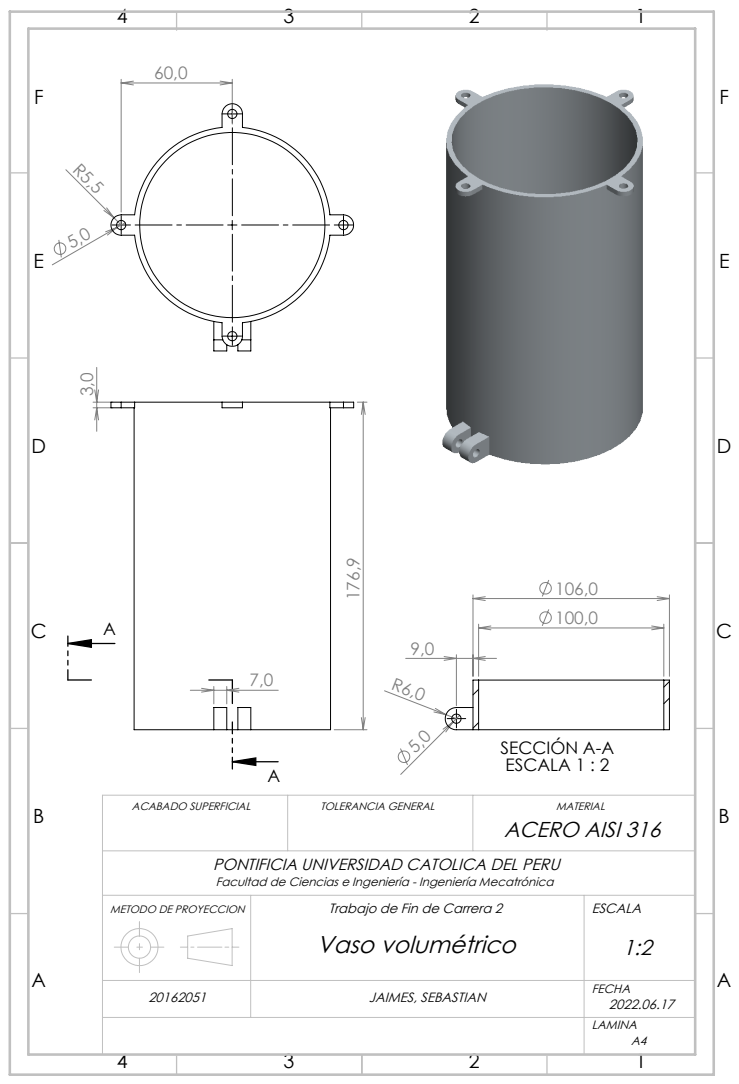
[picture p328: page 1]
SECCIÓN A-A ESCALA 1 : 2; JAIMES, SEBASTIAN; FECHA; Vaso volumétrico; Trabajo de Fin de Carrera 2; ESCALA; ACABADO SUPERFICIAL; TOLERANCIA GENERAL; MATERIAL; ACERO AISI 316

PONTIFICIA UNIVERSIDAD CATOLICA DEL PERU
Facultad de Ciencias e Ingeniería - Ingeniería Mecatrónica

METODO DE PROYECCION
