Sebastian-Jaimes/EMC_IoT/hardware/drawings/Tolva/Goma de Soporte.pdf

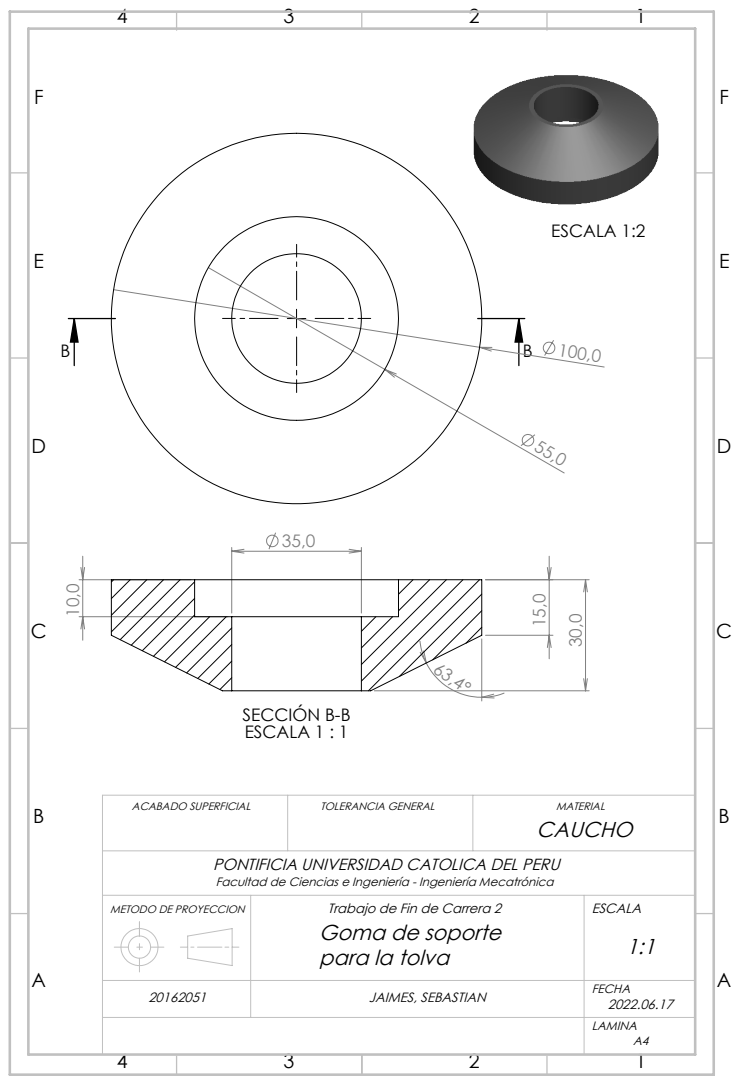
[picture p329: page 1]
ESCALA 1:2; SECCIÓN B-B ESCALA 1 : 1; JAIMES, SEBASTIAN; FECHA; Trabajo de Fin de Carrera 2; ESCALA; ACABADO SUPERFICIAL; TOLERANCIA GENERAL; MATERIAL

PONTIFICIA UNIVERSIDAD CATOLICA DEL PERU
Facultad de Ciencias e Ingeniería - Ingeniería Mecatrónica

METODO DE PROYECCION

Goma de soporte
para la tolva
