Sebastian-Jaimes/EMC_IoT/hardware/drawings/Transportador/Tubo Canalón.pdf

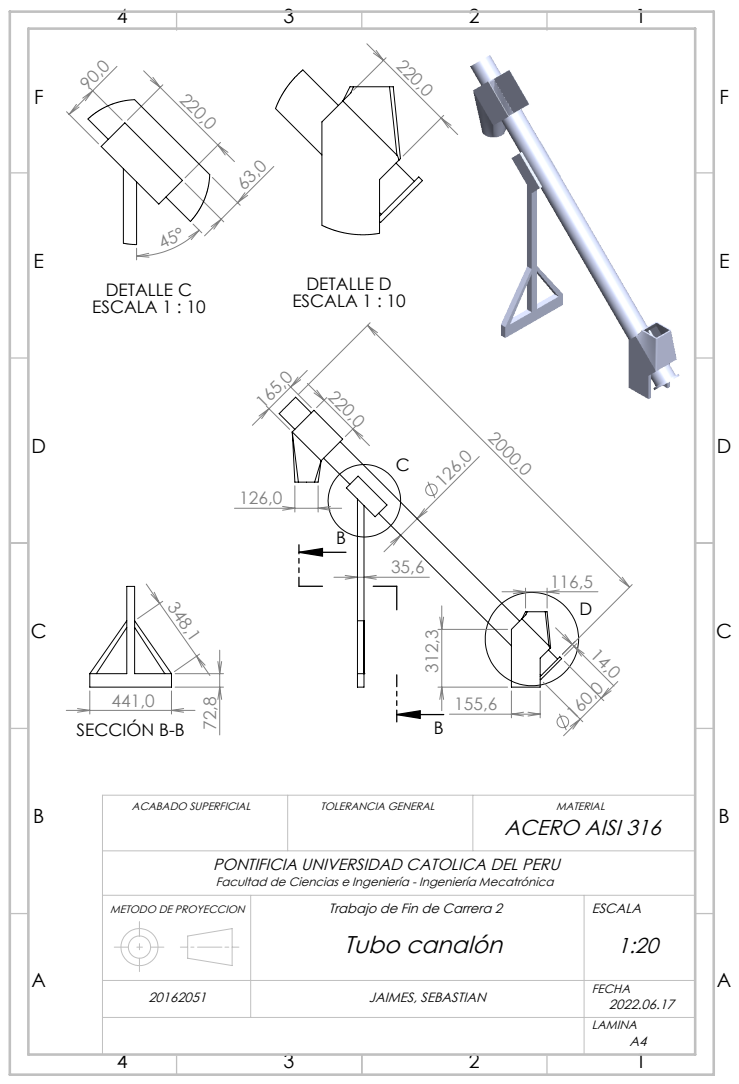
[picture p330: page 1]
SECCIÓN B-B; DETALLE C ESCALA 1 : 10; DETALLE D ESCALA 1 : 10; JAIMES, SEBASTIAN; FECHA; Tubo canalón; Trabajo de Fin de Carrera 2; ESCALA; ACABADO SUPERFICIAL; TOLERANCIA GENERAL; MATERIAL; ACERO AISI 316

PONTIFICIA UNIVERSIDAD CATOLICA DEL PERU
Facultad de Ciencias e Ingeniería - Ingeniería Mecatrónica

METODO DE PROYECCION
