Sebastian-Jaimes/EMC_IoT/docs/MDM/5. PROYECTO/Metodología del diseño mecatrónico- Grupo/INFORME_INTEGRAL/Acople_motor_pata v17.pdf

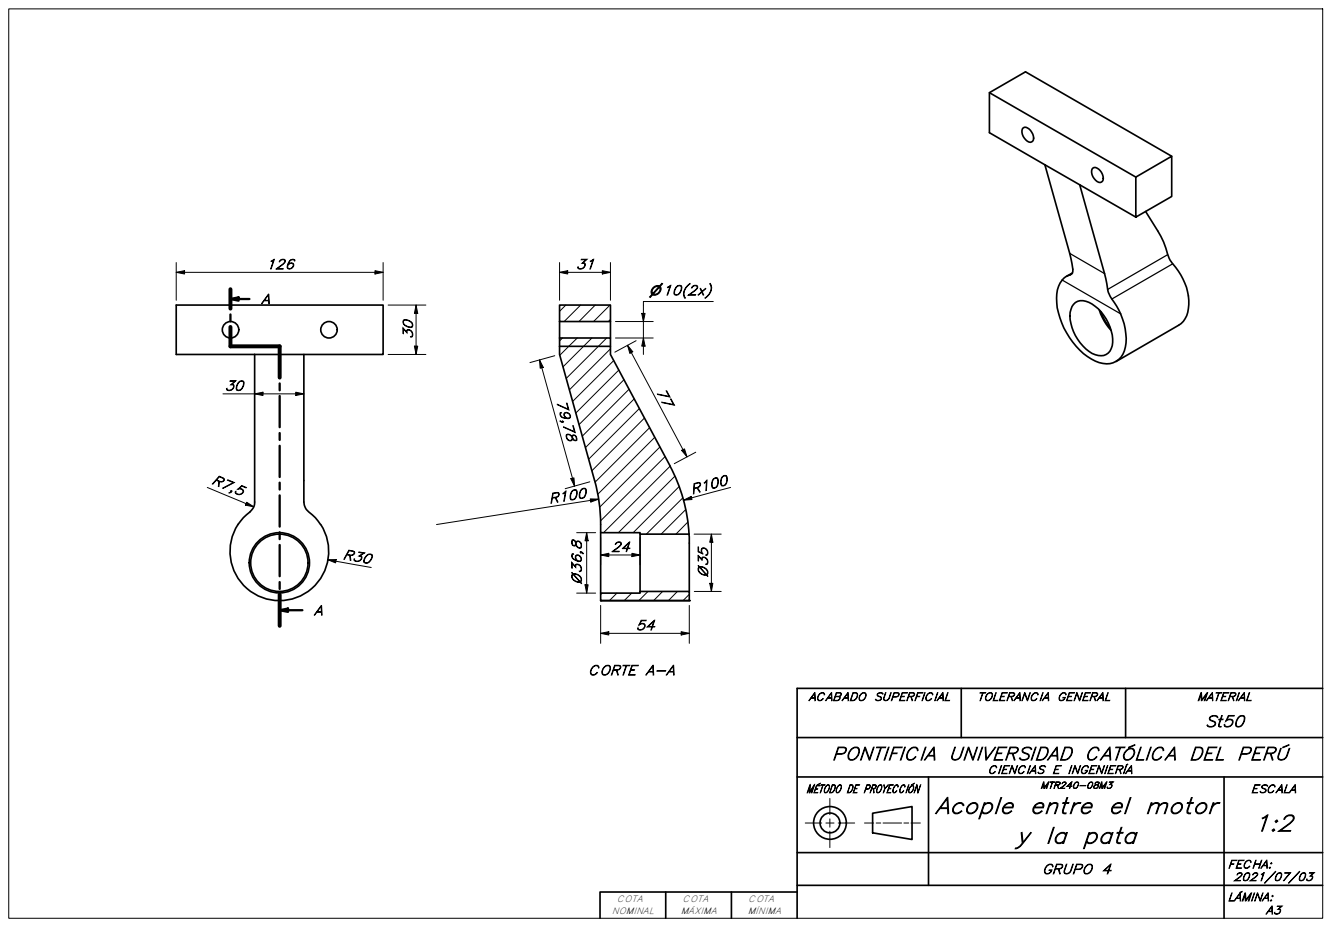
[picture p331: page 1]
CORTE A-A; ACABADO SUPERFICIAL; TOLERANCIA GENERAL; MATERIAL; MÉTODO DE PROYECCIÓN; ESCALA; GRUPO 4; y la pata

PONTIFICIA UNIVERSIDAD CATÓLICA DEL PERÚ

CIENCIAS E INGENIERÍA
Acople entre el motor
