Sebastian-Jaimes/EMC_IoT/docs/MDM/5. PROYECTO/Metodología del diseño mecatrónico- Grupo/INFORME_INTEGRAL/Acople_motor_rueda v2.pdf

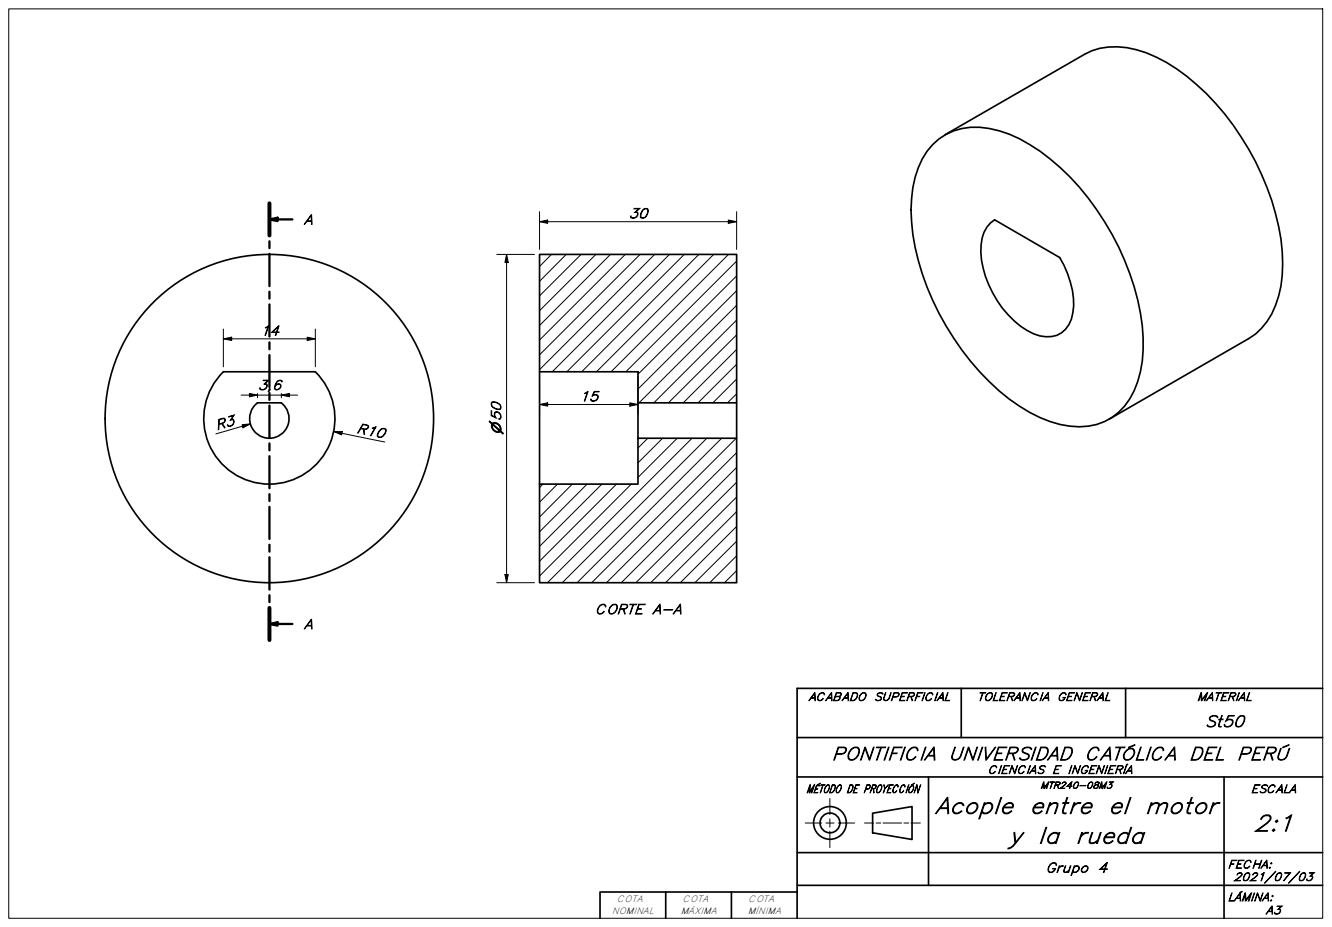
[picture p332: page 1]
CORTE A-A; ACABADO SUPERFICIAL; TOLERANCIA GENERAL; MATERIAL; MÉTODO DE PROYECCIÓN; ESCALA; Grupo 4; y la rueda

PONTIFICIA UNIVERSIDAD CATÓLICA DEL PERÚ

CIENCIAS E INGENIERÍA
Acople entre el motor
