Sebastian-Jaimes/EMC_IoT/docs/MDM/5. PROYECTO/Metodología del diseño mecatrónico- Grupo/INFORME_INTEGRAL/Eje v6.pdf

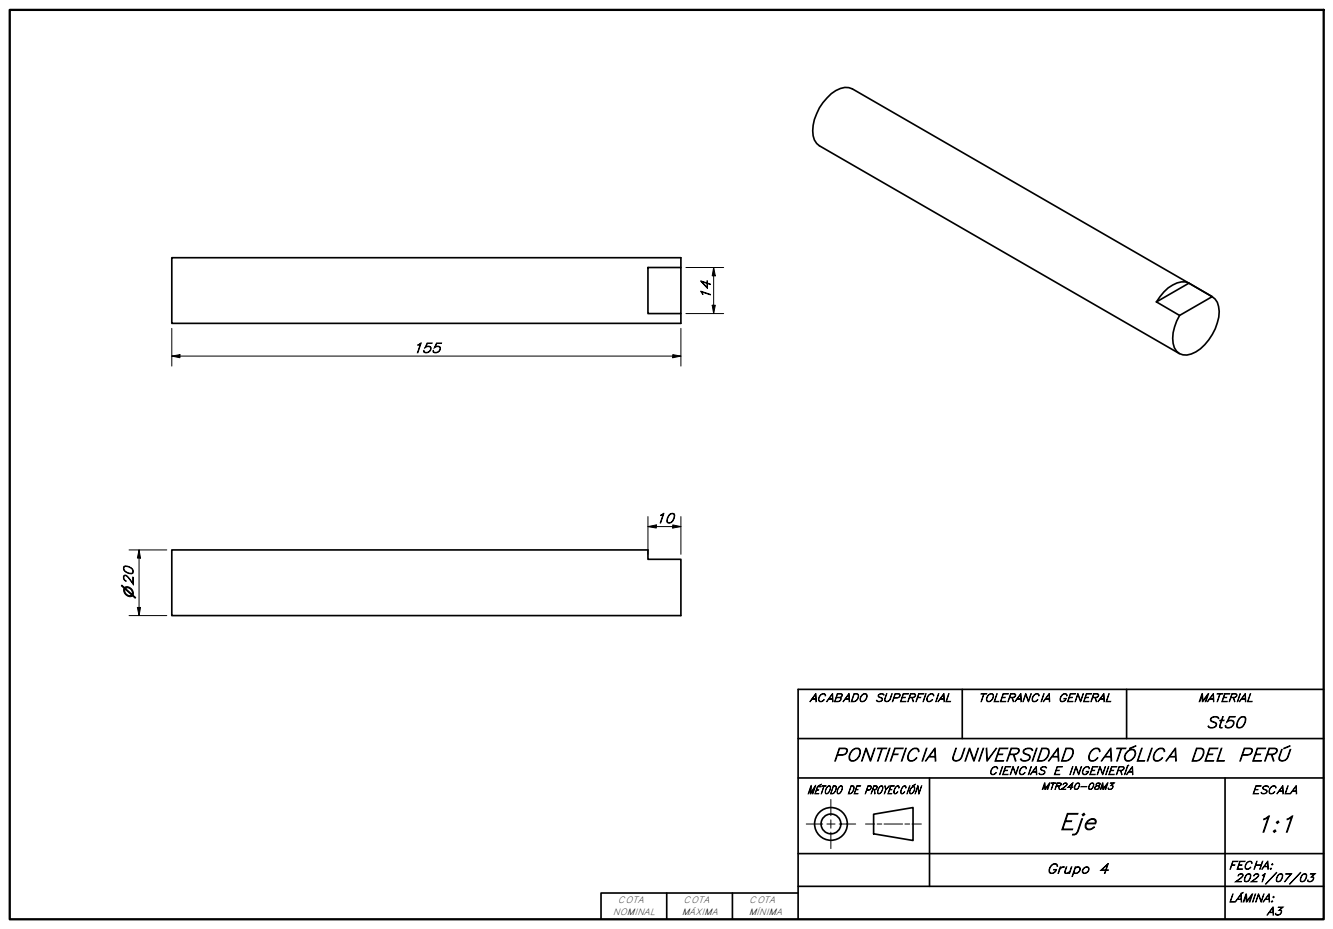
[picture p333: page 1]
ACABADO SUPERFICIAL; TOLERANCIA GENERAL; MATERIAL; MÉTODO DE PROYECCIÓN; ESCALA; Grupo 4; CIENCIAS E INGENIERÍA

PONTIFICIA UNIVERSIDAD CATÓLICA DEL PERÚ
