Sebastian-Jaimes/EMC_IoT/docs/MDM/5. PROYECTO/Metodología del diseño mecatrónico- Grupo/INFORME_INTEGRAL/Patas_Robot v12.pdf

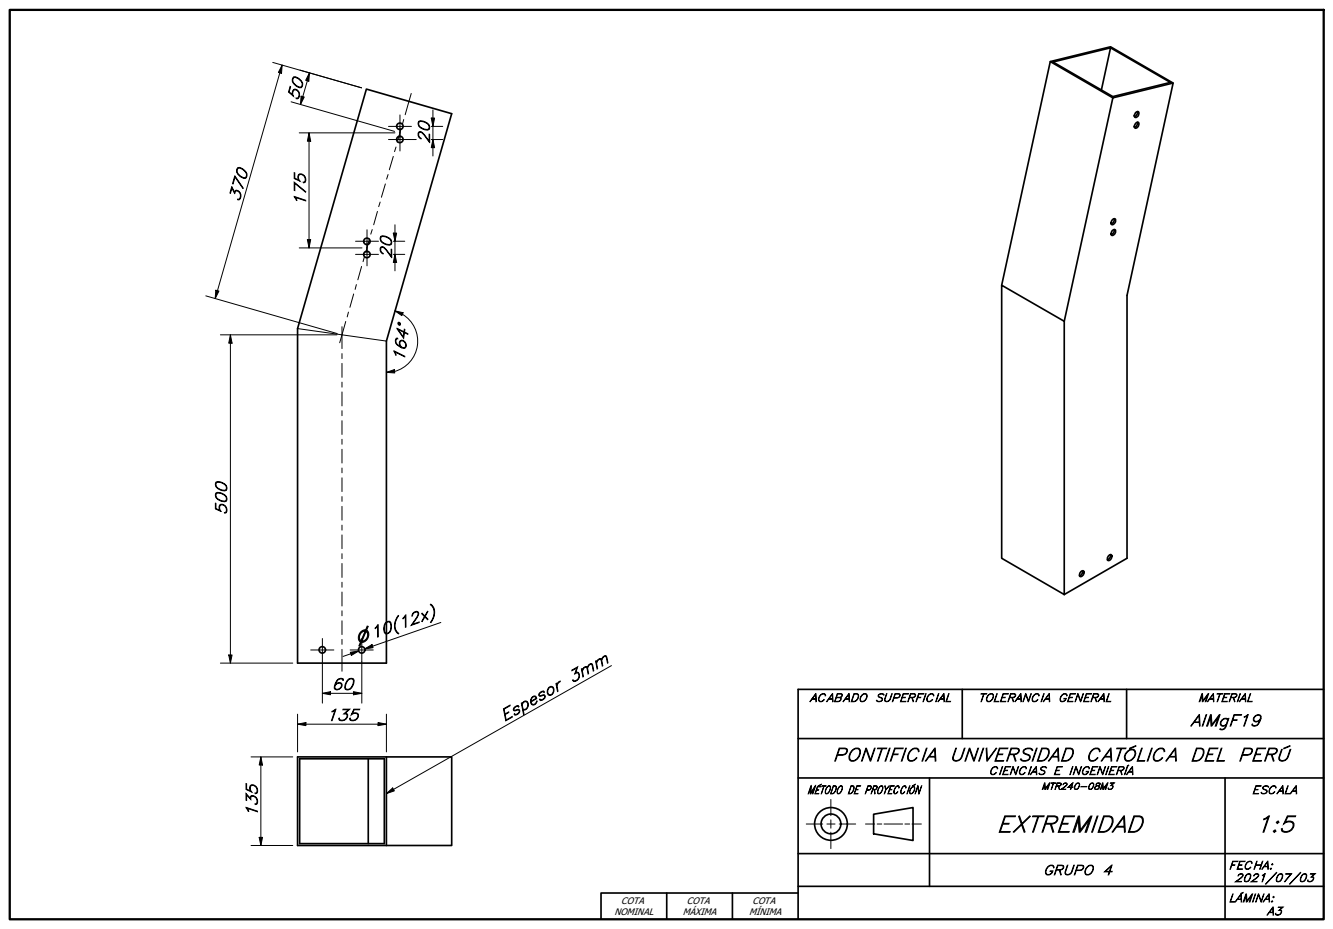
[picture p334: page 1]
ACABADO SUPERFICIAL; TOLERANCIA GENERAL; MATERIAL; GRUPO 4; CIENCIAS E INGENIERzA; Espesor 3mm

PONTIFICIA UNIVERSIDAD CATLICA DEL PER
