Sebastian-Jaimes/EMC_IoT/docs/MDM/5. PROYECTO/Metodología del diseño mecatrónico- Grupo/INFORME_INTEGRAL/Schematic.pdf

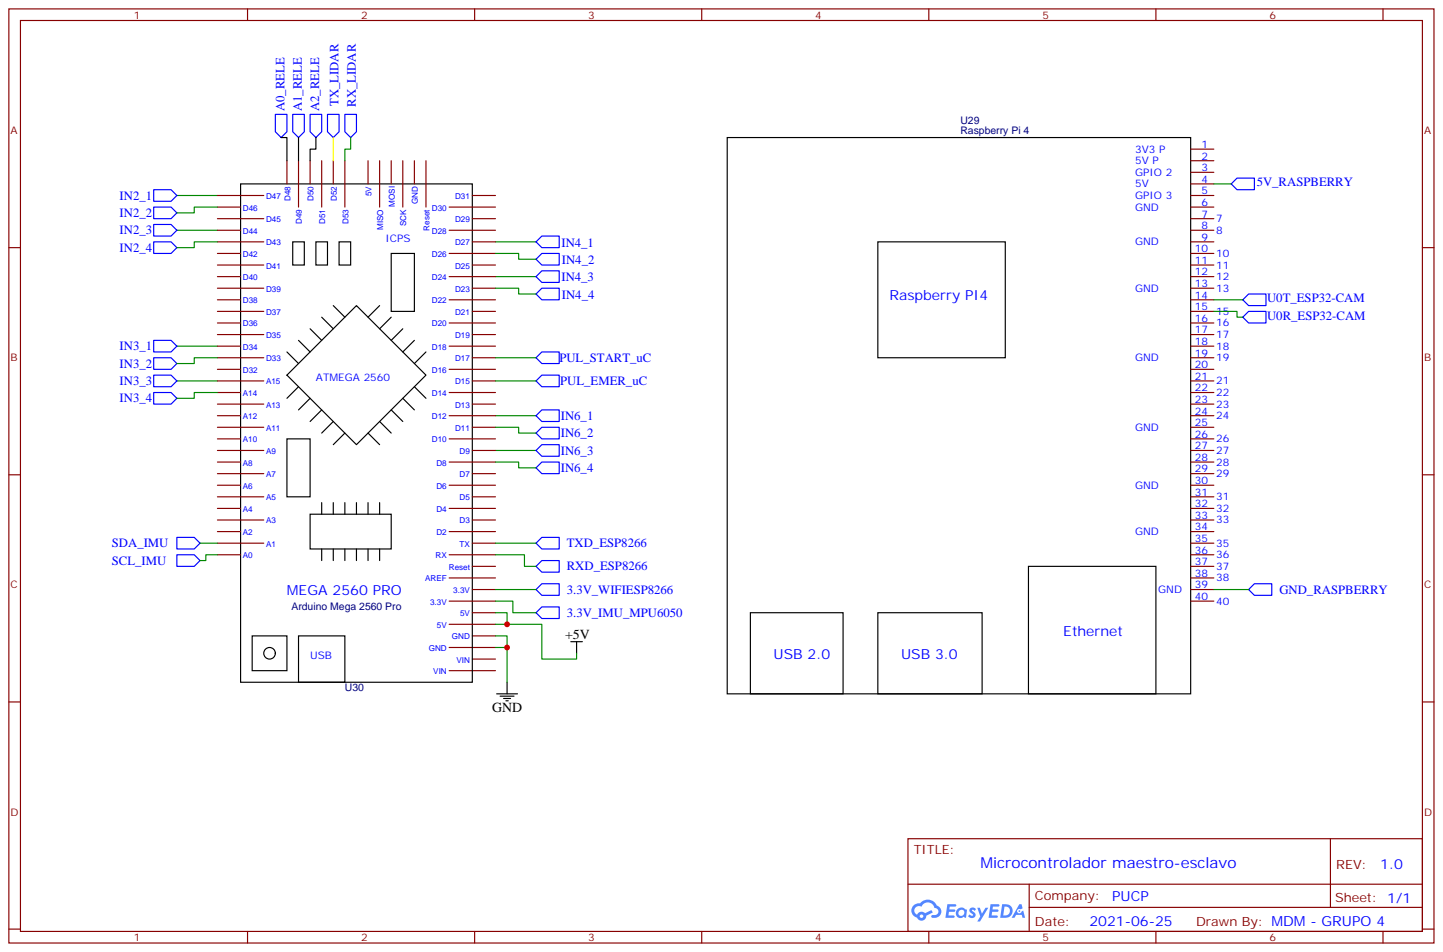
[picture p335: page 1]

Drawn By: MDM - GRUPO 4

## ESP32-CAM

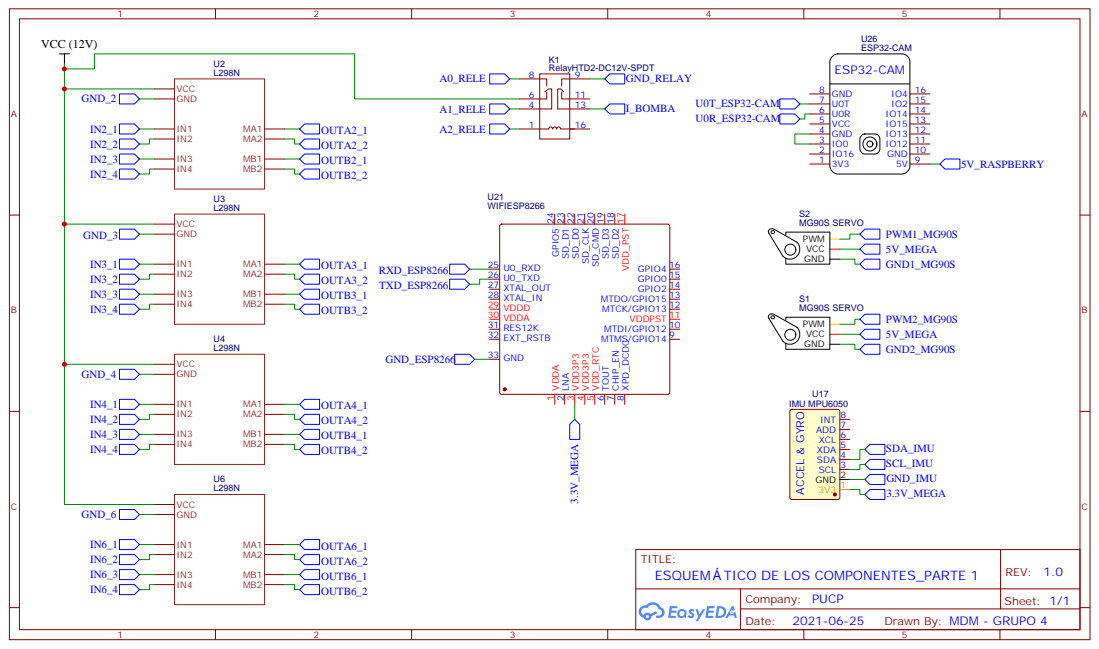
[picture p336: page 2]

MTDI/GPIO12 10 VDDPST 11 MTCK/GPIO13 12 MTDO/GPIO15 13 GPIO2 14 GPIO0 15 GPIO4 VDD_PST

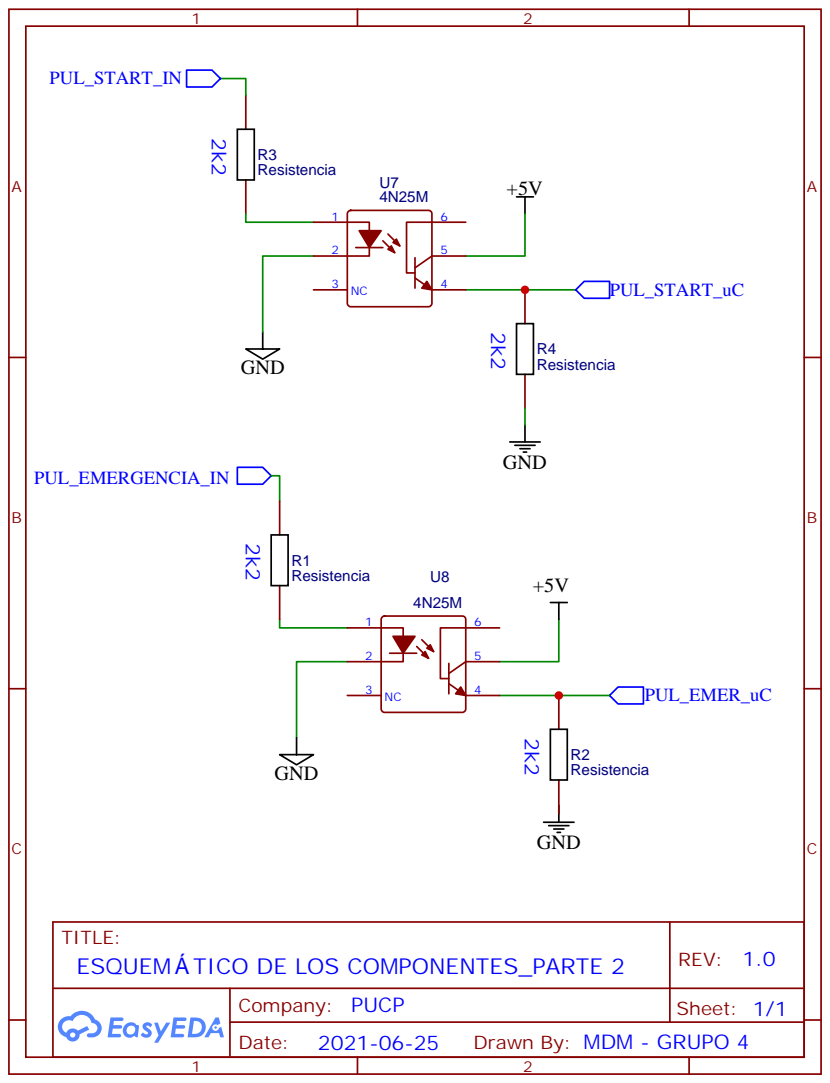
[picture p337: page 3]
