Sebastian-Jaimes/EMC_IoT/docs/MDM/5. PROYECTO/Metodología del diseño mecatrónico- Grupo/INFORME_INTEGRAL/Sistema de amortiguamiento v10.pdf

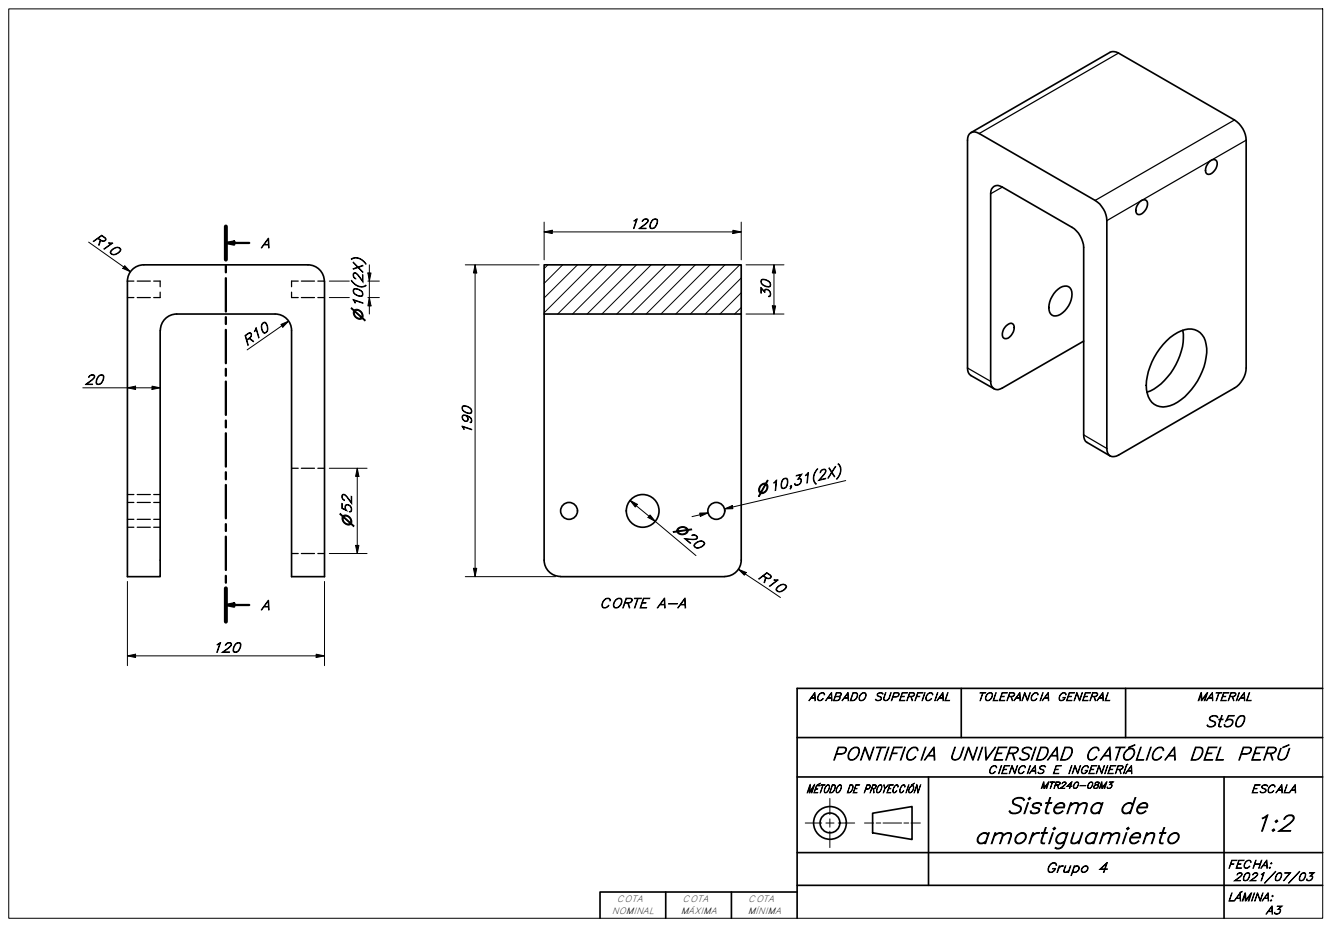
[picture p338: page 1]
CORTE A-A; ACABADO SUPERFICIAL; TOLERANCIA GENERAL; MATERIAL; MÉTODO DE PROYECCIÓN; ESCALA; Grupo 4; Sistema de; CIENCIAS E INGENIERÍA

PONTIFICIA UNIVERSIDAD CATÓLICA DEL PERÚ
