Sebastian-Jaimes/EMC_IoT/electronics/Esquemático.pdf

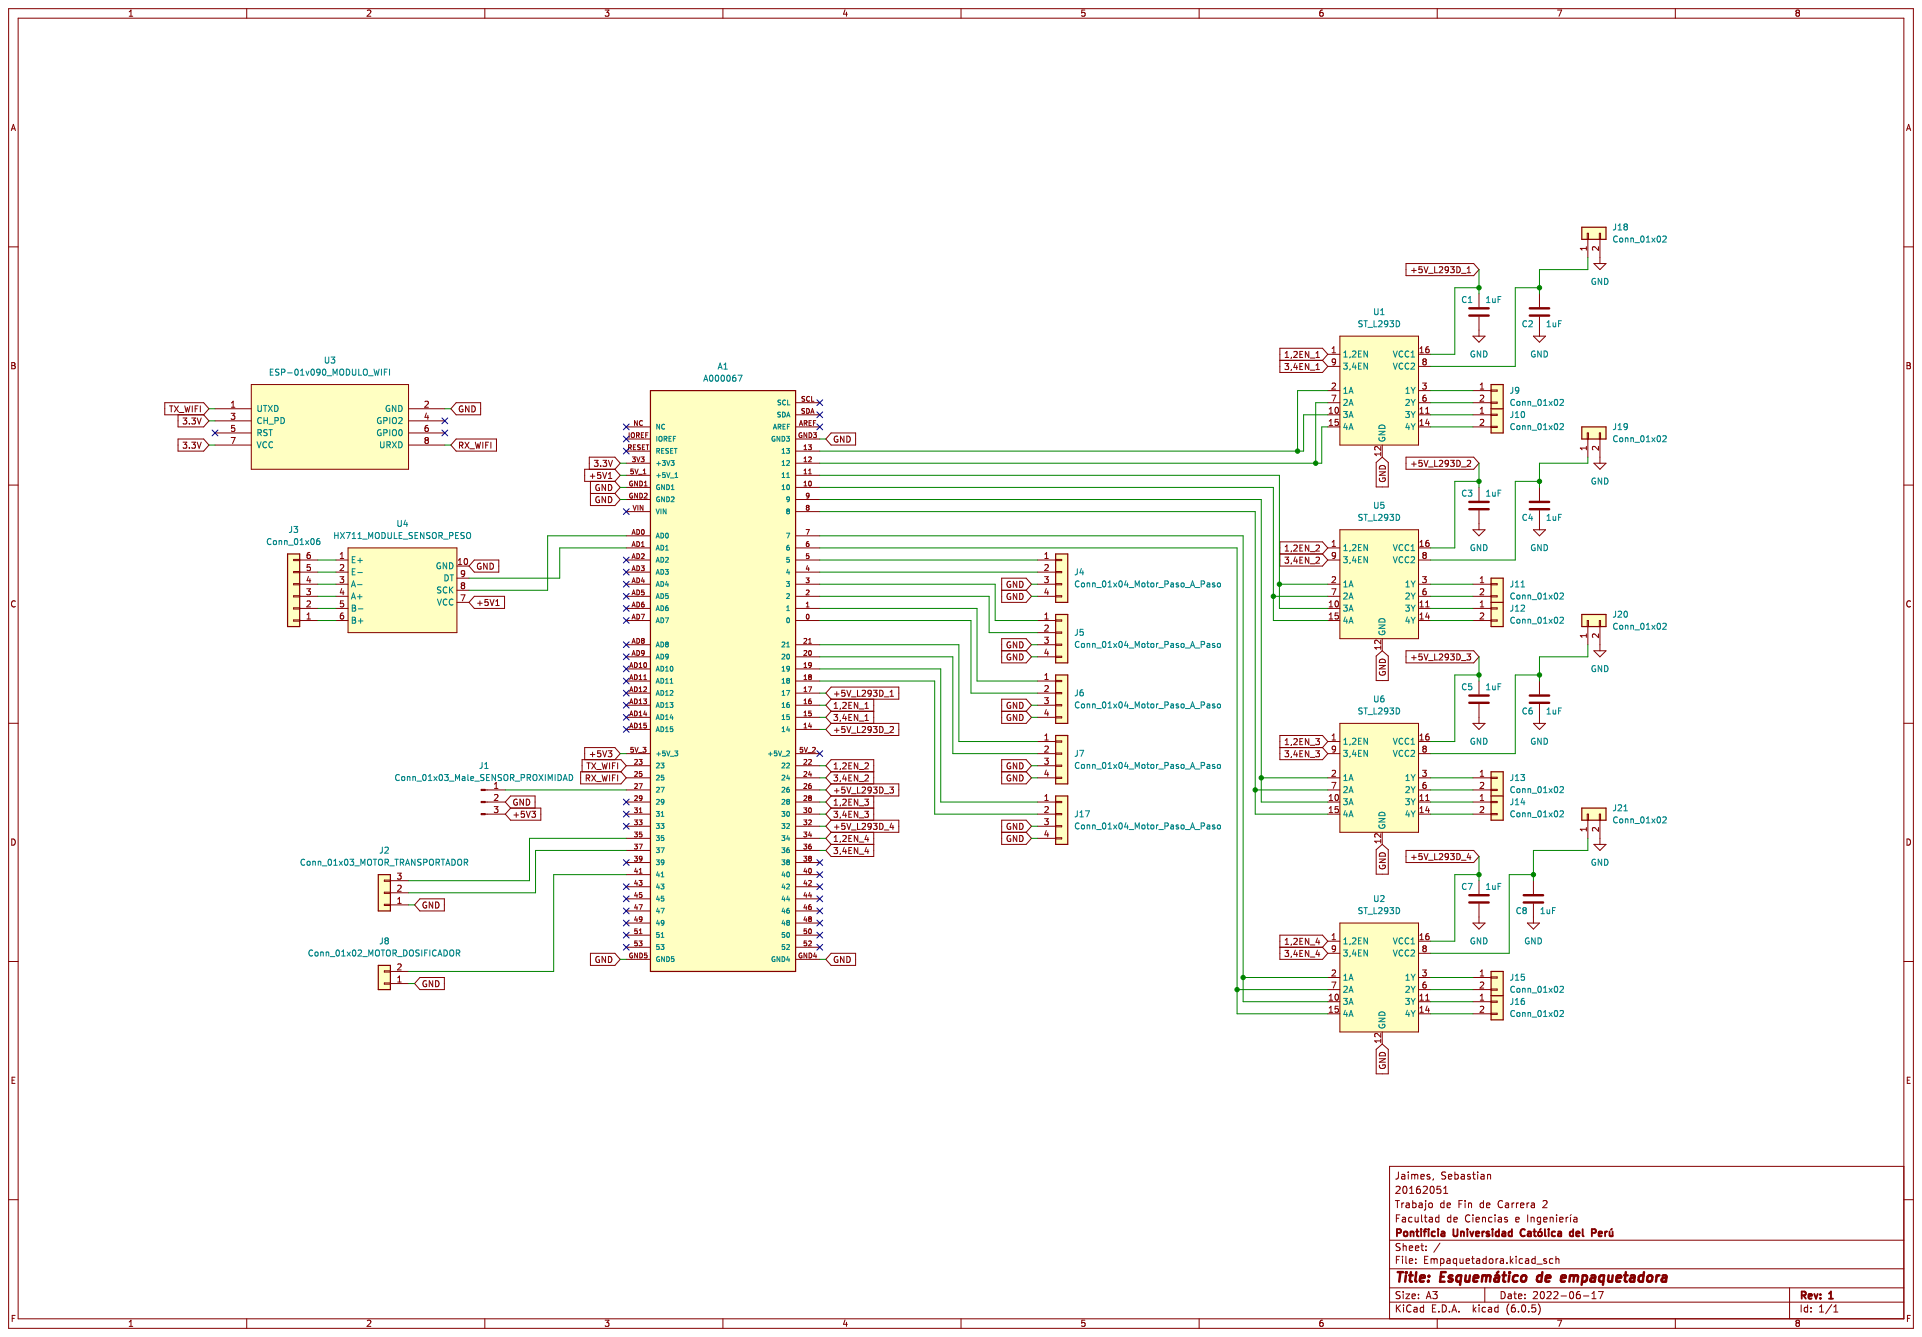
[picture p339: page 1]
