Sebastian-Jaimes/EMC_IoT/electronics/PCB.pdf

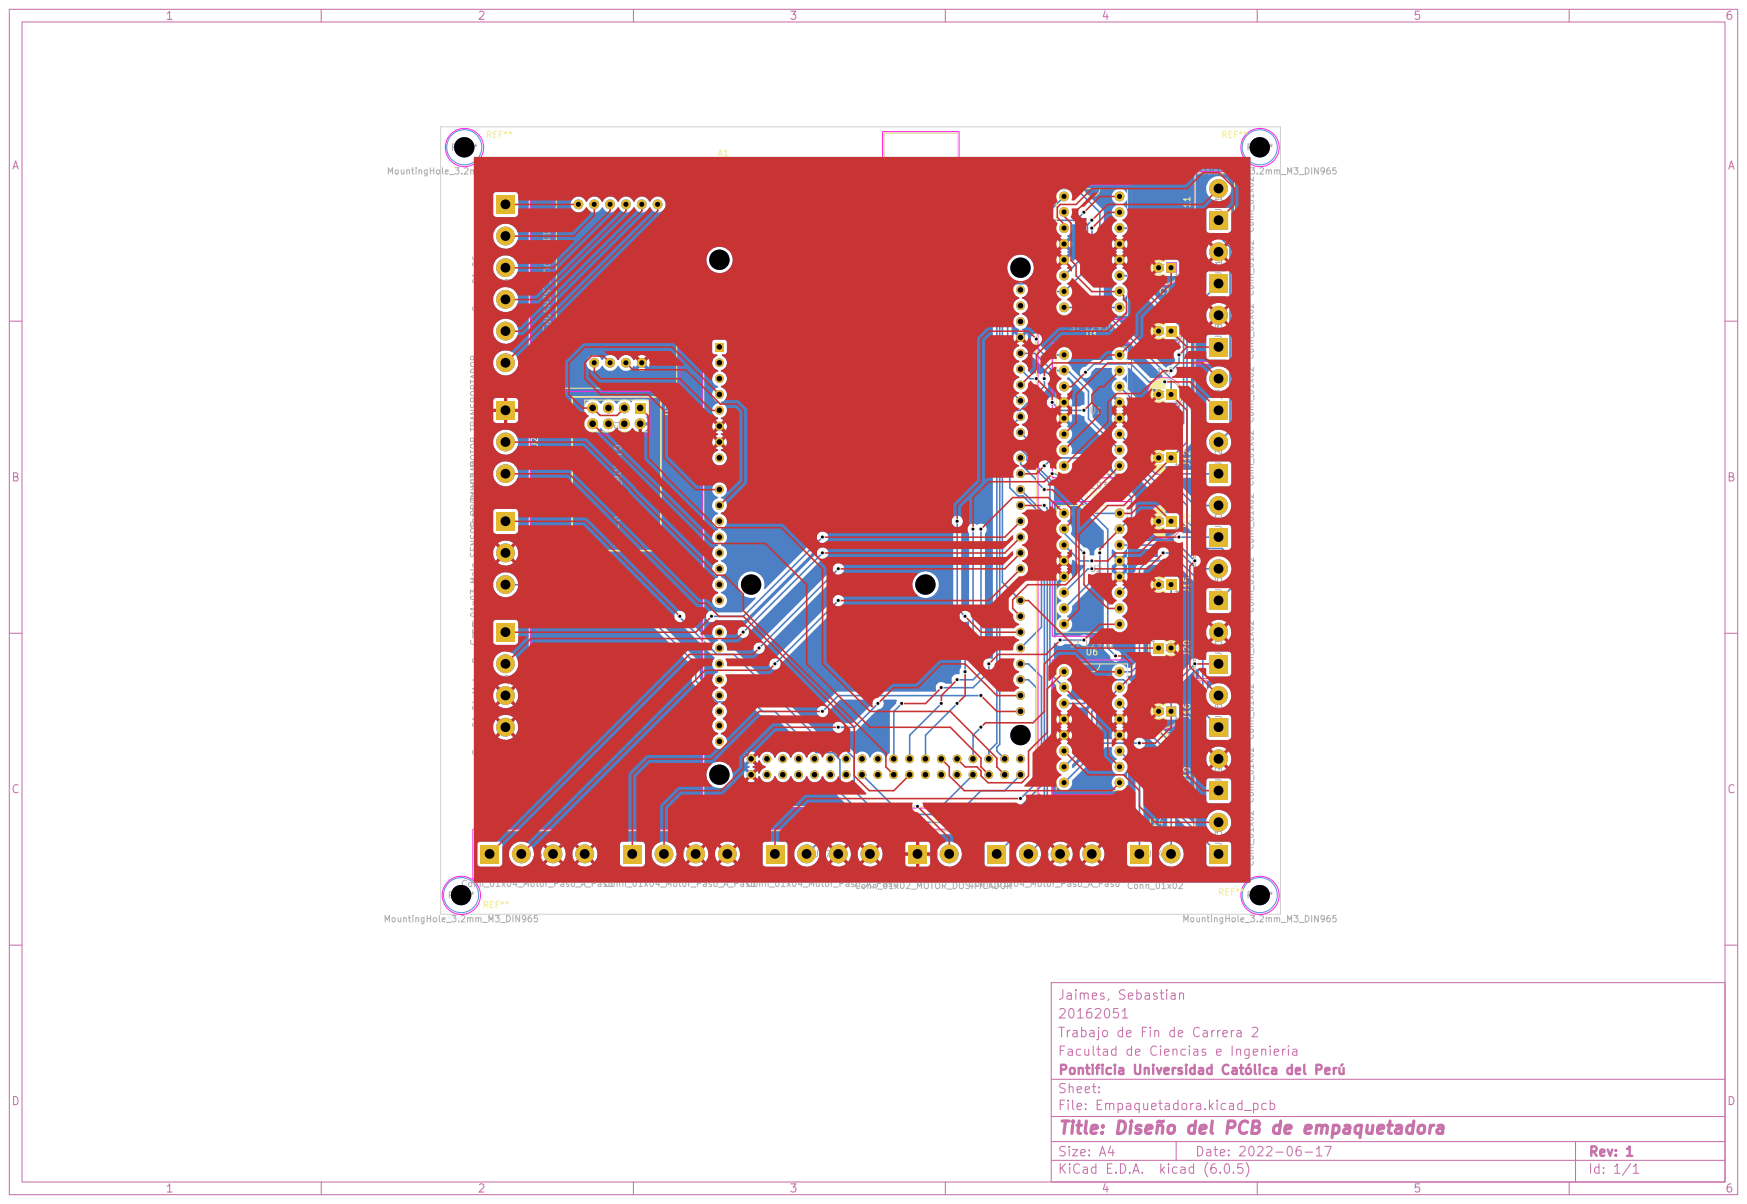
[picture p340: page 1]
