Sebastian-Jaimes/EMC_IoT/docs/Documentos compartidos por el asesor/Maquina de aceite de palta - Jorge Durand/ENSAMBLE EXTRACTORA DE PALTA-PUCP-A0.pdf

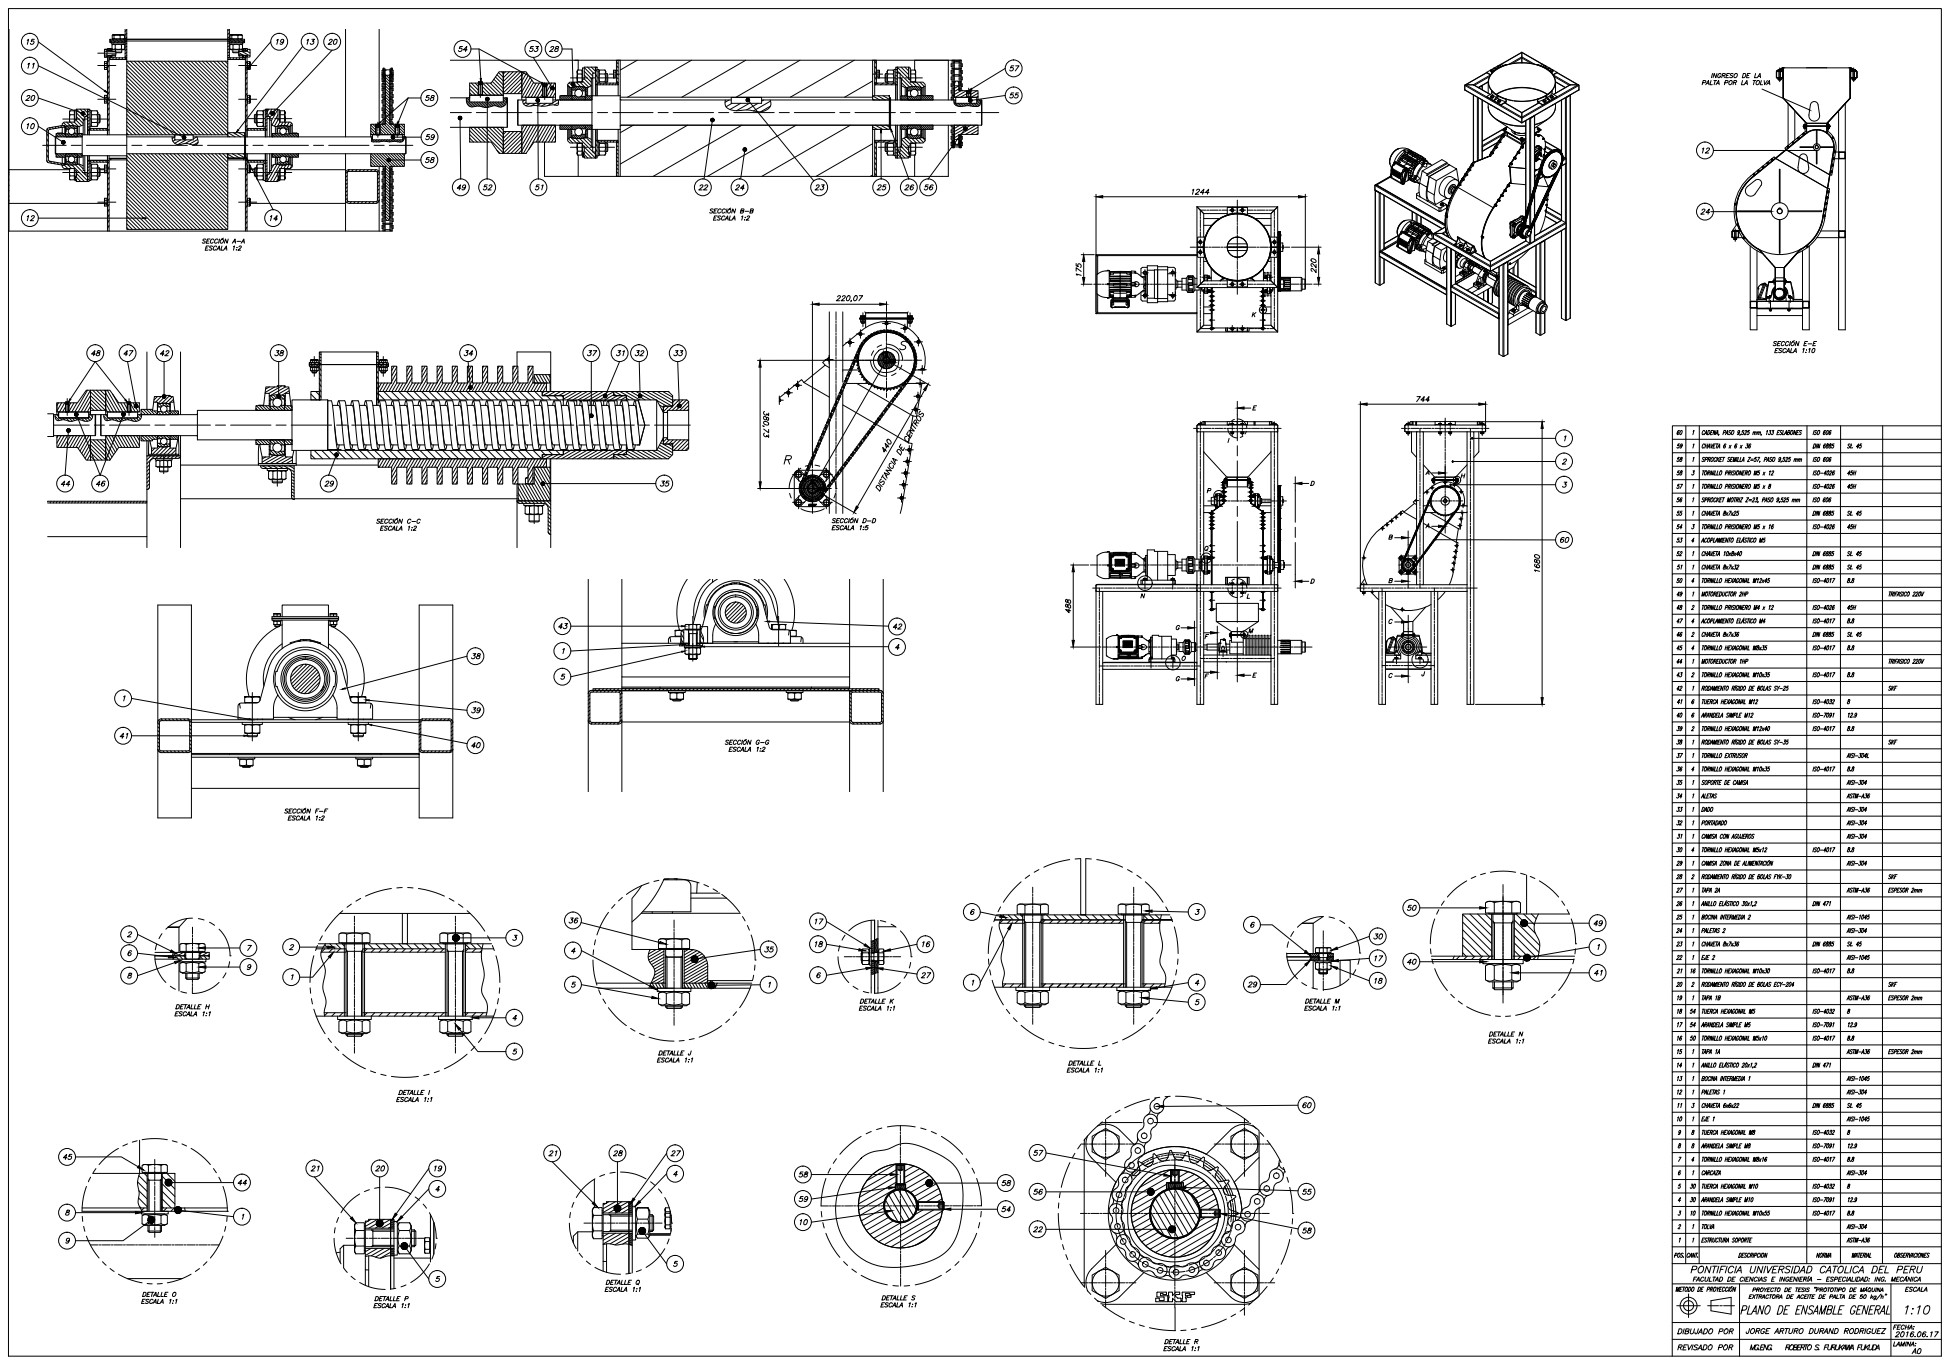
[picture p341: page 1]
