Sebastian-Jaimes/EMC_IoT/hardware/drawings/Dosificadora/Tapa de Vaso volumétrico.pdf

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

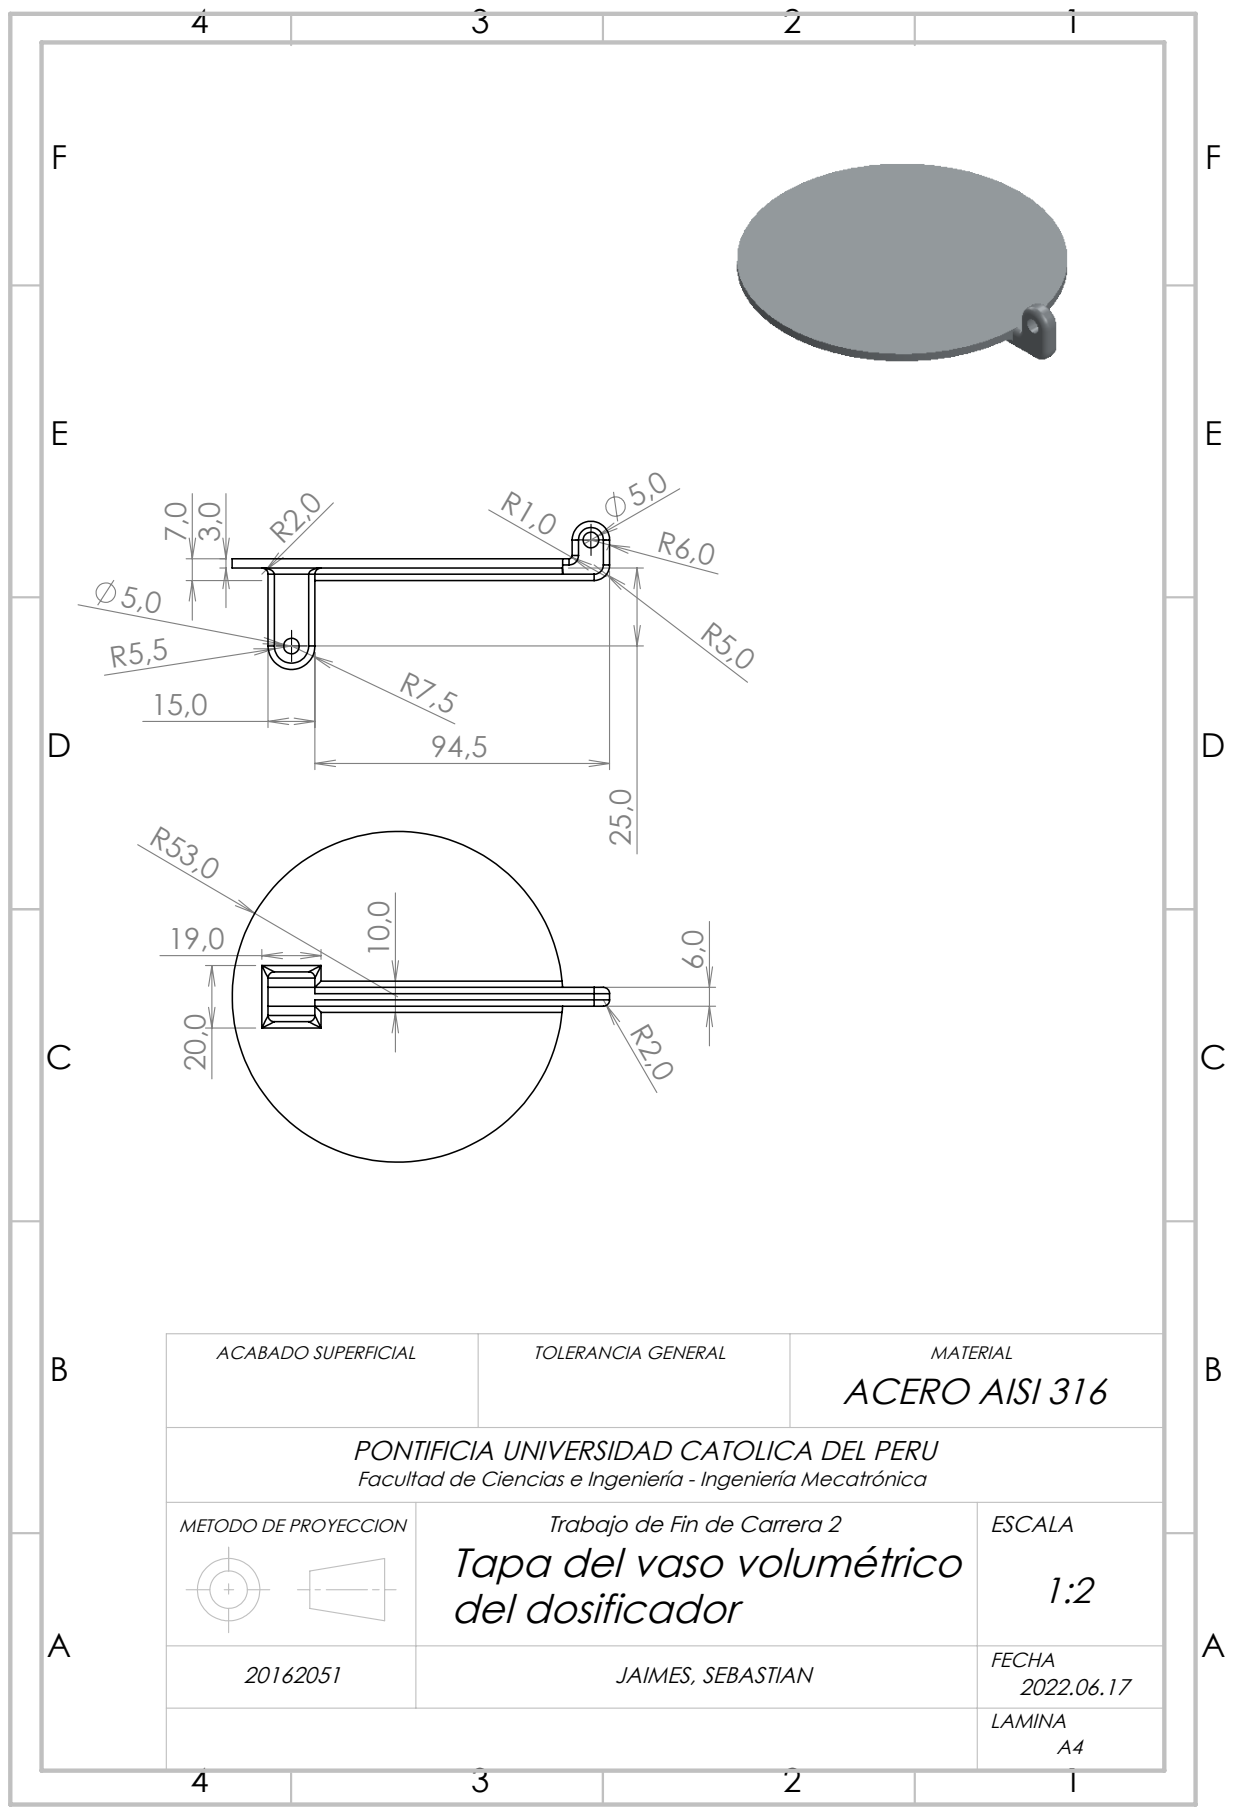
[picture p342: page 1]
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
