Sebastian-Jaimes/EMC_IoT/docs/MDM/5. PROYECTO/Metodología del diseño mecatrónico- Grupo/INFORME_INTEGRAL/PLANO_ELECTRONICO.pdf

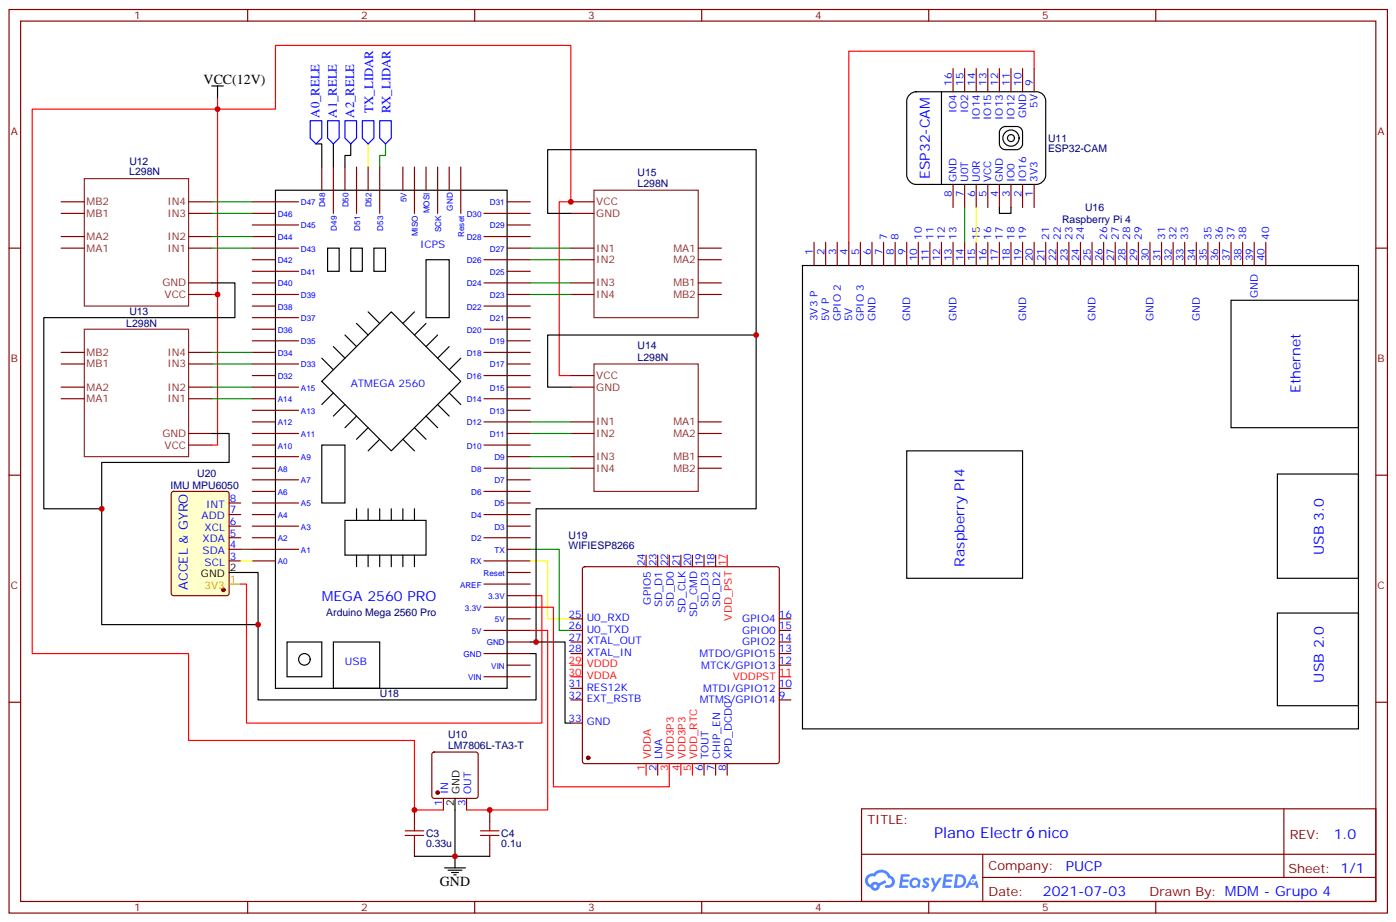
[picture p343: page 1]
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

Drawn By: MDM - Grupo 4
