Sebastian-Jaimes/EMC_IoT/(commit log)

2024-09-08 Se actualizó el Readme.md
2024-09-10 Se agregaron los documentos que se tenian
    [Base Inferior de la caja.IGS, Base Inferior de la caja.SLDDRW, Base Inferior de la caja.SLDPRT, Base Inferior de la caja_Predeterminado_sldprt.STEP, Base de la pata.SLDPRT, Base de la pata_Predeterminado_sldprt.STEP, Base del dosificador.IGS, Base del dosificador.SLDDRW]
2025-09-29 Se agregaron modelos 3D desarrollados y documentación faltante.
    [Bagformer.SLDASM, Bagformer.STEP, Base.SLDPRT, BaseFormadorBolsas.SLDPRT, BaseGuiaDosificador.SLDPRT, BaseMetalicaDosificador.SLDPRT, BaseVasoDosificador.SLDPRT, CabinaDosificadora.SLDPRT]
